firepick-delta/fpd-electronics/PCB Checklist.odt

Schematics/Electronic Selection:

- All Unused Inputs Terminated
- Race Conditions Checked
- Darlington Outputs (1.2V Low) Drive Logic Inputs
- Mating Connectors Are on Different Assemblies
- All Externally-Connected I/O Lines Filtered for RFI, Protected Against Static Discharge
- A Bypass Capacitor is Connected to Each IC
- Ratings Are All Verified
  - Voltage (Capacitors)
    - Tantalum/Electrolytic Derated if Necessary
    - Capacitors Have More than 20% Overhead
  - Power (Resistors)
    - Derated For Elevated Temperatures
  - Current
- Each IC Has a Predictable or Controlled Power-Up State
- Information on Each Sheet
  - Engineer
  - Checked By
  - Page Number
  - Schematic Number
  - Project
  - Employer
- Filters For Every Transistor Gate/Base. Even in Processors
- Are There Filters on Analog/Digital Converter Pins
- Pull-Ups, Pull-Downs on ALL Relevant Pins (Diodes, Driving Processor Inputs, Transistor Gates, etc.)
- Impedance on Every Pin Feeding Directly into a Processor From Off-Board (A Transistor, Any Object to Keep Noise From Frying an IC)
- Too Much Capacitance on Any PWR Rail?
- All Op-Amps Must Be Negative Feedback, All Comparators Positive-Feedback (Make Allowances for Exceptions)
- Op-Amp/Comparator Polarity Verification
- Capacitors or Zeners Directly on Output of Op-Amps Should Have Impedance Separating
- Are Unused Op-Amps or Comparators Tied Down Properly?
- All Octocouplers and Caps Have Parallel Diodes, For Noise Immunity
- All User-Accessible Power Rails Are Short Circuit-Protected
- Dot Each Junction
  - No Surplus Dots Where Connections Should Not Be
- Bus Common Signals
- Inputs on the Left, Outputs on the Right
- Minimum Character Numbers in All Values
- Consistent Character Size
- Printed at Readable Scale
- Reference Designators & Values Assigned to Each Componen
- PCB Parts List Information For Each Component, if Required
- Polarized Components Checked on Schematic
- Electrolyitic and Tantalum Capacitors Checked for No Reverse Voltage
- Power and GND Pins Listed for Each Component (Especially w/ Hidden PWR Pins)
- Check for Hidden PWR/GND Connections
- GND Connections Made First and Broken Last for Hot Pluggability
- Pull-Ups for All Open Collector Outputs
- Sufficient Power Rails For Analog Circuits
- “Crossover Distortion” Prevented
- Amplifiers Checked for Stability
- Oscillators Checked for Reliable Startup
- Noise Radiation Minimized
- Check Input Voltage Applied w/ Power Off
- Reset Circuit Design Reliable, Both Glitch-Free and Consistent
- Separate Analog Signals From Noisy or Digital Signals
- Check IC Datasheets for Undesired Behavior Conditions
- Determine Effects of Losing Each GND from a Connector
- Check Max. PWR Dissipation/Operating Temperatures
- Check Voltage Transients and High Voltages on FET Gates
- Check Failure Modes & Effects of Failed Semiconductors
- Estimate Worst-Case Power Supply Current
- Check Pin Numbers on ALL Parts
- ROHS Compliance Review
- Part Obsolence/End-of-Life Review
- All No-Connect Pins Labeled N/C
- Text Does Not Overlap Anything on Schematics
- Card Edge Connectors Identify Mating Part
- Off-Board Connectors Identify All Signals, Even if Not Used
- Unpopulated Parts Annotated and Enclosed by Dashed-Line Box on Schematics
- Wires Are Connected in Verified Pins
- Clock Lines w/ Series Termination and Parallel Termination Component Locations Present Even if Not Populated. 0-Ohm Resistors for Series, Unpopulated Parts for Parallel Termination
- Diagnostic Resources by Design, Even if Unpopulated by Default
- Pin Names And Attributes on Symbols w/ Multifunction Pins Match Actual Design Usage
- Connect DIP Switches and Other Grouped I/O to Ports in a Logical Way
- Verify Proper Referenced Designations
- Avoid Direct Connections of Mode Pins or No-Connects To GND or VCC to Maximize Rework Options
- Get Applications Engineers From Manufacturer to Review Schematics Involving Their Parts, if Possible
- All PWR Nets Labeled Consistently
- Create Table of Contents, Block Diagram
- Show Active-Low Pin Symbols

Layout Checklist;

- Placement:
  - Component Orientation Consistent
  - Clearance for Extraction Tools
  - Polarized Components Arranged Correctly
  - Thru-Hole Components on a 50 mil Grid (Suggested)
  - Verify All Connector Orientations
  - Minimum Component Body Spacing (Keepouts)
    - At least 15 mils between parts (Check PCBFab)
  - Bypass Caps Located Close to IC Pins
  - All Series Terminators (RS-485, etc) Located Near Source
  - I/O Drivers Located Near Where Their Signals Leave the Board
  - Include Testpoints:
    - GND Turrets
    - PWR Rail Testpoints
    - All Important Signals
    - LABEL ALL
  - EMI and RFI Filtering as Close as Possible to Exit/Entry Points in Shielded Areas
  - Layout Such That Any Rework Doesn't Require Removal of Additional Components
  - Potentiometers/Variable Components Should Increase Controlled Quantity Clockwise
  - Mounting Holes
    - Electrically Isolated or Not?
    - Proper Clearance for Hardware
  - Check Pad Shapes/Sizes
  - Check Hole Shapes/Sizes
  - Tooling Holes for Automated Assembly (Suggested)
  - Sufficient Clearance for Socketed ICs, Switches
- Routing:
  - Digital and Analog Signal Commons Joined at One Point
  - Check for Traces Running under Noisy or Sensitive Components
  - No Vias Under Poorly-Insulated Parts (Metal-Film Resistors, etc.)
  - Check for Traces Susceptible to Solder Bridging
  - Check for Dead-End Traces (Verify if Intentional)
  - Ensure Schematic Software Did Not Separate Vcc/Vdd, Vss/GND, other necessary PWR nets
  - Provide Multiple Vias for High-Current and/or Low-Impedance Traces
  - Component and Trace Keepout Areas Enforced
  - GND Planes Wherever Necessary and Possible
- Dimensions:
  - Hole Diameters on DWG Are Finished Sizes, After Plating
  - Finished Hole Diameters are Larger than Lead (>=10 mils)
  - Silkscreen Legend Text Weight (>=10 mils)
  - Pads Larger Than Finished Holes (>=15 mils)
  - Board Edge Keepout
    - Components: (>=0.2”)
    - Test Pads/Points: (>=0.2”)
    - Traces: (>=20 mils)
  - Thru-Hole Tolerance:
    - Drill Tolerance Noted
    - Soldermask Tolerance Noted
    - Route Tolerance Noted
    - Clearance Tolerance Noted
    - Silkscreen Tolerance Noted
  - Trace Width:
    - Sufficient For High Current
    - Sufficient For High Voltage
- Silkscreen:
  - No Silkscreen Over Vias (Unless Soldermasked)
  - All Legend Text Reads in One or Two Directions
  - Company Logo on Legend/In Foil
  - Copyright Notice on PCB
  - Date Code on PCB
  - PCB Part Number on PCB
  - PCB Revision Number on PCB
  - Assembly Revision Blank on Silkscreen
  - All Text Visible and Readable When PCB is Populated
  - All ICs have Pin One Clearly Marked, Visible w/ Chip Installed
  - High Pin-Count ICs and Connectors Have Corner Pins Numbered
  - Silkscreen Tick Marks for Every 5th or 10th Pin on High Pin-Count ICs and Connector

Miscellaneous:

  - CAD Design Rules Checklist Must Be Turned On
  - High Frequency Circuitry Precautions Observed
  - Extra Connectors and IC Pins Accessible on Prototype Boards, for Rework
  - Check Hole Diameters for Non-Standard Components (Rectangular Pins, Spring Pins, etc)
  - Soldermask Does or Doesn't Cover Vias
  - No Acute Inside Angles in Traces or Copper Pour
  - Soldermask Swell Checked
  - Manual Netlist Check
    - Check For 1-Pin Connections
  - Drill Origin Is a Tooling Hole
  - PCB Thickness, Cu Weight Noted
  - Thermal Reliefs For Internal Power Layers
  - Pastemask Openings are Properly Sized
  - Blind and Buried Vias Allowed on Multilayer PCB (Check PCBFab)
  - PCB Layout Panlized Correctly
  - High-Frequency Crystal Cases are Flush to PCB and GNDed

PCB Assembly Guidelines:

- Miscellaneous Parts on Bill of Materials and Assembly Notes for Same: Hardware, Heatsinks, Heatsink Compounds, IC Sockets, Consumables (Epoxy, Threadloc, Heatshrink, etc.)
- Assembly Notes For All Special Operations
- Conformal Coating
- Explicit Static Handling Precautions Required For Assembly and Test

Maintainability:

- Easy Disassembly and Reassembly
- Fuses Accessible and Labeled
- Self-Test Mode
- Spare Parts Available
- Status LEDs on PCB
- Event Logging of Exceptional Conditions
- Vibration Tolerance of Entire Assembly and Individual Modules
- Surge Current Magnitude Through Semiconductors Within Rating
- Thermal Cycling Excursions Internal to Components and Assemblies Within Acceptable Limits
- Capacitors Mounted Below or Away From Heat-Dissipating Devices Such as Transformers
- Resistance and Tolerance of Entire Product to Static Discharge Via Any Path

Electrical Safety:

- Fuse and Circuit Breaker Size and Characteristics
- Fuse Sizes Marked Near Fuse Holder
- Room to Remove Fuse Without Damaging Other Components
- Spare Fuse Storage
- Shock Hazards
- Radiated Energy Warnings and Shields
- Applicable Standards Checked
- Protection Against Liquids and Foreign Objects

Wired Assemblies:

- Wire Gauge Compatibility Check
- Cable Ties Shown Where Necessary
- Length & Color of Each Wire Indicated
- Notes of Application of Wire Terminations

Testability:

- Testpoints on PCBs For Critical Circuits, Hard to Reach Nets
- Testpads for In-Circuit or Bed-of-Nails Functional Testing
- Testpads on a Regular Grid (0.100” / 2.54mm spaced)
- Consistent Sizing:
  - Min. = (0.025” /0.635mm) ,Typ. = (0.035”/0.89mm – 0.045”/1.14mm)
  - Top Pads: Min. = (0.035”/0.89mm)
- Ensure none of the nearby components are not so tall that they interfere with probe access
- Test Procedure Written For Each Test Phase
- Special Test Arrangements and Connectors For Testing

Bill of Materials/Parts Lists:

- Each Component Has Quantity, Reference Designator, and Description
- List Qualified Part Numbers for Specialized Devices
- Suggestions for Alternate Mfrs/Part No.s Listed
- Price, Availability, and Lead Time Checked For Each Part

Mechanical Drawings:

- Standard Title Block and Border
- No Dimensions on the Material
- Every Feature Must Have X and Y Dimension (including radius, diameter, etc.)
- Every Hole Must Be Checked For Alignment w/ Mating Holes in Other Parts
- Check All Hole Diameters
- Tolerance for Sheet Metal Feature Position
- Tolerance for Sheet Metal Holes
- Material Specified
- Finish Specified
- Units Specified
- Debur/Brush Specified
- Special Operation Notes Included
- File Names, Pg. No. On Each Sheet
- CAD Layers Shown
- All Hardware Specified and Listed
- Screw Lengths Checked; Extra Thread Required
- Hole Diameters Checked for Screws & Threads
- Tapped Hole Thread Details

Software:

- Each Version Archived (Version Control)
- Loops Checked for Terminating Conditions
- Communications Timeouts Checked
- All Branches Tested
- Revision History Noted For All Changes
- CPU Utilization Measured
- Interrupt Response Time Measured
- Interrupt Execution Time Measured
- Naming Conventions Consistent and Relevant to Humans
- Adherence to Coding Style Standards
- Power-Up, Power-Down Considerations
- Unused Vectors Trapped to Restart or Damage Control Routine
- Unused ROM Space Loaded w/ Trap or Restart Instructions
- Warm and Cold Reset Differences
- Non-Volatile Memory Corruption Possibilities Checked During Power-Up, Power-Down, and Gone-Wild Conditions
- Design Notes Within or Separated from Code
- Check FIFO and Buffer Overruns
- Check Critical Timer Driver Code
- Check For Odd Address Usage on 16/32-Bit Micros, Especially an Odd Stack Pointer
- Use a LINT Utility on C Programs to Find Subtle Problems
- Program's Data Structures Contain Version Numbers

Documentation:

- End-User Instructions: Unpacking, Use, Warranty, Service, Troubleshooting Guidelines
- Service Manual: Troubleshooting Procedures, Parts Lists, Contact Info.
- Design Notes: ECNs, Reasons for Changes
- Any Information That May Be Lost if Designers Depart the Organization
