firepick-delta/fpd-electronics/EAGLE/EBR01 - TMC2130 breakout board/EBR01 Schematic.png

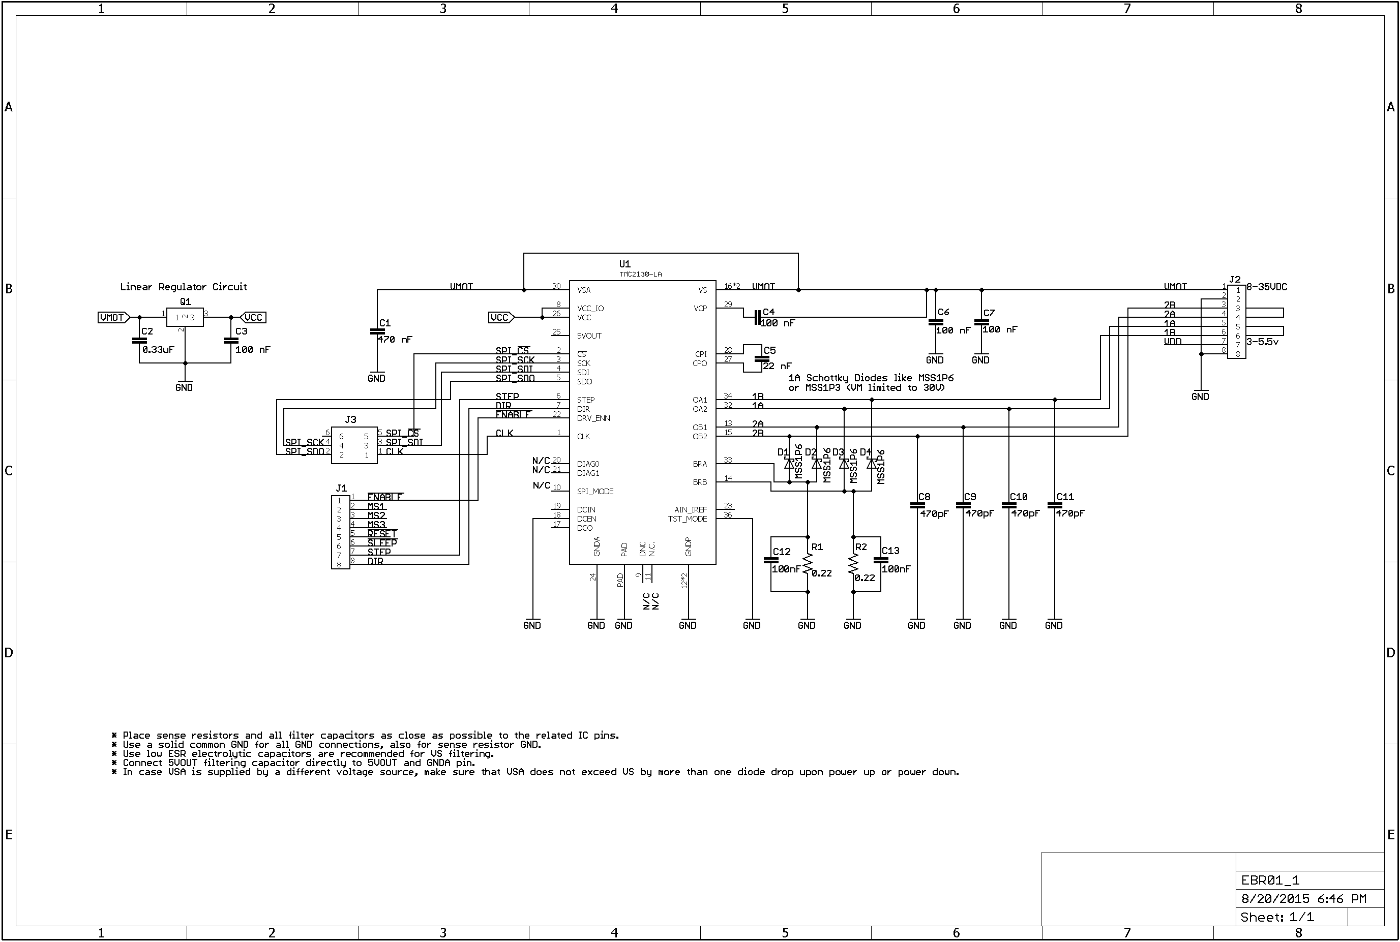
EAGLE/EBR01 - TMC2130 breakout board/EBR01 Schematic.png
