firepick-delta/fpd-electronics/EAGLE/EMC03 - Motion Control/Voltage.PNG

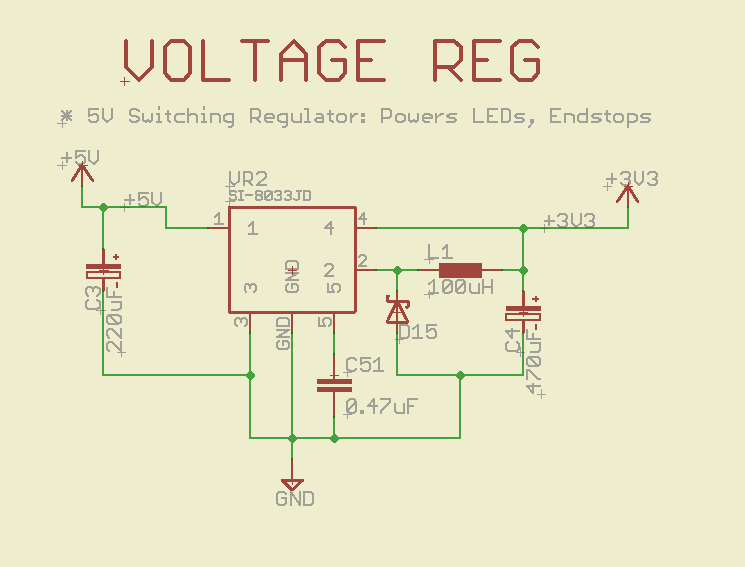
EAGLE/EMC03 - Motion Control/Voltage.PNG
