firepick-delta/fpd-electronics/EAGLE/Inventory(Electronics).xls

 |  |  | FT(CBL) | FPD QTY: | 2
Part Number | Description | STOCK: | QTY: 1 | REQUIRED: | To Order: | Vend Link: | Datasheet: | Alternates: | Notes:
ATMEGA328-AU | MCU: 32KB, 8-Bit, 32-TQFP; | 10 | 3 | 6 | 0 | Taobao (http://world.taobao.com/search/search.htm?_ksTS=1444721931015_21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) | Atmel (http://www.atmel.com/images/Atmel-8271-8-bit-AVR-Microcontroller-ATmega48A-48PA-88A-88PA-168A-168PA-328-328P_datasheet_Complete.pdf)
MSS1P6 | Diode: Schottky, 60V, 1A, MicroSMP | 76 | 12 | 24 | 0 | Taobao (http://world.taobao.com/search/search.htm?_ksTS=1444722941332_22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) | Vishay (http://www.vishay.com/docs/89018/mss1p6.pdf) |  |  | KEY:
B340A-13-F | Diode: Schottky, 40V, 3A, SMA | 0 | 2 | 4 | 4 | Taobao (http://world.taobao.com/search/search.htm?_ksTS=1444808002750_36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) | Diodes, Inc. (http://www.diodes.com/_files/datasheets/ds30891.pdf) |  |  |  | : None Req'd
1N4148WS-7-F | Diode: General Purpose, 75V, 150mA, 1.2Vr | 0 | 5 | 10 | 10 | Taobao (http://world.taobao.com/search/search.htm?_ksTS=1445316552240_21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) | Vishay (http://www.vishay.com/docs/85886/1n4148wsfl-g.pdf) |  |  |  | : <5 Req'd
KA78L05AMTF | V Reg: LDO, 5V, 0.1A, SOT89-3 | 14 | 0 | 0 | 0 | Taobao (http://world.taobao.com/search/search.htm?_ksTS=1444725181346_313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) | Fairchild (https://www.fairchildsemi.com/datasheets/KA/KA78L05A.pdf) |  |  |  | : >5 Req'd
LMS8117AMP-3.3/NOPB | V Reg: LDO, 3.3V, 1A, | 0 | 2 | 4 | 4 | Taobao (http://world.taobao.com/search/search.htm?_ksTS=1444804422496_36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) | TI (http://www.ti.com/lit/ds/symlink/lms8117a.pdf) |  |  |  | : Rev1 Changes
TC1015-3.3VCT713 | V Reg: LDO, 3.3V, 0.1A | 0 | 3 | 6 | 6 | Taobao (http://world.taobao.com/search/search.htm?_ksTS=1444804833839_36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) | Microchip (http://ww1.microchip.com/downloads/en/DeviceDoc/21335e.pdf) |  |  |  | : Rev2 Changes
DRV8825 | Motor Driver: 1/32 Step, 2.5A, 8.2-45V | 5 | 2 | 4 | 0 | Taobao (http://world.taobao.com/search/search.htm?_ksTS=1444725982952_313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) | TI (http://www.ti.com/lit/ds/symlink/drv8825.pdf)
TMC2130-LA-T | Motor Driver: 1/256 Step, 1.4A, 5.5-46V, SPI | 4 | 3 | 6 | 2 | Digi-Key (http://www.digikey.com/product-detail/en/TMC2130-LA-T/1460-1130-1-ND/5155767) | Trinamic (http://www.trinamic.com/_articles/products/integrated-circuits/tmc2130/_datasheet/TMC2130_datasheet.pdf)
1655 | Neopixel: WS2812B, w/DVR, 4SMD | 45 | 8 | 16 | 0 | Taobao (http://world.taobao.com/search/search.htm?_ksTS=1444726663615_36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) | Worldsemi (http://www.adafruit.com/datasheets/WS2812B.pdf)
SN74LVC1T45DBVR | Translator: Voltage, Bi-Directional, 5.5V Max | 30 | 0 | 0 | 0 | Taobao (http://world.taobao.com/search/search.htm?_ksTS=1444727749069_299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) | TI (http://www.mouser.com/ds/2/405/sn74lvc1t45-556134.pdf) |  | WRONG PKG
SN74LVC1T45GW,125 | Translator: Voltage, Bi-Dir., 1.2-5.5V, SOT363 | 0 | 20 | 40 | 40 | Taobao (http://world.tmall.com/item/522088454138.htm?spm=a312a.7700714.0.0.HKdb8H) | NXP (http://www.nxp.com/documents/data_sheet/74LVC_LVCH1T45.pdf)
MAX31855KASA+ | Converter: Thermocouple-Digital SPI, 8-SOIC | 0 | 1 | 2 | 2 | Taobao (http://world.taobao.com/search/search.htm?_ksTS=1444808310013_299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) | Maxim (http://datasheets.maximintegrated.com/en/ds/MAX31855.pdf)
LAN9514-JZX | IC: USB 2.0 + ETH Controller, 64-QFN | 3 | 1 | 2 | 0 | Taobao (http://world.taobao.com/search/search.htm?_ksTS=1444728585839_36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) | Microchip (http://ww1.microchip.com/downloads/en/DeviceDoc/9514.pdf)
SN74LVC1G32DBVR | Logic: OR Gate, 1-Ch., SOT23-5 | 0 | 5 | 10 | 10 | Taobao (http://world.taobao.com/search/search.htm?_ksTS=1444803375616_36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) | TI (http://www.mouser.com/ds/2/405/sn74lvc1g32-487523.pdf)
SN74LVC1G02DBVR | Logic: NOR Gate, 1-Ch, SOT23-5 | 0 | 1 | 2 | 2 | Taobao (http://world.taobao.com/search/search.htm?_ksTS=1444803477852_50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) | TI (http://www.mouser.com/ds/2/405/sn74lvc1g02-555712.pdf)
LPC1768FBD100 | MCU: 512KB, I2C, SPI, UART, USB, 100-LQFP | 0 | 1 | 2 | 2 | Taobao (http://world.taobao.com/search/search.htm?_ksTS=1444803936472_299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) | NXP (http://media.digikey.com/pdf/Data%20Sheets/NXP%20PDFs/Cortex-M3,%20LPC1700%20Series%20Leaflet.pdf)
SP3485EN-L/TR | Transceiver: RS-485, 8-SOIC | 0 | 5 | 10 | 10 | Taobao (http://world.taobao.com/search/search.htm?_ksTS=1444804158934_299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) | Exar (http://www.exar.com/common/content/document.ashx?id=639)
93LC66A-I/SN | EEPROM: 4KB, 2MHz, 8-SOIC | 0 | 1 | 2 | 2 | Taobao (http://world.taobao.com/search/search.htm?_ksTS=1444805278899_50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) | Microchip (http://ww1.microchip.com/downloads/en/DeviceDoc/21795E.pdf)
FT231XS-R | IC: USB Serial, UART, 20-SSOP | 0 | 1 | 2 | 2 | Taobao (http://world.taobao.com/search/search.htm?_ksTS=1444805461204_50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) | FTDI (http://www.ftdichip.com/Support/Documents/DataSheets/ICs/DS_FT231X.pdf)
MIC2026-1YM | IC: PWR Distribution Switch, 2-Ch, 8-SOIC | 0 | 2 | 4 | 4 | Taobao (http://world.taobao.com/search/search.htm?_ksTS=1444805622374_50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) | Micrel (http://www.micrel.com/_PDF/mic2026.pdf)
MCP4725A0T-E/CH | IC: DAC, 12-Bit, I2C | 0 | 2 | 4 | 4 | Taobao (http://world.taobao.com/search/search.htm?_ksTS=1444806080399_50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) | Microchip (http://ww1.microchip.com/downloads/en/DeviceDoc/22039d.pdf)
AP3032KTR-G1 | LED Driver: Regulator/Dimmer, 1MHz, SOT23-6 | 0 | 2 | 4 | 4 | Taobao (http://world.taobao.com/search/search.htm?_ksTS=1444806189110_36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) | Diodes, Inc. (http://www.diodes.com/_files/datasheets/AP3032.pdf)
NTR4003NT3G | MOSFET: N-Ch, 30V, 500mA, SOT23-3 | 0 | 6 | 12 | 12 | Taobao (http://world.taobao.com/search/search.htm?_ksTS=1444806380033_50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) | ON Semi (http://www.onsemi.com/pub_link/Collateral/NTR4003N-D.PDF)
BSS138-7-F | MOSFET: N-Ch, 50V, 220mA, SOT23-3 | 0 | 1 | 2 | 2 | Taobao (http://world.taobao.com/search/search.htm?_ksTS=1444806741942_36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) | Diodes, Inc. (http://www.diodes.com/_files/datasheets/ds30144.pdf) |  | SAME AS NTR4?
ZXMN10A07FTA | MOSFET: N-Ch, 100V, 700mA, SOT23-3 | 0 | 1 | 2 | 2 | Taobao (http://world.taobao.com/search/search.htm?_ksTS=1445244763364_36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) | Diodes, Inc. (http://www.diodes.com/_files/datasheets/ZXMN10A07F.pdf)
MPXV5100DP | Sensor: Pressure, 14.5PSI(Typ.), 5V, 8-SMD | 0 | 1 | 2 | 2 | Taobao (http://world.taobao.com/search/search.htm?_ksTS=1444807021641_36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) | Freescale (http://www.freescale.com/files/sensors/doc/data_sheet/MPX5100.pdf)
TCST1030 | Sensor: Optical, 3.1MM(slot), Thru, Trans. | 0 | 1 | 2 | 2 | Taobao (http://world.taobao.com/search/search.htm?_ksTS=1444807247184_50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) | Vishay (http://www.vishay.com/docs/83763/tcst1030.pdf)
147873-2 | Switch: Push-Button, Mom., NO, 0.05A, SPST | 0 | 3 | 6 | 6 | Taobao (http://world.taobao.com/search/search.htm?_ksTS=1444805046637_36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) | TE (http://www.mouser.com/ds/2/418/NG_CD_147873_K3-656557.pdf) |  | AKA: TYCO
SML-D12M8WT86 | LED: YW/GN, Diffused, 2.2V, 20mA, 0603 | 0 | 12 | 24 | 24 | Taobao (http://world.taobao.com/search/search.htm?_ksTS=1444807523386_50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) | Rohm Semi (http://rohmfs.rohm.com/en/products/databook/datasheet/opto/led/chip_mono/sml-d1.pdf)
SML-D12U8WT86 | LED: RD, Diffused, 2.2V, 20mA, 0603 | 0 | 9 | 18 | 18 | Taobao (http://world.taobao.com/search/search.htm?_ksTS=1444807804141_50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) | Rohm Semi (http://rohmfs.rohm.com/en/products/databook/datasheet/opto/led/chip_mono/sml-d1.pdf) |  | QTY CHANGED (+3)
QBLP650-IW | LED: WHT, Clear, 3.3V, 20mA, 1206 | 0 | 32 | 64 | 64 | Taobao (http://world.taobao.com/search/search.htm?_ksTS=1444992737849_321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) | QTB (http://www.qt-brightek.com/datasheet/QBLP650_series.pdf)
HCM4912000000ABJT | Crystal: Oscillator, 12MHz, 18pF, HC-49/US | 0 | 1 | 2 | 2 | Taobao (http://world.taobao.com/search/search.htm?_ksTS=1444808547826_36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) | Citizen FD (http://cfm.citizen.co.jp/english/product/pdf/HCM49.pdf)
HCM4925000000ABJT | Crystal: Oscillator, 25MHz, 18pF, HC-49/US | 0 | 1 | 2 | 2 | Taobao (http://world.taobao.com/search/search.htm?_ksTS=1444809148388_36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) | Citizen FD (http://cfm.citizen.co.jp/english/product/pdf/HCM49.pdf)
HCM4916000000ABJT | Crystal: Oscillator, 16MHz, 18pF, HC-49/US | 0 | 3 | 6 | 6 | Taobao (http://world.taobao.com/search/search.htm?_ksTS=1444809458358_36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) | Citizen FD (http://cfm.citizen.co.jp/english/product/pdf/HCM49.pdf)
BLM18AG121SN1D | Ferrite Bead: Filter, 120 Ohm, 0603 | 0 | 4 | 8 | 8 | Taobao (http://world.taobao.com/search/search.htm?_ksTS=1444809572957_50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) | MuRata (http://search.murata.co.jp/Ceramy/image/img/PDF/ENG/L0110S0100BLM18A.pdf)
BRL1608T6R8M | Inductor: 6.8uH, 20%, 0603 | 0 | 2 | 4 | 4 | Taobao (http://world.taobao.com/search/search.htm?_ksTS=1444809879149_36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) | Taiyo Yuden (http://www.mouser.com/ds/2/396/wound07_e-587790.pdf)
CL10B104KO8NNNC | Capacitor: 0.1uF, 16V, X5R, 10%, 0603 | 171 | 60 | 120 | 0 | Taobao (http://world.taobao.com/search/search.htm?_ksTS=1444729067138_50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) | Samsung (http://www.samsungsem.com/kr/support/product-search/mlcc/__icsFiles/afieldfile/2015/06/15/CL10B104KO8NNNC.pdf)
GMK107BJ104KAHT | Capacitor: 0.1uF, 35V, X5R, 10%, 0603 | 201 | 0 | 0 | 0 | Taobao (http://world.taobao.com/search/search.htm?_ksTS=1444729268721_50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) | Taiyo Yuden (http://www.mouser.com/ds/2/396/mlcc11_hq_e-541564.pdf)
C1608X7R1H334K080AC | Capacitor: 0.33uF, 50V, X7R, 10%, 0603 | 193 | 0 | 0 | 0 | Taobao (http://world.taobao.com/search/search.htm?_ksTS=1444729747617_50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) | TDK (http://product.tdk.com/en/catalog/datasheets/mlcc_commercial_general_en.pdf)
GRM188R72A471KA01D | Capacitor: 470pF, 100V, X7R, 10%, 0603 | 387 | 13 | 26 | 0 | Taobao (http://world.taobao.com/search/search.htm?_ksTS=1444731019028_36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) | MuRata (http://www.murata.com/~/media/webrenewal/support/library/catalog/products/capacitor/mlcc/c02e.ashx)
GRM188R72A223KAC4D | Capacitor: 0.022uF, 100V, X7R, 10%, 0603 | 106 | 3 | 6 | 0 | Taobao (http://world.taobao.com/search/search.htm?_ksTS=1444731141971_313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) | MuRata (http://www.murata.com/~/media/webrenewal/support/library/catalog/products/capacitor/mlcc/c02e.ashx)
UMK107B7104KA-T | Capacitor: 0.1uF, 50V, X7R, 10%, 0603 | 105 | 20 | 40 | 0 | Taobao (http://world.taobao.com/search/search.htm?_ksTS=1444731866025_313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) | Taiyo Yuden (http://www.mouser.com/ds/2/396/mlcc_all_e-541559.pdf)
UMK107B7474KA-TR | Capacitor: 0.47uF, 50V, X7R, 10%, 0603 | 97 | 3 | 6 | 0 | Taobao (http://world.taobao.com/search/search.htm?_ksTS=1444732671429_313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) | Taiyo Yuden (http://www.mouser.com/ds/2/396/mlcc_all_e-541559.pdf)
GRM188C81E475KE11D | Capacitor: 4.7uF, 25V, 10%, X6S, 0603 | 0 | 8 | 16 | 16 | Taobao (http://world.taobao.com/search/search.htm?_ksTS=1444823017997_36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) | MuRata (http://www.murata.com/~/media/webrenewal/support/library/catalog/products/capacitor/mlcc/c02e.ashx)
GRM188R71H103KA01D | Capacitor: 10nF, 50V, 10%, X7R, 0603 | 0 | 8 | 16 | 16 | Taobao (http://world.taobao.com/search/search.htm?_ksTS=1444823277219_36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) | MuRata (http://www.murata.com/~/media/webrenewal/support/library/catalog/products/capacitor/mlcc/c02e.ashx) | [HAX] | VOLTAGE UNKNOWN
GRM1885C1H120FA01J | Capacitor: 12pF, 50V, 1%, C0G | 0 | 8 | 16 | 16 | Taobao (http://world.taobao.com/search/search.htm?_ksTS=1444825517597_36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) | MuRata (http://www.murata.com/~/media/webrenewal/support/library/catalog/products/capacitor/mlcc/c02e.ashx) | [HAX] | VOLTAGE UNKNOWN
UMK107AB7105KA-T | Capacitor: 1uF, 50V, 10%, 0603 | 0 | 10 | 20 | 20 | Taobao (http://world.taobao.com/search/search.htm?_ksTS=1444824414545_36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) | Taiyo Yuden (http://www.mouser.com/ds/2/396/mlcc11_hq_e-541564.pdf)
GCM1885C1H180JA16D | Capacitor: 18pF, 50V, 5%, C0G, 0603 | 0 | 4 | 8 | 8 | Taobao (http://world.taobao.com/search/search.htm?_ksTS=1444824552591_50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) | MuRata (http://www.murata.com/~/media/webrenewal/support/library/catalog/products/capacitor/mlcc/c03e.ashx)
C0603C330K5GACTU | Capacitor: 33pF, 50V, C0G, 10%, 0603 | 0 | 2 | 4 | 4 | Taobao (http://world.taobao.com/search/search.htm?_ksTS=1444824683265_299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) | Kemet (http://www.kemet.com/Lists/ProductCatalog/Attachments/46/KEM_C1003_C0G_SMD.pdf) | [HAX] | VOLTAGE UNKNOWN
GRM188R61C106MA73D | Capacitor: 10uF, 16V, 20%, 0603 | 0 | 2 | 4 | 4 | Taobao (http://world.taobao.com/search/search.htm?_ksTS=1444825608952_313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) | MuRata (http://www.murata.com/~/media/webrenewal/support/library/catalog/products/capacitor/mlcc/c02e.ashx)
EMVH350ADA100MF60G | Capacitor: Al-Elec., 10uF, 35V, 20%, 6.3mm | 0 | 6 | 12 | 12 | Taobao (http://world.taobao.com/search/search.htm?_ksTS=1444823806389_36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) | Chemi-Con (http://www.chemi-con.com/upload/files/9/3/45226975052d6c71e04ba0.pdf)
EEE-FTH101XAP | Capacitor: Al-Elec., 100uF, 50V, 20%, 6.3mm | 0 | 0 | 0 | 0 | Taobao (http://world.taobao.com/search/search.htm?_ksTS=1444823909666_36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) | Chemi-Con (http://industrial.panasonic.com/lecs/www-data/pdf/ABA0000/ABA0000CE135.pdf)
EMVA500ADA101MHA0G | Capacitor: Al-Elec., 100uF, 50V, 20%, 8mm | 0 | 6 | 12 | 12 | Taobao (http://world.taobao.com/search/search.htm?_ksTS=1444825777513_313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) | Chemi-Con (http://www.mouser.com/ds/2/420/-552881.pdf)
TC33X-2-103E | Potentiometer: Trim, 10kOhm, 0.1W, 25%, SMT | 0 | 0 | 0 | 0 | Taobao (http://world.taobao.com/search/search.htm?_ksTS=1444810521186_36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) | Bourns (http://www.bourns.com/docs/Product-Datasheets/TC33.pdf)
#UNKNOWN! | Resistor: 220 Ohm, C-Sense, 0.5W, 1%, 1206 | 94 | 0 | 0 | 0 |  |  |  | P/N Unknown
RCWE1206R220FKEA | Resistor: 0.22 Ohm, C-Sense, 0.5W, 1%, 1206 | 0 | 10 | 20 | 20 | Taobao (http://world.taobao.com/search/search.htm?_ksTS=1444733297687_36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) | Vishay (http://www.vishay.com/docs/20019/rcwe.pdf)
RC0603FR-071KL | Resistor: 1 kOhm, 0.1W, 1%, 0603 | 0 | 18 | 36 | 36 | Taobao (http://world.taobao.com/search/search.htm?_ksTS=1444812698798_21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) | Yageo (http://www.yageo.com/NewPortal/yageodocoutput?fileName=/pdf/R-Chip/PYu-RC_Group_51_RoHS_L_3.pdf) | [HAX] | QTY CHANGED (+3)
RC0603FR-071ML | Resistor: 1 Mohm, 0.1W, 5%, 0603 | 0 | 5 | 10 | 10 | Taobao (http://world.taobao.com/search/search.htm?_ksTS=1444812775976_299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) | Yageo (http://www.yageo.com/NewPortal/yageodocoutput?fileName=/pdf/R-Chip/PYu-RC_Group_51_RoHS_L_3.pdf) | [HAX]
RC0603FR-072R2L | Resistor: 2.2 Ohm, 0.1W, 1%, 0603 | 0 | 3 | 6 | 6 | Taobao (http://world.taobao.com/search/search.htm?_ksTS=1444813257640_50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) | Yageo (http://www.yageo.com/NewPortal/yageodocoutput?fileName=/pdf/R-Chip/PYu-RC_Group_51_RoHS_L_3.pdf) | [HAX]
RC0603FR-0710KL | Resistor: 10 kOhm, 0.1W, 1%, 0603 | 0 | 14 | 28 | 28 | Taobao (http://world.taobao.com/search/search.htm?_ksTS=1444813360151_50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) | Yageo (http://www.yageo.com/NewPortal/yageodocoutput?fileName=/pdf/R-Chip/PYu-RC_Group_51_RoHS_L_3.pdf) | [HAX]
RC0603FR-0720KL | Resistor: 20 kOhm, 0.1W, 1%, 0603 | 0 | 3 | 6 | 6 | Taobao (http://world.taobao.com/search/search.htm?_ksTS=1444813511692_36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) | Yageo (http://www.yageo.com/NewPortal/yageodocoutput?fileName=/pdf/R-Chip/PYu-RC_Group_51_RoHS_L_3.pdf) | [HAX]
RC0603FR-07120RL | Resistor: 120 Ohm, 0.1W, 1%, 0603 | 0 | 6 | 12 | 12 | Taobao (http://world.taobao.com/search/search.htm?_ksTS=1444813924928_50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) | Yageo (http://www.yageo.com/NewPortal/yageodocoutput?fileName=/pdf/R-Chip/PYu-RC_Group_51_RoHS_L_3.pdf) | [HAX]
RC0603FR-07470RL | Resistor: 470 Ohm, 0.1W, 1%, 0603 | 0 | 5 | 10 | 10 | Taobao (http://world.taobao.com/search/search.htm?_ksTS=1444814486277_321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) | Yageo (http://www.yageo.com/NewPortal/yageodocoutput?fileName=/pdf/R-Chip/PYu-RC_Group_51_RoHS_L_3.pdf) | [HAX]
RL0603JR-070R1L | Resistor: 0.1 Ohm, 0.1W, 5%, 0603 (C-Sense) | 0 | 2 | 4 | 4 | Taobao (http://world.taobao.com/search/search.htm?_ksTS=1444814445744_36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) | Yageo (http://www.yageo.com/NewPortal/yageodocoutput?fileName=/pdf/R-Chip/PYu-RC_Group_51_RoHS_L_3.pdf)
RC0603FR-074K7L | Resistor: 4.7 kOhm, 0.1W 1%, 0603 | 0 | 1 | 2 | 2 | Taobao (http://world.taobao.com/search/search.htm?_ksTS=1444814632794_50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) | Yageo (http://www.yageo.com/NewPortal/yageodocoutput?fileName=/pdf/R-Chip/PYu-RC_Group_51_RoHS_L_3.pdf) | [HAX]
RC0603FR-0712K4L | Resistor: 12.4 kOhm, 0.1W, 1%, 0603 | 0 | 1 | 2 | 2 | Taobao (http://world.taobao.com/search/search.htm?_ksTS=1444814711558_313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) | Yageo (http://www.yageo.com/NewPortal/yageodocoutput?fileName=/pdf/R-Chip/PYu-RC_Group_51_RoHS_L_3.pdf)
RC0603FR-0712KL | Resistor: 12 kOhm, 0.1W, 1%, 0603 | 0 | 1 | 2 | 2 | Taobao (http://world.taobao.com/search/search.htm?_ksTS=1444814849008_313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) | Yageo (http://www.yageo.com/NewPortal/yageodocoutput?fileName=/pdf/R-Chip/PYu-RC_Group_51_RoHS_L_3.pdf)
RC0603FR-0749R9L | Resistor: 49.9 Ohm, 0.1W, 1%, 0603 | 0 | 4 | 8 | 8 | Taobao (http://world.taobao.com/search/search.htm?_ksTS=1444814924355_321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) | Yageo (http://www.yageo.com/NewPortal/yageodocoutput?fileName=/pdf/R-Chip/PYu-RC_Group_51_RoHS_L_3.pdf)
RC0603FR-07270RL | Resistor: 270 Ohm, 0.1W, 1%, 0603 | 0 | 2 | 4 | 4 | Taobao (http://world.taobao.com/search/search.htm?_ksTS=1444815310081_36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) | Yageo (http://www.yageo.com/NewPortal/yageodocoutput?fileName=/pdf/R-Chip/PYu-RC_Group_51_RoHS_L_3.pdf) | [HAX]
RC0603FR-07330RL | Resistor: 330 Ohm, 0.1W, 1%, 0603 | 0 | 3 | 6 | 6 | Taobao (http://world.taobao.com/search/search.htm?_ksTS=1444815363469_36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) | Yageo (http://www.yageo.com/NewPortal/yageodocoutput?fileName=/pdf/R-Chip/PYu-RC_Group_51_RoHS_L_3.pdf) | [HAX]
RC0603FR-07511RL | Resistor: 511 Ohm, 0.1W, 1%, 0603 | 0 | 4 | 8 | 8 | Taobao (http://world.taobao.com/search/search.htm?_ksTS=1444815382695_313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) | Yageo (http://www.yageo.com/NewPortal/yageodocoutput?fileName=/pdf/R-Chip/PYu-RC_Group_51_RoHS_L_3.pdf) | [HAX] | HAX HAS 510R
RC0603FR-07825RL | Resistor: 825 Ohm, 0.1W, 1%, 0603 | 0 | 1 | 2 | 2 | Taobao (http://world.taobao.com/search/search.htm?_ksTS=1444815400326_313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) | Yageo (http://www.yageo.com/NewPortal/yageodocoutput?fileName=/pdf/R-Chip/PYu-RC_Group_51_RoHS_L_3.pdf) |  | HAX HAS 820R
RC0603FJR-070RL | Resistor: 0.0 Ohm, 0.1W, 1%, 0603 | 0 | 15 | 30 | 30 | Taobao (http://world.taobao.com/search/search.htm?_ksTS=1444815445262_313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) | Yageo (http://www.yageo.com/NewPortal/yageodocoutput?fileName=/pdf/R-Chip/PYu-RC_Group_51_RoHS_L_3.pdf)
RC0603FR-074K99L | Resistor: 4.99 kOhm, 0.1W, 1%, 0603 | 0 | 3 | 6 | 6 | Taobao (http://world.taobao.com/search/search.htm?_ksTS=1444815445262_313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) | Yageo (http://www.yageo.com/NewPortal/yageodocoutput?fileName=/pdf/R-Chip/PYu-RC_Group_51_RoHS_L_3.pdf) | [HAX]
RC0603FR-0710RL | Resistor: 10 Ohm, 0.1W, 1%, 0603 | 0 | 2 | 4 | 4 | Taobao (http://world.taobao.com/search/search.htm?_ksTS=1444822242201_36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) | Yageo (http://www.yageo.com/NewPortal/yageodocoutput?fileName=/pdf/R-Chip/PYu-RC_Group_51_RoHS_L_3.pdf) | [HAX]
RC0603FR-0722KL | Resistor: 22 kOhm, 0.1W, 1%, 0603 | 0 | 2 | 4 | 4 | Taobao (http://world.taobao.com/search/search.htm?_ksTS=1444822483742_36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) | Yageo (http://www.yageo.com/NewPortal/yageodocoutput?fileName=/pdf/R-Chip/PYu-RC_Group_51_RoHS_L_3.pdf) | [HAX]
RC0603FR-0790K9L | Resistor: 90.9 kOhm, 0.1W, 1%, 0603 | 0 | 2 | 4 | 4 | Taobao (http://world.taobao.com/search/search.htm?_ksTS=1444822633378_36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) | Yageo (http://www.yageo.com/NewPortal/yageodocoutput?fileName=/pdf/R-Chip/PYu-RC_Group_51_RoHS_L_3.pdf) | [HAX]
S2B-PH-SM4-TB(LF)(SN) | Connector: 2.0mm, SMT, R/A, 2-POS(M) | 20 | 1 | 2 | 0 | Taobao (http://world.taobao.com/search/search.htm?_ksTS=1444789164960_36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) | JST (http://www.jst-mfg.com/product/pdf/eng/ePH.pdf)
S3B-PH-SM4-TB(LF)(SN) | Connector: 2.0mm, SMT, R/A, 3-POS(M) | 20 | 1 | 2 | 0 | Taobao (http://world.taobao.com/search/search.htm?_ksTS=1444789278264_36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) | JST (http://www.jst-mfg.com/product/pdf/eng/ePH.pdf)
S4B-PH-SM4-TB(LF)(SN) | Connector: 2.0mm, SMT, R/A, 4-POS(M) | 20 | 6 | 12 | 0 | Taobao (http://world.taobao.com/search/search.htm?_ksTS=1444789323532_313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) | JST (http://www.jst-mfg.com/product/pdf/eng/ePH.pdf)
S5B-PH-SM4-TB(LF)(SN) | Connector: 2.0mm, SMT, R/A, 5-POS(M) | 20 | 3 | 6 | 0 | Taobao (http://world.taobao.com/search/search.htm?_ksTS=1444789426692_36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) | JST (http://www.jst-mfg.com/product/pdf/eng/ePH.pdf)
S6B-PH-SM4-TB(LF)(SN) | Connector: 2.0mm, SMT, R/A, 6-POS(M) | 20 | 5 | 10 | 0 | Taobao (http://world.taobao.com/search/search.htm?_ksTS=1444789481172_50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) | JST (http://www.jst-mfg.com/product/pdf/eng/ePH.pdf)
S8B-PH-SM4-TB(LF)(SN) | Connector: 2.0mm, SMT, R/A, 8-POS(M) | 20 | 2 | 4 | 0 | Taobao (http://world.taobao.com/search/search.htm?_ksTS=1444789547599_313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) | JST (http://www.jst-mfg.com/product/pdf/eng/ePH.pdf)
PHR-2 | Connector: 2.0mm, 2-POS(F), NO CONTACT | 52 | 2 | 4 | 0 | Taobao (http://world.taobao.com/search/search.htm?_ksTS=1444789932036_313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) | JST (http://www.jst-mfg.com/product/pdf/eng/ePH.pdf)
PHR-3 | Connector: 2.0mm, 3-POS(F), NO CONTACT | 52 | 3 | 6 | 0 | Taobao (http://world.taobao.com/search/search.htm?_ksTS=1444790323818_36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) | JST (http://www.jst-mfg.com/product/pdf/eng/ePH.pdf)
PHR-4 | Connector: 2.0mm, 4-POS(F), NO CONTACT | 52 | 9 | 18 | 0 | Taobao (http://world.taobao.com/search/search.htm?_ksTS=1444790441501_36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) | JST (http://www.jst-mfg.com/product/pdf/eng/ePH.pdf)
PHR-5 | Connector: 2.0mm, 5-POS(F), NO CONTACT | 52 | 4 | 8 | 0 | Taobao (http://world.taobao.com/search/search.htm?_ksTS=1444790573708_36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) | JST (http://www.jst-mfg.com/product/pdf/eng/ePH.pdf)
PHR-6 | Connector: 2.0mm, 6-POS(F), NO CONTACT | 52 | 3 | 6 | 0 | Taobao (http://world.taobao.com/search/search.htm?_ksTS=1444790623418_36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) | JST (http://www.jst-mfg.com/product/pdf/eng/ePH.pdf)
PHR-7 | Connector: 2.0mm, 7-POS(F), NO CONTACT | 0 | 2 | 4 | 4 | Taobao (http://world.taobao.com/search/search.htm?_ksTS=1444965055945_21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) | JST (http://www.jst-mfg.com/product/pdf/eng/ePH.pdf)
PHR-8 | Connector: 2.0mm, 8-POS(F), NO CONTACT | 52 | 6 | 12 | 0 | Taobao (http://world.taobao.com/search/search.htm?_ksTS=1444790663269_313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) | JST (http://www.jst-mfg.com/product/pdf/eng/ePH.pdf)
SPH-002T-P0.5L | Contacts: Crimp, 24-28AWG, SKT, SN | 0 | 156 | 312 | 312 | Taobao (http://world.taobao.com/search/search.htm?_ksTS=1445231840965_307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) | JST (http://www.jst-mfg.com/product/pdf/eng/ePH.pdf)
DF40C(2.0)-70DS-0.4V(51) | Connector: 0.4mm, 70-POS(M), 2.0mm Length | 4 | 0 | 0 | 0 | Taobao (http://world.taobao.com/search/search.htm?_ksTS=1444792183801_50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) | Hirose (http://www.hirose.co.jp/cataloge_hp/ed_DF40_20140305.pdf)
DF40HC(3.0)-70DS-0.4V(51) | Connector: 0.4mm, 70-POS(M), 3.0mm Length | 5 | 1 | 2 | 0 | Taobao (http://world.taobao.com/search/search.htm?_ksTS=1444792215053_299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) | Hirose (http://www.hirose.co.jp/cataloge_hp/ed_DF40_20140305.pdf)
B2B-PH-SM4-TB(LF)(SN) | Connector: 2.0mm, SMT, VRT, 2-POS(M) | 0 | 1 | 2 | 2 | Taobao (http://world.taobao.com/search/search.htm?_ksTS=1444793080125_36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) | JST (http://www.jst-mfg.com/product/pdf/eng/ePH.pdf)
B4B-PH-SM4-TB(LF)(SN) | Connector: 2.0mm, SMT, VRT, 4-POS(M) | 0 | 1 | 2 | 2 | Taobao (http://world.taobao.com/search/search.htm?_ksTS=1444793125069_36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) | JST (http://www.jst-mfg.com/product/pdf/eng/ePH.pdf)
B5B-PH-SM4-TB(LF)(SN) | Connector: 2.0mm, SMT, VRT, 5-POS(M) | 0 | 2 | 4 | 4 | Taobao (http://world.taobao.com/search/search.htm?_ksTS=1444793199454_307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) | JST (http://www.jst-mfg.com/product/pdf/eng/ePH.pdf)
B6B-PH-SM4-TB(LF)(SN) | Connector: 2.0mm, SMT, VRT, 6-POS(M) | 0 | 1 | 2 | 2 | Taobao (http://world.taobao.com/search/search.htm?_ksTS=1444793228659_299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) | JST (http://www.jst-mfg.com/product/pdf/eng/ePH.pdf)
B7B-PH-SM4-TB(LF)(SN) | Connector: 2.0mm, SMT, VRT, 7-POS(M) | 0 | 2 | 4 | 4 | Taobao (http://world.taobao.com/search/search.htm?_ksTS=1444965159695_21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) | JST (http://www.jst-mfg.com/product/pdf/eng/ePH.pdf)
B8B-PH-SM4-TB(LF)(SN) | Connector: 2.0mm, SMT, VRT, 8-POS(M) | 0 | 4 | 8 | 8 | Taobao (http://world.taobao.com/search/search.htm?_ksTS=1444793328227_50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) | JST (http://www.jst-mfg.com/product/pdf/eng/ePH.pdf)
B4B-PH-K-S(LF)(SN) | Connector: 2.0mm, THRU, VRT, 4-POS(M) | 0 | 1 | 2 | 2 | Taobao (http://world.taobao.com/search/search.htm?_ksTS=1444907036091_21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) | JST (http://www.jst-mfg.com/product/pdf/eng/ePH.pdf)
FTSH-105-01-L-DV | Connector: 0.5IN, SMT, VRT, 10-POS(M) | 0 | 1 | 2 | 2 | Taobao (http://world.taobao.com/search/search.htm?_ksTS=1444796791942_36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) | Samtec (http://suddendocs.samtec.com/catalog_english/ftsh_smt.pdf) |  | UNSHROUDED
67996-206HLF | Connector: 0.1IN, THRU, VRT, 2X3-POS(M) | 0 | 4 | 8 | 8 | Taobao (http://world.taobao.com/search/search.htm?_ksTS=1444797080790_36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) | FCI (http://portal.fciconnect.com/Comergent//fci/drawing/67996.pdf)
TSW-117-07-T-D | Connector: 0.1IN, THRU, VRT, 34-POS(M) | 0 | 1 | 2 | 2 | Taobao (http://world.taobao.com/search/search.htm?_ksTS=1444800352121_36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) | Samtec (http://suddendocs.samtec.com/catalog_english/tsw_th.pdf) |  | REPLACE
68000-102HLF | Connector: 0.1IN, THRU, VRT, 2-POS(M) | 0 | 1 | 2 | 2 | Taobao (http://world.taobao.com/search/search.htm?_ksTS=1444802645756_313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) | FCI (http://portal.fciconnect.com/Comergent//fci/drawing/68000.pdf)
65039-035LF | Connector: 0.1IN, CBL, 2-POS(F) | 0 | 1 | 2 | 2 | Taobao | FCI
48051-000LF | Contacts: Crimp, 22-26AWG, SKT, SN | 0 | 4 | 8 | 8 | Taobao | FCI |  | REPLACE W GOLD?
HR911105A | Connector: ETH, MagJack, RJ-45, LED+SHLD | 0 | 1 | 2 | 2 | Taobao (http://world.taobao.com/search/search.htm?_ksTS=1444801730605_50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) | HanRun (http://www.kosmodrom.com.ua/pdf/HR911105A.pdf) | MJF13T3L-KF06B3YG | HARD TO FIND
1734085-1 | Connector: USB-A 2.0, Thru-Hole, VRT | 0 | 1 | 2 | 2 | Taobao (http://world.taobao.com/search/search.htm?_ksTS=1444802189367_50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) | TE Connect (http://www.mouser.com/ds/2/418/NG_CD_1734085_D2-658364.pdf) |  | AKA: TYCO
1734517-1 | Connector: USB-B, 2.0, SMT, VRT | 0 | 1 | 2 | 2 | Taobao (http://world.taobao.com/search/search.htm?_ksTS=1444802366959_36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) | TE Connect (http://www.mouser.com/ds/2/418/NG_CD_1734517_B-658680.pdf)
22232031 | Connector: 0.1IN, THRU, VRT, 3-POS(M), KEY | 0 | 3 | 6 | 6 | Taobao (http://world.taobao.com/search/search.htm?_ksTS=1444802524275_50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) | Molex (http://www.molex.com/pdm_docs/sd/022232031_sd.pdf)
OSTTH030160 | T-Block: 5.0mm, THRU, R/A, 14-22AWG, 3-POS | 0 | 2 | 4 | 4 | Taobao (http://world.taobao.com/search/search.htm?_ksTS=1444802814346_50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) | On Shore (http://world.taobao.com/search/search.htm?_ksTS=1444802814346_50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)
OSTTH020160 | T-Block: 5.0mm, THRU, R/A, 14-22AWG, 2-POS | 0 | 1 | 2 | 2 | Taobao (http://world.taobao.com/search/search.htm?_ksTS=1444802977439_50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) | On Shore (http://www.on-shore.com/sites/default/files/manuals/ostthxx0160.pdf)
EDSTL130/02 | Header: T-Block, 5MM, 2-Pos | 0 | 1 | 2 | 2 | Taobao (http://world.taobao.com/search/search.htm?_ksTS=1445339961741_21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) | On Shore (http://www.on-shore.com/sites/default/files/manuals/edstl130.pdf) |  | Rev1 Also
EDSTL130/03 | Header: T-Block, 5MM, 2-Pos | 0 | 2 | 4 | 4 | ` | On Shore (http://www.on-shore.com/sites/default/files/manuals/edstl130.pdf) |  | Rev1 Also
ANY | Cable: CAT6, Shielded, Stranded, BLK | 0 | 10 | 20 | 20 | Taobao (http://world.taobao.com/search/search.htm?_ksTS=1445232661845_36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) | ANY |  | VERIFY STRANDED
ANY | Cable: 24AWG, BLK | 0 | 10 | 20 | 20 | Taobao (http://world.taobao.com/search/search.htm?_ksTS=1445232771653_307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) | ANY | [HAX]
ANY | Cable: 8-Conductor, 24AWG, BLK | 0 | 10 | 20 | 20 | Taobao (http://world.taobao.com/search/search.htm?_ksTS=1445232853020_36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) | ANY |  | SEARCH: 8 CONDUCTOR CABLE, BLACK, 24AWG
ANY | Cable: USB, BLK | 0 | 5 | 10 | 10 | Taobao (http://world.taobao.com/search/search.htm?_ksTS=1445233200442_50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) | ANY |  | SEARCH: USB EXTENSION CABLE
CB-PWM-YS | Cable: Y-Splitter, PWM, Fan 3-Pin | 0 | 3 | 6 | 6 | Taobao |  |  | CAN SOLDER, WITH CORRECT CONNECTORS (KK, 3-PIN, MOLEX)
