firepick-delta/fpd-electronics/EAGLE/Cable Assembly BOM.xls

Part No. | Description: | Qty: | Notes:
W101-W102, W121 | Cable Assy.: Modular Tool (w/ USB), 22-24AWG, F-F, 36IN | 3
CAT6 | Cable: Multi-Conductor, 8-Cond (4-pair), CAT6, Shielded, Stranded | AR
PHR-8 | Connector: 2.0mm, CBL, VRT, Female, 8-POS | 2
SPH-002T-P0.5L | Contacts: Sockets, 28-24, SN | 16
W103 | Cable Assy.: Modular Tool, 22-24AWG, F-F, 36IN | 1
CAT6 | Cable: Multi-Conductor, 8-Cond (4-pair), CAT6, Shielded, Stranded | AR
PHR-6 | Connector: 2.0mm, CBL, VRT, Female, 6-POS | 2
SPH-002T-P0.5L | Contacts: Sockets, 28-24, SN | 12
W104-W108 | Cable Assy.: Stepper Motors, 26AWG, F (1-Sided), 12IN | 5
17HM5417 | Stepper Motor: Bare Leads, 26AWG | 1
PHR-4 | Connector: 2.0mm, CBL, VRT, Female, 4-POS | 1
SPH-002T-P0.5L | Contacts: Sockets, 28-24, SN | 4
W109-W111 | Cable Assy.: Cooling Fan Y-Cables, 26AWG M-F(2), 12IN | 3
CB-PWM-YS | Cable Assy.: PWM Cable (Y-Split), M-F(2), 12” | 1 | CUT AR?
W112-W113 | Cable Assy.: USB Cameras, 26AWG, F-F 12IN | 2
ANY | Cable: USB, Cut to Length | AR
PHR-4 | Connector: 2.0mm, CBL, VRT, Female, 4-POS | 2
SPH-002T-P0.5L | Contacts: Sockets, 28-24, SN | 8
W114 | Cable Assy.: Ringlight(Downward), 24AWG, F (1-Sided), 12IN | 1
ANY | Cable: 24/26AWG Wire | AR | SHIELD?
PHR-2 | Connector: 2.0mm, CBL, VRT, Female, 2-POS | 1
SPH-002T-P0.5L | Contacts: Sockets, 28-24, SN | 2
W115 | Cable Assy.: Ringlight(Up-Looking), 24AWG, F-F, 12IN | 1
ANY | Cable: 24/26AWG Wire | AR
PHR-2 | Connector: 2.0mm, CBL, VRT, Female, 5-POS | 2
SPH-002T-P0.5L | Contacts: Sockets, 28-24, SN | 10
W116 | Cable Assy.: Solenoid PCB Interconnect, 24AWG, F-F, 12IN | 1
ANY | Cable: (7- or 8-conductor), 24AWG , BLK | AR | Search Term: “8-Wire/8-conductor cable”
PHR-7 | Connector: 2.0mm, CBL, VRT, Female, 7-POS | 2
SPH-002T-P0.5L | Contacts: Sockets, 28-24, SN | 14
W117 | Cable Assy.: Air Pump, 24AWG, F (1-Sided) | 1 | AWG?
ANY | Cable: 24AWG Wire | AR
PHR-2 | Connector: 2.0mm, CBL, VRT, Female, 2-POS | 1
SPH-002T-P0.5L | Contacts: Sockets, 28-24, SN | 2
W118 | Cable Assy.: Solid-State Relay, 24AWG, F (1-Sided) | 1
ANY | Cable: 24AWG Wire | AR
65039-035LF | Connector: 0.1IN, CBL, 2-POS(F) | 1
48051-000LF | Contacts: Crimp, Sockets, 22-26AWG, SN | 2
W119 | Cable Assy.: Power Button, 26AWG, F (1-Sided) | 1
ANY | Cable: 24/26AWG Wire | AR | SHIELD?
PHR-4 | Connector: 2.0mm, CBL, VRT, Female, 4-POS | 1
SPH-002T-P0.5L | Contacts: Sockets, 28-24, SN | 4
W120 | Cable Assy.: Emergency Stop, 26AWG, F (1-Sided) | 1
ANY | Cable: 24/26AWG Wire | AR
PHR-2 | Connector: 2.0mm, CBL, VRT, Female, 2-POS | 1
SPH-002T-P0.5L | Contacts: Sockets, 28-24, SN | 2
OPTIONAL CABLE ASSEMBLIES
W121-W123 | Cable Assy.: Optical Endstop, 26AWG, F-F | 3
ANY | Cable: 24/26AWG Wire | AR
65039-034LF | Connector: 0.1IN, CBL, 3-POS(F) | 1
48051-000LF | Contacts: Crimp, Sockets, 22-26AWG, SN | 3
PHR-3 | Connector: 2.0mm, CBL, VRT, Female, 3-POS | 1
SPH-002T-P0.5L | Contacts: Sockets, 20-26AWG, AU | 3
W124-W126 | Cable Assy.: Rotary Encoders, 24AWG, F (1-Sided) | 3
ANY | Rotary Encoder (Absolute), Bare Leads | 1
ANY | Cable: 24/26AWG Wire | AR
PHR-5 | Connector: 2.0mm, CBL, VRT, Female, 5-POS | 1
SPH-002T-P0.5L | Contacts: Sockets, 20-26AWG, AU | 5
