firepick-delta/fpd-electronics/EAGLE/EFD01 - Crsl. Feeder/EFD01 - C. Feeder_BOM.xls

Mfg Part Num | Description | QTY: | REFDES | Price(USD): | Mfg Name | Distr.: | Vendor Part Num | Notes:
EFD01 | Carousel Feeder Control PCB | 1 | EFD01 | - | Tin Whiskers Technology | - | - | -
- | PCB, Bare, FR-4, 0.062”, 4-Layer | 1 | - | - | HQPCB | ANY | - | -
GRM188R71H103KA01D | Capacitor: 10nF, 50V, 10%, X7R | 1 | C1 | $0.10 | Murata | ANY | 490-1512-1-ND
EMVA500ADA101MHA0G | Capacitor: Al-Elec., 100uF, 50V, 6.3mm SMT | 1 | C9 | $0.92 | United Chemi-Con | ANY | 565-2133-1-ND
UMK107B7104KA-T | Capacitor: 0.1uF, 50V, 10%, X7R | 6 | C2, C6, C10, C11, C12, C13 | $0.24 | Taiyo Yuden | ANY | 587-1243-1-ND
UMK107AB7105KA-T | Capacitor, 1uF, 50V, 10% | 3 | C3, C7, C8 | $0.46 | Taiyo Yuden | ANY | 587-3247-1-ND
GRM1885C1H120FA01J | Capacitor: 12pF, 50V, 1%, C0G | 2 | C4, C5 | $0.16 | Murata | ANY | 490-10705-1-ND
S6B-PH-SM4-TB(LF)(SN) | Connector: 2.0mm (JST), SMT, R/A, 6-POS(M) | 2 | J1, J4 | $0.85 | JST | ANY | 455-1753-1-ND
67996-206HLF | Connector: Header, 0.1ﾔ, 6-Pin, Male, Thru-Hole | 1 | J2 | $0.40 | FCI | ANY | 609-3210-ND
S4B-PH-SM4-TB(LF)(SN) | Connector: 2.0mm (JST), SMT, R/A, 4-POS(M) | 1 | J3 | $0.75 | JST | ANY | 455-1751-1-ND
SML-D12M8WT86 | LED: YW/GN, Diffused, 2.2V, 20mA | 1 | LED1 | $0.34 | Rohm | ANY | 511-1578-1-ND
SML-D12U8WT86 | LED: RD, Diffused, 2.2V, 20mA | 3 | LED2-LED4 | $0.34 | Rohm | ANY | 511-1580-1-ND
BSS138-7-F | MOSFET: N-Ch, 50V, 220mA, SOT-23 | 1 | Q1 | $0.23 | Fairchild Semiconductor | ANY | BSS138CT-ND
HCM4916000000ABJT | Crystal Oscillator: 16MHz, 18pF, SMD | 1 | Q2 | $0.63 | Citizen FM | ANY | 300-6134-1-ND
TC33X-2-103E | Potentiometer: Trim, 10 kOhm, 0.1W, 25% | 1 | R1 | $7.27 | Bourns Inc. | ANY | TC33X-103EDKR-ND
RC0603FR-07120RL | Resistor: 120 Ohm, 0.1W, 1% | 2 | R2, R10 | $0.10 | Yageo | ANY | 311-120HRCT-ND
RC0603FR-071KL | Resistor: 1 kOhm, 0.1W, 1% | 6 | R3, R4, R11, R13, R14, R15 | $0.10 | Yageo | ANY | 311-1.00KHRCT-ND
RL1206FR-7W0R22L | Resistor: 0.22 Ohm, 0.5W, 1% | 2 | R5, R6 | $0.66 | Yageo | ANY | 311-.22LYCT-ND
RC0603FR-0722KL | Resistor: 22 kOhm, 0.1W, 5% | 1 | R7 | $0.10 | Yageo | ANY | 311-22.0KHRCT-ND | REPLACE, NTR4003??
RC0603FR-071ML | Resistor: 1 Mohm, 0.1W, 5% | 1 | R8 | $0.10 | Yageo | ANY | 311-1.00MHRCT-ND
RC0603FR-0710KL | Resistor: 10 kOhm, 0.1W, 1% | 2 | R9, R12 | $0.10 | Yageo | ANY | 311-10.0KHRCT-ND
SP3485 | Transceiver: RS-485 Chip | 1 | U1 | $2.52 | EXAR | ANY | 1016-1817-1-ND
TCST1030 | Optical Sensor: 3.1mm Slot, Thru-Hole, Trans | 1 | U2 | $1.17 | Vishay | ANY | TCST1030-ND
ATMEGA328-AUR | Microprocessor: AVR, 20MHz, 8-Bit Core | 1 | U3 | $3.38 | Atmel | ANY | ATMEGA328-AURCT-ND
DRV8825PWPR | Motor Driver: Bipolar, Stp/Dir, 1/32, 2.5A | 1 | U4 | $6.05 | Texas Instruments | ANY | 296-29503-1-ND
SN74LVC1G32DBVR | Logic Gate: OR, 1-CH, SOT23-5 | 1 | U5 | $0.39 | Texas Instruments | ANY | 296-9847-1-ND
TC1015-3.3VCT713 | Voltage Reg(LDO): Vi=6V, Vo=3.3V, Io=0.1A | 1 | VR1 | $0.43 | Microchip Tech. | ANY | TC1015-3.3VCT713CT-ND
 |  |  | TOTAL: | $29.76
