firepick-delta/fpd-electronics/EAGLE/EMC03 - Motion Control/EMC03-BOM.xls

Part No. | Description | Qty-1 | Part References | Mfg Name | Distr. | Price(USD): | Status: | Notes:
EMC03 | Motion Controller PCB | - | EMC03 | Tin Whiskers Technology | N/A | - | - | -
- | Bare PCB, FR-4, 0.062”, 4-Layer | 1 |  | HQPCB | N/A
GRM1885C1H120FA01J | Capacitor: 12pF, 50V, 1%, C0G | 2 | C1, C75 | Murata | ANY | $0.16
GRM188C81E475KE11D | Capacitor: 4.7 uF, 25V, 10%, X6S | 6 | C11, C12, C13, C14, C18, C19 | Murata | ANY | $0.42
UMK107B7104KA-T | Capacitor: 0.1uF, 50V, 10%, X7R | 15 | C15, C39, C62, C47, C48, C57, C58, C70, C71, C17, C41, C42, C52, C64, C65 | Taiyo Yuden | ANY | $0.15 |  | Check Voltage Ratings
UMK107B7474KA-TR | Capacitor, 470nF, 50V, 10%, X7R | 3 | C16, C40, C63 | Taiyo Yuden | ANY | $0.24
GMK107BJ104KAHT | Capacitor: 0.1uF, 35V, 10%, X5R | 6 | C2, C5, C7, C9, C28, C29 | Taiyo Yuden | ANY | $0.23 |  | Change on SCH
EEE-FTH101XAP | Capacitor: 100 uF, Al-Elec., 20%, 50V, SMT | 3 | C20, C21, C22 | Panasonic | ANY | $0.94
EMVH350ADA100MF60G | Capacitor, AL-Electrolytic, 10uF, 35V, 20% | 2 | C3, C4 | United Chemi-Con | ANY | $0.56
GRM188R72A471KA01D | Capacitor: 470pF, 100V, 10%, X7R | 12 | C43, C44, C45, C46, C53, C54, C55, C56, C66, C67, C68, C69 | Murata | ANY | $0.59
GRM188R71H223KA01D | Capacitor: 22nF, 50V, 10% | 3 | C49, C59, C72 | United Chemi-Con | ANY | $0.10
GRM188R71H103KA01D | Capacitor: 10nF, 50V, 10%, X7R | 4 | C6, C8, C10, C27 | Murata | ANY | $0.10
MSS1P6 | Diode: Rectifier, 1A, 60V | 12 | D3, D4, D5, D6, D7, D8, D9, D10, D11, D12, D13, D14 | Vishay | ANY | $0.30
BLM18AG121SN1D | Ferrite Bead, Filter | 1 | FB2 | Murata | ANY | $0.10
67996-206HLF | Connector: Header, 0.1”, 6-Pin, Male, Thru-Hole | 1 | J1 | FCI | ANY | $0.40
S4B-PH-SM4-TB(LF)(SN) | Connector: 2.0mm (JST), SMT, R/A, 4-POS(M) | 3 | J10, J11, J12 | JST | ANY | $0.75
S5B-PH-SM4-TB(LF)(SN) | Connector: 2.0mm (JST), SMT, R/A, 5-POS(M) | 3 | J13, J14, J15 | JST | ANY | $0.79
S8B-PH-SM4-TB(LF)(SN) | Connector: 2.0mm (JST), SMT, R/A, 8-POS(M) | 1 | J17 | JST | ANY | $0.93
S6B-PH-SM4-TB(LF)(SN) | Connector: 2.0mm (JST), SMT, R/A, 6-POS(M) | 1 | J19 | JST | ANY | $0.85
FTSH-105-01-L-DV | Connector: Header, 0.05ﾔ, 10-Pin, Male, SMT | 1 | J2 | Samtec | ANY | $3.42
S3B-PH-SM4-TB(LF)(SN) | Connector: 2.0mm (JST), SMT, R/A, 3-POS(M) | 3 | J5, J6, J7 | JST | ANY | $0.65
SML-D12M8WT86 | LED: YW/GN, Diffused, 2.2V, 20mA | 4 | LED1, LED2, LED3, LED4 | Rohm | ANY | $0.34
SML-D12U8WT86 | LED: RD, Diffused, 2.2v 20mA | 1 | LED5 | Rohm | ANY | $0.54
HCM4912000000ABJT | Crystal Oscillator: 12MHz, 18pF, 30PPM | 1 | Q1 | Citizen FM | ANY | $0.63
RL1206FR-7W0R22L | Resistor: 0.22 Ohm, 0.5W, 1% | 6 | R1, R2, R44, R45, R46, R47 | Yageo | ANY | $0.66
RC0603FR-072R2L | Resistor: 2.2 Ohm, 0.1W, 1% | 3 | R10, R11, R12 | Yageo | ANY | $0.10
RC0603FR-0720KL | Resistor: 20 kOhm, 0.1W, 5% | 3 | R19, R20, R21 | Yageo | ANY | $0.10
RC0603FR-0710KL | Resistor: 10 kOhm, 0.1W, 1% | 6 | R24, R25, R26, R4, R5, R18 | Yageo | ANY | $0.10
RC0603FR-071ML | Resistor: 1 Mohm, 0.1W, 5% | 1 | R3 | Yageo | ANY | $0.10
RC0603FR-071KL | Resistor: 1 kOhm, 0.1W, 1% | 2 | R38, R39 | Yageo | ANY | $0.10
RC0603FR-07120RL | Resistor: 120 Ohm, 0.1W, 1%, 0603 | 1 | R40 | Yageo | ANY | $0.10
RC0603FR-07470RL | Resistor: 470 Ohm, 0.1W, 1% | 5 | R6, R7, R8, R9, R41 | Yageo | ANY | $0.10
147873-2 | Switch: Push-button, Mom. NO | 3 | S1, S2, S3 | TE Connectivity | ANY | $0.41
OSTTH030160 | TERM BLOCK PLUG 3POS 90DEG 5MM | 1 | TB1 | On Shore Technology Inc | ANY | $0.79
EDSTL130/03 | Header: T-Block, 5MM, 3-Pos | 1 | TB1 | On Shore Technology Inc | ANY | $1.09
LPC1768 | Microprocessor: ARM Cortex-M3 | 1 | U1 | NXP | ANY | $10.71
SP3485 | Transceiver: RS-485 Chip | 1 | U2 | EXAR | ANY | $2.52
SN74LVC1G32DBVR | Logic Gate: OR, 1-CH, SOT23-5 | 1 | U3 | Texas Instruments | ANY | $0.39
TMC2130-LA | Stepper Driver (Trinamic TMC2130-LA) | 3 | U6, U7, U8 | Trinamic | ANY | $8.98
LMS8117AMP-3.3/NOPB | Voltage Reg(LDO): Vi=15V, Vo=3.3V, I=1A | 1 | VR1 | Texas Instruments | ANY | $1.14
 |  |  |  |  | TOTAL: | $81.27
