firepick-delta/fpd-electronics/EAGLE/ELED03 - EE2.0 LED board/ELED03_BOM.xls

Mfg Part Num | Description | QTY: | REFDES | Price(USD): | Mfg Name | Distr.: | Vendor Part Num | Notes:
ELED03 | LED ring light PCB | 1 | ELED03 | - | Tin Whiskers Technology | - | - | -
- | PCB, Bare, FR-4, 0.062”, 2-Layer | 1 | - | - | HQPCB | ANY | - | -
 | LED: White, high-brightness, 1206 or 1210 | 16 | LED1-LED16
 | LED: WS2812B, RGB, 5050 | 8 | LED17-LED24
 | Capacitor: 0603 0.1 uF | 8 | C3-C9
 | Connector: JST 5-pin | 1 | J7
 |  |  | TOTAL:
