firepick-delta/fpd-electronics/EAGLE/ELED04 - ULC ring light LED board/ELED04_BOM.xls

Mfg Part Num | Description | QTY: | REFDES | Price(USD): | Mfg Name | Distr.: | Vendor Part Num | Notes:
ELED04 | LED ring light PCB | 1 | ELED04 | - | Tin Whiskers Technology | - | - | -
- | PCB, Bare, FR-4, 0.062”, 2-Layer | 1 | - | - | HQPCB | ANY | - | -
 | LED: White, high-brightness, 1206 or 1210 | 16 | LED1-LED16
 |  |  | TOTAL:
