firepick-delta/fpd-electronics/EAGLE/EMC03 - Motion Control/EMC03-BOM_1.xls

Part No. | Description | Ref Designator: | Qty: | Mfr. | Distr. | Price(USD): | Status: | Notes:
EMC03 | Electronic Motion Control PCB, Rev. 3 | EMC03 | 1 | TWT | - | - |  | -
CL10B104KO8NNNC | Capacitor: 0.1uF, 16V, 10%, X5R, 0603 | C5, C7, C9, C13-C14, C18-C25, C28-C29, C33-C35, C60, C74, C77, C79-C82, C84-C85 | 27 | Taiyo Yuden | ANY | $0.23 | DELIVERED | GMK107BJ104KAHT
CL10B104KC8NNNC | Capacitor: 0.1uF, 100V, 10%, X7R, 0603 | C2, C4, C15, C17, C39, C41-C42, C47-C48, C52, C57-C58, C62, C64-C65, C70-C71 | 17 | Taiyo Yuden | ANY | $0.24 | DELIVERED | UMK107B7104KA-T
EMVA500ADA101MHA0G | Capacitor, Al-Electrolytic, 100uF, 50V, 20%, 8mm | C3 | 1 | United Chemi-Con | ANY | $0.92
GRM188R71H103KA01D | Capacitor: 10nF, 50V, 10%, X7R, 0603 | C6, C8, C10, C27 | 4 | Murata | ANY | $0.10
GRM1885C1H120FA01J | Capacitor: 12pF, 50V, 1%, C0G, 0603 | C1, C75 | 2 | Murata | ANY | $0.16
GCM1885C1H180JA16D | Capacitor: 18pF, 50V, 5%, C0G, 0603 | C26, C30-32 | 4 | Murata | ANY | $0.10
UMK107AB7105KA-T | Capacitor, 1uF, 50V, 10%, 0603 | C73 | 1 | Taiyo Yuden | ANY | $0.46
GRM188R72A223KAC4D | Capacitor: 22nF, 63V, 10%, 0603 | C49, C59, C72 | 3 | United Chemi-Con | ANY | $0.15 | DELIVERED | GRM188R71H223KA01D
C0603C330K5GACTU | Capacitor: 33pF, 50V, 10%, C0G, 0603 | C11-C12 | 2 | Kemet | ANY | $0.24
EMVY500ADA221MJA0G | Capacitor: Al-Electrolytic, 220uF, 50V, 20% | C36-C37 | 2 | Taiyo Yuden | ANY | $1.09
UMK107B7474KA-TR | Capacitor, 470nF, 50V, 10%, X7R, 0603 | C16, C40, C63 | 3 | Taiyo Yuden | ANY | $0.24 | DELIVERED
GRM188R72A471KA01D | Capacitor: 470pF, 100V, 10%, X7R, 0603 | C43-C46, C53-C56, C66-C69 | 12 | Murata | ANY | $0.14 | DELIVERED
EMVA250ADA471MJA0G | Capacitor: Al-Electrolytic, 470uF, 25V, 20% | C38, C50 | 2 | United Chemi-Con | ANY | $1.08
GRM188C81E475KE11D | Capacitor: 4.7uF, 25V, 10%, X6S, 0603 | C61, C83 | 2 | Murata | ANY | $0.42
LMK107B7474KA-T | Capacitor: 0.47uF, 10V, 10%, X7R, 0603 | C51, C76 | 2 | Taiyo Yuden | ANY | $0.10
1N4148W-7-F | Diode: Rectifier, 150mA, 75V, SOD-123 | D1 | 1 | Diodes, Inc. | ANY | $0.17
SJPB-H6 | Diode: Rectifier (Schottky), 2A, 60V, 2-SMD | D2, D15 | 2 | Sanken | ANY | $0.64
MSS1P6 | Diode: Rectifier, 1A, 60V, MicroSMP | D3-D14 | 12 | Vishay | ANY | $0.47 | DELIVERED
BLM18AG121SN1D | Ferrite Bead, Filter, 0603 | FB1-FB4 | 4 | Murata | ANY | $0.11
S4B-PH-SM4-TB(LF)(SN) | Connector: 2mm, 4-Pin, Male, SMT(R/A) | J10-J12 | 3 | JST | ANY | $0.93 |  | Motors
S3B-PH-SM4-TB(LF)(SN) | Connector: 2mm, 3-Pin, Male, SMT(R/A) | J5-J7 | 3 | JST | ANY | $0.65 |  | Endstops
67996-206HLF | Connector: Header, 0.1”, 6-Pin, Male, Thru-Hole | J1 | 1 | FCI | ANY | $0.40 |  | Reset
68000-102HLF | Connector: Header, 0.1”, 2-Pin, Male, Thru-Hole | J9, J21 | 2 | FCI | ANY | $0.56 |  | E-Stop, PWRBTN
68000-104HLF | Connector: Header, 0.1”, 4-Pin, Male, Thru-Hole | J3, J22 | 2 | FCI | ANY | $0.31 |  | USB-A, Serial Console
S8B-PH-SM4-TB(LF)(SN) | Connector: 2mm, 8-pin, Male, SMT(R/A) | J16-J17 | 2 | JST | ANY | $0.93 |  | U-L Cam, EE2.0
S5B-PH-SM4-TB(LF)(SN) | Connector: 2mm, 5-pin, Male, SMT(R/A) | J13-J15 | 3 | JST | ANY | $0.79 |  | Optical Encoders
S6B-PH-SM4-TB(LF)(SN) | Connector: 2mm, 6-pin, Male, SMT(R/A) | J18-J19 | 2 | JST | ANY | $0.85 |  | Modular Tools
DF40HC(3.0)-70DS-0.4V(51) | Connector: 0.4mm, 70-pin, Male, SMT | J20 | 1 | Hirose | ANY | -
694106106102 | Connector: Power (Barrel), 24VDC, 5A, R/A, Switch(NC) | J8 | 1 | Wurth Electronics | ANY | $2.12 |  | PWR in
47334-0001 | Connector: Memory, MicroSD, | J4 | 1 | Molex | ANY | $3.47 |  | MicroSD
FTSH-105-01-L-DV | Connector: Header, 0.05”, 10-Pin, Male, SMT | J2 | 1 | Samtec | ANY | $3.42 |  | SWD
DR125-101-R | Inductor: SMD, 100uH, 1.78A; | L1-L2 | 2 | Eaton | ANY | $1.91
SML-D12M8WT86 | LED: YW/GN, Diffused, 2.2V, 20mA, 0603 | LED1-LED4, LED-8-LED14 | 11 | Rohm | ANY | $0.34
SML-D12U8WT86 | LED: RD, Diffused, 2.2v 20mA, 0603 | LED5-LED7 | 3 | Rohm | ANY | $0.54
HCM4912000000ABJT | Crystal Oscillator: 12MHz, 18pF, 30PPM | Q1 | 1 | Citizen FM | ANY | $0.63
HCM4925000000MABJ | Crystal Oscillator: 25MHz, 18pF, 30PPM | Q2 | 1 | Citizen FM | ANY | $0.64
RC0603JR-070RL | Resistor: 0 Ohm, 0.1W, 1% 0603, DNP | R16 | 1 | Yageo | ANY | $0.11 |  | DNP
RLR0603FR-070R1L | Resistor: 0.1 Ohm, 0.1W, 1%, 0603 | R15 | 1 | Yageo | ANY | $0.10
RCWE1206R220FKEA | Resistor: 0.22 Ohm, 0.5W, 1%, 1206 | R1-R2, R44-R47 | 6 | Vishay | ANY | $0.66 | DELIVERED | RL1206FR-7W0R22L
RC0603FR-071K2L | Resistor: 1.2 kOhm, 0.1W, 1%, 0603 | R42 | 1 | Yageo | ANY | $0.11
RC0603FR-07100KL | Resistor: 100 kOhm, 0.1W, 1%, 0603 | R27 | 1 | Yageo | ANY | $0.11
RC0603FR-07120RL | Resistor: 120 Ohm, 0.1W , 1%, 0603 | R40, R51 | 2 | Yageo | ANY | $0.11
RC0603FR-0710KL | Resistor: 10kOhm, 0.1W, 1%, 0603 | R4-R5, R14, R18, R24-R26, R28, R36, R43, R48 | 11 | Yageo | ANY | $0.11
RC0603FR-071KL | Resistor: 1 kOhm, 0.1W, 1%, 0603 | R38-R39, R49-R50 | 4 | Yageo | ANY | $0.11
RC0603FR-071ML | Resistor: 1MOhm, 0.1W, 5%, 0603 | R3, R11 | 2 | Yageo | ANY | $0.11
RC0603FR-0710K5L | Resistor: 10.5 kOhm, 0.1W, 1%, 0603 | R17, R23 | 2 | Yageo | ANY | $0.11
RC0603FR-0712KL | Resistor: 12 kOhm, 0.1W, 1%, 0603 | R35 | 1 | Yageo | ANY | $0.11
RC0603FR-0712K4L | Resistor: 12.4 kOhm, 0.1W, 1%, 0603 | R13 | 1 | Yageo | ANY | $0.11
RC0603FR-0722KL | Resistor: 20 kOhm, 0.1W, 5%, 0603 | R19-R21 | 3 | Yageo | ANY | $0.11
RC0603FR-07270RL | Resistor: 270 Ohm, 0.1W, 1%, 0603 | R53-R54 | 2 | Yageo | ANY | $0.11
RC0603FR-07330RL | Resistor: 330Ohm, 0.1W, 5%, 0603 | R10, R33-R34 | 3 | Yageo | ANY | $0.11
RC0603FR-074K7L | Resistor: 4.7 kOhm, 0.1W, 5%, 0603 | R29 | 1 | Yageo | ANY | $0.11
RC0603FR-07470RL | Resistor: 470 Ohm, 0.1W, 1%; | R6-R9, R41 | 5 | Yageo | ANY | $0.11
RC0603FR-0749R9L | Resistor: 49.9 Ohms, 0.1W, 1%; | R22, R30-R32 | 4 | Yageo | ANY | $0.11
RC0603FR-07511RL | Resistor: 511 Ohm, 0.1W, 1%, 0603 | R37, R52, R55-R56 | 4 | Yageo | ANY | $0.11
RC0603FR-07825RL | Resistor: 825 Ohm, 0.1W, 1%, 0603 | R12 | 1 | Yageo | ANY | $0.11
HR911105A | Connector: Ethernet, MagJack, RJ-45, Status LEDs+Shield; | RJ1 | 1 | HanRun | ANY | $1.23
CHS-01TA | SMD Dip Switch 1 pol. | S1 | 1 | Copal Electronics | ANY | $0.98
147873-2 | Switch: Push-button, Mom. NO, 0603 | S2-S3 | 2 | Alcoswitch | ANY | $0.25
LPC1768 | Microprocessor: ARM Cortex-M3 | U1 | 1 | NXP | ANY | $11.25
SP3485 | Transceiver: RS-485 Chip; | U2, U9 | 2 | EXAR | ANY | $2.24
93LC66A | EEPROM, 4 kBit, 2MHz, SOIC-8 | U3 | 1 | Microchip Tech. | ANY | $0.31
LAN9514-JZX | USB + Ethernet Controller | U4 | 1 | Microchip Tech. | ANY | $6.65
CAHCT1G126QDCKRG4 | Buffer/Line Driver: 74AHCT-Series, 3-5.5V, SC70 | U5 | 1 | Texas Instruments | ANY | $0.57
TMC2130-LA | Stepper Driver (Trinamic TMC2130-LA) | U6-U8 | 3 | Trinamic | ANY | $8.98 | DELIVERED
FT232RL | USB Controller (UART) | U10 | 1 | FTDI | ANY | $4.50
74LVC1T45 | Logic Shifter: Bidirectional, SOT-363 | U11-U15, U17 | 6 | NXP | ANY | $0.15
TXC0206-29 | Logic Shifter: Secure Digital, Bidirectional | U16 | 1 | Texas Instruments | ANY | $1.78
MIC2026-1YM | Power Dist. Switch: | U18-U19 | 2 | Micrel | ANY | $1.37
SI-8050JD | Voltage Regulator: 5V, 1.5A, Switching; | VR1 | 1 | Sanken | ANY | $2.78
SI-8033JD | Voltage Regulator: 3.3V, 1.5A, Switching; | VR2 | 1 | Sanken | ANY
