firepick-delta/fpd-electronics/EAGLE/EBR01 - TMC2130 breakout board/EBR01 PCB Bill of Materials.xls

Part Number: | Description: | Qty: | Ref. Designator: | Mfr: | Cost (USD) | Dist: | Status: | Datasheet: | Notes:
EBR01 | Motor Driver Breakout Assy. | 1 |  | ANY |  | N/A |  | EBR01.sch
- | FR-4, 4-layer, 0.062" Thickness | 1 | A1 | ANY |  | N/A
MSS1P6 | Schottky Diode, Rectifier, 1A, 60V | 4 | D1-D4 | Vishay | $0.124 | Taobao | ORDERED | http://www.vishay.com/docs/89018/mss1p6.pdf | Notes:
68000-208HLF | Connector, Header, 8P, Male, 0.1" | 2 | J1, J2 | FCI Connect | $0.675 | Taobao |  | http://portal.fciconnect.com/Comergent//fci/drawing/68000.pdf | Slim footprint
67996-206HLF | Connector, Header, 2x3P, Male, 0.1" | 1 | J3 | FCI Connect | $0.662 | Taobao |  | http://portal.fciconnect.com/Comergent//fci/drawing/67996.pdf | Slim footprint
CRCW06032R20FKEAHP | Resistor, 2.2Ω, 0.25W, 1%, 0603 | 1 | R1 |  |  |  |  |  | Eliminated by U2
RCWE1206R220FKEA | Resistor, 0.22Ω, 0.5W, 1%, 1206 | 2 | R1, R2 | Vishay | $0.170 | Taobao | ORDERED | http://www.farnell.com/datasheets/622222.pdf | Notes:
UMK107B7474KA | Capacitor, 470 nF, 50V, 10% 0603 | 1 | C1 | Taiyo Yuden | $0.040 | HQEW/Taobao | ORDERED | http://www.mouser.com/ds/2/396/mlcc_all_e-541559.pdf | Notes:
C1608X7R1H334K080AC | Capacitor, 0.33 μF, 50V, 10%, 0603 | 1 | C2 | TDK | $0.170 | HQEW/Taobao | ORDERED | http://product.tdk.com/en/catalog/datasheets/mlcc_commercial_general_en.pdf | Would like to replace mfr.
CL10B104KO8NNNC | Capacitor, 100 nF, 16V, 10%, 0603 | 3 | C3, C12, C13 | Samsung | $0.170 | HQEW/Taobao | ORDERED | http://www.samsungsem.com/global/support/library/product-catalog/__icsFiles/afieldfile/2014/11/13/MLCC.pdf | 50V Version in HAX Lab for Prototype
CL10B104KC8NNNC | Capacitor, 100nF, 100V, 10%, 0603 | 3 | C4, C6, C7 | Samsung | $0.090 | HQEW/Taobao | ORDERED | http://www.samsungsem.com/global/support/library/product-catalog/__icsFiles/afieldfile/2014/11/13/MLCC.pdf | Notes:
GRM188R72A223KAC4D | Capacitor, 22 nF, 63V, 10%, 0603 | 1 | C5 | Murata | $0.040 | HQEW/Taobao | ORDERED | http://www.mouser.com/ds/2/281/c02e-2905.pdf | Notes:
GRM188R72A471KA01D | Capacitor, 470 pF, 100V, 10%, 0603 | 4 | C8-C11 | Murata | $0.190 | HQEW/Taobao | ORDERED | http://www.mouser.com/ds/2/281/c02e-2905.pdf | Notes:
TMC2130-LA | Motor Driver, 2-phase, 4.75-46VDC | 1 | U1 | Trinamic | $8.98 | Digikey | ORDERED | http://www.trinamic.com/products/integrated-circuits/stepper-power-driver/tmc2130 | QFN-32 Package
KA78L05AMTF | Voltage Regulator, Linear, 5V, 0.1A | 1 | U2 | Fairchild Semi | $0.315 | Newark (E14) | ORDERED | http://www.farnell.com/datasheets/1729160.pdf | SOT-89 Package
 |  |  |  | Total: | $13.93
