firepick-delta/fpd-electronics/EAGLE/BOM Generation/SampleProject/MicroRC/BOM/MicroRC-ImportPartNumbers.xls

Sheet: Sheet1
PART-ID | VALUE | VID | VENDOR PART# | MFG PART#
R4 | 0R | DK | RHM0.0ACT-ND | MCR10EZHJ000
R21 | 100 | DK | P100ZCT-ND | ERA-6YEB101V
R12 | 390 | DK | P390ZCT-ND | ERA-6YEB391V
R3, R20 | 1.00k | DK | P1.00KCCT-ND | ERJ-6ENF1001V
R13 | 1.24k | DK | P1.24KCCT-ND | ERJ-6ENF1241V
R1 | 2.21k | DK | P2.21KCCT-ND | ERJ-6ENF2211V
R5, R7, R10, R15, R18, R26, R27, R28, R25 | 4.75k | DK | P4.75KCCT-ND | ERJ-6ENF4751V
R23 | 5.11k | DK | P5.11KCCT-ND | ERJ-6ENF5111V
R6, R16, R17, R24, R29, R33, R34 | 10.0k | DK | P10.0KCCT-ND | ERJ-6ENF1002V
R9, R11, R30, R31, R32 | 100k | DK | P100KCCT-ND | ERJ-6ENF1003V
R8 | 221k | DK | P221KCCT-ND | ERJ-6ENF2213V
R2, R14 | 1.20M | DK | P1.20MCCT-ND | ERJ-6ENF1204V
R19, R22 | 10M | DK | 311-10.0MCRCT-ND | RC0805FR-0710ML
R36, R37 | 20K LIN | DK | P3T9203-ND | EVU-E2JFK4B24
R35, R38 | 50K LIN | DK | P3T9503-ND | EVU-E2JFK4B54
C4, C5, C15, C21 | 0.1uF | DK | PCC1840CT-ND | ECJ-2YB1H104K
C2 | 0.1uF | DK | PCF1126CT-ND | ECP-U1C104MA5
C1, C14 | 0.15uF | DK | PCF1127CT-ND | ECP-U1C154MA5
C27 | 0.001uF | DK | PCC102BNCT-ND | ECJ-2VB1H102K
C3 | 0.0033uF | DK | PCF1334CT-ND | ECH-U1H332JX5
C8, C13, C18 | 47pF | DK | PCC470CGCT-ND | ECJ-2VC1H470J
C24 | (DNP)
C6, C7, C9, C10, C11, C12, C20, C22, C23, C26 | 10uF/25 | DK | PCE3795CT-ND | EEE-FK1E100R
C16, C17, C19, C25 | 220uF/25 | DK | PCE3800CT-ND | EEE-FK1E221P
L1, L2 | BLM21BD121SN1D | DK | 490-1044-1-ND | BLM21BD121SN1D
L3 | CM1812R600R-10 | DK | 240-2454-1-ND | CM1812R600R-10
U1, U2, U3 | TL082CDR | DK | 296-1284-1-ND | TL082CDR
Q1 | MMBF4416LT1G | DK | MMBF4416LT1GOSCT-ND | MMBF4416LT1G
Q2 | MMBT3906LT1 | DK | MMBT3906LT1INCT-ND | MMBT3906LT1
Q4 | MMBTA05LT1G | DK | MMBTA05LT1GOSCT-ND | MMBTA05LT1G
Q3, Q5 | NDS7002A | DK | NDS7002ACT-ND | NDS7002A
B2 | DF005S | DK | DF005SDI-ND | DF005S
D1 | BLUE | DK | 350-1562-ND | 521-9918F
D2,D3 | LTST-C170CKT | DK | 160-1176-1-ND | LTST-C170CKT
D4,D5 | MBR0520-TP | DK | MBR0520TPMSCT-ND | MBR0520-TP
D6 | BZT52C16-7-F | DK | BZT52C16-FDICT-ND | BZT52C16-7-F
D7 | 1N4148W-7-F | DK | 1N4148W-FDICT-ND | 1N4148W-7-F
T1 (XICON) | 42TL013-RC | ME | 42TL013-RC | 42TL013-RC
T1 (TRIAD) | SP-66 | DK | 237-1151-ND | SP-66
J3, J4 | NMJ6HCD2 | ME | 550-22302 | NMJ6HCD2
J7 (Header) | 640454-2 | DK | A19423-ND | 640454-2
J7 (Housing) | 3-643813-2 | DK | A31107-ND | 3-643813-2
S1 | SDA04H0SK | DK | CKN1328-ND | SDA04H0SK
KNOB | P670S-09-D6S | ME | 550-P82-90F | P670S-09-D6S
POWER ADAPTER | WDU18-200 | ME | 553-WDU18-200 | WDU18-200
POWER JACK | 722A | DK | SC1049-ND | 722A
MISC | 1590BB | AE | 806-1532 | 1590BB
MISC | ENCLOSURE
MISC | ENCLOSURE
 | VID
 | DK
 | ME
 | AE
 | CE

Sheet: Sheet2
Part Name | Part Number
C5 | ECJ-2VB1H103K
C41 | ECJ-2VB1H682K
C40, C62 | ECJ-2VB1H102K
C2, C8, C9, C10, C19, C20, C30, C31, C43, C57, C63, C69, C71, C72, C73, C75, C76, C77 | ECJ-2VB1C473K
C35, C38 | ECJ-2VB1C473K
C60 | ECJ-2VB1H472K
C11, C12, C13 | ECJ-2FF1E474Z
C1, C22, C39, C44, C45, C47,C50, C52, C58, C59, C61, C64 | ECJ-2FB1E225K
C65, C66 | ECJ-2FB1E225K
C6, C7 | ECJ-2VC1H220J
C53, C54 | ECJ-2VC1H330J
C4, C51 | ECJ-2FB0J106M
C29, C46, C49 | ECJ-2VC1H101J
C36, C37 | ECJ-2VC1H471J
C48 | ECJ-2VC1H561J
C32, C33, C34, C42 | ECJ-2VB2A152K
C23, C24, C25 | ECJ-3VB1H104K
C80 | 12065C103KAT2A
C55, C78 | T491A104K035AT
C67 | T491A105K016AT
C56 | T491A225K010AT
C3, C21, C79 | T491B106M016AT
C68, C70, C74 | T491B226M016AT
C28 | EEE-1CA101P
C26, C27 | EEE-1EA471P
R80, R81 | RC0805JR-070RL
R1, R3, R4, R12 | ERJ-6ENF47R5V
R8, R9, R15, R17, R19, R30, R33 | ERJ-6ENF4751V
R36 | ERJ-6ENF5621V
R38 | ERJ-6ENF8251V
R5, R10, R11, R14, R18, R25, R28, R39, R40, R43, R50, R54, R56, R57, R58, R65, R67, R69, R70, R79 | ERJ-6ENF1002V
R42 | ERJ-6ENF1132V
R23, R31, R44, R48, R51, R59, R64, R72, R76 | ERJ-6ENF2212V
R53, R60 | ERJ-6ENF3322V
R21 | ERJ-6ENF6192V
R24 | ERJ-6ENF9092V
R47 | ERJ-6ENF9312V
R13, R20, R34, R37, R41, R45, R49, R61, R68, R73, R74, R77, R78 | ERJ-6ENF1003V
R35 | ERJ-6ENF1503V
R32 | ERJ-6ENF3013V
R29 | ERJ-6ENF3323V
R16, R46, R55, R62 | ERJ-6ENF1004V
R7 | ERJ-14NF4640U
R6 | ERJ-12SF48R7U
R22 | NCP21WF104J03RA
RN1 | 744C083103JPTR
R26, R27, R63, R71, R75 | EVM-EGGA00B14
R52 | EVM-EGGA00B25
R2, R66 | EVM-L4GA00B14
Q1, Q5 | MMBTA05LT1G
Q2 | ZXMN6A07ZTA
Q3, Q4 | IRF614SPBF
U11 | L7805ACD2T
U1 | DS1307Z+
U9 | ISD4002-240SY
U4 | L78L33ACUTR
U6 | MT8870DS
U5 | LM324D
U3 | MAX3243ECPWR
U7 | MAX323CSA+
U2 | ATMEGA1281-16AU
U8 | MX828DW
U10 | TLC084CD
U12 | AD1584BRTZ-REEL7
D5, D6, D9 | RS1GB-13-F
D1 | BAV16W-7-F
D7, D10 | BZT52C5V6-7-F
D11 | 5350T5
L1 | CM1812R600R-10
L2 | PM1210-R10J
L3 | PM2001-200
L4 | PM3308-100M
Y1 | ECS-160-18-9X
Y2 | ECS-35-18-10X
Y3 | ECS-40.3-20-5PX-TR
Y4 | ECS-.327-12.5-13X
DS1 | DMC-20261NY-LY-CCE-CMN
B1 | BR1225A/HB
PF1 | MF-SM030-2
S2 | 2M1-SP1-T2-B4-M6RE
X1 | EDSTLZ951/2
X2 | 182-009-113R531
X3 | 70553-0007
X4 | 640454-2
