firepick-delta/fpd-electronics/EAGLE/ECAM01 - Camera Board/ECAM01_1_P2.dxf

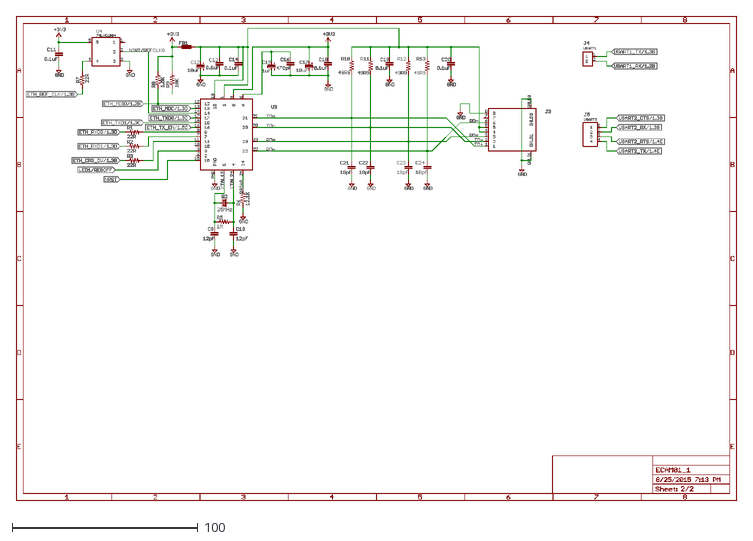
[picture p3: CAD file, 2015-08-26]
EAGLE/ECAM01 - Camera Board/ECAM01_1_P2.dxf
387.7 x 260.7
