firepick-delta/fpd-electronics/EAGLE/ECAM02 - EE2.0/ECAM02-EE2.0.dxf

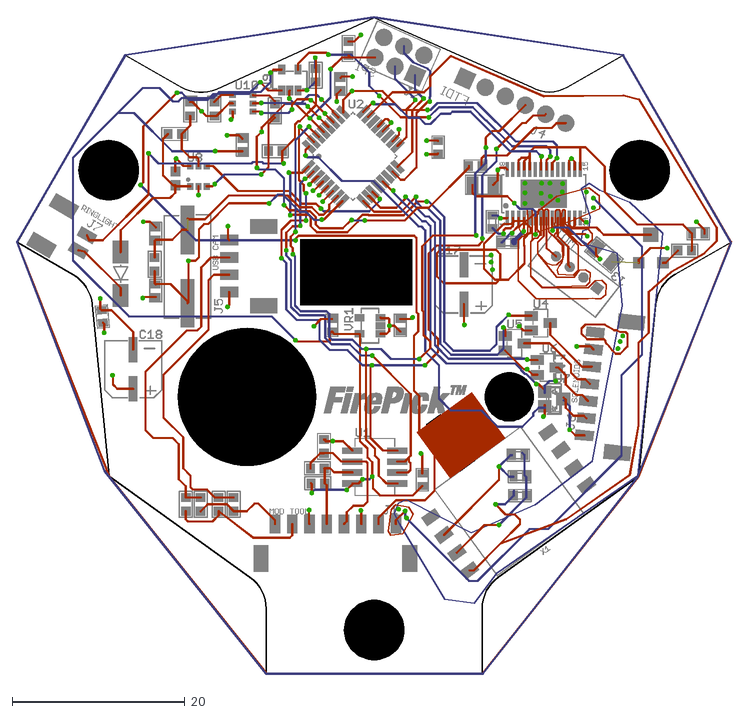
[picture p4: CAD file, 2015-10-11]
EAGLE/ECAM02 - EE2.0/ECAM02-EE2.0.dxf
82.9 x 76.2
