firepick-delta/fpd-electronics/EAGLE/EFD01 - Crsl. Feeder/EFD01 - C. Feeder.dxf

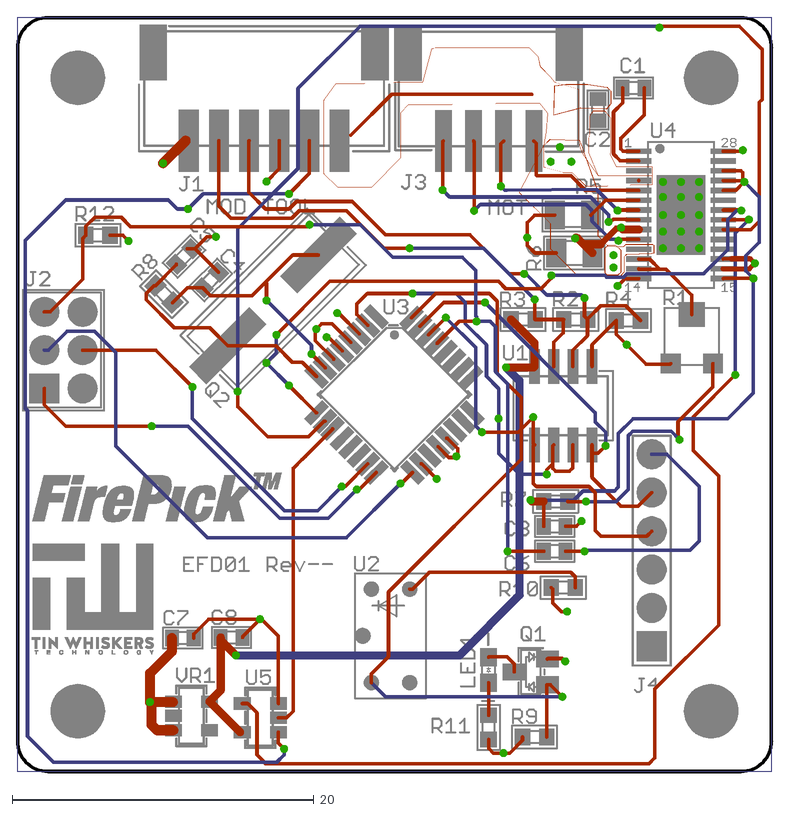
[picture p5: CAD file, 2015-10-19]
EAGLE/EFD01 - Crsl. Feeder/EFD01 - C. Feeder.dxf
50.2 x 50.2
