firepick-delta/fpd-electronics/EAGLE/ESOL01 - Solenoid + Pump/ESOL01 - Sol + Pump.dxf

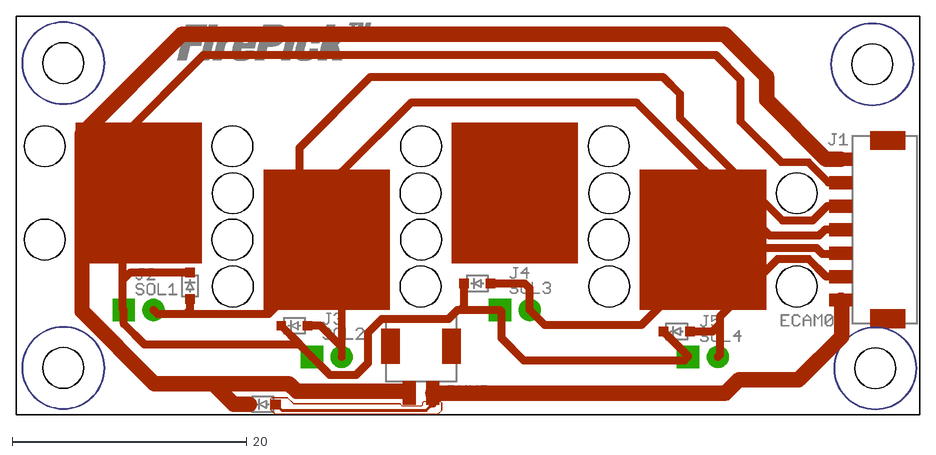
[picture p6: CAD file, 2015-10-22]
EAGLE/ESOL01 - Solenoid + Pump/ESOL01 - Sol + Pump.dxf
77.0 x 34.0
