firepick-delta/fpd-electronics/EAGLE/EBR01 - TMC2130 breakout board/EBR01_schematic.pdf

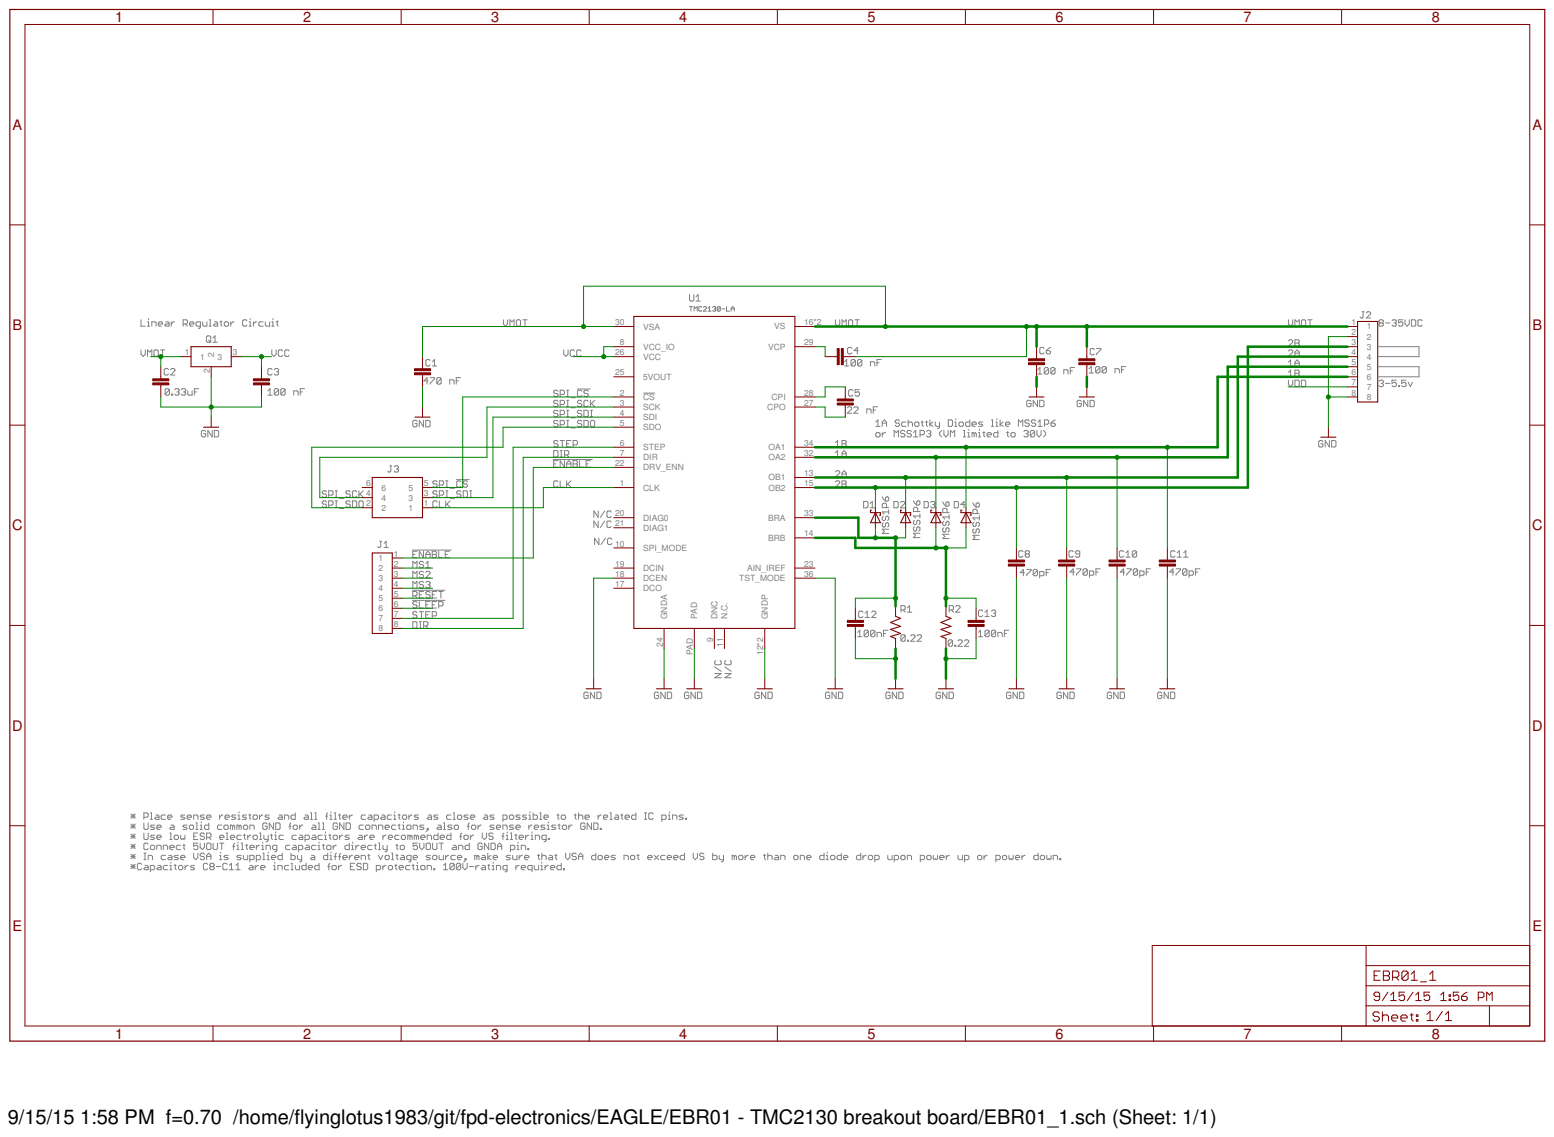
[picture p7: page 1]

7 8

9/15/15 1:58 PM f=0.70 /home/flyinglotus1983/git/fpd-electronics/EAGLE/EBR01 - TMC2130 breakout board/EBR01_1.sch (Sheet: 1/1)
