firepick-delta/fpd-electronics/EAGLE/EBR01 - TMC2130 breakout board/EBR01_bottom.pdf

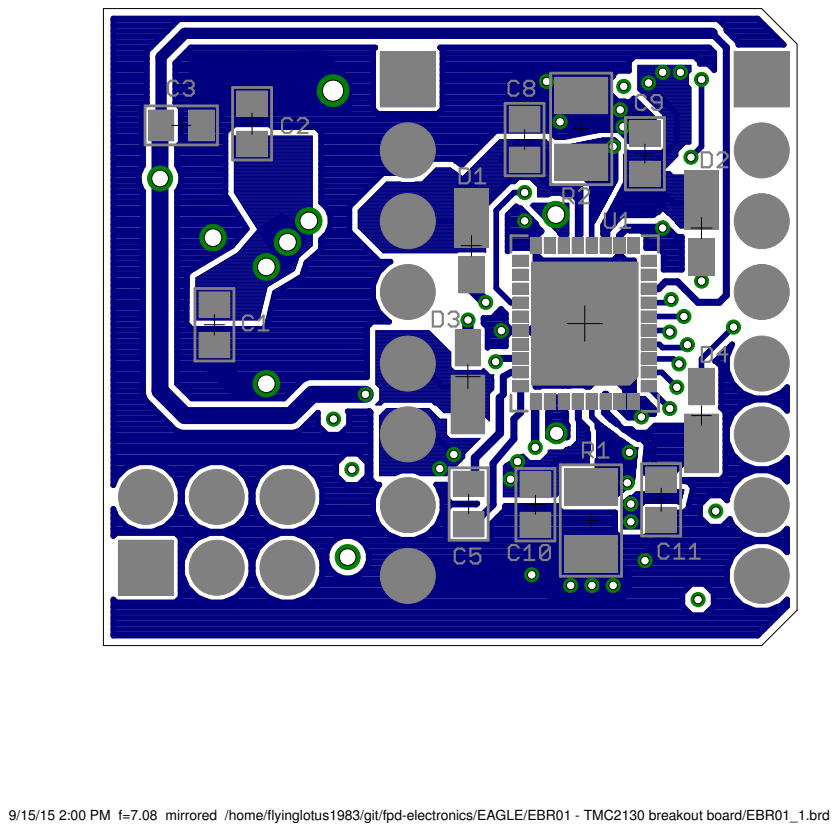
[picture p8: page 1]

9/15/15 2:00 PM f=7.08 mirrored /home/flyinglotus1983/git/fpd-electronics/EAGLE/EBR01 - TMC2130 breakout board/EBR01_1.brd
