firepick-delta/fpd-electronics/EAGLE/EBR01 - TMC2130 breakout board/EBR01_top.pdf

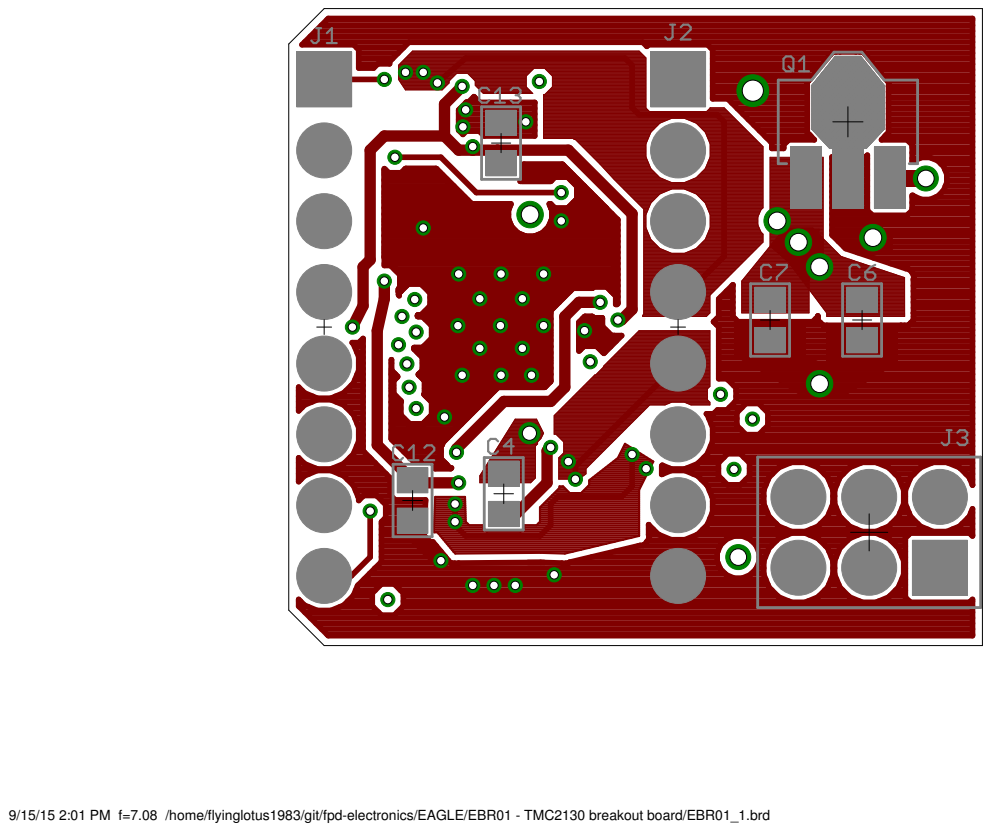
[picture p9: page 1]

9/15/15 2:01 PM f=7.08 /home/flyinglotus1983/git/fpd-electronics/EAGLE/EBR01 - TMC2130 breakout board/EBR01_1.brd
