firepick-delta/fpd-electronics/EAGLE/EBR01 - TMC2130 breakout board/EBR01_bot.pdf

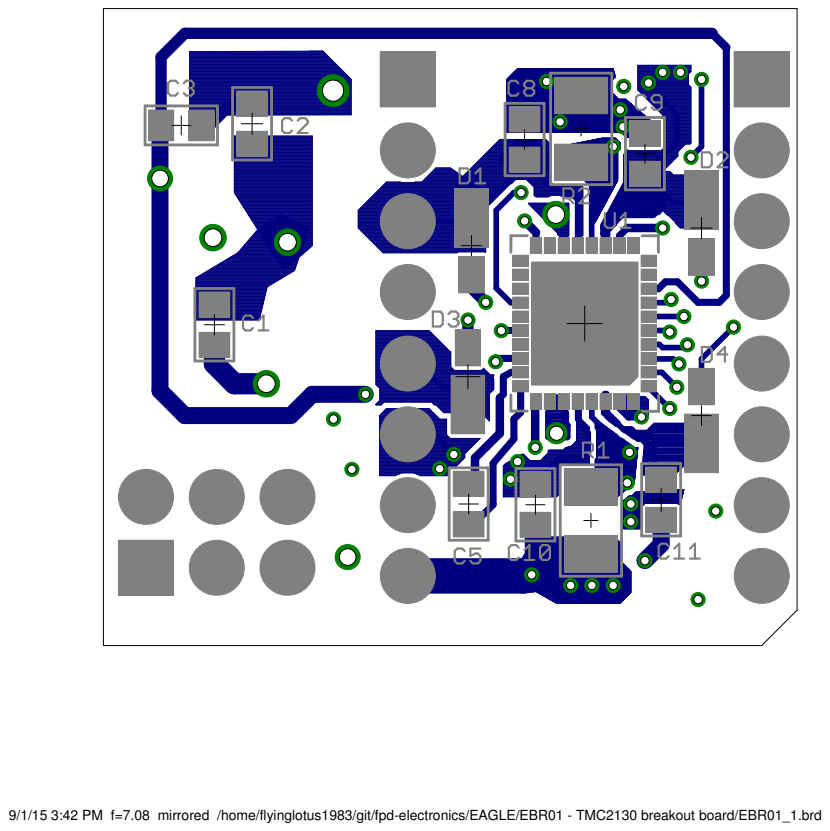
[picture p10: page 1]

9/1/15 3:42 PM f=7.08 mirrored /home/flyinglotus1983/git/fpd-electronics/EAGLE/EBR01 - TMC2130 breakout board/EBR01_1.brd
