firepick-delta/fpd-electronics/EAGLE/ETEST01 - 200mm x 200mm 0805s/ETEST01.pdf

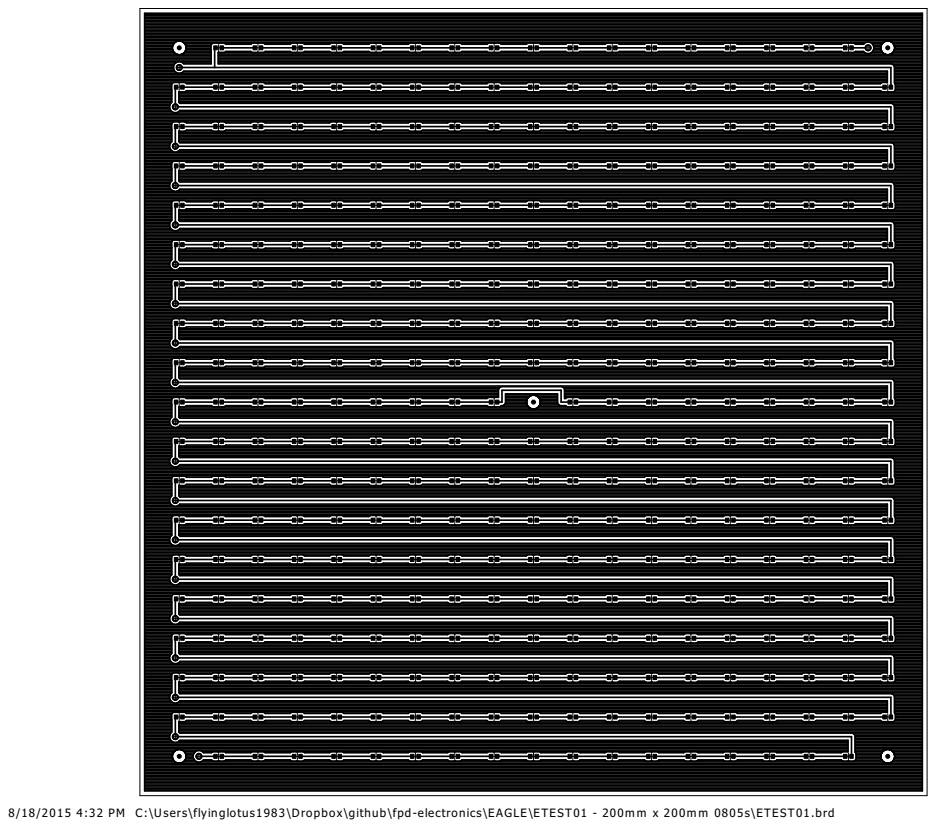
[picture p11: page 1]

8/18/2015 4:32 PM C:\Users\flyinglotus1983\Dropbox\github\fpd-electronics\EAGLE\ETEST01 - 200mm x 200mm 0805s\ETEST01.brd
