firepick-delta/fpd-electronics/EAGLE/ETEST01 - 200mm x 200mm 0805s/ETEST01-bot-copper.pdf

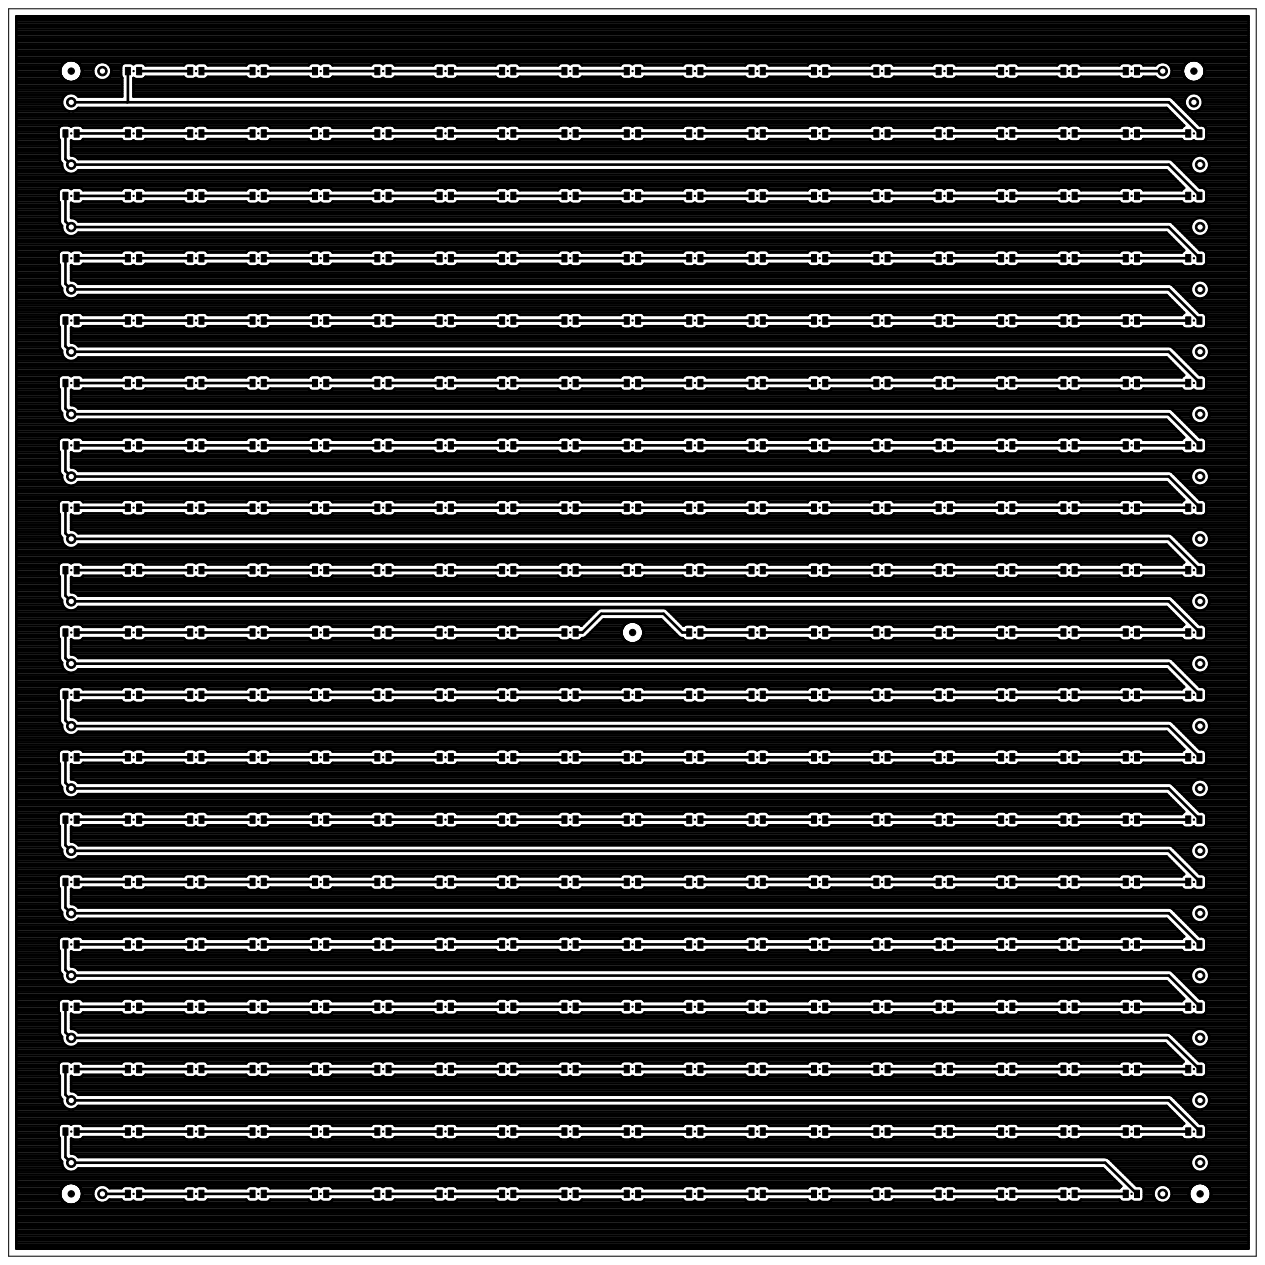
[picture p12: page 1]
