firepick-delta/fpd-electronics/EAGLE/ETEST01 - 200mm x 200mm 0805s/ETEST01-bot-silk.pdf

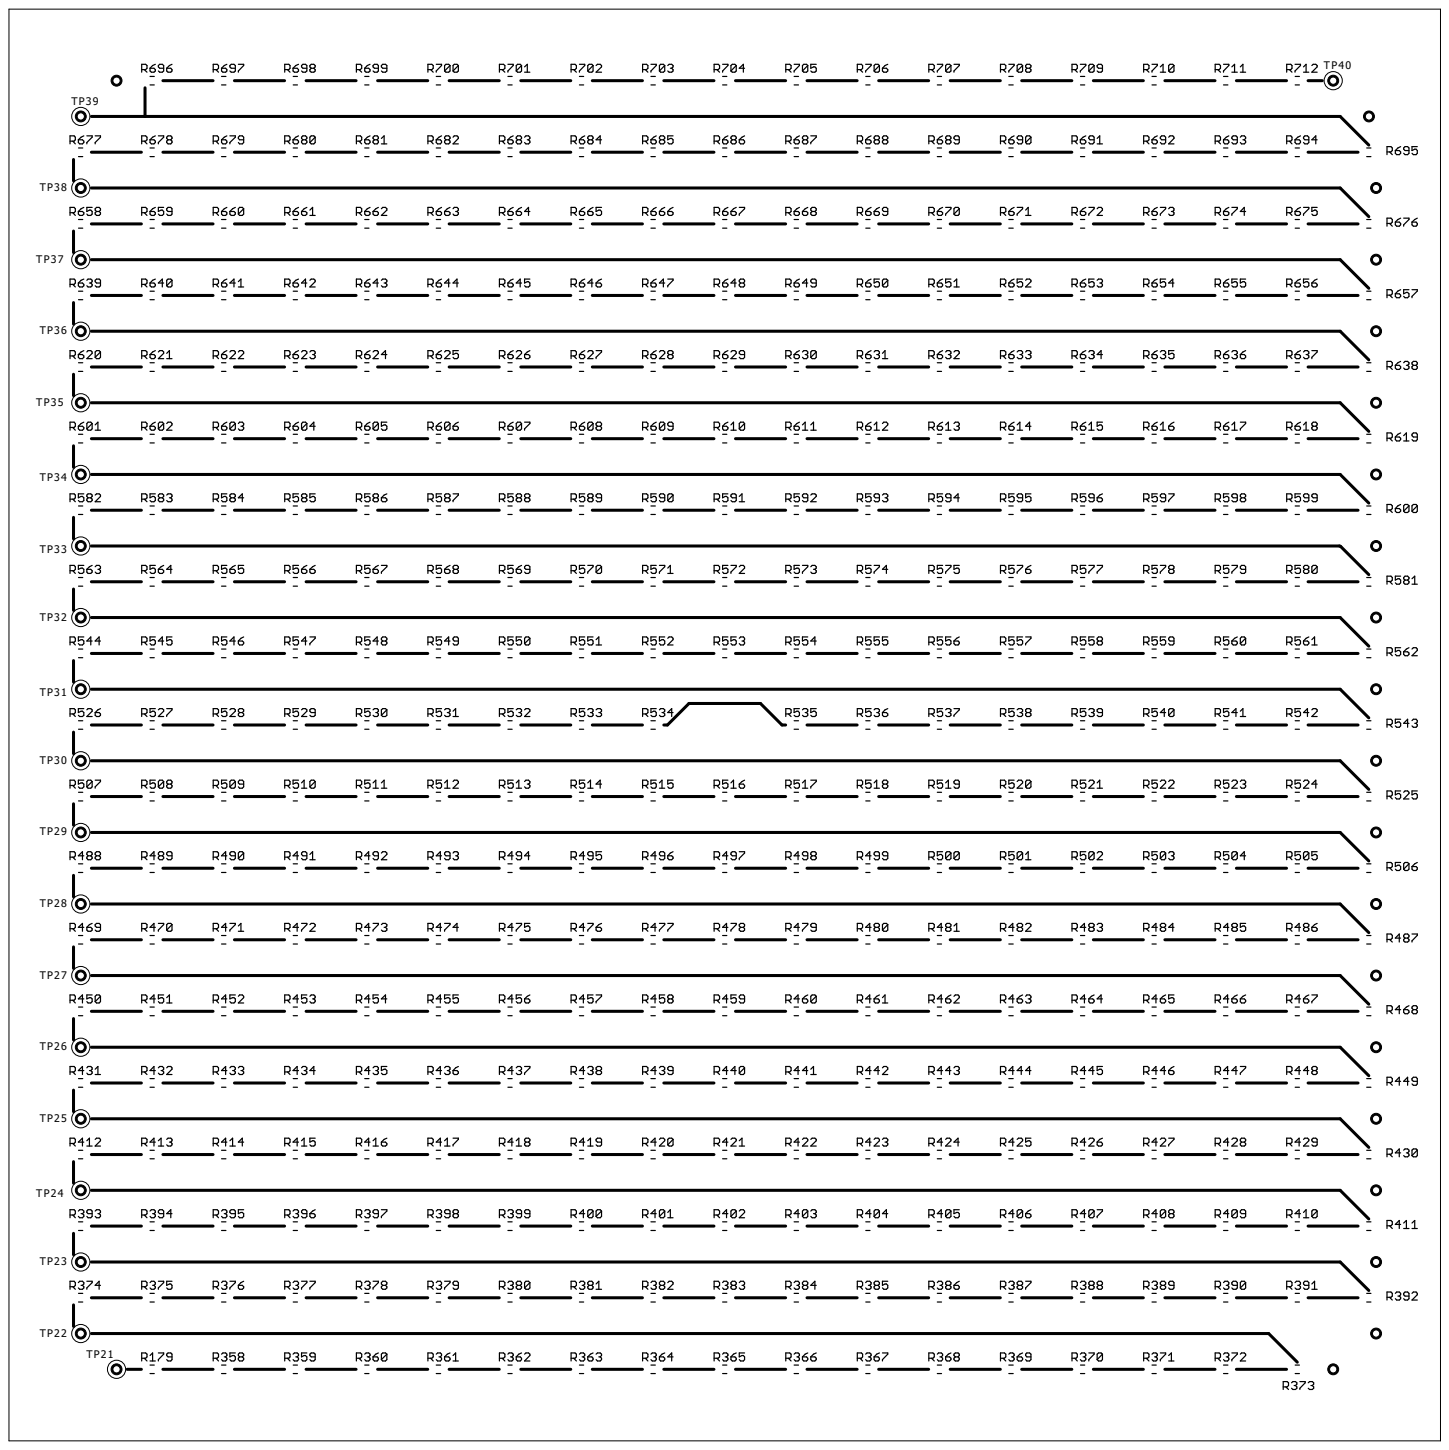
[picture p13: page 1]
