firepick-delta/fpd-electronics/EAGLE/ETEST01 - 200mm x 200mm 0805s/ETEST01-top-copper.pdf

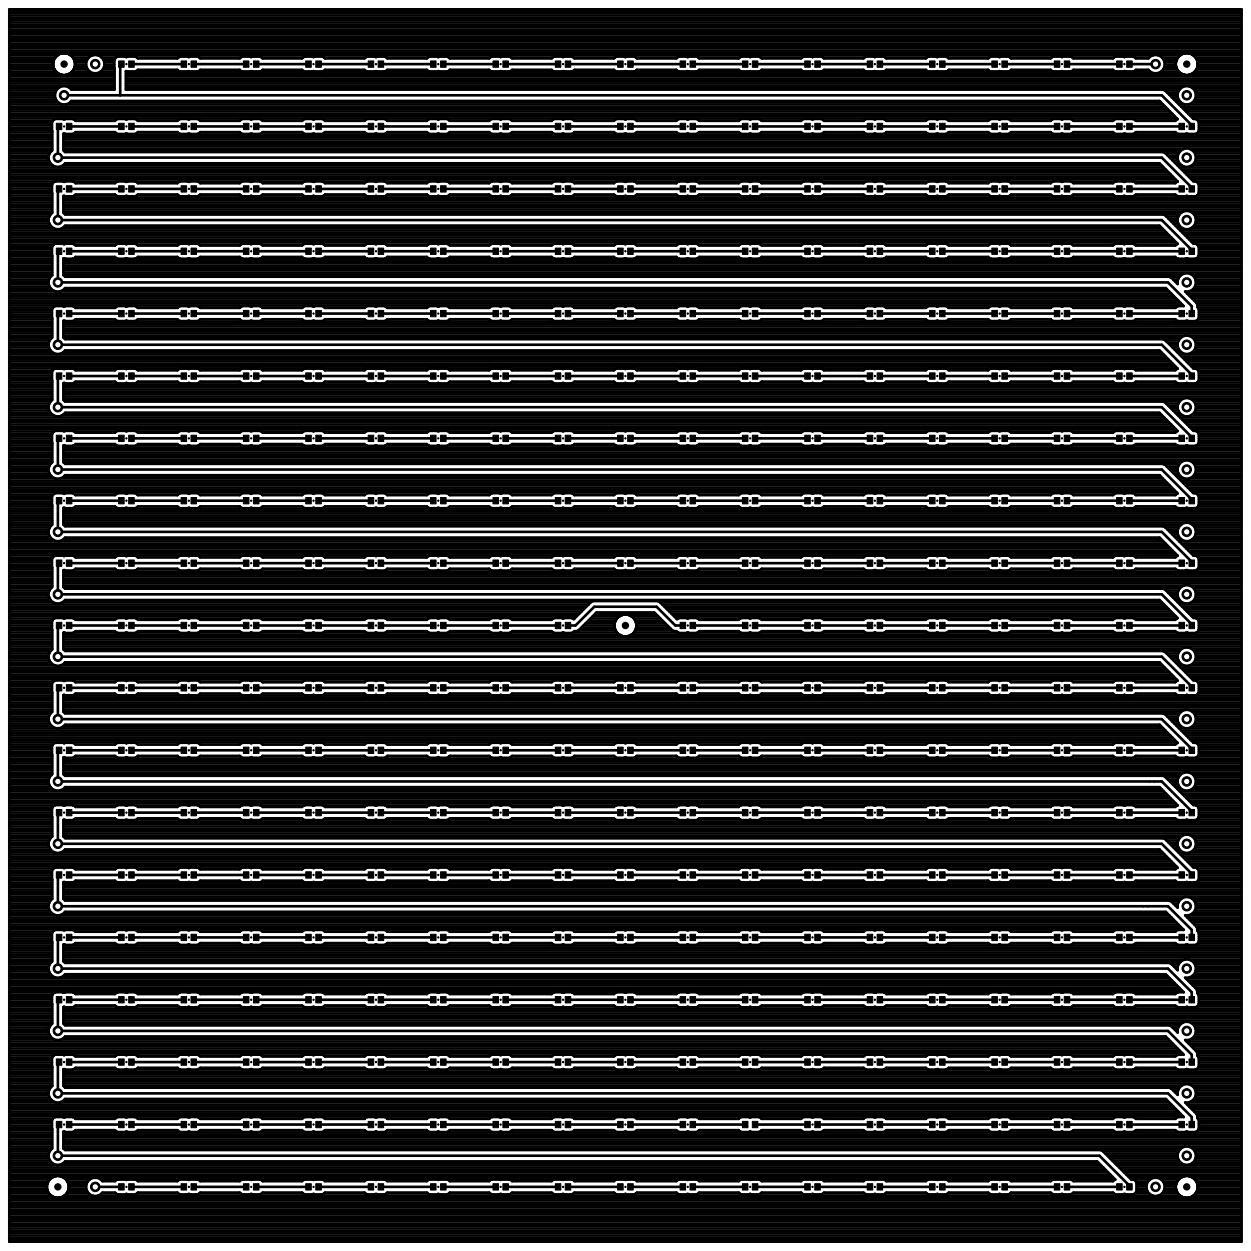
[picture p14: page 1]
