firepick-delta/fpd-electronics/EAGLE/ETEST01 - 200mm x 200mm 0805s/ETEST01-top-silk.pdf

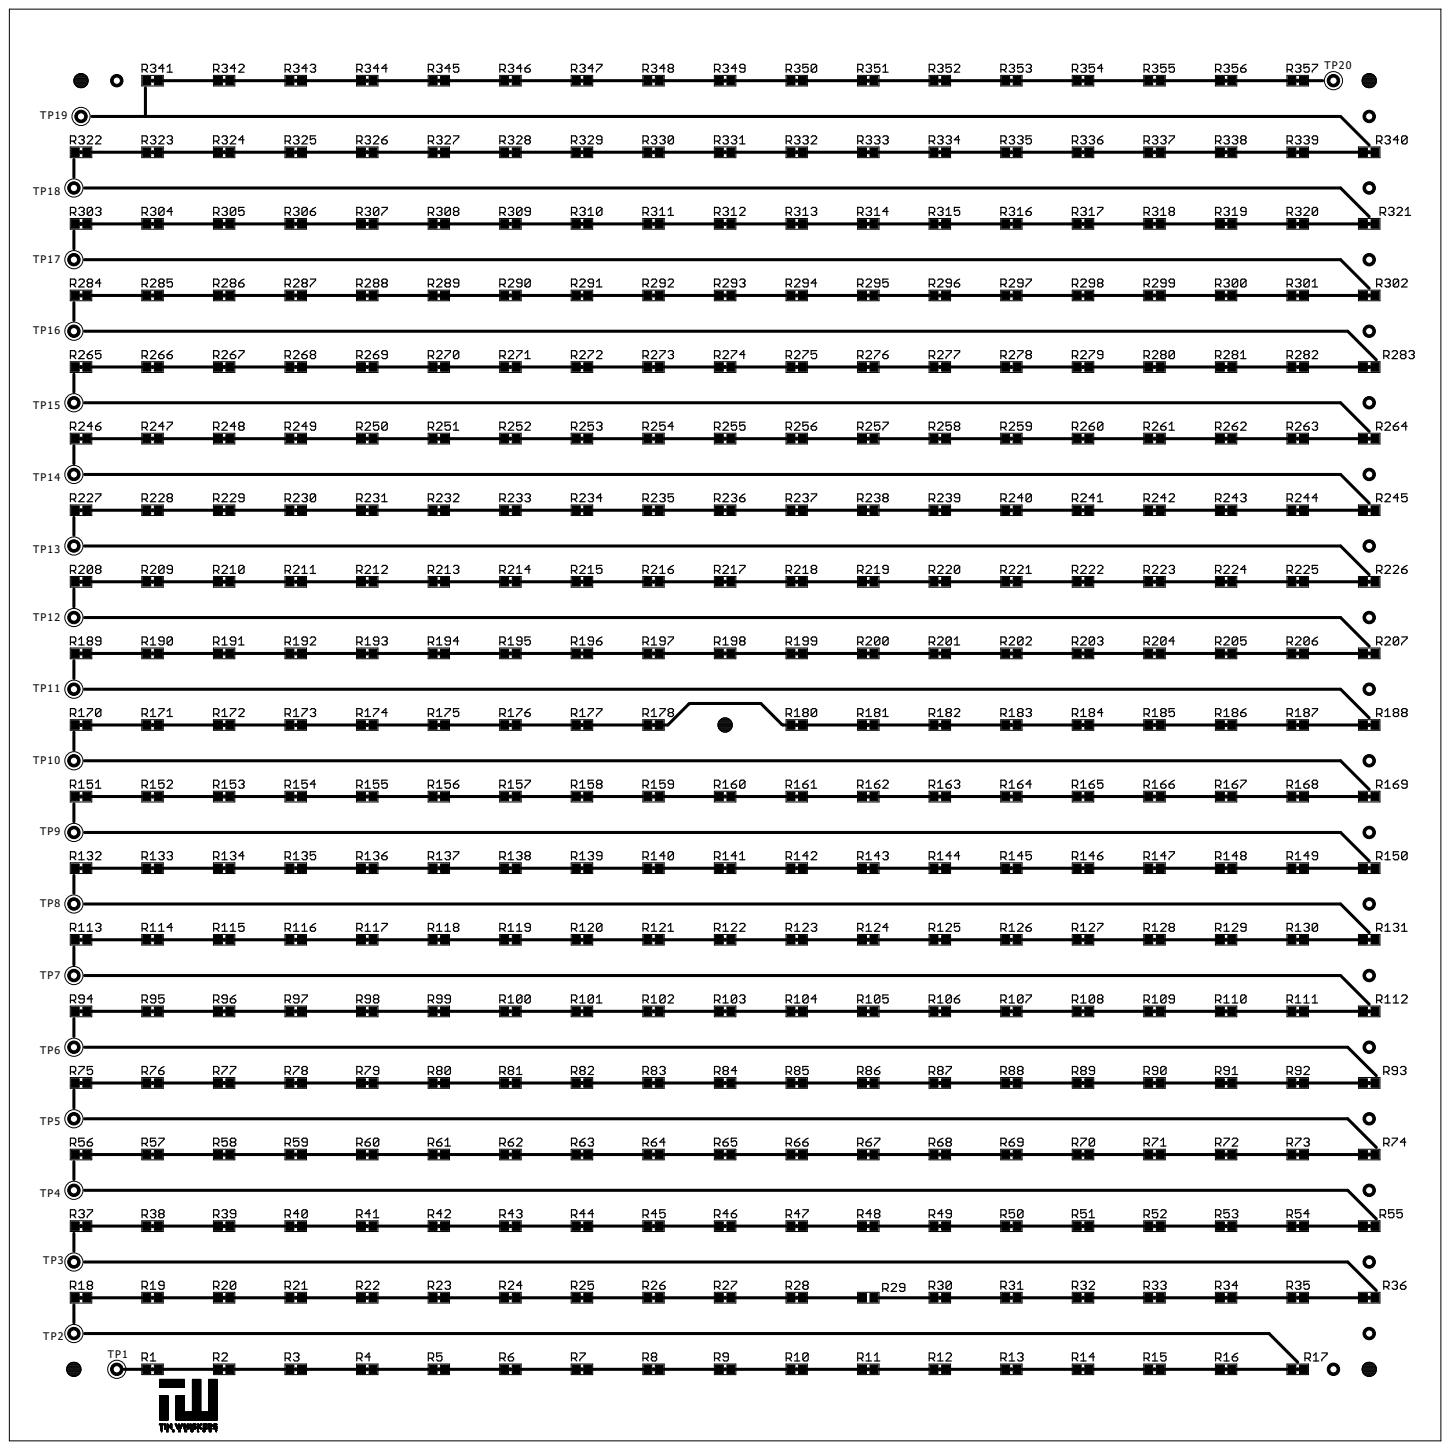
[picture p15: page 1]
