firepick-delta/fpd-electronics/EAGLE/ECAM02 - EE2.0/ECAM02-EE2.0.brd

## EAGLE design EAGLE/ECAM02 - EE2.0/ECAM02-EE2.0.brd (2015-10-23)

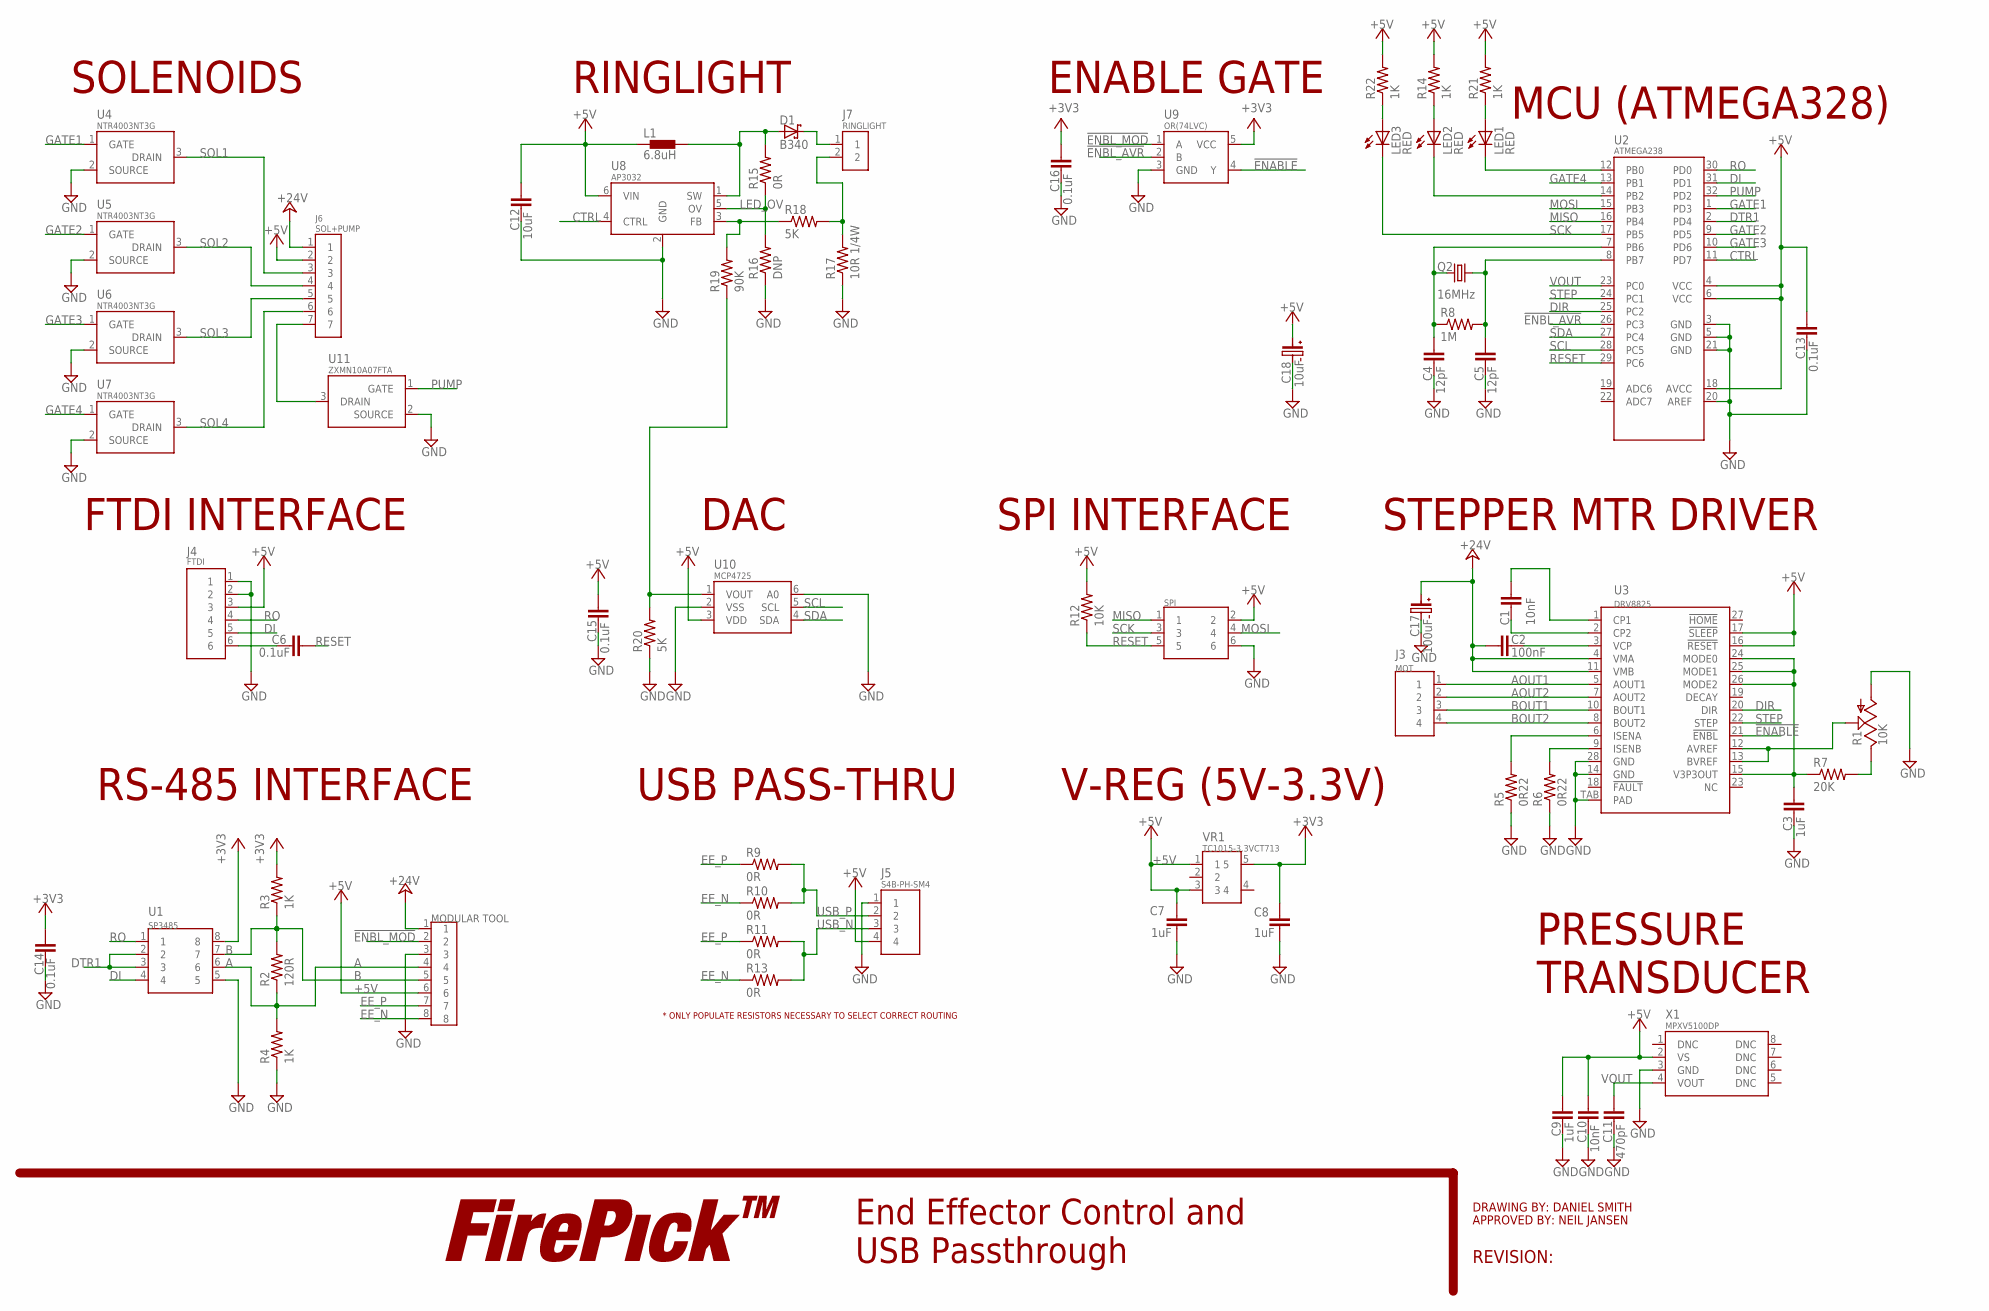
[picture p17: schematic ECAM02-EE2.0.sch]

Parts:
C1, C10: 10nF; C0603; PARTNO GRM188R71H103KA01D
C2: 100nF; C0603; PARTNO UMK107B7104KA-T
C3, C7, C8, C9: 1uF; C0603; PARTNO UMK107AB7105KA-T
C4, C5: 12pF; C0603; PARTNO GRM1885C1H120FA01J
C6: 0.1uF; C0603; PARTNO UMK107B7104KA-T
C11: 470pF; C0603; PARTNO GRM188R72A471KA01D
C12: 10uF; C0603; PARTNO GRM188R61C106MA73D
C13, C14, C15, C16: 0.1uF; C0603; PARTNO GMK107BJ104KAHT
C17: 100uF; C-SMD-6.3MM; PARTNO EMVA500ADA101MHA0G
C18: 10uF; C-SMD-6.3MM; PARTNO EMVH350ADA100MF60G
D1: B340; DIO-SMA; PARTNO B340A-13-F
J1: MODULAR TOOL; CON-JST-PH-2.0MM-8P-SMT-VRT; PARTNO B8B-PH-SM4-TB(LF)(SN)
J2: SPI; CON-HDR-2X3P; PARTNO 67996-206HLF
J3: MOT; CON-JST-PH-2.0MM-4P-THRU-VRT; PARTNO B4B-PH-K-S(LF)(SN)
J4: FTDI; CON-HDR-6POS-MALE; PARTNO S6B-PH-SM4-TB(LF)(SN)
J5: S4B-PH-SM4; CON-JST-PH-2.0MM-4P-SMT-VRT; PARTNO S4B-PH-SM4-TB(LF)(SN)
J6: SOL+PUMP; CON-JST-PH-2.0MM-7P-SMT-VRT; PARTNO B7B-PH-SM4-TB(LF)(SN)
J7: RINGLIGHT; CON-JST-PH-2.0MM-2P-SMT-VRT; PARTNO B2B-PH-SM4-TB(LF)(SN)
L1: 6.8uH; 0603; PARTNO BRL1608T6R8M
LED1, LED2, LED3: RED; LED0603
LOGO2: LOGO-FIREPICKLARGE; LOGO-FIREPICK
Q2: 16MHz; HC-49/U-S; PARTNO HCM4916000000ABJT
R1: 10K; TC33X-2; PARTNO TC33X-2-103E
R2: 120R; R0603; PARTNO RC0603FR-07120RL
R3, R4: 1K; R0603; PARTNO RC0603FR-071KL
R5, R6: 0R22; R1206; PARTNO RL1206FR-7W0R22L
R7: 20K; R0603; PARTNO RC0603FR-0722KL
R8: 1M; R0603; PARTNO RC0603FR-071ML
R9, R10, R11, R13, R15: 0R; R0603; PARTNO RC0603JR-070RL
R12: 10K; R0603; PARTNO RC0603FR-0710KL
R14, R21, R22: 1K; R0603
R16: DNP; R0603; PARTNO RC0603JR-070RL
R17: 10R 1/4W; R1206; PARTNO RC1206FR-0710RL
R18, R20: 5K; R0603; PARTNO PNM0603E5001BST5
R19: 90K; R0603; PARTNO RC0603FR-0790K9L
U1: SP3485; SOICN-8; PARTNO SP3485
U2: ATMEGA238; 32-TQF(ATMEGA); PARTNO ATMEGA328-AUR
U3: DRV8825; 28-HSSOP; PARTNO DRV8825PWPR
U4, U5, U6, U7: NTR4003NT3G; SOT-23-3; PARTNO NTR4003NT3G
U8: AP3032; SOT-23-6; PARTNO AP3032KTR-G1
U9: OR(74LVC); SOT-23-5; PARTNO SN74LVC1G32DBVR
U10: MCP4725; SOT-23-6; PARTNO MCP4725A0T-E/CH
U11: ZXMN10A07FTA; SOT-23-3; PARTNO ZXMN10A07FTA
VR1: TC1015-3.3VCT713; SOT-23-5; PARTNO TC1015-3.3VCT713
X1: MPXV5100DP; 8-SMD; PARTNO MPXV5100DP

Connections:
!ENABLE: U3.21 (!ENBL), U9.4 (Y)
!ENBL_AVR: U2.26 (PC3), U9.2 (B)
!ENBL_MOD: J1.2, U9.1 (A)
+3V3: C8.2, C14.2, C16.2, R3.2, U1.8, U9.5 (VCC), VR1.5
+5V: C7.2, C9.2, C10.2, C12.2, C13.2, C15.2, C18.POS, J1.6, J2.2, J4.3, J5.4, J6.2, L1.1, R12.2, R14.2, R21.2, R22.2, U2.4 (VCC), U2.6 (VCC), U2.18 (AVCC), U3.16 (!RESET), U3.17 (!SLEEP), U8.6 (VIN), U10.3 (VDD), VR1.1, VR1.3, X1.2 (VS)
+24V: C2.1, C17.POS, J1.1, J6.1, U3.4 (VMA), U3.11 (VMB)
A: J1.4, R2.1, R4.2, U1.6
AOUT1: J3.1, U3.5 (AOUT1)
AOUT2: J3.2, U3.7 (AOUT2)
B: J1.5, R2.2, R3.1, U1.7
BOUT1: J3.3, U3.10 (BOUT1)
BOUT2: J3.4, U3.8 (BOUT2)
CTRL: U2.11 (PD7), U8.4 (CTRL)
DI: J4.5, U1.4, U2.31 (PD1)
DIR: U2.25 (PC2), U3.20 (DIR)
DTR1: U1.2, U1.3, U2.2 (PD4)
EE_N: J1.8, R10.1, R13.1
EE_P: J1.7, R9.1, R11.1
GATE1: U2.1 (PD3), U4.1 (GATE)
GATE2: U2.9 (PD5), U5.1 (GATE)
GATE3: U2.10 (PD6), U6.1 (GATE)
GATE4: U2.13 (PB1), U7.1 (GATE)
GND: C3.1, C4.1, C5.1, C7.1, C8.1, C9.1, C10.1, C11.1, C12.1, C13.1, C14.1, C15.1, C16.1, C17.NEG, C18.NEG, J1.3, J2.6, J4.1, J4.2, J5.1, R1.1 (A), R4.1, R5.1, R6.1, R16.1, R17.1, R20.1, U1.5, U2.3 (GND), U2.5 (GND), U2.20 (AREF), U2.21 (GND), U3.14 (GND), U3.28 (GND), U3.TAB (PAD), U4.2 (SOURCE), U5.2 (SOURCE), U6.2 (SOURCE), U7.2 (SOURCE), U8.2 (GND), U9.3 (GND), U10.2 (VSS), U10.6 (A0), U11.2 (SOURCE), X1.3 (GND)
LED_ANODE: D1.NEG (C), J7.1
LED_CATHODE: J7.2, R17.2, R18.2
LED_FB: R18.1, R19.2, U8.3 (FB)
LED_OV: R15.1, R16.2, U8.5 (OV)
LED_SW: D1.POS (A), L1.2, R15.2, U8.1 (SW)
MISO: J2.1, U2.16 (PB4)
MOSI: J2.4, U2.15 (PB3)
unnamed: LED1.A, R21.1
unnamed: LED2.A, R14.1
unnamed: LED1.C, U2.12 (PB0)
unnamed: LED2.C, U2.14 (PB2)
unnamed: C1.2, U3.1 (CP1)
unnamed: C1.1, U3.2 (CP2)
unnamed: C2.2, U3.3 (VCP)
unnamed: R5.2, U3.6 (ISENA)
unnamed: R6.2, U3.9 (ISENB)
unnamed: R19.1, R20.2, U10.1 (VOUT)
unnamed: LED3.A, R22.1
unnamed: J6.7, U11.3 (DRAIN)
unnamed: C3.2, R7.1, U3.15 (V3P3OUT), U3.24 (MODE0), U3.25 (MODE1), U3.26 (MODE2)
unnamed: R1.3 (E), R7.2
unnamed: R1.2 (S), U3.12 (AVREF), U3.13 (BVREF)
unnamed: C6.1, J4.6
PUMP: U2.32 (PD2), U11.1 (GATE)
RESET: C6.2, J2.5, R12.1, U2.29 (PC6)
RO: J4.4, U1.1, U2.30 (PD0)
SCK: J2.3, LED3.C, U2.17 (PB5)
SCL: U2.28 (PC5), U10.5 (SCL)
SDA: U2.27 (PC4), U10.4 (SDA)
SOL1: J6.3, U4.3 (DRAIN)
SOL2: J6.4, U5.3 (DRAIN)
SOL3: J6.5, U6.3 (DRAIN)
SOL4: J6.6, U7.3 (DRAIN)
STEP: U2.24 (PC1), U3.22 (STEP)
USB_N: J5.3, R11.2, R13.2
USB_P: J5.2, R9.2, R10.2
VOUT: C11.2, U2.23 (PC0), X1.4 (VOUT)
XTAL1: C4.2, Q2.1, R8.1, U2.7 (PB6)
XTAL2: C5.2, Q2.2, R8.2, U2.8 (PB7)

Notes on the sheet:
End Effector Control and USB Passthrough
DRAWING BY: DANIEL SMITH
APPROVED BY: NEIL JANSEN
REVISION:
RS-485 INTERFACE
MCU (ATMEGA328)
V-REG (5V-3.3V)
FTDI INTERFACE
STEPPER MTR DRIVER
USB PASS-THRU
* ONLY POPULATE RESISTORS NECESSARY TO SELECT CORRECT ROUTING
PRESSURE TRANSDUCER
SOLENOIDS
RINGLIGHT
ENABLE GATE
DAC
SPI INTERFACE
SPI

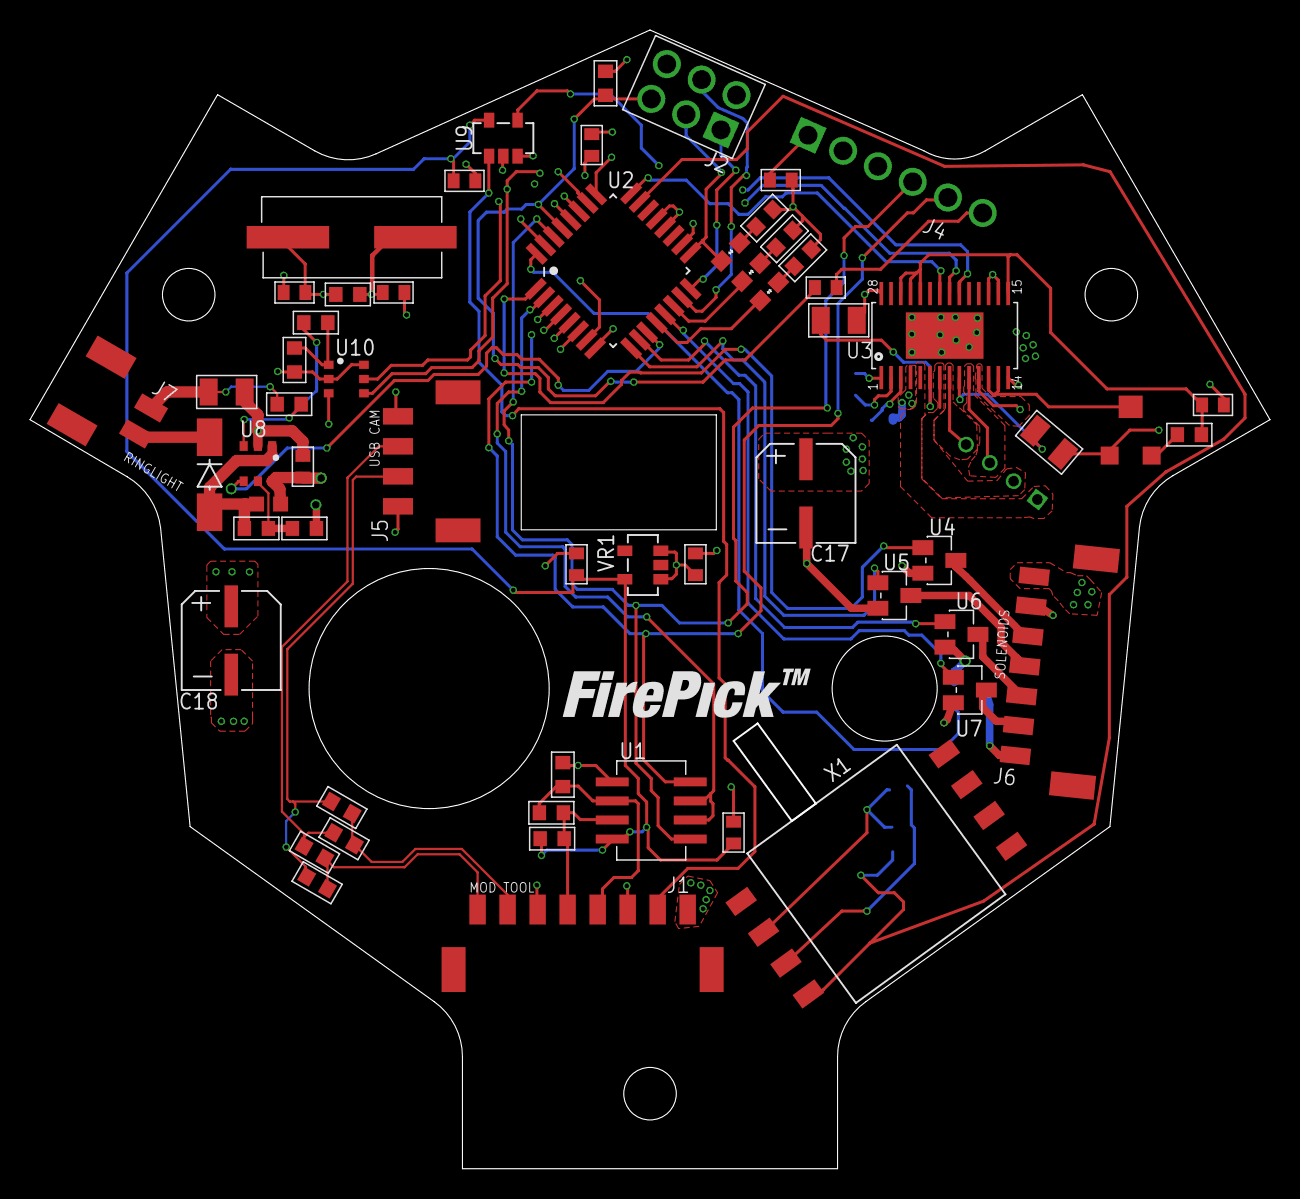
[picture p18: board ECAM02-EE2.0.brd from above]

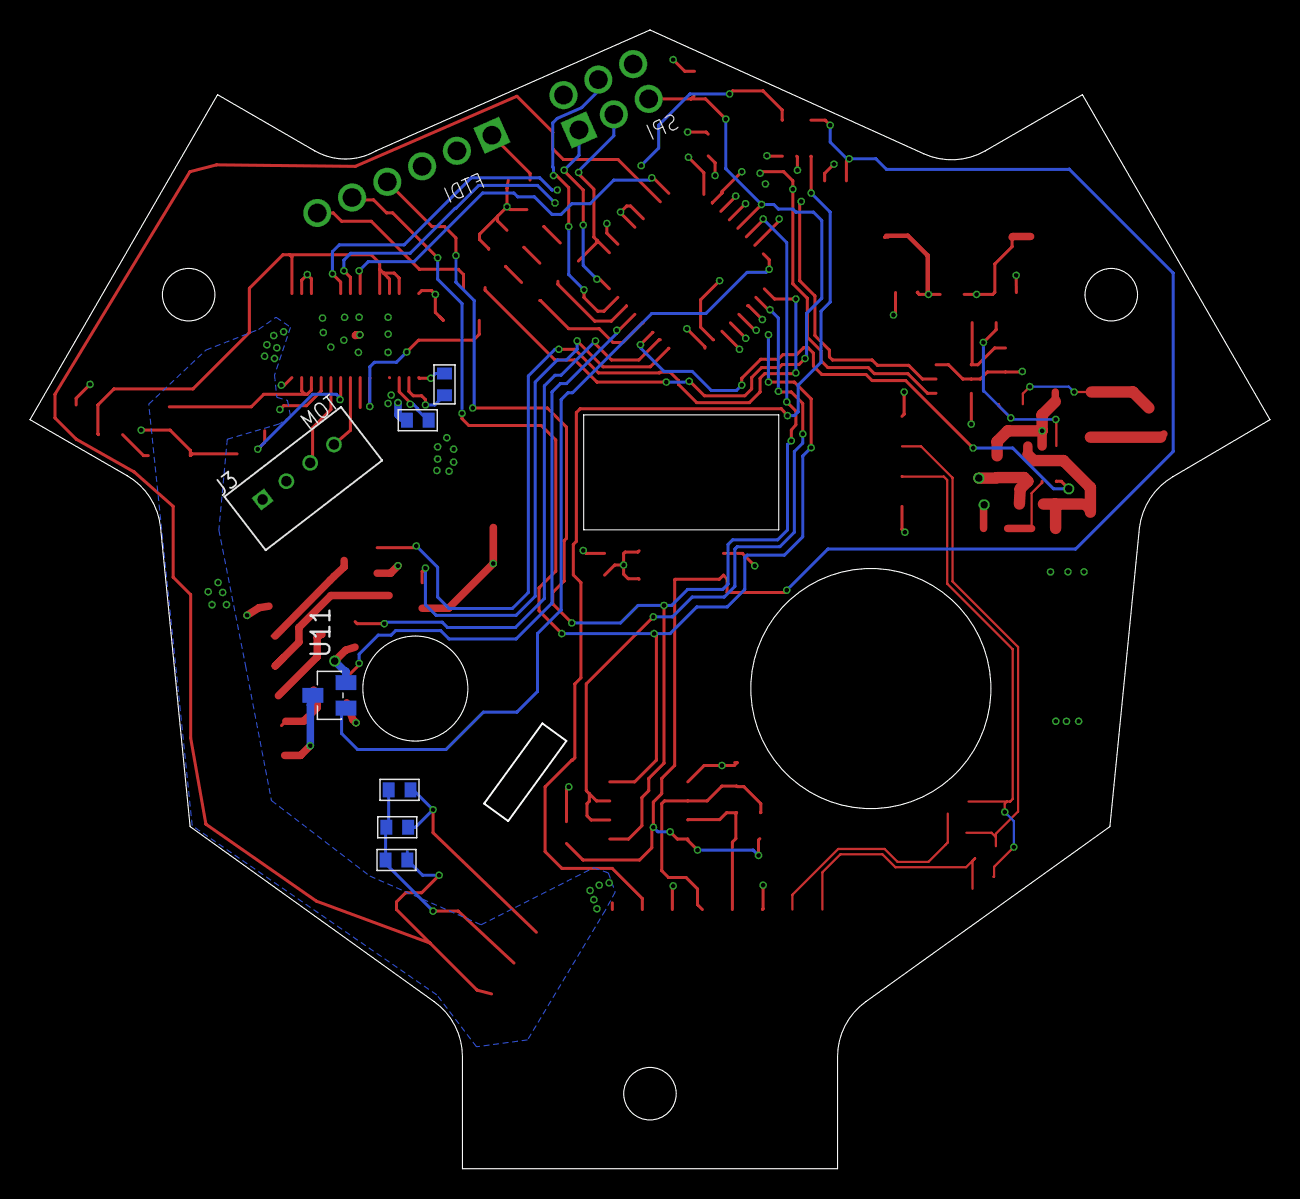
[picture p19: board ECAM02-EE2.0.brd from below]

Board: 4 copper layers, 82.6 x 75.9 mm, 67 parts (7 on the bottom side), 62 nets.
