firepick-delta/fpd-electronics/EAGLE/EFP01 - Front Panel Board/EFP01 - Front Panel Board.brd

## EAGLE design EAGLE/EFP01 - Front Panel Board/EFP01 - Front Panel Board.brd (2015-10-21)

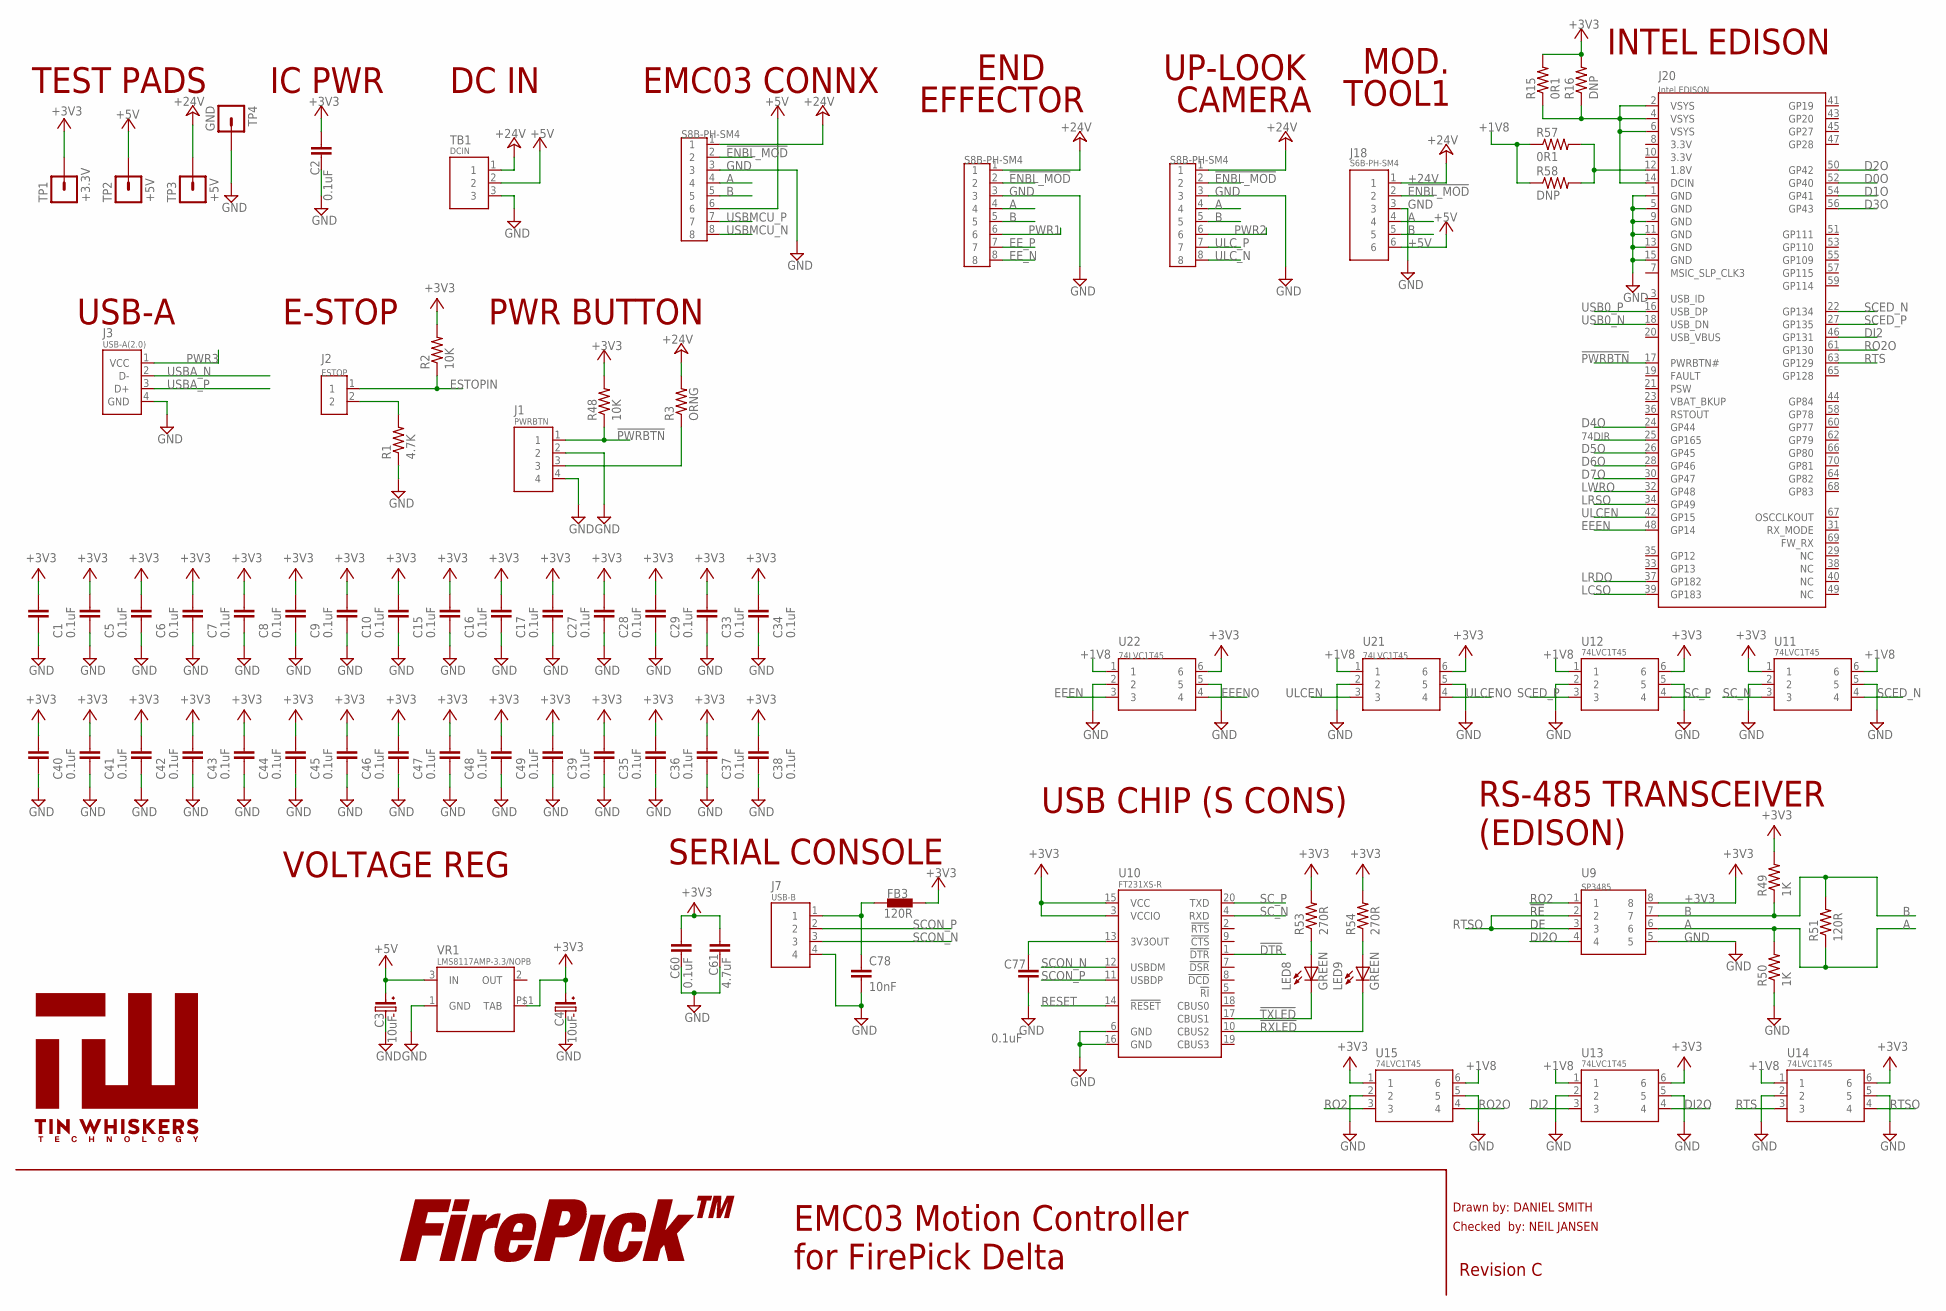
[picture p20: schematic EFP01 - Front Panel Board.sch, sheet 1, MCU]

Parts:
C1, C2, C5, C6, C7, C8, C9, C10, C15, C16, C17, C27, C28, C29, C33, C34, C35, C36, C37, C38, C39, C40, C41, C42, C43, C44, C45, C46, C47, C48, C49, C60, C77: 0.1uF; C0603; PARTNO GMK107BJ104KAHT
C3, C4: 10uF; C-SMD-6.3MM; PARTNO EMVH350ADA100MF60G
C61: 4.7uF; C0603; PARTNO GRM188C81E475KE11D
C78: 10nF; C0603; PARTNO GRM188R71H103KA01D
FB3: 120R; F0603; PARTNO BLM18AG121SN1D
J1: PWRBTN; CON-JST-PH-2.0MM-4P-SMT-VRT; PARTNO S4B-PH-SM4-TB(LF)(SN)
J2: ESTOP; CON-JST-PH-2.0MM-2P-SMT-VRT; PARTNO S2B-PH-SM4-TB(LF)(SN)
J3: USB-A(2.0); USB-A-THRU-VERT-2.0; PARTNO 1734085-1
J6, J16, J17: S8B-PH-SM4; CON-JST-PH-2.0MM-8P-SMT-VRT; PARTNO B8B-PH-SM4-TB(LF)(SN)
J7: USB-B; USB-B(SMT)-VERT-1734517; PARTNO 1734517-1
J18: S6B-PH-SM4; CON-JST-PH-2.00MM-6P-SMT-VRT; PARTNO B6B-PH-SM4-TB(LF)(SN)
J20: Intel EDISON; DF40HC(3.0)-70DS-0.4V(51); PARTNO DF40HC(3.0)-70DS-0.4V(51)
LED8, LED9: GREEN; LED0603; PARTNO SML-D12M8WT86
LOGO1: LOGO-FIREPICKLARGE; LOGO-FIREPICK
R1: 4.7K; R0603; PARTNO RC0603FR-074K7L
R2, R48: 10K; R0603; PARTNO RC0603FR-0710KL
R3: ORNG; R0603; PARTNO RC0603JR-070RL
R15, R57: 0R1; R0603; PARTNO RL0603FR-070R1L
R16, R58: DNP; R0603; PARTNO RC0603JR-070RL
R49, R50: 1K; R0603; PARTNO RC0603FR-071KL
R51: 120R; R0603; PARTNO RC0603FR-07120RL
R53, R54: 270R; R0603; PARTNO RC0603FR-07270RL
TB1: DCIN; TBLOCK-3-5MM-OSTTH030160; PARTNO OSTTH030160
TP1: +3.3V; TESTPAD; PARTNO N/A
TP2, TP3: +5V; TESTPAD; PARTNO N/A
TP4: GND; TESTPAD; PARTNO N/A
U9: SP3485; SOICN-8; PARTNO SP3485
U10: FT231XS-R; 20-SSOP; PARTNO FT231XS-R
U11, U12, U13, U14, U15, U21, U22: 74LVC1T45; SOT-363; PARTNO 74LVC1T45GW,125
U$1: TIN-WHISKERSTSTOP; TIN-WHISKERS-TSTOP; PARTNO *
VR1: LMS8117AMP-3.3/NOPB; SOT-223; PARTNO LMS8117AMP-3.3/NOPB

Connections:
74DIR: J20.25 (GP165); also elsewhere on the board
!DTR: U10.1 (!DTR)
!ENBL_MOD: J6.2, J16.2, J17.2, J18.2
!PWRBTN: J1.1, J20.17 (PWRBTN#), R48.1
!RXLED: LED9.C, U10.10 (CBUS2)
!TXLED: LED8.C, U10.17 (CBUS1)
+1V8: R57.1, R58.1, U11.6, U12.1, U13.1, U14.1, U15.6, U21.1, U22.1; also elsewhere on the board
+3V3: C1.2, C2.2, C4.POS, C5.2, C6.2, C7.2, C8.2, C9.2, C10.2, C15.2, C16.2, C17.2, C27.2, C28.2, C29.2, C33.2, C34.2, C35.2, C36.2, C37.2, C38.2, C39.2, C40.2, C41.2, C42.2, C43.2, C44.2, C45.2, C46.2, C47.2, C48.2, C49.2, C60.2, C61.2, FB3.2, R2.2, R15.2, R16.2, R48.2, R49.2, R53.2, R54.2, TP1.PAD, U9.8, U10.3 (VCCIO), U10.15 (VCC), U11.1, U12.6, U13.6, U14.6, U15.1, U21.6, U22.6, VR1.P$1 (TAB); also elsewhere on the board
+5V: C3.POS, J6.6, J18.6, TB1.2, TP2.PAD, VR1.3 (IN); also elsewhere on the board
+24V: J6.1, J16.1, J17.1, J18.1, R3.2, TB1.1, TP3.PAD
A: J6.4, J16.4, J17.4, J18.4, R50.2, R51.1, U9.6
B: J6.5, J16.5, J17.5, J18.5, R49.1, R51.2, U9.7
D0O: J20.52 (GP40); also elsewhere on the board
D1O: J20.54 (GP41); also elsewhere on the board
D2O: J20.50 (GP42); also elsewhere on the board
D3O: J20.56 (GP43); also elsewhere on the board
D4O: J20.24 (GP44); also elsewhere on the board
D5O: J20.26 (GP45); also elsewhere on the board
D6O: J20.28 (GP46); also elsewhere on the board
D7O: J20.30 (GP47); also elsewhere on the board
DI2: J20.46 (GP131), U13.3
DI2O: U9.4, U13.4
EEEN: J20.48 (GP14), U22.3
EEENO: U22.4; also elsewhere on the board
EE_N: J16.8; also elsewhere on the board
EE_P: J16.7; also elsewhere on the board
ESTOPIN: J2.1, R2.1
GND: C1.1, C2.1, C3.NEG, C4.NEG, C5.1, C6.1, C7.1, C8.1, C9.1, C10.1, C15.1, C16.1, C17.1, C27.1, C28.1, C29.1, C33.1, C34.1, C35.1, C36.1, C37.1, C38.1, C39.1, C40.1, C41.1, C42.1, C43.1, C44.1, C45.1, C46.1, C47.1, C48.1, C49.1, C60.1, C61.1, C77.1, C78.1, J1.2, J1.4, J3.4 (GND), J6.3, J7.4, J16.3, J17.3, J18.3, J20.1 (GND), J20.5 (GND), J20.9 (GND), J20.11 (GND), J20.13 (GND), J20.15 (GND), R1.1, R50.1, TB1.3, TP4.PAD, U9.5, U10.6 (GND), U10.16 (GND), U11.2, U11.5, U12.2, U12.5, U13.2, U13.5, U14.2, U14.5, U15.2, U15.5, U21.2, U21.5, U22.2, U22.5, VR1.1 (GND); also elsewhere on the board
LCSO: J20.39 (GP183); also elsewhere on the board
LRDO: J20.37 (GP182); also elsewhere on the board
LRSO: J20.34 (GP49); also elsewhere on the board
LWRO: J20.32 (GP48); also elsewhere on the board
unnamed: C77.2, U10.13 (3V3OUT)
unnamed: C78.2, FB3.1, J7.1
unnamed: J1.3, R3.1
unnamed: J2.2, R1.2
unnamed: LED9.A, R54.1
unnamed: LED8.A, R53.1
unnamed: J20.12 (1.8V), R57.2, R58.2
unnamed: J20.2 (VSYS), J20.4 (VSYS), J20.6 (VSYS), J20.14 (DCIN), R15.1, R16.1
PWR1: J16.6; also elsewhere on the board
PWR2: J17.6; also elsewhere on the board
PWR3: J3.1 (VCC); also elsewhere on the board
RESET: U10.14 (!RESET)
RO2: U9.1, U15.3
RO2O: J20.61 (GP130), U15.4
RTS: J20.63 (GP129), U14.3
RTSO: U9.2, U9.3, U14.4
SCED_N: J20.22 (GP134), U11.4
SCED_P: J20.27 (GP135), U12.3
SCON_N: J7.3, U10.12 (USBDM)
SCON_P: J7.2, U10.11 (USBDP)
SC_N: U10.4 (RXD), U11.3
SC_P: U10.20 (TXD), U12.4
ULCEN: J20.42 (GP15), U21.3
ULCENO: U21.4; also elsewhere on the board
ULC_N: J17.8; also elsewhere on the board
ULC_P: J17.7; also elsewhere on the board
USB0_N: J20.18 (USB_DN); also elsewhere on the board
USB0_P: J20.16 (USB_DP); also elsewhere on the board
USBA_N: J3.2 (D-); also elsewhere on the board
USBA_P: J3.3 (D+); also elsewhere on the board
USBMCU_N: J6.8; also elsewhere on the board
USBMCU_P: J6.7; also elsewhere on the board

Notes on the sheet:
Drawn by: DANIEL SMITH
Checked by: NEIL JANSEN
Revision C
EMC03 Motion Controller for FirePick Delta
!RE
RS-485 TRANSCEIVER
(EDISON)
PWR BUTTON
SERIAL CONSOLE
INTEL EDISON
USB CHIP (S CONS)
E-STOP
TEST PADS
IC PWR
END
EFFECTOR
MOD.
TOOL1
UP-LOOK
CAMERA
DC IN
USB-A
EMC03 CONNX
VOLTAGE REG

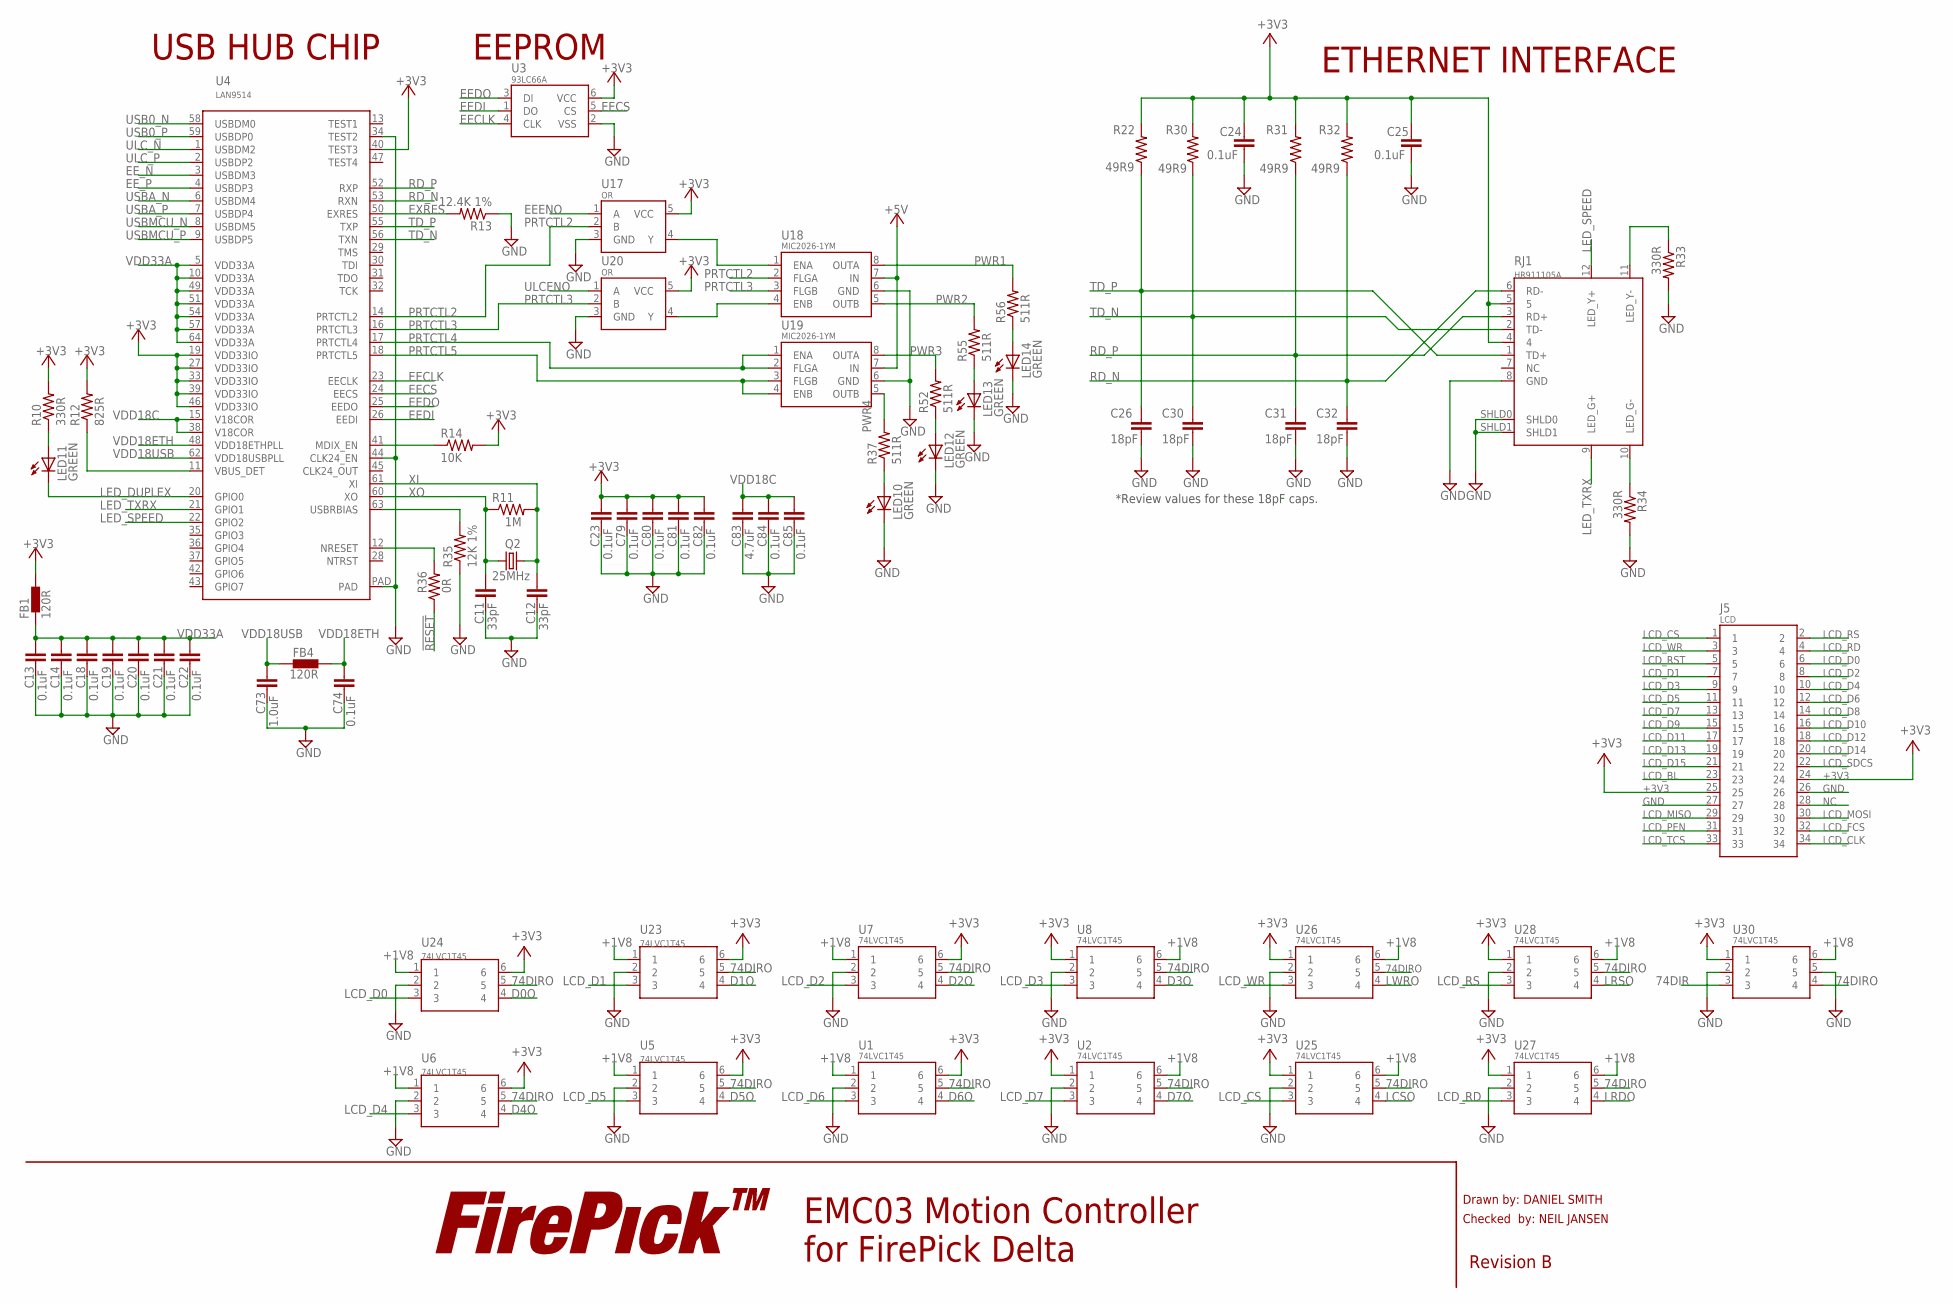
[picture p21: schematic EFP01 - Front Panel Board.sch, sheet 2, Peripherals]

Parts:
C11, C12: 33pF; C0603; PARTNO C0603C330K5GACTU
C13, C14, C18, C19, C20, C21, C22, C23, C24, C25, C74, C79, C80, C81, C82, C84, C85: 0.1uF; C0603; PARTNO GMK107BJ104KAHT
C26, C30, C31, C32: 18pF; C0603; PARTNO GCM1885C1H180JA16D
C73: 1.0uF; C0603; PARTNO UMK107AB7105KA-T
C83: 4.7uF; C0603; PARTNO GRM188C81E475KE11D
FB1, FB4: 120R; F0603; PARTNO BLM18AG121SN1D
J5: LCD; LCD-34P-3.2IN; PARTNO TSW-117-07-T-D
LED10, LED11, LED12, LED13, LED14: GREEN; LED0603; PARTNO SML-D12M8WT86
LOGO2: LOGO-FIREPICKLARGE; LOGO-FIREPICK
Q2: 25MHz; HC-49/U-S; PARTNO HCM4925000000MABJ
R10, R33, R34: 330R; R0603; PARTNO RC0603FR-07330RL
R11: 1M; R0603; PARTNO RC0603FR-071ML
R12: 825R; R0603; PARTNO RC0603FR-07825RL
R13: 12.4K 1%; R0603; PARTNO RC0603FR-0712K4L
R14: 10K; R0603; PARTNO RC0603FR-0710KL
R22, R30, R31, R32: 49R9; R0603; PARTNO RC0603FR-0749R9L
R35: 12K 1%; R0603; PARTNO RC0603FR-0712KL
R36: 0R; R0603; PARTNO RC0603JR-070RL
R37, R52, R55, R56: 511R; R0603; PARTNO RC0603FR-07511RL
RJ1: HR911105A; MAGJACK(HR911105A); PARTNO HR911105A
U1, U2, U5, U6, U7, U8, U23, U24, U25, U26, U27, U28, U30: 74LVC1T45; SOT-363; PARTNO 74LVC1T45GW,125
U3: 93LC66A; SOT-23-6; PARTNO 93LC66A-I/SN
U4: LAN9514; 64-QFN; PARTNO LAN9514-JZX
U17, U20: OR; SOT-23-5; PARTNO SN74LVC1G32DBVR
U18, U19: MIC2026-1YM; SOIC-8; PARTNO MIC2026-1YM

Connections:
74DIR: U30.3; also elsewhere on the board
74DIRO: U1.5, U2.5, U5.5, U6.5, U7.5, U8.5, U23.5, U24.5, U25.5, U26.5, U27.5, U28.5, U30.4
!RESET: R36.1
+1V8: U1.1, U2.6, U5.1, U6.1, U7.1, U8.6, U23.1, U24.1, U25.6, U26.6, U27.6, U28.6, U30.6; also elsewhere on the board
+3V3: C23.2, C24.2, C25.2, C79.2, C80.2, C81.2, C82.2, FB1.2, J5.24, J5.25, R10.2, R12.2, R14.2, R22.2, R30.2, R31.2, R32.2, RJ1.4, RJ1.5, U1.6, U2.1, U3.6 (VCC), U4.19 (VDD33IO), U4.27 (VDD33IO), U4.33 (VDD33IO), U4.39 (VDD33IO), U4.40 (TEST3), U4.46 (VDD33IO), U5.6, U6.6, U7.6, U8.1, U17.5 (VCC), U20.5 (VCC), U23.6, U24.6, U25.1, U26.1, U27.1, U28.1, U30.1; also elsewhere on the board
+5V: U18.7 (IN), U19.7 (IN); also elsewhere on the board
D0O: U24.4; also elsewhere on the board
D1O: U23.4; also elsewhere on the board
D2O: U7.4; also elsewhere on the board
D3O: U8.4; also elsewhere on the board
D4O: U6.4; also elsewhere on the board
D5O: U5.4; also elsewhere on the board
D6O: U1.4; also elsewhere on the board
D7O: U2.4; also elsewhere on the board
EECLK: U3.4 (CLK), U4.23 (EECLK)
EECS: U3.5 (CS), U4.24 (EECS)
EEDI: U3.1 (DO), U4.26 (EEDI)
EEDO: U3.3 (DI), U4.25 (EEDO)
EEENO: U17.1 (A); also elsewhere on the board
EE_N: U4.3 (USBDM3); also elsewhere on the board
EE_P: U4.4 (USBDP3); also elsewhere on the board
EXRES: R13.2, U4.50 (EXRES)
GND: C11.1, C12.1, C13.1, C14.1, C18.1, C19.1, C20.1, C21.1, C22.1, C23.1, C24.1, C25.1, C26.1, C30.1, C31.1, C32.1, C73.1, C74.1, C79.1, C80.1, C81.1, C82.1, C83.1, C84.1, C85.1, J5.26, J5.27, LED10.C, LED12.C, LED13.C, LED14.C, R13.1, R33.2, R34.2, R35.1, RJ1.8 (GND), RJ1.SHLD0, RJ1.SHLD1, U1.2, U2.2, U3.2 (VSS), U4.34 (TEST2), U4.44 (CLK24_EN), U4.PAD, U5.2, U6.2, U7.2, U8.2, U17.3 (GND), U18.6 (GND), U19.6 (GND), U20.3 (GND), U23.2, U24.2, U25.2, U26.2, U27.2, U28.2, U30.2, U30.5; also elsewhere on the board
LCD_BL: J5.23
LCD_CLK: J5.34
LCD_CS: J5.1, U25.3
LCD_D0: J5.6, U24.3
LCD_D1: J5.7, U23.3
LCD_D2: J5.8, U7.3
LCD_D3: J5.9, U8.3
LCD_D4: J5.10, U6.3
LCD_D5: J5.11, U5.3
LCD_D6: J5.12, U1.3
LCD_D7: J5.13, U2.3
LCD_D8: J5.14
LCD_D9: J5.15
LCD_D10: J5.16
LCD_D11: J5.17
LCD_D12: J5.18
LCD_D13: J5.19
LCD_D14: J5.20
LCD_D15: J5.21
LCD_FCS: J5.32
LCD_MISO: J5.29
LCD_MOSI: J5.30
LCD_PEN: J5.31
LCD_RD: J5.4, U27.3
LCD_RS: J5.2, U28.3
LCD_RST: J5.5
LCD_SDCS: J5.22
LCD_TCS: J5.33
LCD_WR: J5.3, U26.3
LCSO: U25.4; also elsewhere on the board
LED_DUPLEX: LED11.C, U4.20 (GPIO0)
LED_SPEED: RJ1.12 (LED_Y+), U4.22 (GPIO2)
LED_TXRX: RJ1.9 (LED_G+), U4.21 (GPIO1)
LRDO: U27.4; also elsewhere on the board
LRSO: U28.4; also elsewhere on the board
LWRO: U26.4; also elsewhere on the board
unnamed: LED11.A, R10.1
unnamed: R12.1, U4.11 (VBUS_DET)
unnamed: R33.1, RJ1.11 (LED_Y-)
unnamed: R34.1, RJ1.10 (LED_G-)
unnamed: R36.2, U4.12 (NRESET)
unnamed: R14.1, U4.41 (MDIX_EN)
unnamed: U17.4 (Y), U18.1 (ENA)
unnamed: R35.2, U4.63 (USBRBIAS)
unnamed: LED10.A, R37.1
unnamed: LED12.A, R52.1
unnamed: LED13.A, R55.1
unnamed: LED14.A, R56.1
unnamed: U18.4 (ENB), U20.4 (Y)
NC: J5.28
PRTCTL2: U4.14 (PRTCTL2), U17.2 (B), U18.2 (FLGA)
PRTCTL3: U4.16 (PRTCTL3), U18.3 (FLGB), U20.2 (B)
PRTCTL4: U4.17 (PRTCTL4), U19.1 (ENA), U19.2 (FLGA)
PRTCTL5: U4.18 (PRTCTL5), U19.3 (FLGB), U19.4 (ENB)
PWR1: R56.2, U18.8 (OUTA); also elsewhere on the board
PWR2: R55.2, U18.5 (OUTB); also elsewhere on the board
PWR3: R52.2, U19.8 (OUTA); also elsewhere on the board
PWR4: R37.2, U19.5 (OUTB)
RD_N: C32.2, R32.1, RJ1.6 (RD-), U4.53 (RXN)
RD_P: C31.2, R31.1, RJ1.3 (RD+), U4.52 (RXP)
TD_N: C30.2, R30.1, RJ1.2 (TD-), U4.56 (TXN)
TD_P: C26.2, R22.1, RJ1.1 (TD+), U4.55 (TXP)
ULCENO: U20.1 (A); also elsewhere on the board
ULC_N: U4.1 (USBDM2); also elsewhere on the board
ULC_P: U4.2 (USBDP2); also elsewhere on the board
USB0_N: U4.58 (USBDM0); also elsewhere on the board
USB0_P: U4.59 (USBDP0); also elsewhere on the board
USBA_N: U4.6 (USBDM4); also elsewhere on the board
USBA_P: U4.7 (USBDP4); also elsewhere on the board
USBMCU_N: U4.8 (USBDM5); also elsewhere on the board
USBMCU_P: U4.9 (USBDP5); also elsewhere on the board
VDD18C: C83.2, C84.2, C85.2, U4.15 (V18COR), U4.38 (V18COR)
VDD18ETH: C74.2, FB4.2, U4.48 (VDD18ETHPLL)
VDD18USB: C73.2, FB4.1, U4.62 (VDD18USBPLL)
VDD33A: C13.2, C14.2, C18.2, C19.2, C20.2, C21.2, C22.2, FB1.1, U4.5 (VDD33A), U4.10 (VDD33A), U4.49 (VDD33A), U4.51 (VDD33A), U4.54 (VDD33A), U4.57 (VDD33A), U4.64 (VDD33A)
XI: C12.2, Q2.2, R11.2, U4.61 (XI)
XO: C11.2, Q2.1, R11.1, U4.60 (XO)

Notes on the sheet:
Drawn by: DANIEL SMITH
Checked by: NEIL JANSEN
Revision B
EMC03 Motion Controller for FirePick Delta
*Review values for these 18pF caps.
ETHERNET INTERFACE
EEPROM
USB HUB CHIP

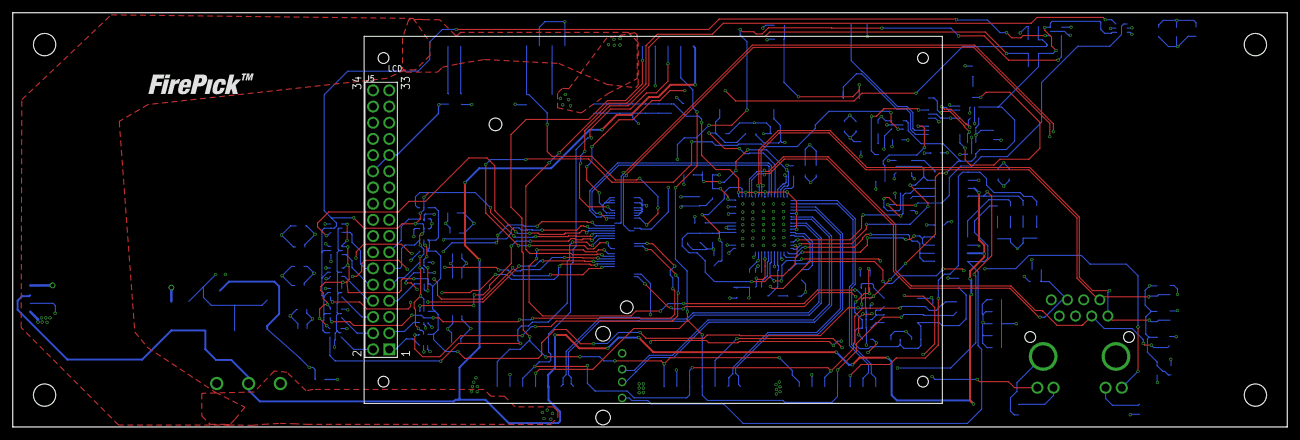
[picture p22: board EFP01 - Front Panel Board.brd from above]

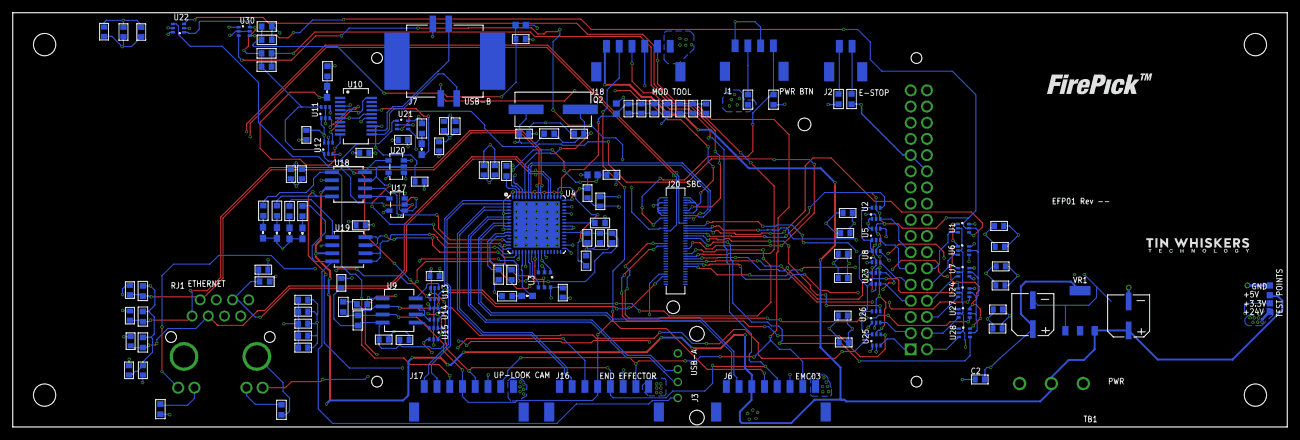
[picture p23: board EFP01 - Front Panel Board.brd from below]

Board: 4 copper layers, 200.0 x 65.0 mm, 151 parts (149 on the bottom side), 111 nets.
