firepick-delta/fpd-electronics/EAGLE/ECAM03 - ULC + H.Bed/ECAM03.brd

## EAGLE design EAGLE/ECAM03 - ULC + H.Bed/ECAM03.brd (2015-10-21)

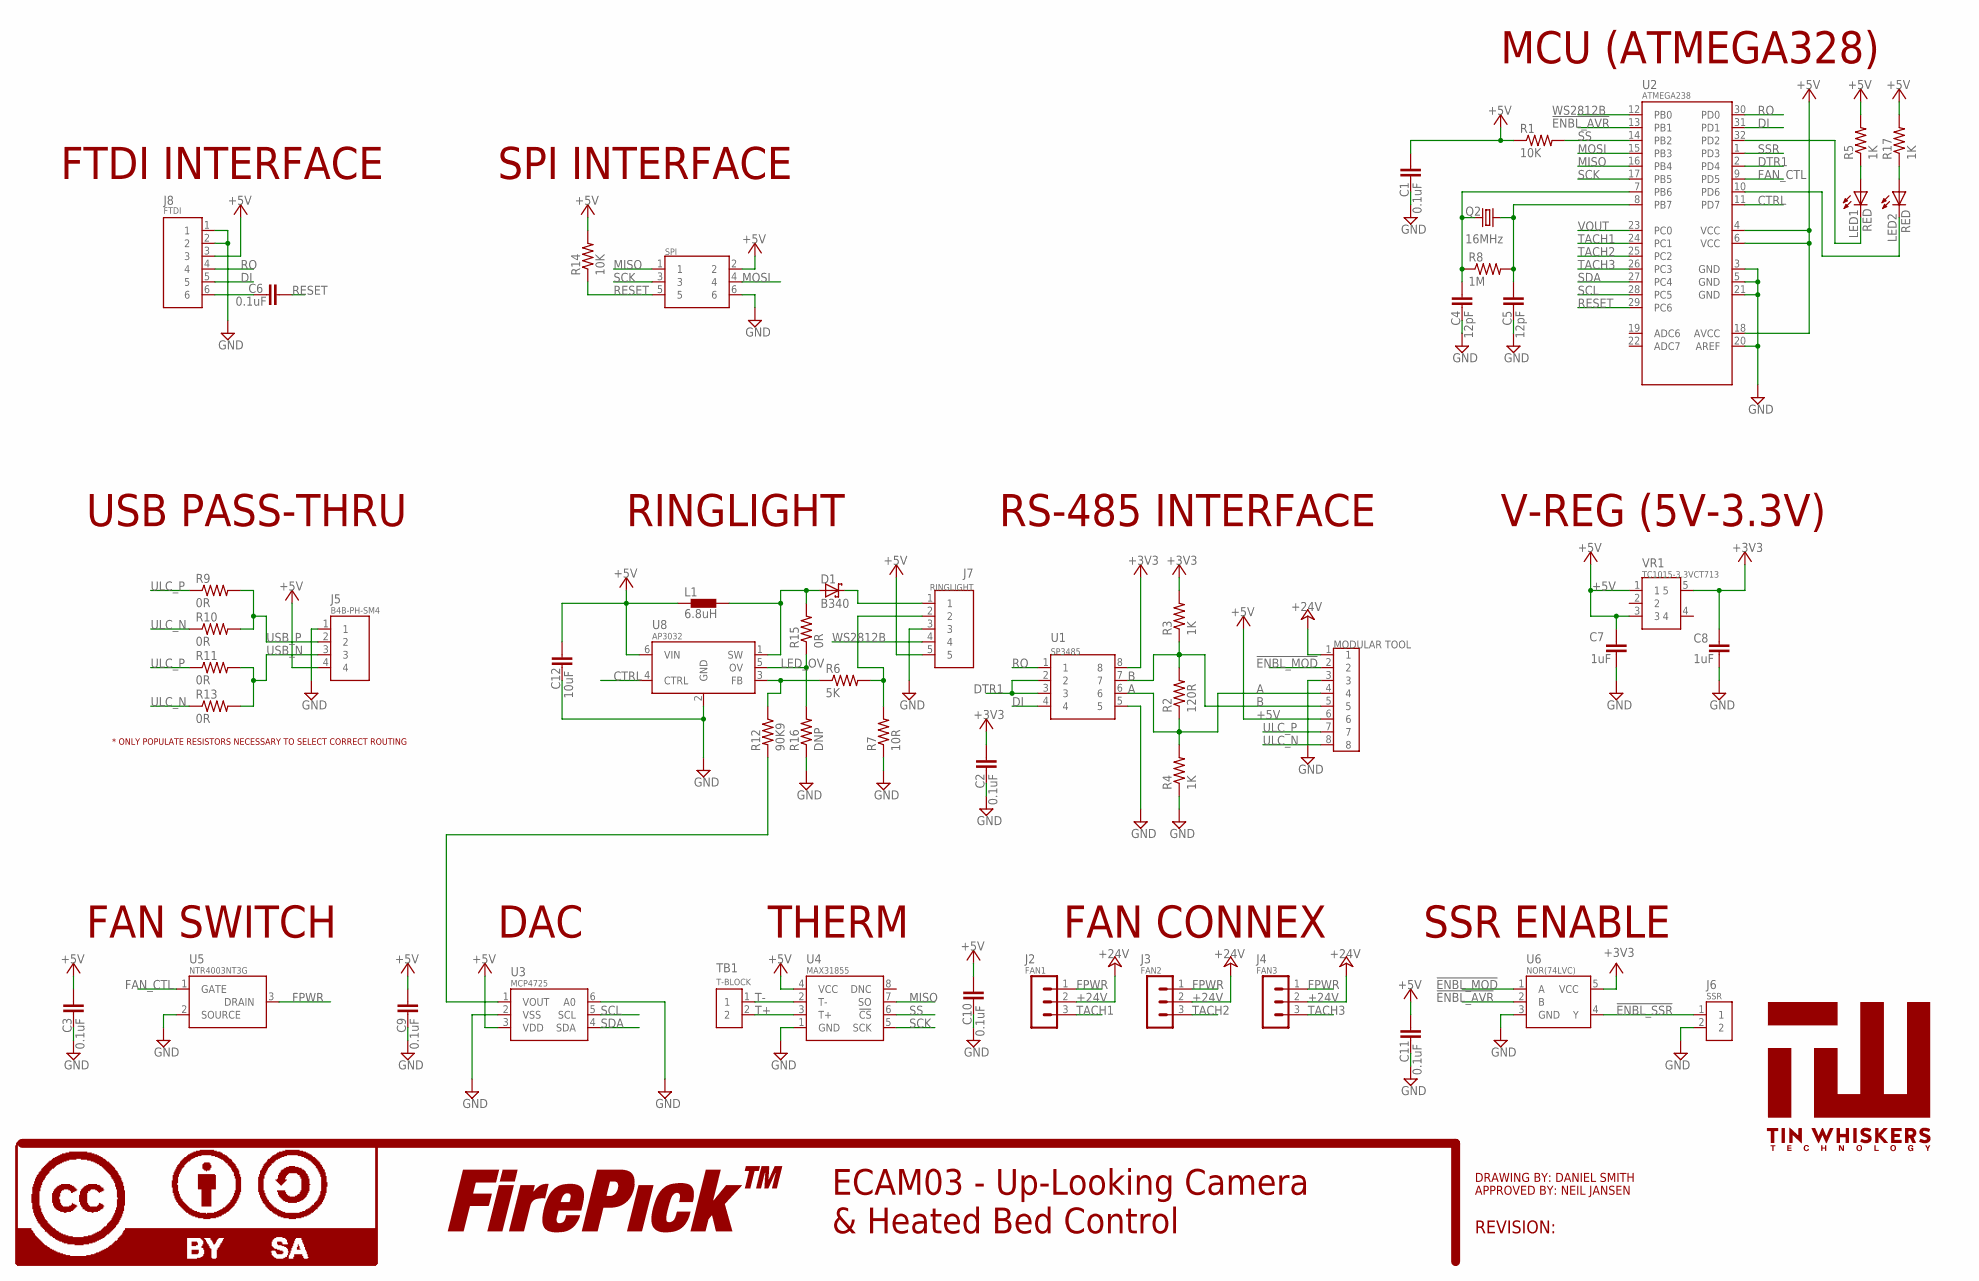
[picture p24: schematic ECAM03.sch]

Parts:
C1, C2, C3, C9, C10, C11: 0.1uF; C0603
C4, C5: 12pF; C0603; PARTNO GRM1885C1H120FA01J
C6: 0.1uF; C0603; PARTNO UMK107B7104KA-T
C7, C8: 1uF; C0603; PARTNO UMK107AB7105KA-T
C12: 10uF; C0603; PARTNO GRM188R61C106MA73D
D1: B340; DIO-SMA; PARTNO B340A-13-F
J1: MODULAR TOOL; CONN-JST-PH-2.0MM-8P-SMT-RA; PARTNO S8B-PH-SM4-TB(LF)(SN)
J2: FAN1; CONN-MOLEX-KK-3PIN; PARTNO 22232031
J3: FAN2; CONN-MOLEX-KK-3PIN; PARTNO 22232031
J4: FAN3; CONN-MOLEX-KK-3PIN; PARTNO 22232031
J5: B4B-PH-SM4; CON-JST-PH-2.0MM-4P-SMT-VRT; PARTNO B4B-PH-SM4-TB(LF)(SN)
J6: SSR; CON-HDR-2POS-MALE; PARTNO 68000-102HLF
J7: RINGLIGHT; CON-JST-PH-2.0MM-5P-SMT-VRT; PARTNO B5B-PH-SM4-TB(LF)(SN)
J8: FTDI; CON-HDR-6POS-MALE; PARTNO S6B-PH-SM4-TB(LF)(SN)
J9: SPI; CON-HDR-2X3P; PARTNO 67996-206HLF
L1: 6.8uH; 0603; PARTNO BRL1608T6R8M
LED1, LED2: RED; LED0603
LOGO1: LOGO-CC-BY-SALARGE; LOGO-CC-BY-SA
LOGO2: LOGO-FIREPICKLARGE; LOGO-FIREPICK
Q2: 16MHz; HC-49/U-S; PARTNO HCM4916000000ABJT
R1, R14: 10K; R0603; PARTNO RC0603FR-0710KL
R2: 120R; R0603; PARTNO RC0603FR-07120RL
R3, R4: 1K; R0603; PARTNO RC0603FR-071KL
R5, R17: 1K; R0603
R6: 5K; R0603; PARTNO RC0603FR-074K99L
R7: 10R; R1206; PARTNO RC1206FR-0710RL
R8: 1M; R0603; PARTNO RC0603FR-071ML
R9, R10, R11, R13, R15: 0R; R0603; PARTNO RC0603JR-070RL
R12: 90K9; R0603; PARTNO RC0603FR-0790K9L
R16: DNP; R0603; PARTNO RC0603JR-070RL
TB1: T-BLOCK; TBLOCK-2-5MM-OSTTH020160; PARTNO OSTTH020160
U1: SP3485; SOICN-8; PARTNO SP3485
U2: ATMEGA238; 32-TQF(ATMEGA); PARTNO ATMEGA328-AUR
U3: MCP4725; SOT-23-6; PARTNO MCP4725A0T-E/CH
U4: MAX31855; SOICN-8; PARTNO MAX31855KASA+
U5: NTR4003NT3G; SOT-23-3; PARTNO NTR4003NT3G
U6: NOR(74LVC); SOT-23-5; PARTNO SN74LVC1G02DBVR
U8: AP3032; SOT-23-6; PARTNO AP3032KTR-G1
U$1: TIN-WHISKERSTSTOP; TIN-WHISKERS-TSTOP; PARTNO *
VR1: TC1015-3.3VCT713; SOT-23-5; PARTNO TC1015-3.3VCT713

Connections:
!ENBL_AVR: U2.13 (PB1), U6.2 (B)
!ENBL_MOD: J1.2, U6.1 (A)
!ENBL_SSR: J6.1, U6.4 (Y)
+3V3: C2.2, C8.2, R3.2, U1.8, U6.5 (VCC), VR1.5
+5V: C1.2, C3.2, C7.2, C9.2, C10.2, C11.2, C12.2, J1.6, J5.4, J7.5, J8.3, J9.2, L1.1, R1.1, R5.2, R14.2, R17.2, U2.4 (VCC), U2.6 (VCC), U2.18 (AVCC), U3.3 (VDD), U4.4 (VCC), U8.6 (VIN), VR1.1, VR1.3
+24V: J1.1, J2.2, J3.2, J4.2
A: J1.4, R2.1, R4.2, U1.6
B: J1.5, R2.2, R3.1, U1.7
CTRL: U2.11 (PD7), U8.4 (CTRL)
DI: J8.5, U1.4, U2.31 (PD1)
DTR1: U1.2, U1.3, U2.2 (PD4)
FAN_CTL: U2.9 (PD5), U5.1 (GATE)
FPWR: J2.1, J3.1, J4.1, U5.3 (DRAIN)
GND: C1.1, C2.1, C3.1, C4.1, C5.1, C7.1, C8.1, C9.1, C10.1, C11.1, C12.1, J1.3, J5.1, J6.2, J7.3, J8.1, J8.2, J9.6, R4.1, R7.1, R16.1, U1.5, U2.3 (GND), U2.5 (GND), U2.20 (AREF), U2.21 (GND), U3.2 (VSS), U3.6 (A0), U4.1 (GND), U5.2 (SOURCE), U6.3 (GND), U8.2 (GND)
LED_+: D1.NEG (C), J7.1
LED_-: J7.2, R6.2, R7.2
LED_FB: R6.1, R12.1, U8.3 (FB)
LED_OV: R15.1, R16.2, U8.5 (OV)
LED_SW: D1.POS (A), L1.2, R15.2, U8.1 (SW)
MISO: J9.1, U2.16 (PB4), U4.7 (SO)
MOSI: J9.4, U2.15 (PB3)
unnamed: LED2.A, R17.1
unnamed: LED1.A, R5.1
unnamed: LED1.C, U2.32 (PD2)
unnamed: LED2.C, U2.10 (PD6)
unnamed: R12.2, U3.1 (VOUT)
unnamed: C6.1, J8.6
RESET: C6.2, J9.5, R14.1, U2.29 (PC6)
RO: J8.4, U1.1, U2.30 (PD0)
SCK: J9.3, U2.17 (PB5), U4.5 (SCK)
SCL: U2.28 (PC5), U3.5 (SCL)
SDA: U2.27 (PC4), U3.4 (SDA)
SS: R1.2, U2.14 (PB2), U4.6 (!CS)
SSR: U2.1 (PD3)
T+: TB1.2, U4.3 (T+)
T-: TB1.1, U4.2 (T-)
TACH1: J2.3, U2.24 (PC1)
TACH2: J3.3, U2.25 (PC2)
TACH3: J4.3, U2.26 (PC3)
ULC_N: J1.8, R10.1, R13.1
ULC_P: J1.7, R9.1, R11.1
USB_N: J5.3, R11.2, R13.2
USB_P: J5.2, R9.2, R10.2
VOUT: U2.23 (PC0)
WS2812B: J7.4, U2.12 (PB0)
XTAL1: C4.2, Q2.1, R8.1, U2.7 (PB6)
XTAL2: C5.2, Q2.2, R8.2, U2.8 (PB7)

Notes on the sheet:
ECAM03 - Up-Looking Camera & Heated Bed Control
DRAWING BY: DANIEL SMITH
APPROVED BY: NEIL JANSEN
REVISION:
MCU (ATMEGA328)
RS-485 INTERFACE
RINGLIGHT
USB PASS-THRU
* ONLY POPULATE RESISTORS NECESSARY TO SELECT CORRECT ROUTING
DAC
THERM
FAN CONNEX
FAN SWITCH
SSR ENABLE
V-REG (5V-3.3V)
FTDI INTERFACE
SPI INTERFACE
SPI

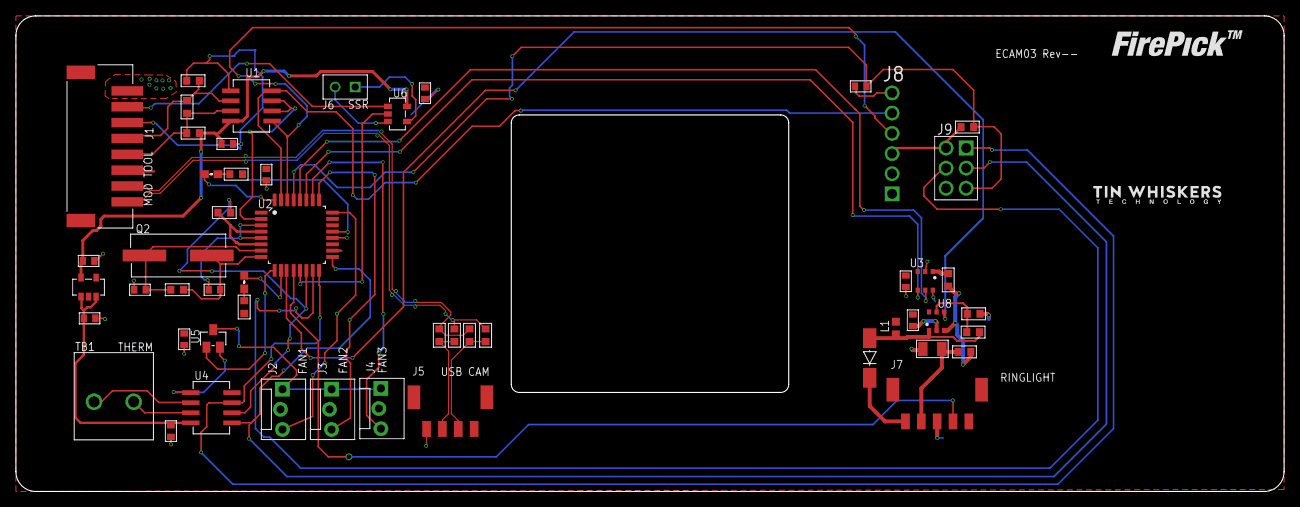
[picture p25: board ECAM03.brd from above]

Board: 4 copper layers, 160.0 x 60.0 mm, 55 parts (1 on the bottom side), 45 nets.
