firepick-delta/fpd-electronics/EAGLE/ESOL01 - Solenoid + Pump/ESOL01 - Sol + Pump.brd

## EAGLE design EAGLE/ESOL01 - Solenoid + Pump/ESOL01 - Sol + Pump.brd (2015-10-20)

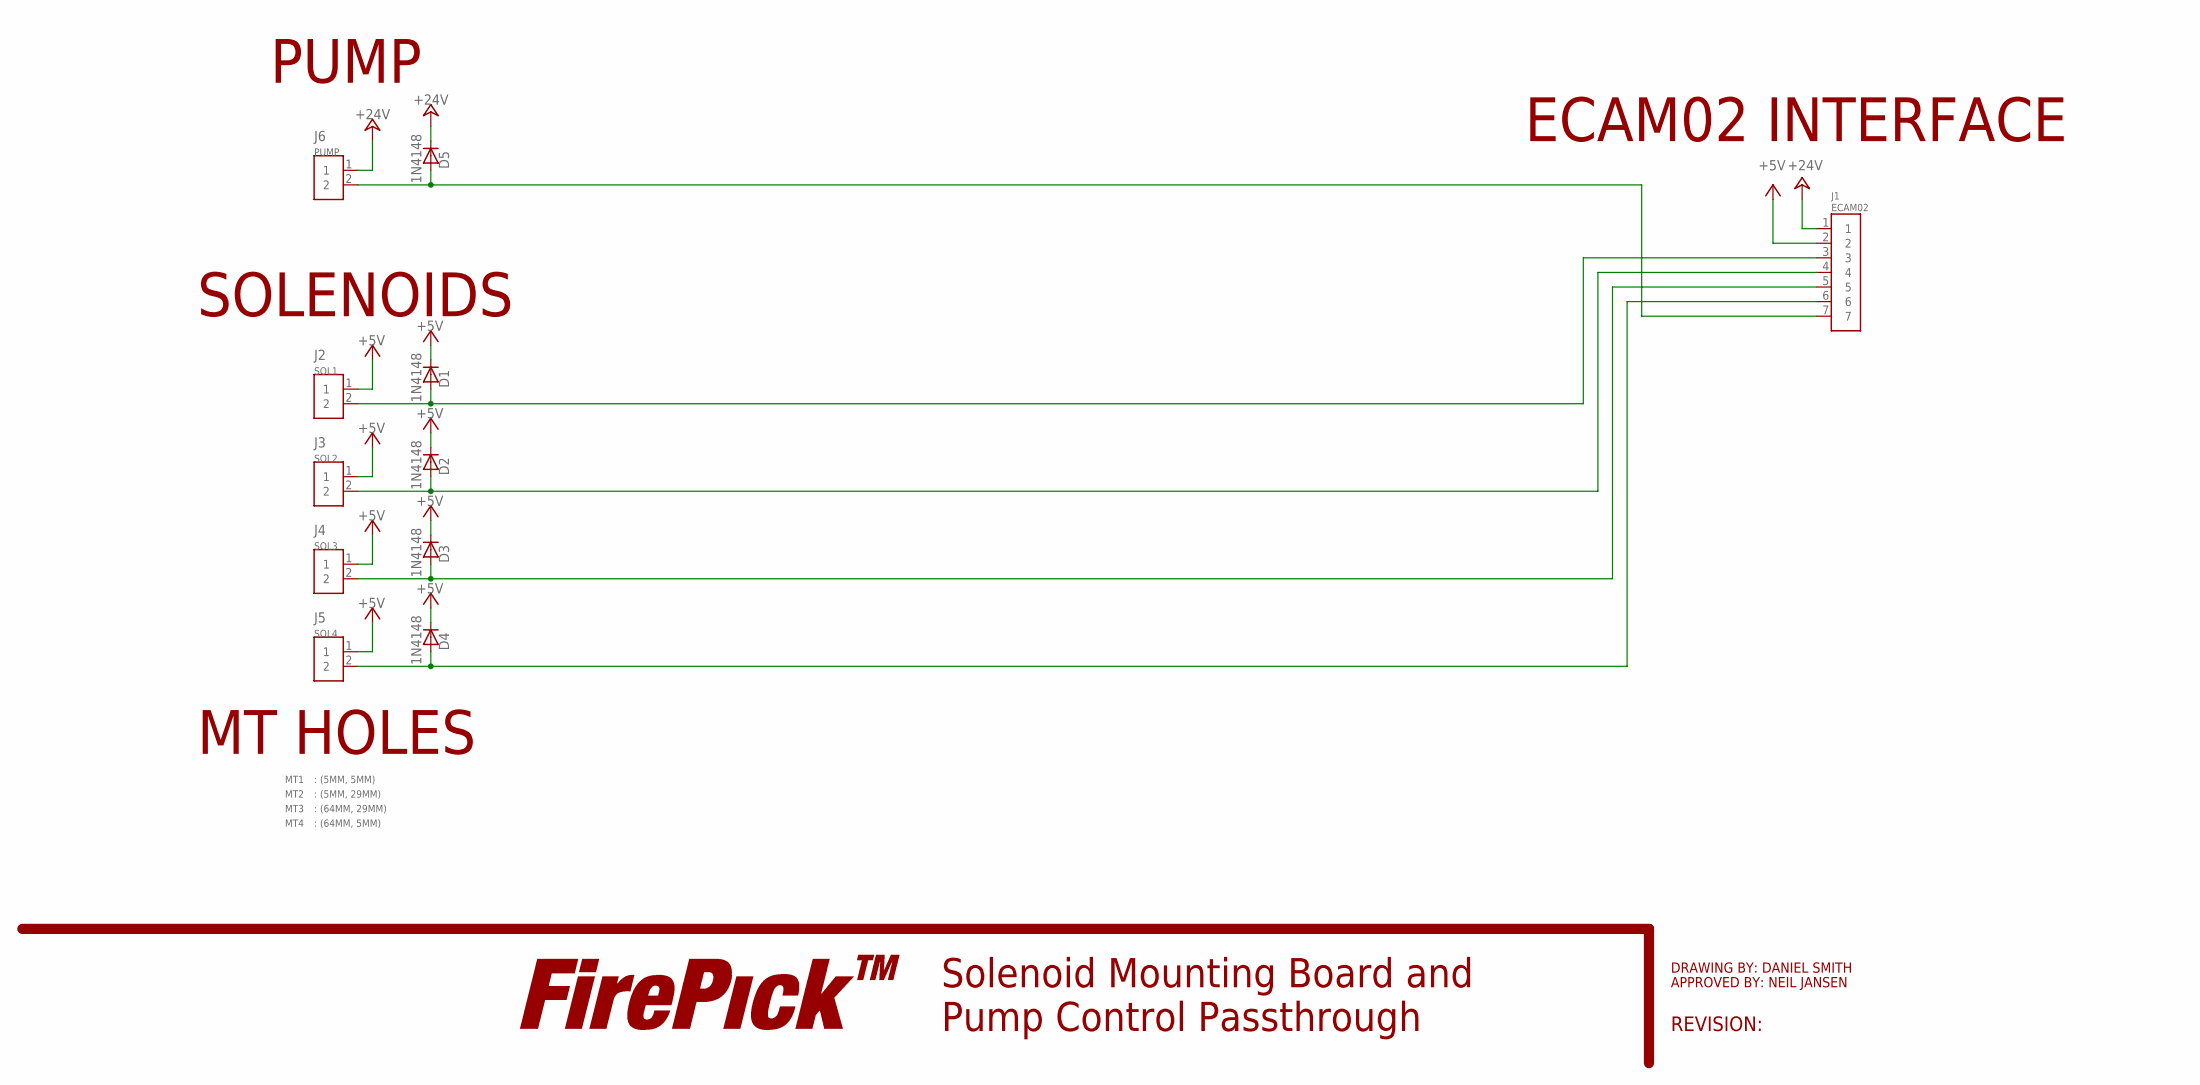
[picture p26: schematic ESOL01 - Sol + Pump.sch]

Parts:
D1, D2, D3, D4, D5: 1N4148; SOD-323
J1: ECAM02; CON-JST-PH-2.0MM-7P-SMT-VRT
J2: SOL1; HOLEX2
J3: SOL2; HOLEX2
J4: SOL3; HOLEX2
J5: SOL4; HOLEX2
J6: PUMP; CON-JST-PH-2.0MM-2P-SMT-VRT
LOGO2: LOGO-FIREPICKLARGE; LOGO-FIREPICK
MT1: : (5MM, 5MM); MTHOLE(M3)
MT2: : (5MM, 29MM); MTHOLE(M3)
MT3: : (64MM, 29MM); MTHOLE(M3)
MT4: : (64MM, 5MM); MTHOLE(M3)

Connections:
+5V: D1.NEG (C), D2.NEG (C), D3.NEG (C), D4.NEG (C), J1.2, J2.1, J3.1, J4.1, J5.1
+24V: D5.NEG (C), J1.1, J6.1
unnamed: D1.POS (A), J1.3, J2.2
unnamed: D2.POS (A), J1.4, J3.2
unnamed: D3.POS (A), J1.5, J4.2
unnamed: D4.POS (A), J1.6, J5.2
unnamed: D5.POS (A), J1.7, J6.2

Notes on the sheet:
PUMP
SOLENOIDS
ECAM02 INTERFACE
Solenoid Mounting Board and Pump Control Passthrough
DRAWING BY: DANIEL SMITH
APPROVED BY: NEIL JANSEN
REVISION:
MT HOLES

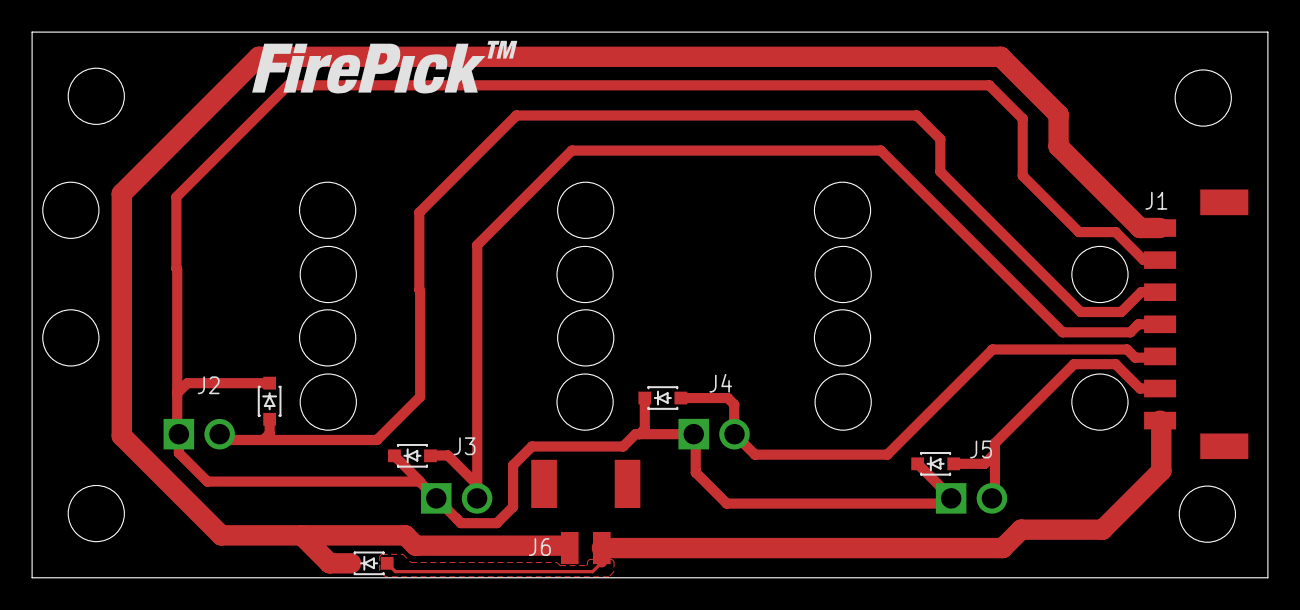
[picture p27: board ESOL01 - Sol + Pump.brd from above]

Board: 4 copper layers, 77.0 x 34.0 mm, 16 parts (0 on the bottom side), 7 nets.
