firepick-delta/fpd-electronics/EAGLE/EFD01 - Crsl. Feeder/EFD01 - C. Feeder.brd

## EAGLE design EAGLE/EFD01 - Crsl. Feeder/EFD01 - C. Feeder.brd (2015-10-20)

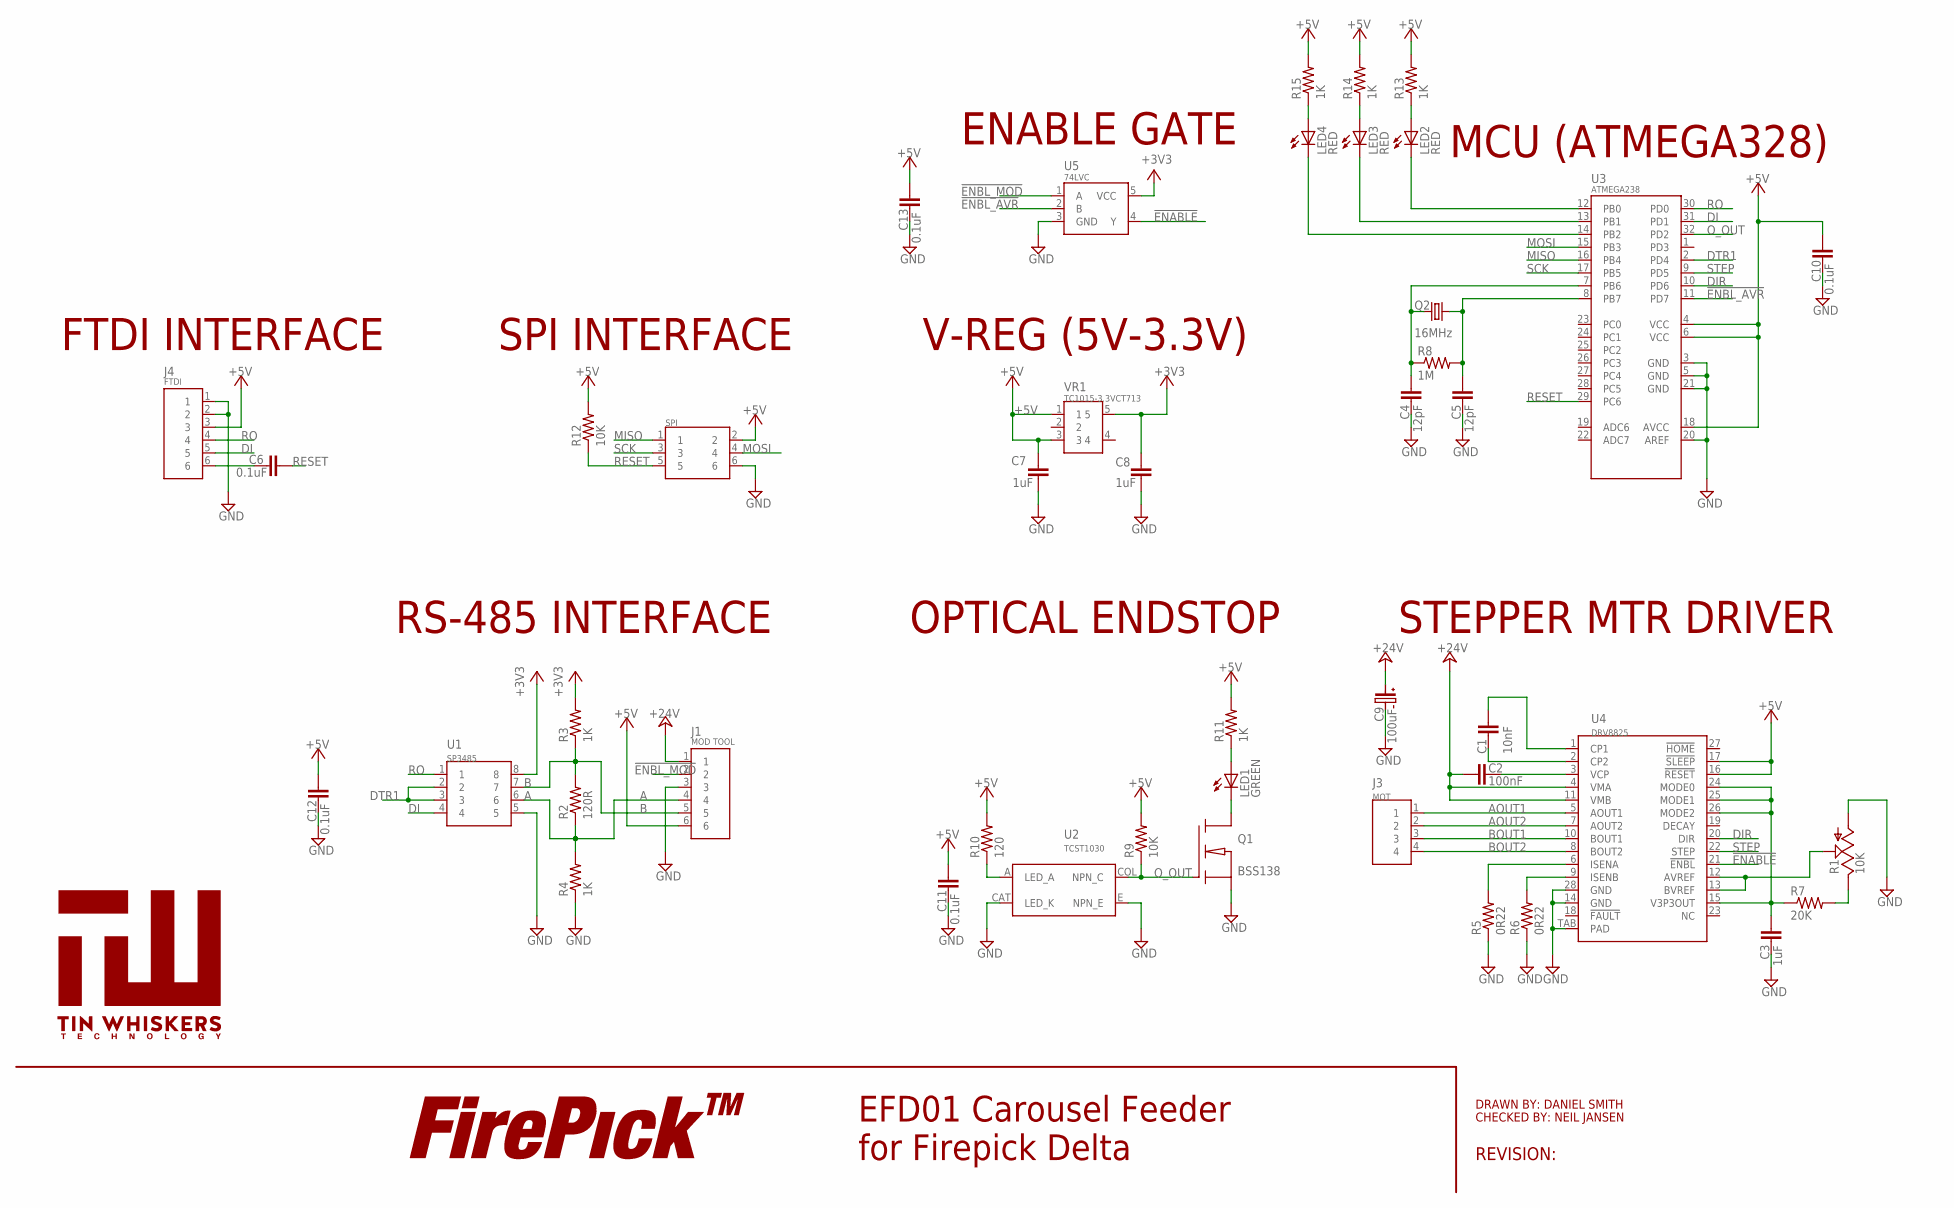
[picture p28: schematic EFD01 - C. Feeder.sch]

Parts:
C1: 10nF; C0603; PARTNO GRM188R71H103KA01D
C2: 100nF; C0603; PARTNO UMK107B7104KA-T
C3, C7, C8: 1uF; C0603; PARTNO UMK107AB7105KA-T
C4, C5: 12pF; C0603; PARTNO GRM1885C1H120FA01J
C6, C10, C11, C12, C13: 0.1uF; C0603; PARTNO UMK107B7104KA-T
C9: 100uF; C-SMD-6.3MM; PARTNO EMVA500ADA101MHA0G
J1: MOD TOOL; CONN-JST-PH-2.0MM-6P-SMT-RA; PARTNO S6B-PH-SM4-TB(LF)(SN)
J2: SPI; CON-HDR-2X3P; PARTNO 67996-206HLF
J3: MOT; CONN-JST-PH-2.0MM-4P-SMT-RA; PARTNO S4B-PH-SM4-TB(LF)(SN)
J4: FTDI; CON-HDR-6POS-MALE; PARTNO S6B-PH-SM4-TB(LF)(SN)
LED1: GREEN; LED0603; PARTNO SML-D12M8WT86
LED2, LED3, LED4: RED; LED0603; PARTNO SML-D12M8WT86
LOGO2: LOGO-FIREPICKLARGE; LOGO-FIREPICK
Q1: BSS138; SOT-23-3; PARTNO BSS138
Q2: 16MHz; HC-49/U-S; PARTNO HCM4916000000ABJT
R1: 10K; TC33X-2; PARTNO TC33X-2-103E
R2: 120R; R0603; PARTNO RC0603FR-07120RL
R3, R4, R11, R13, R14, R15: 1K; R0603; PARTNO RC0603FR-071KL
R5, R6: 0R22; R1206; PARTNO RL1206FR-7W0R22L
R7: 20K; R0603; PARTNO RC0603FR-0722KL
R8: 1M; R0603; PARTNO RC0603FR-071ML
R9, R12: 10K; R0603; PARTNO RC0603FR-0710KL
R10: 120; R0603; PARTNO RC0603FR-07120RL
U1: SP3485; SOICN-8; PARTNO SP3485
U2: TCST1030; PARTNO TCST1030
U3: ATMEGA238; 32-TQF(ATMEGA); PARTNO ATMEGA328-AUR
U4: DRV8825; 28-HSSOP; PARTNO DRV8825PWPR
U5: 74LVC; SOT-23-5; PARTNO SN74LVC1G32DBVR
U$1: TIN-WHISKERSSMALL; TIN-WHISKERS-SMALL; PARTNO *
VR1: TC1015-3.3VCT713; SOT-23-5; PARTNO TC1015-3.3VCT713

Connections:
!ENABLE: U4.21 (!ENBL), U5.4 (Y)
!ENBL_AVR: U3.11 (PD7), U5.2 (B)
!ENBL_MOD: J1.2, U5.1 (A)
+3V3: C8.2, R3.2, U1.8, U5.5 (VCC), VR1.5
+5V: C7.2, C10.2, C11.2, C12.2, C13.2, J1.6, J2.2, J4.3, R9.2, R10.2, R11.2, R12.2, R13.2, R14.2, R15.2, U3.4 (VCC), U3.6 (VCC), U3.18 (AVCC), U4.16 (!RESET), U4.17 (!SLEEP), VR1.1, VR1.3
+24V: C2.1, C9.POS, J1.1, U4.4 (VMA), U4.11 (VMB)
A: J1.4, R2.1, R4.2, U1.6
AOUT1: J3.1, U4.5 (AOUT1)
AOUT2: J3.2, U4.7 (AOUT2)
B: J1.5, R2.2, R3.1, U1.7
BOUT1: J3.3, U4.10 (BOUT1)
BOUT2: J3.4, U4.8 (BOUT2)
DI: J4.5, U1.4, U3.31 (PD1)
DIR: U3.10 (PD6), U4.20 (DIR)
DTR1: U1.2, U1.3, U3.2 (PD4)
GND: C3.1, C4.1, C5.1, C7.1, C8.1, C9.NEG, C10.1, C11.1, C12.1, C13.1, J1.3, J2.6, J4.1, J4.2, Q1.2 (S), R1.1 (A), R4.1, R5.1, R6.1, U1.5, U2.CAT (LED_K), U2.E (NPN_E), U3.3 (GND), U3.5 (GND), U3.20 (AREF), U3.21 (GND), U4.14 (GND), U4.28 (GND), U4.TAB (PAD), U5.3 (GND)
MISO: J2.1, U3.16 (PB4)
MOSI: J2.4, U3.15 (PB3)
unnamed: LED1.C, Q1.3 (D)
unnamed: R10.1, U2.A (LED_A)
unnamed: LED1.A, R11.1
unnamed: C1.2, U4.1 (CP1)
unnamed: C1.1, U4.2 (CP2)
unnamed: LED2.C, U3.12 (PB0)
unnamed: R5.2, U4.6 (ISENA)
unnamed: R6.2, U4.9 (ISENB)
unnamed: LED2.A, R13.1
unnamed: LED3.C, U3.13 (PB1)
unnamed: LED3.A, R14.1
unnamed: C3.2, R7.1, U4.15 (V3P3OUT), U4.24 (MODE0), U4.25 (MODE1), U4.26 (MODE2)
unnamed: R1.3 (E), R7.2
unnamed: R1.2 (S), U4.12 (AVREF), U4.13 (BVREF)
unnamed: C6.1, J4.6
unnamed: LED4.C, U3.14 (PB2)
unnamed: LED4.A, R15.1
O_OUT: Q1.1 (G), R9.1, U2.COL (NPN_C), U3.32 (PD2)
RESET: C6.2, J2.5, R12.1, U3.29 (PC6)
RO: J4.4, U1.1, U3.30 (PD0)
SCK: J2.3, U3.17 (PB5)
STEP: U3.9 (PD5), U4.22 (STEP)
VCP: C2.2, U4.3 (VCP)
XTAL1: C4.2, Q2.1, R8.1, U3.7 (PB6)
XTAL2: C5.2, Q2.2, R8.2, U3.8 (PB7)

Notes on the sheet:
STEPPER MTR DRIVER
MCU (ATMEGA328)
OPTICAL ENDSTOP
V-REG (5V-3.3V)
RS-485 INTERFACE
SPI INTERFACE
FTDI INTERFACE
EFD01 Carousel Feeder for Firepick Delta
DRAWN BY: DANIEL SMITH
CHECKED BY: NEIL JANSEN
REVISION:
ENABLE GATE
SPI

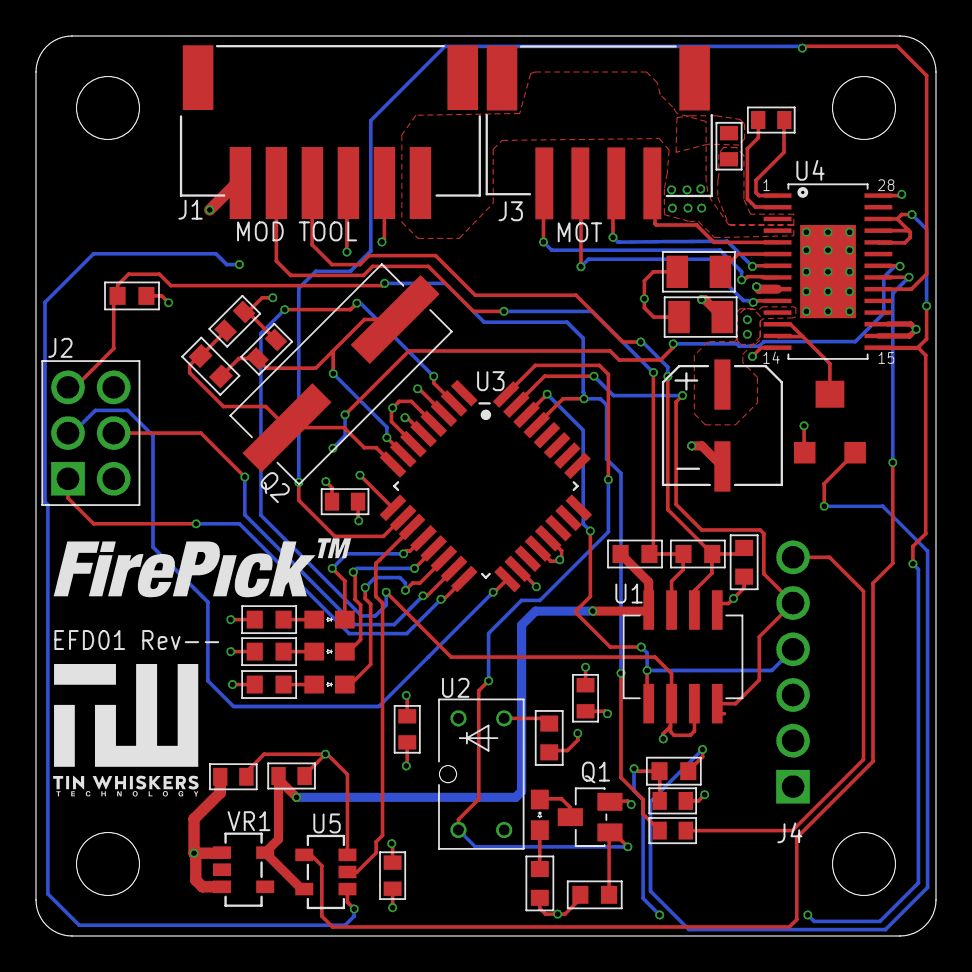
[picture p29: board EFD01 - C. Feeder.brd from above]

Board: 4 copper layers, 50.0 x 50.0 mm, 46 parts (0 on the bottom side), 43 nets.
