firepick-delta/fpd-electronics/EAGLE/EMC03 - Motion Control/EMC03-Motion Control.brd

## EAGLE design EAGLE/EMC03 - Motion Control/EMC03-Motion Control.brd (2015-10-20)

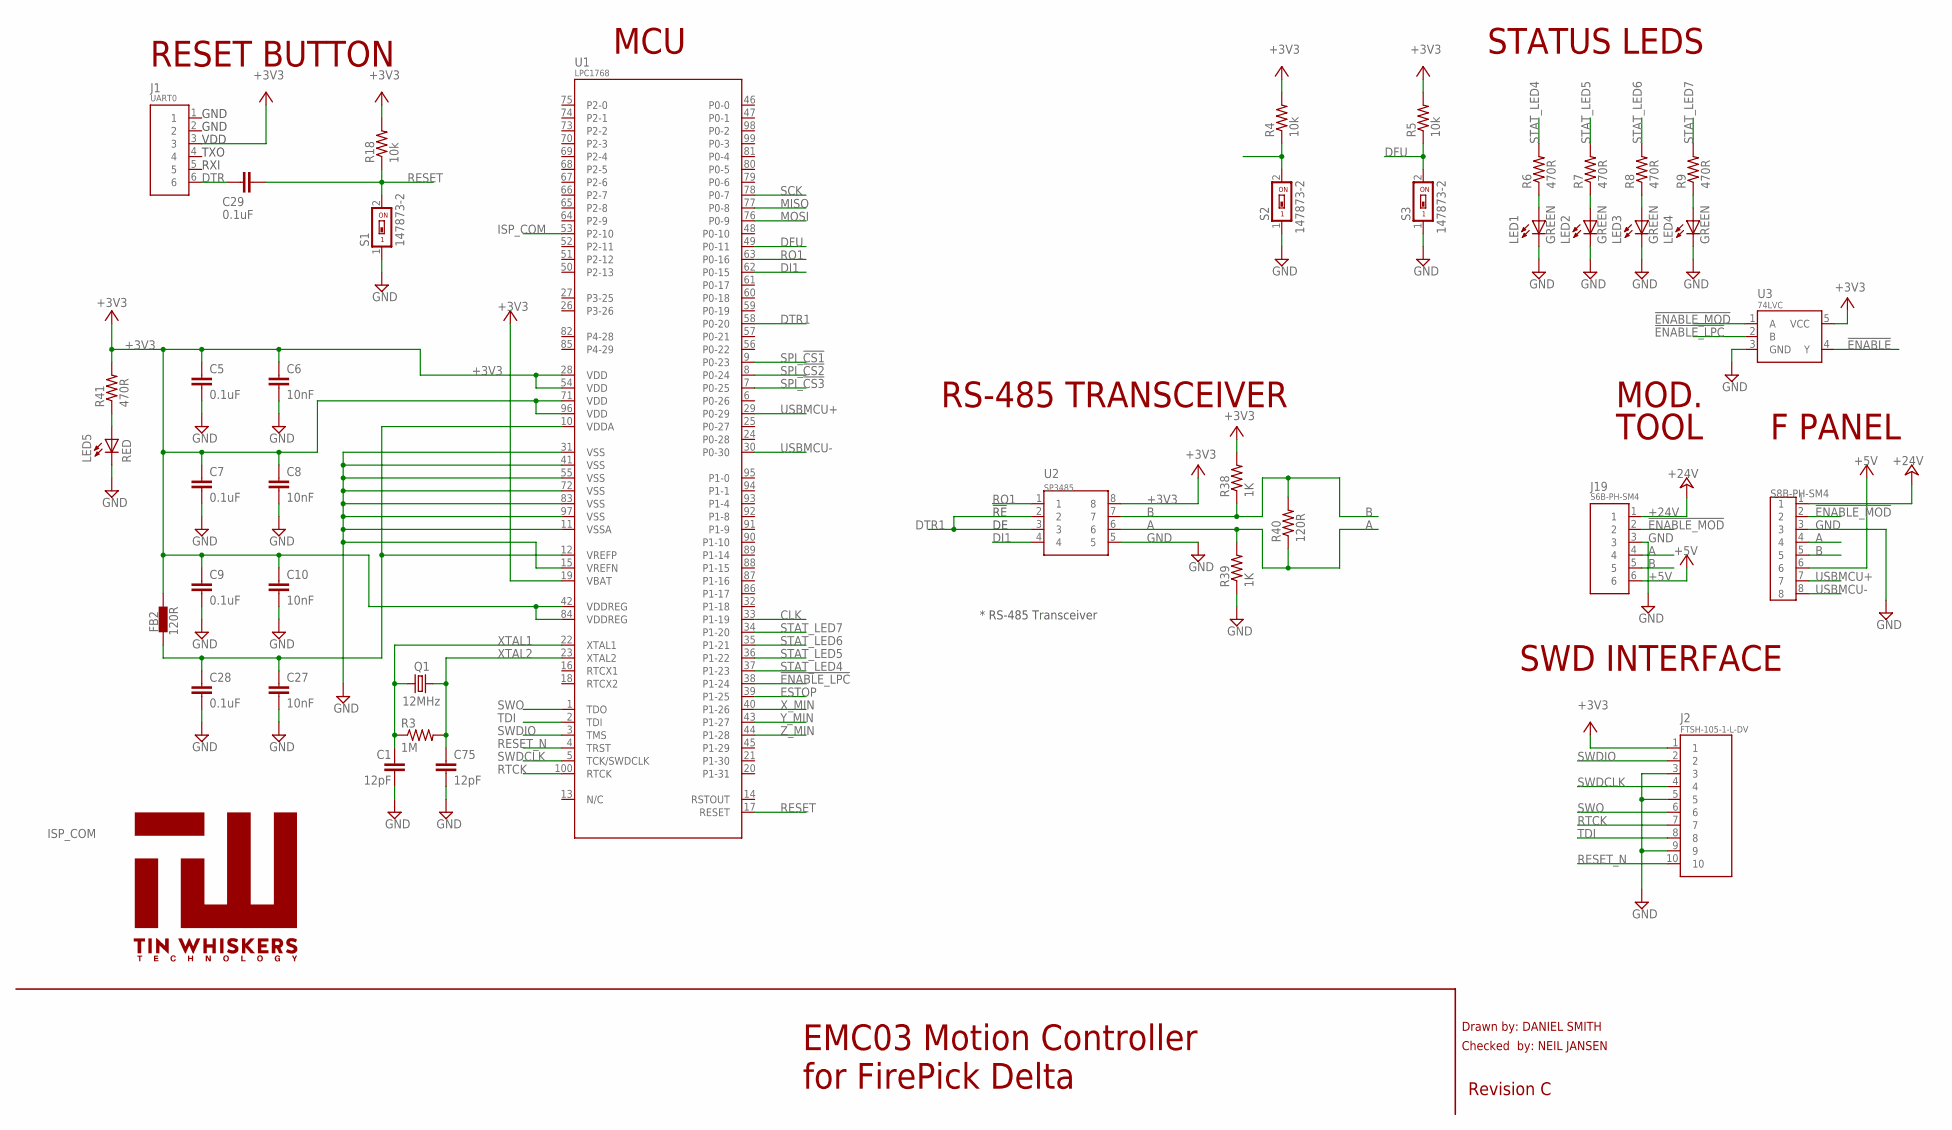
[picture p30: schematic EMC03-Motion Control.sch, sheet 1, MCU]

Parts:
C1, C75: 12pF; C0603; PARTNO GRM1885C1H120FA01J
C5, C7, C9, C28, C29: 0.1uF; C0603; PARTNO GMK107BJ104KAHT
C6, C8, C10, C27: 10nF; C0603; PARTNO GRM188R71H103KA01D
FB2: 120R; F0603; PARTNO BLM18AG121SN1D
J1: UART0; CON-HDR-6POS-MALE; PARTNO 67996-206HLF
J2: FTSH-105-1-L-DV; FTSH-105-01-XXX-DV-K; PARTNO FTSH-105-01-L-DV
J17: S8B-PH-SM4; CONN-JST-PH-2.0MM-8P-SMT-RA; PARTNO S8B-PH-SM4-TB(LF)(SN)
J19: S6B-PH-SM4; CONN-JST-PH-2.0MM-6P-SMT-RA; PARTNO S6B-PH-SM4-TB(LF)(SN)
LED1, LED2, LED3, LED4: GREEN; LED0603; PARTNO SML-D12M8WT86
LED5: RED; LED0603; PARTNO SML-D12U8WT86
Q1: 12MHz; HC-49/U-S; PARTNO HCM4912000000ABJT
R3: 1M; R0603; PARTNO RC0603FR-071ML
R4, R5, R18: 10k; R0603; PARTNO RC0603FR-0710KL
R6, R7, R8, R9, R41: 470R; R0603; PARTNO RC0603FR-07470RL
R38, R39: 1K; R0603; PARTNO RC0603FR-071KL
R40: 120R; R0603; PARTNO RC0805FR-07120RL
S1, S2, S3: 147873-2; PARTNO 147873-2
U1: LPC1768; 100-LQFP; PARTNO LPC1768
U2: SP3485; SOICN-8; PARTNO SP3485
U3: 74LVC; SOT-23-5; PARTNO SN74LVC1G32DBVR
U$1: TIN-WHISKERSSMALL; TIN-WHISKERS-SMALL; PARTNO *

Connections:
!ENABLE: U3.4 (Y); also elsewhere on the board
!ENABLE_LPC: U1.38 (P1-24), U3.2 (B)
!ENABLE_MOD: J17.2, J19.2, U3.1 (A)
+3V3: C5.2, C6.2, C7.2, C8.2, C9.2, C10.2, FB2.2, J1.3, J2.1, R4.2, R5.2, R18.2, R38.2, R41.2, U1.19 (VBAT), U1.28 (VDD), U1.42 (VDDREG), U1.54 (VDD), U1.71 (VDD), U1.84 (VDDREG), U1.96 (VDD), U2.8, U3.5 (VCC); also elsewhere on the board
+5V: J17.6, J19.6; also elsewhere on the board
+24V: J17.1, J19.1; also elsewhere on the board
A: J17.4, J19.4, R39.2, R40.1, U2.6
B: J17.5, J19.5, R38.1, R40.2, U2.7
CLK: U1.33 (P1-19); also elsewhere on the board
DFU: R5.1, S3.2, U1.49 (P0-11)
DI1: U1.62 (P0-15), U2.4
DPWR: C27.2, C28.2, FB2.1, U1.10 (VDDA), U1.12 (VREFP)
DTR: C29.1, J1.6
DTR1: U1.58 (P0-20), U2.2, U2.3
ESTOP: U1.39 (P1-25)
GND: C1.1, C5.1, C6.1, C7.1, C8.1, C9.1, C10.1, C27.1, C28.1, C75.1, J2.3, J2.5, J2.9, J17.3, J19.3, LED1.C, LED2.C, LED3.C, LED4.C, LED5.C, R39.1, S1.1, S2.1, S3.1, U1.11 (VSSA), U1.15 (VREFN), U1.31 (VSS), U1.41 (VSS), U1.55 (VSS), U1.72 (VSS), U1.83 (VSS), U1.97 (VSS), U2.5, U3.3 (GND); also elsewhere on the board
ISP_COM: R4.1, S2.2, U1.53 (P2-10)
MISO: U1.77 (P0-8); also elsewhere on the board
MOSI: U1.76 (P0-9); also elsewhere on the board
unnamed: LED5.A, R41.1
unnamed: LED1.A, R6.1
unnamed: LED2.A, R7.1
unnamed: LED4.A, R9.1
unnamed: LED3.A, R8.1
RESET: C29.2, R18.1, S1.2, U1.17 (RESET)
RESET_N: J2.10, U1.4 (TRST)
RO1: U1.63 (P0-16), U2.1
RTCK: J2.7, U1.100 (RTCK)
SCK: U1.78 (P0-7); also elsewhere on the board
SPI_!CS1: U1.9 (P0-23); also elsewhere on the board
SPI_!CS2: U1.8 (P0-24); also elsewhere on the board
SPI_!CS3: U1.7 (P0-25); also elsewhere on the board
STAT_LED4: R6.2, U1.37 (P1-23)
STAT_LED5: R7.2, U1.36 (P1-22)
STAT_LED6: R8.2, U1.35 (P1-21)
STAT_LED7: R9.2, U1.34 (P1-20)
SWDCLK: J2.4, U1.5 (TCK/SWDCLK)
SWDIO: J2.2, U1.3 (TMS)
SWO: J2.6, U1.1 (TDO)
TDI: J2.8, U1.2 (TDI)
USBMCU+: J17.7, U1.29 (P0-29)
USBMCU-: J17.8, U1.30 (P0-30)
XTAL1: C1.2, Q1.1, R3.1, U1.22 (XTAL1)
XTAL2: C75.2, Q1.2, R3.2, U1.23 (XTAL2)
X_MIN: U1.40 (P1-26); also elsewhere on the board
Y_MIN: U1.43 (P1-27); also elsewhere on the board
Z_MIN: U1.44 (P1-28); also elsewhere on the board

Notes on the sheet:
VDD
Drawn by: DANIEL SMITH
Checked by: NEIL JANSEN
Revision C
EMC03 Motion Controller for FirePick Delta
GND
TXO
RXI
STATUS LEDS
RESET BUTTON
MCU
MOD.
TOOL
!RE
* RS-485 Transceiver
RS-485 TRANSCEIVER
SWD INTERFACE
F PANEL
