firepick-delta/fpd-electronics/EAGLE/EMC03 - Motion Control/EMC03-Motion Control.brd

## EAGLE design EAGLE/EMC03 - Motion Control/EMC03-Motion Control.brd (continued)

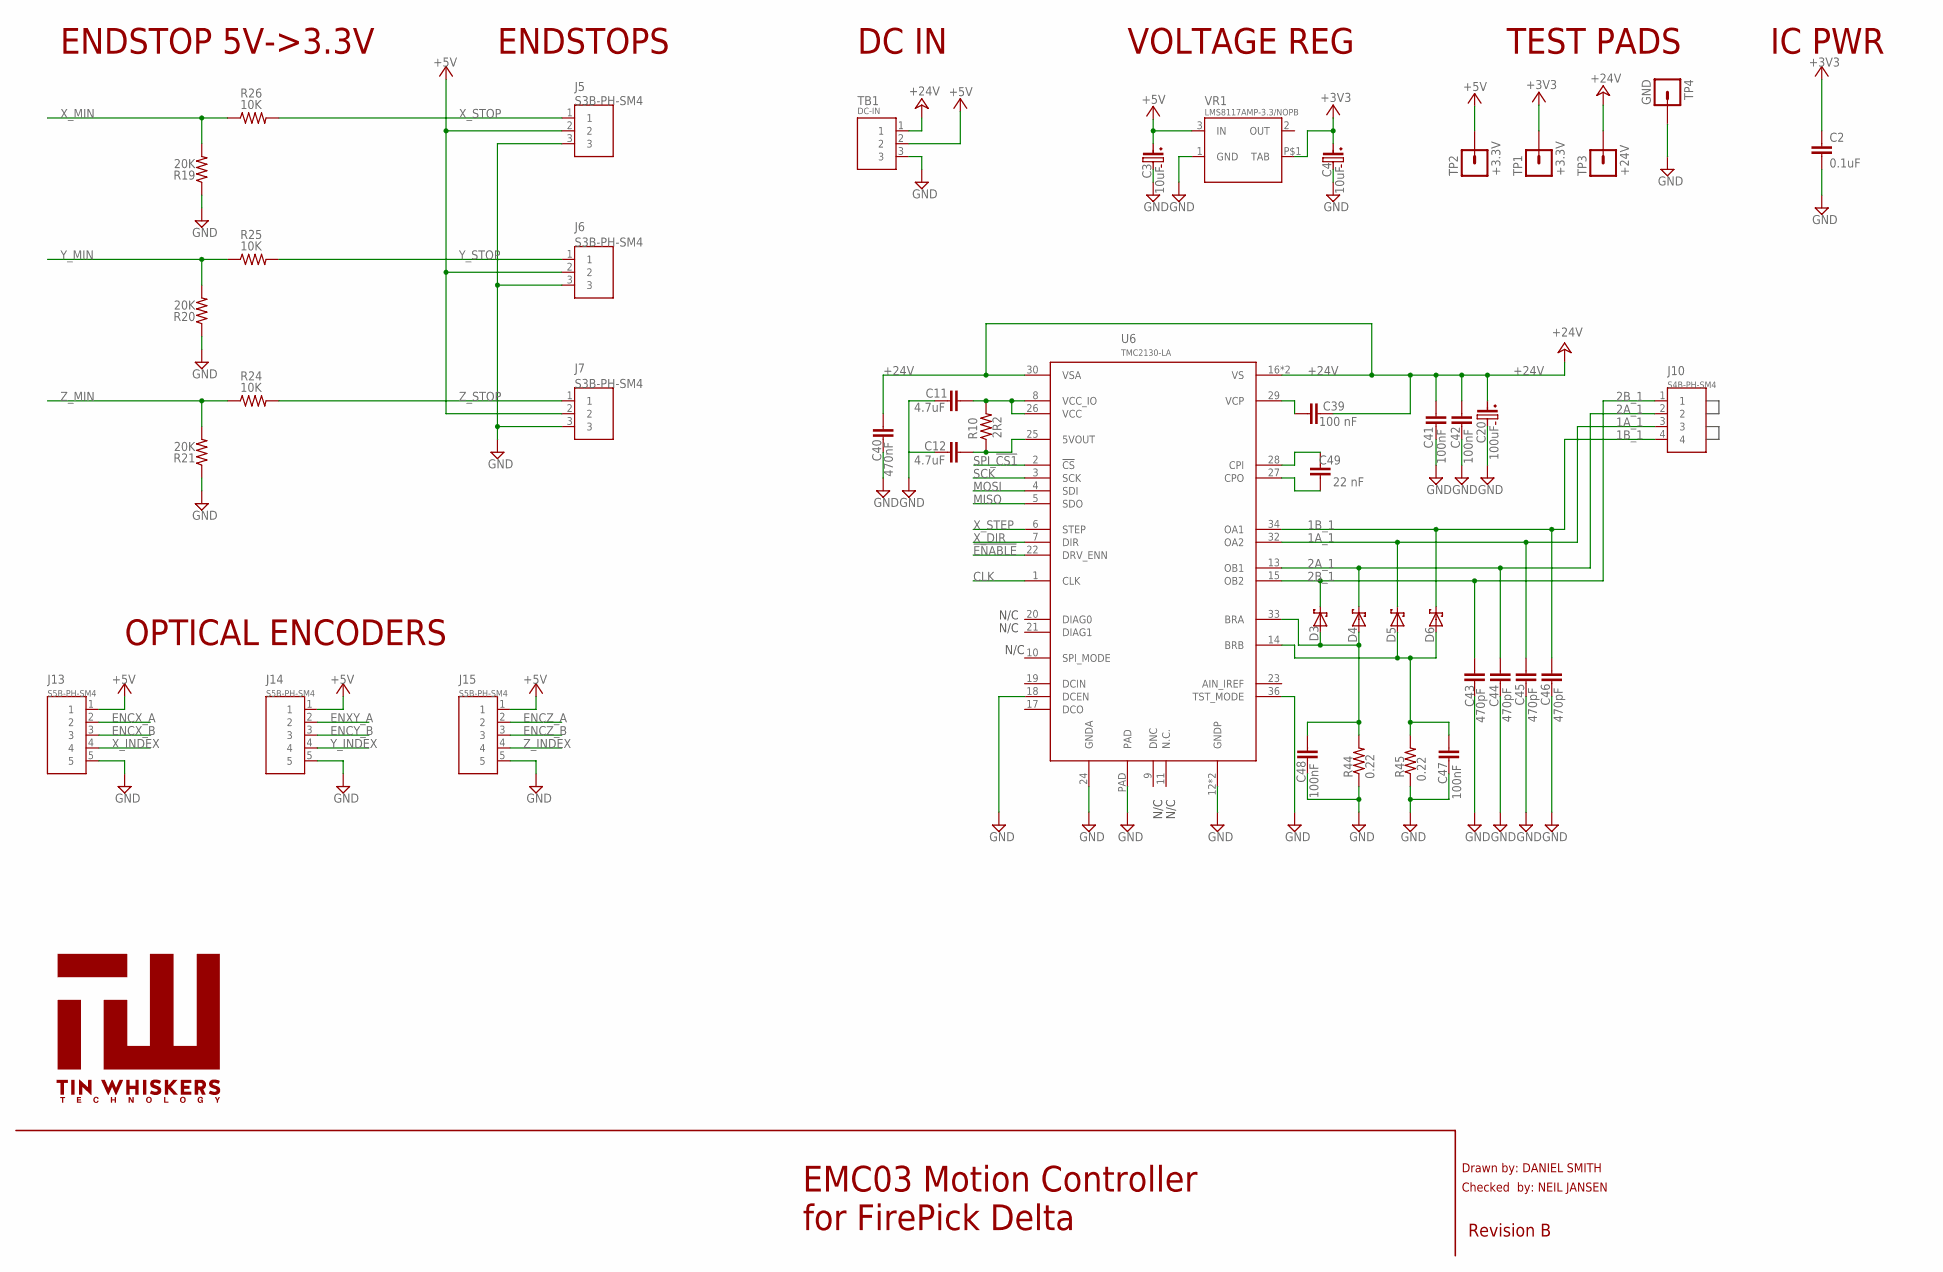
[picture p31: schematic EMC03-Motion Control.sch, sheet 2, Pwr/Endstop]

Parts:
C2: 0.1uF; C0603; PARTNO UMK107B7104KA-T
C3, C4: 10uF; C-SMD-6.3MM; PARTNO EMVH350ADA100MF60G
C11, C12: 4.7uF; C0603; PARTNO GRM188C81E475KE11D
C20: 100uF; C-SMD-6.3MM; PARTNO EEE-FTH101XAP
C39: 100 nF; C0603; PARTNO UMK107B7104KA-T
C40: 470nF; C0603; PARTNO UMK107B7474KA-TR
C41, C42, C47, C48: 100nF; C0603; PARTNO UMK107B7104KA-T
C43, C44, C45, C46: 470pF; C0603; PARTNO GRM188R72A471KA01D
C49: 22 nF; C0603; PARTNO GRM188R71H223KA01D
D3, D4, D5, D6: MSS1P6; MICRO-SMP; PARTNO MSS1P6
J5, J6, J7: S3B-PH-SM4; CONN-JST-PH-2.0MM-3P-SMT-RA; PARTNO S3B-PH-SM4-TB(LF)(SN)
J10: S4B-PH-SM4; CONN-JST-PH-2.0MM-4P-SMT-RA; PARTNO S4B-PH-SM4-TB(LF)(SN)
J13, J14, J15: S5B-PH-SM4; CONN-JST-PH-2.0MM-5P-SMT-RA; PARTNO S5B-PH-SM4-TB(LF)(SN)
R10: 2R2; R0603; PARTNO RC0603FR-072R2L
R19, R20, R21: 20K; R0603; PARTNO RC0603FR-0720KL
R24, R25, R26: 10K; R0603; PARTNO RC0603FR-0710KL
R44, R45: 0.22; R1206; PARTNO RL1206FR-7W0R22L
TB1: DC-IN; TBLOCK-3-5MM-OSTTH030160; PARTNO OSTTH030160
TP1, TP2: +3.3V; TESTPAD; PARTNO N/A
TP3: +24V; TESTPAD; PARTNO N/A
TP4: GND; TESTPAD; PARTNO N/A
U6: TMC2130-LA; 36-QFN(5X6); PARTNO TMC2130-LA
U$2: TIN-WHISKERSSMALL; TIN-WHISKERS-SMALL; PARTNO *
VR1: LMS8117AMP-3.3/NOPB; SOT-223; PARTNO LMS8117AMP-3.3/NOPB

Connections:
1A_1: C45.1, D5.NEG (C), J10.3, U6.32 (OA2)
1B_1: C46.1, D6.NEG (C), J10.4, U6.34 (OA1)
2A_1: C44.1, D4.NEG (C), J10.2, U6.13 (OB1)
2B_1: C43.1, D3.NEG (C), J10.1, U6.15 (OB2)
!ENABLE: U6.22 (DRV_ENN); also elsewhere on the board
+3V3: C2.1, C4.POS, TP1.PAD, VR1.P$1 (TAB); also elsewhere on the board
+5V: C3.POS, J5.2, J6.2, J7.2, J13.1, J14.1, J15.1, TB1.2, TP2.PAD, VR1.3 (IN); also elsewhere on the board
+24V: C20.POS, C39.2, C40.2, C41.1, C42.1, TB1.1, TP3.PAD, U6.16 (VS), U6.30 (VSA), U6.31 (VS); also elsewhere on the board
BRA: C48.1, D3.POS (A), D4.POS (A), R44.2, U6.33 (BRA)
BRB: C47.1, D5.POS (A), D6.POS (A), R45.2, U6.14 (BRB)
CLK: U6.1 (CLK); also elsewhere on the board
CPI: C49.2, U6.28 (CPI)
CPO: C49.1, U6.27 (CPO)
ENCX_A: J13.2
ENCX_B: J13.3
ENCY_B: J14.3
ENCZ_A: J15.2
ENCZ_B: J15.3
ENXY_A: J14.2
GND: C2.2, C3.NEG, C4.NEG, C11.1, C12.1, C20.NEG, C40.1, C41.2, C42.2, C43.2, C44.2, C45.2, C46.2, C47.2, C48.2, J5.3, J6.3, J7.3, J13.5, J14.5, J15.5, R19.1, R20.1, R21.1, R44.1, R45.1, TB1.3, TP4.PAD, U6.12 (GNDP), U6.18 (DCEN), U6.24 (GNDA), U6.35 (GNDP), U6.36 (TST_MODE), U6.PAD, VR1.1 (GND); also elsewhere on the board
MISO: U6.5 (SDO); also elsewhere on the board
MOSI: U6.4 (SDI); also elsewhere on the board
unnamed: C11.2, R10.2, U6.8 (VCC_IO), U6.26 (VCC)
unnamed: C12.2, R10.1, U6.25 (5VOUT)
SCK: U6.3 (SCK); also elsewhere on the board
SPI_!CS1: U6.2 (!CS); also elsewhere on the board
VCP: C39.1, U6.29 (VCP)
X_DIR: U6.7 (DIR)
X_INDEX: J13.4
X_MIN: R19.2, R26.1; also elsewhere on the board
X_STEP: U6.6 (STEP)
X_STOP: J5.1, R26.2
Y_INDEX: J14.4
Y_MIN: R20.2, R25.1; also elsewhere on the board
Y_STOP: J6.1, R25.2
Z_INDEX: J15.4
Z_MIN: R21.2, R24.1; also elsewhere on the board
Z_STOP: J7.1, R24.2

Notes on the sheet:
Drawn by: DANIEL SMITH
Checked by: NEIL JANSEN
Revision B
EMC03 Motion Controller for FirePick Delta
TEST PADS
ENDSTOP 5V->3.3V
ENDSTOPS
IC PWR
OPTICAL ENCODERS
VOLTAGE REG
DC IN
N/C

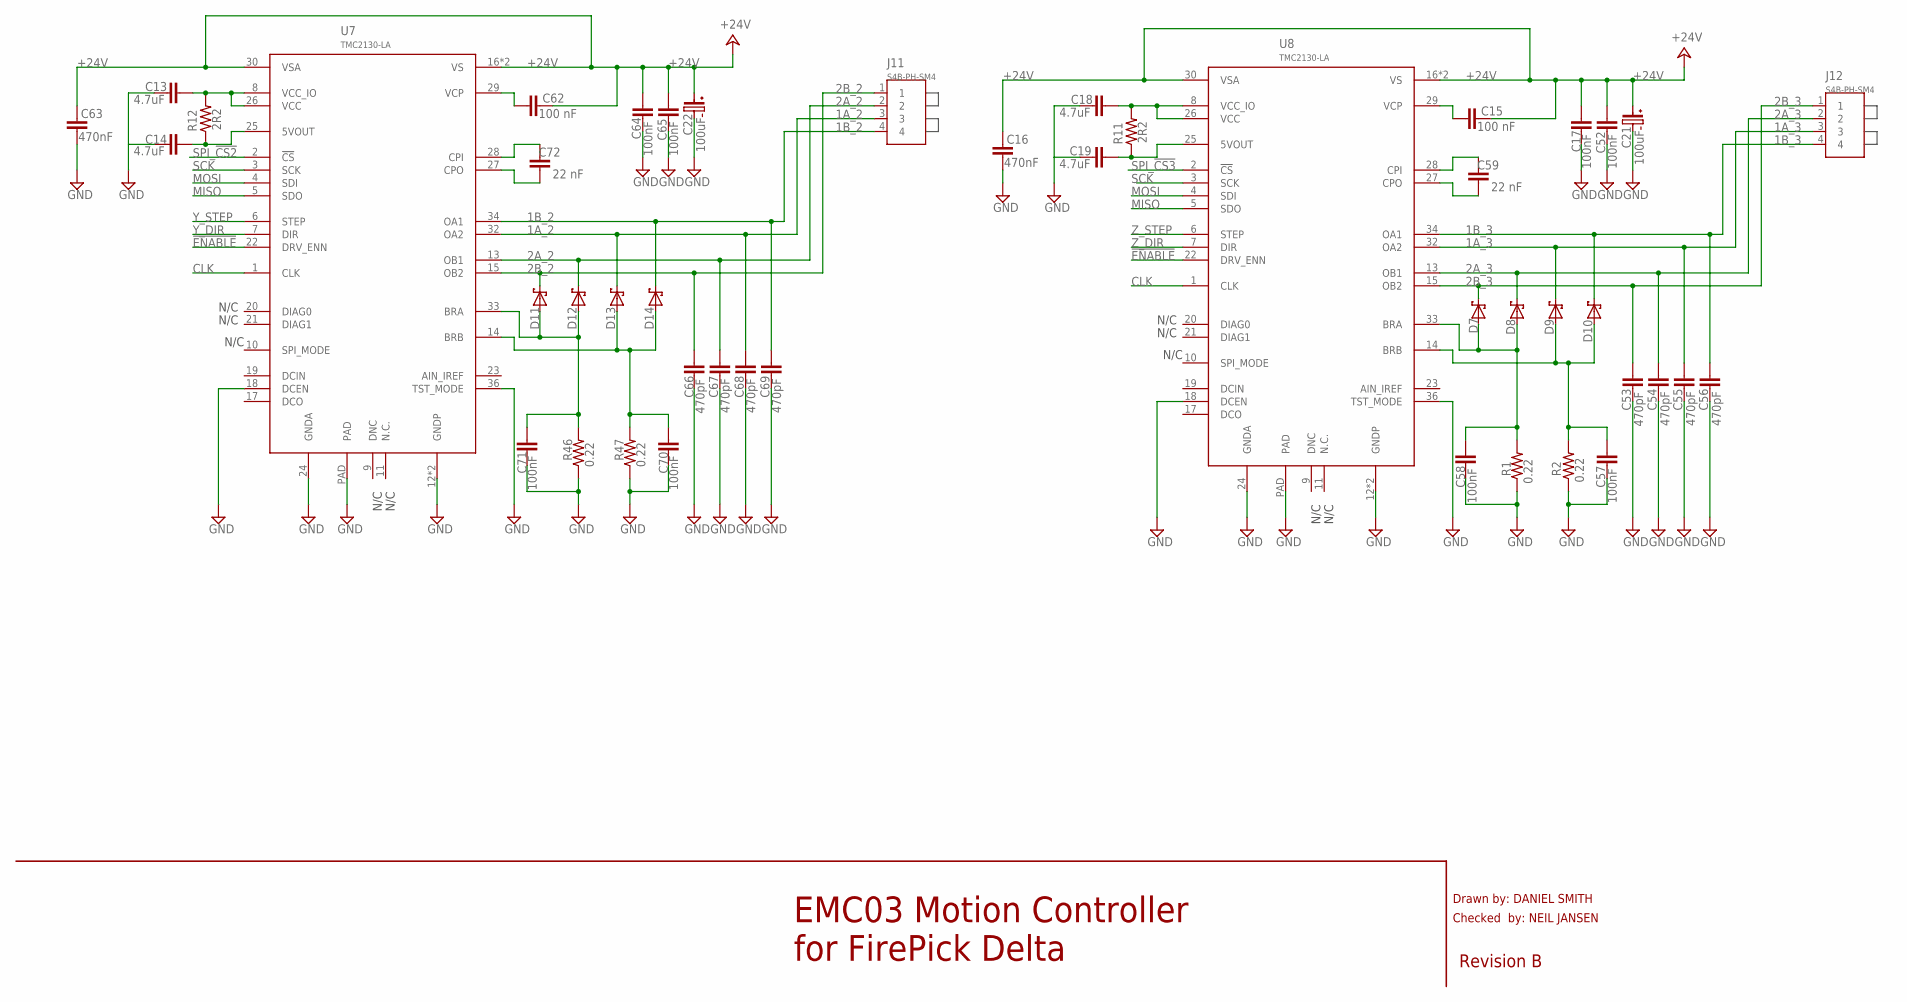
[picture p32: schematic EMC03-Motion Control.sch, sheet 3, Mot/E-Stop]

Parts:
C13, C14, C18, C19: 4.7uF; C0603; PARTNO GRM188C81E475KE11D
C15, C62: 100 nF; C0603; PARTNO UMK107B7104KA-T
C16, C63: 470nF; C0603; PARTNO UMK107B7474KA-TR
C17, C52, C57, C58, C64, C65, C70, C71: 100nF; C0603; PARTNO UMK107B7104KA-T
C21, C22: 100uF; C-SMD-6.3MM; PARTNO EEE-FTH101XAP
C53, C54, C55, C56, C66, C67, C68, C69: 470pF; C0603; PARTNO GRM188R72A471KA01D
C59, C72: 22 nF; C0603; PARTNO GRM188R71H223KA01D
D7, D8, D9, D10, D11, D12, D13, D14: MSS1P6; MICRO-SMP; PARTNO MSS1P6
J11, J12: S4B-PH-SM4; CONN-JST-PH-2.0MM-4P-SMT-RA; PARTNO S4B-PH-SM4-TB(LF)(SN)
R1, R2, R46, R47: 0.22; R1206; PARTNO RL1206FR-7W0R22L
R11, R12: 2R2; R0603; PARTNO RC0603FR-072R2L
U7, U8: TMC2130-LA; 36-QFN(5X6); PARTNO TMC2130-LA

Connections:
1A_2: C68.1, D13.NEG (C), J11.3, U7.32 (OA2)
1A_3: C55.1, D9.NEG (C), J12.3, U8.32 (OA2)
1B_2: C69.1, D14.NEG (C), J11.4, U7.34 (OA1)
1B_3: C56.1, D10.NEG (C), J12.4, U8.34 (OA1)
2A_2: C67.1, D12.NEG (C), J11.2, U7.13 (OB1)
2A_3: C54.1, D8.NEG (C), J12.2, U8.13 (OB1)
2B_2: C66.1, D11.NEG (C), J11.1, U7.15 (OB2)
2B_3: C53.1, D7.NEG (C), J12.1, U8.15 (OB2)
!ENABLE: U7.22 (DRV_ENN), U8.22 (DRV_ENN); also elsewhere on the board
+24V: C15.2, C16.2, C17.1, C21.POS, C22.POS, C52.1, C62.2, C63.2, C64.1, C65.1, U7.16 (VS), U7.30 (VSA), U7.31 (VS), U8.16 (VS), U8.30 (VSA), U8.31 (VS); also elsewhere on the board
BRA2: C71.1, D11.POS (A), D12.POS (A), R46.2, U7.33 (BRA)
BRA3: C58.1, D7.POS (A), D8.POS (A), R1.2, U8.33 (BRA)
BRB2: C70.1, D13.POS (A), D14.POS (A), R47.2, U7.14 (BRB)
BRB3: C57.1, D9.POS (A), D10.POS (A), R2.2, U8.14 (BRB)
CLK: U7.1 (CLK), U8.1 (CLK); also elsewhere on the board
CPI1: C59.2, U8.28 (CPI)
CPI2: C72.2, U7.28 (CPI)
CPO1: C59.1, U8.27 (CPO)
CPO2: C72.1, U7.27 (CPO)
GND: C13.1, C14.1, C16.1, C17.2, C18.1, C19.1, C21.NEG, C22.NEG, C52.2, C53.2, C54.2, C55.2, C56.2, C57.2, C58.2, C63.1, C64.2, C65.2, C66.2, C67.2, C68.2, C69.2, C70.2, C71.2, R1.1, R2.1, R46.1, R47.1, U7.12 (GNDP), U7.18 (DCEN), U7.24 (GNDA), U7.35 (GNDP), U7.36 (TST_MODE), U7.PAD, U8.12 (GNDP), U8.18 (DCEN), U8.24 (GNDA), U8.35 (GNDP), U8.36 (TST_MODE), U8.PAD; also elsewhere on the board
MISO: U7.5 (SDO), U8.5 (SDO); also elsewhere on the board
MOSI: U7.4 (SDI), U8.4 (SDI); also elsewhere on the board
unnamed: C19.2, R11.1, U8.25 (5VOUT)
unnamed: C18.2, R11.2, U8.8 (VCC_IO), U8.26 (VCC)
unnamed: C14.2, R12.1, U7.25 (5VOUT)
unnamed: C13.2, R12.2, U7.8 (VCC_IO), U7.26 (VCC)
SCK: U7.3 (SCK), U8.3 (SCK); also elsewhere on the board
SPI_!CS2: U7.2 (!CS); also elsewhere on the board
SPI_!CS3: U8.2 (!CS); also elsewhere on the board
VCP1: C15.1, U8.29 (VCP)
VCP2: C62.1, U7.29 (VCP)
Y_DIR: U7.7 (DIR)
Y_STEP: U7.6 (STEP)
Z_DIR: U8.7 (DIR)
Z_STEP: U8.6 (STEP)

Notes on the sheet:
Drawn by: DANIEL SMITH
Checked by: NEIL JANSEN
Revision B
EMC03 Motion Controller for FirePick Delta
N/C

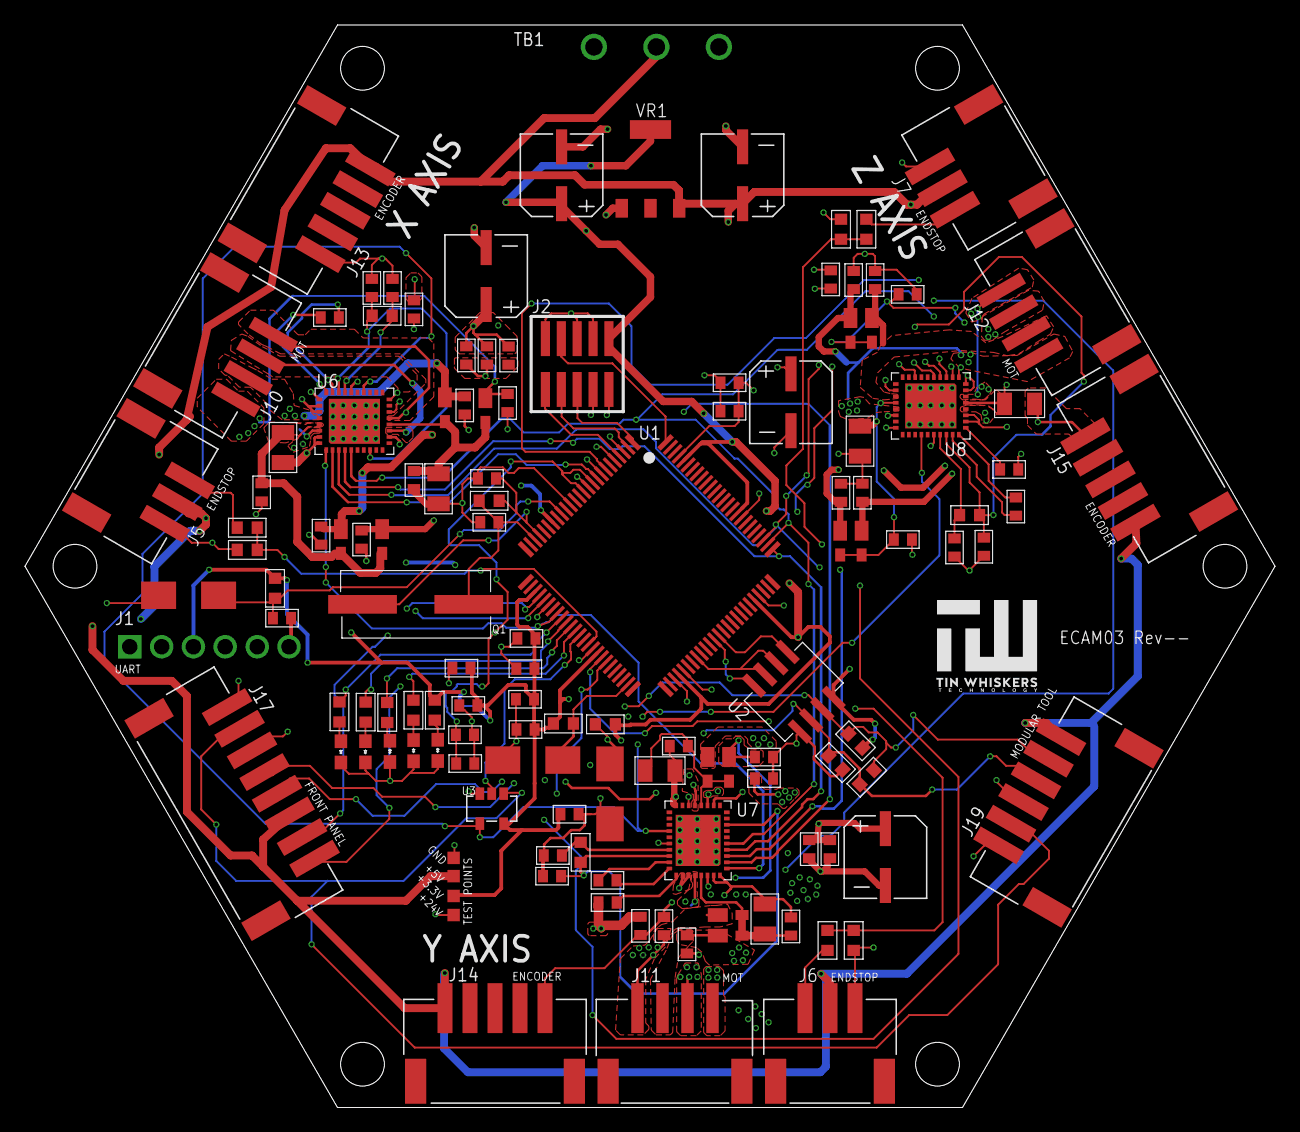
[picture p33: board EMC03-Motion Control.brd from above]

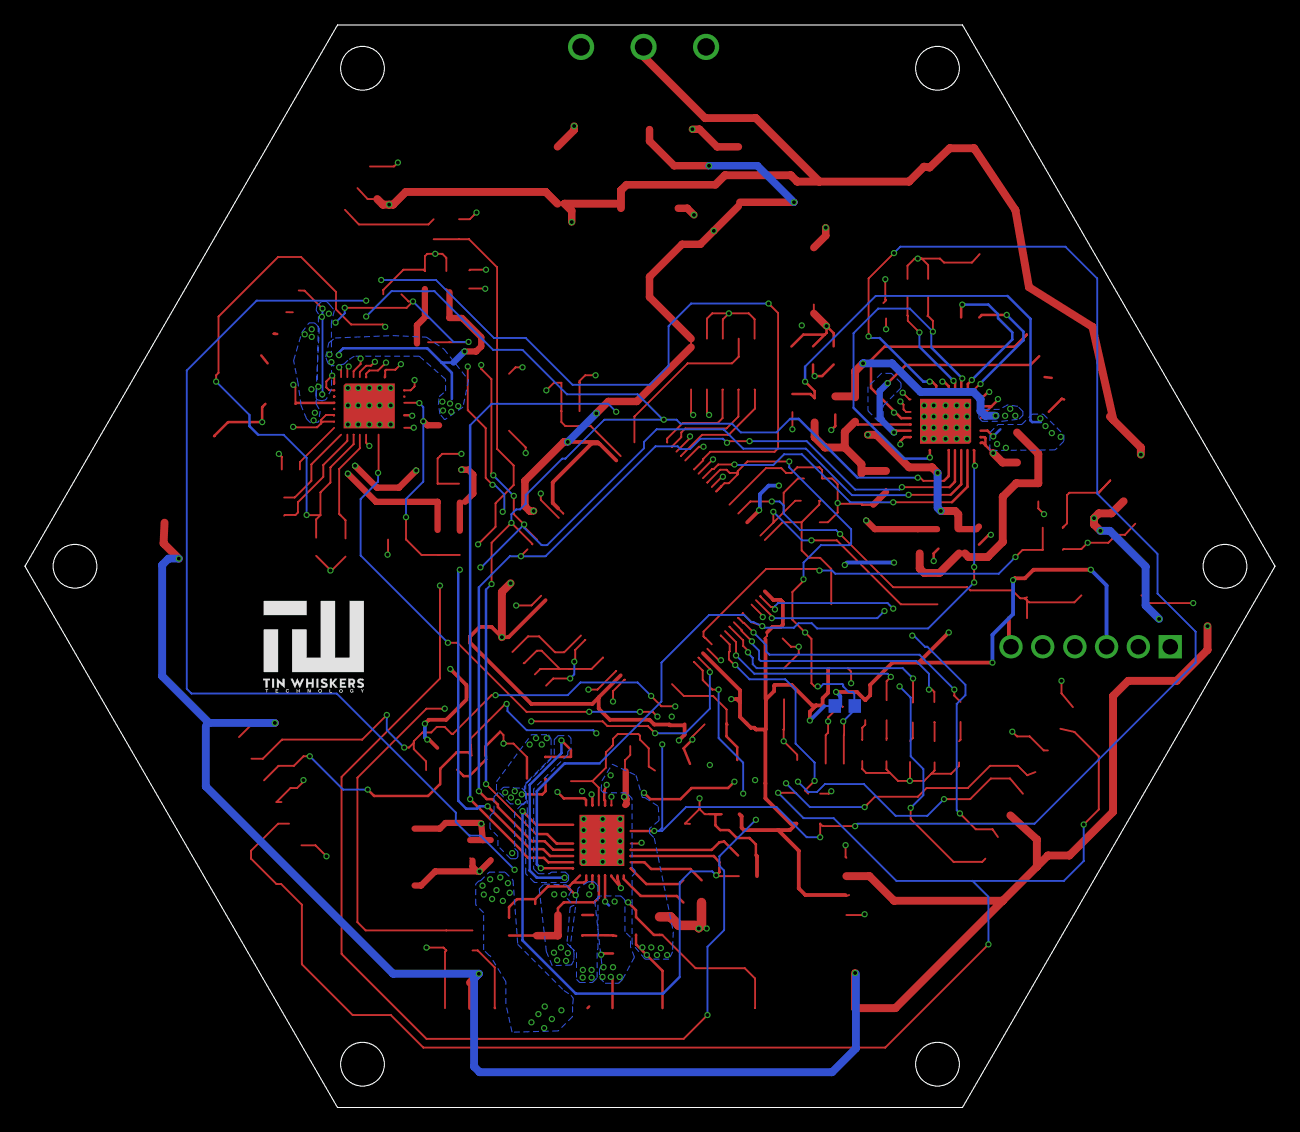
[picture p34: board EMC03-Motion Control.brd from below]

Board: 4 copper layers, 100.0 x 86.6 mm, 132 parts (2 on the bottom side), 82 nets.
