firepick-delta/fpd-electronics/EAGLE/ELED04 - ULC ring light LED board/ELED04.brd

## EAGLE design EAGLE/ELED04 - ULC ring light LED board/ELED04.brd (2015-10-16)

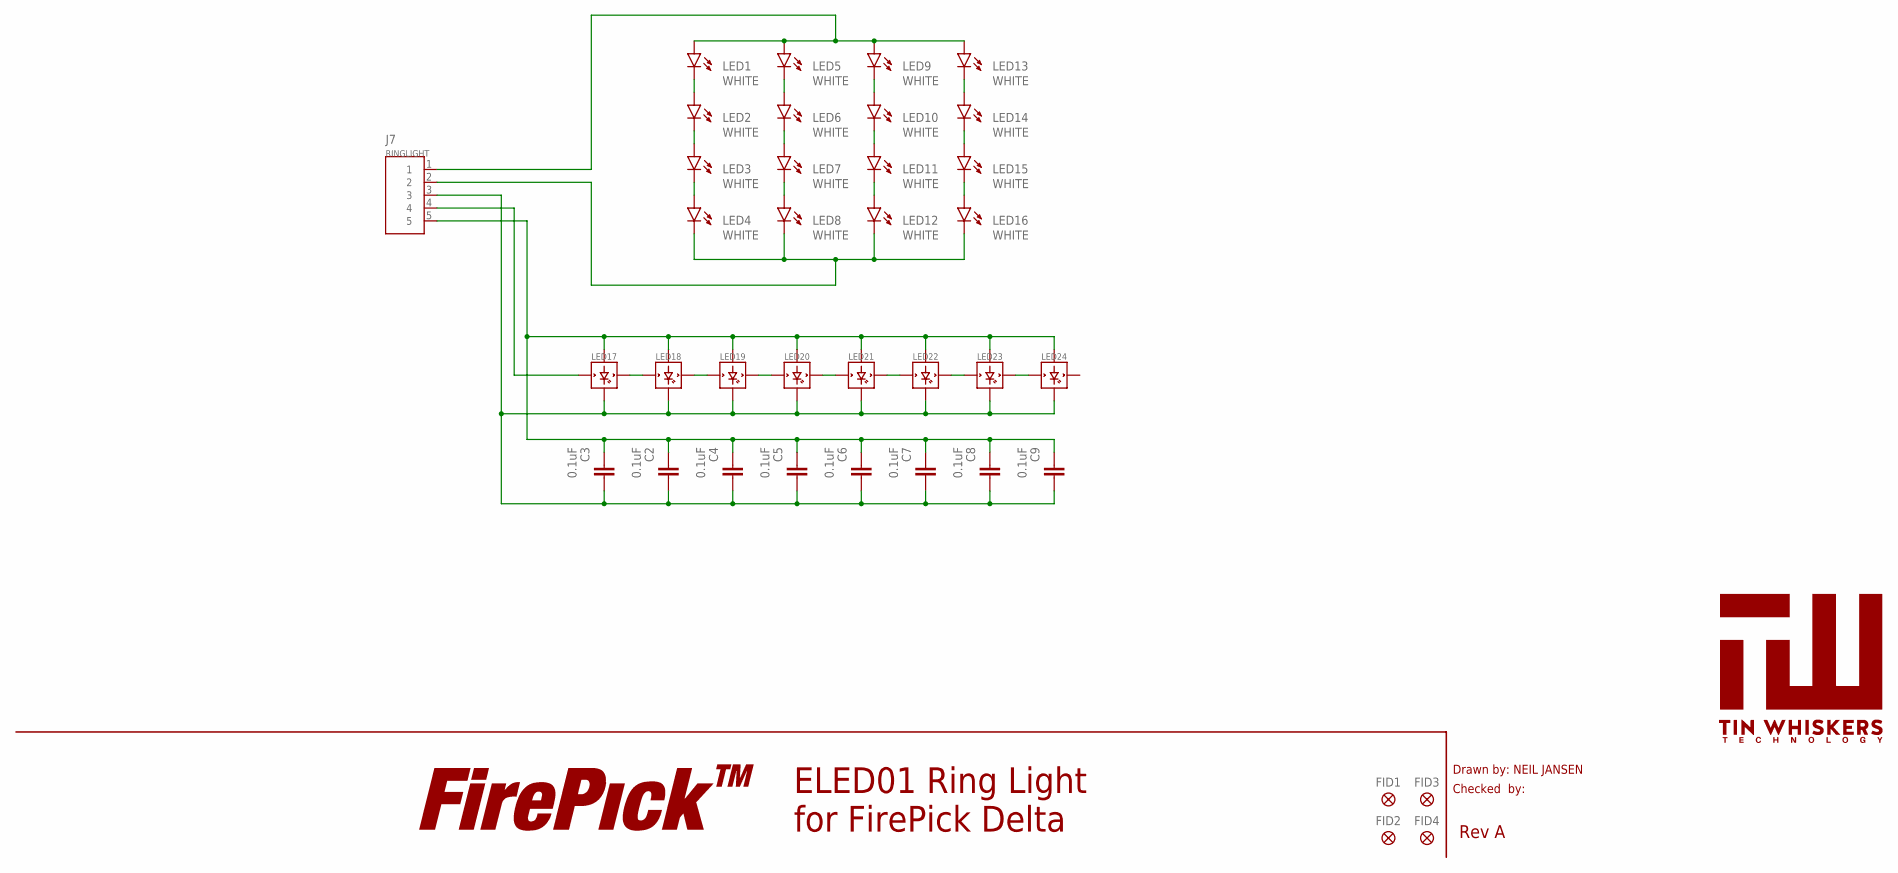
[picture p35: schematic ELED04.sch]

Parts:
C2, C3, C4, C5, C6, C7, C8, C9: 0.1uF; C0603; PARTNO GMK107BJ104KAHT
FID1, FID2, FID3, FID4: FIDUCIAL; PARTNO *
J7: RINGLIGHT; CON-JST-PH-2.0MM-5P-SMT-VRT; PARTNO B5B-PH-SM4-TB(LF)(SN)
LED1, LED2, LED3, LED4, LED5, LED6, LED7, LED8, LED9, LED10, LED11, LED12, LED13, LED14, LED15, LED16: WHITE; DIODE-1210; PARTNO QBLP650-IW
LED17, LED18, LED19, LED20, LED21, LED22, LED23, LED24: WS2812B; PARTNO 1655
LOGO4: LOGO-FIREPICKMEDIUM; LOGO-FIREPICK-MEDIUM
U$3: TIN-WHISKERSSMALL; TIN-WHISKERS-SMALL; PARTNO *

Connections:
+5V: C2.1, C3.1, C4.1, C5.1, C6.1, C7.1, C8.1, C9.1, J7.5, LED17.1-VDD (VDD), LED18.1-VDD (VDD), LED19.1-VDD (VDD), LED20.1-VDD (VDD), LED21.1-VDD (VDD), LED22.1-VDD (VDD), LED23.1-VDD (VDD), LED24.1-VDD (VDD)
GND: C2.2, C3.2, C4.2, C5.2, C6.2, C7.2, C8.2, C9.2, J7.3, LED17.3-GND (GND), LED18.3-GND (GND), LED19.3-GND (GND), LED20.3-GND (GND), LED21.3-GND (GND), LED22.3-GND (GND), LED23.3-GND (GND), LED24.3-GND (GND)
LED+: J7.1, LED1.A, LED5.A, LED9.A, LED13.A
LED-: J7.2, LED4.K (C), LED8.K (C), LED12.K (C), LED16.K (C)
unnamed: LED1.K (C), LED2.A
unnamed: LED17.2-DOUT (DOUT), LED18.4-DIN (DIN)
unnamed: LED3.K (C), LED4.A
unnamed: LED7.K (C), LED8.A
unnamed: LED18.2-DOUT (DOUT), LED19.4-DIN (DIN)
unnamed: LED2.K (C), LED3.A
unnamed: LED6.K (C), LED7.A
unnamed: LED10.K (C), LED11.A
unnamed: LED14.K (C), LED15.A
unnamed: LED19.2-DOUT (DOUT), LED20.4-DIN (DIN)
unnamed: LED20.2-DOUT (DOUT), LED21.4-DIN (DIN)
unnamed: LED9.K (C), LED10.A
unnamed: LED5.K (C), LED6.A
unnamed: LED11.K (C), LED12.A
unnamed: LED21.2-DOUT (DOUT), LED22.4-DIN (DIN)
unnamed: LED22.2-DOUT (DOUT), LED23.4-DIN (DIN)
unnamed: LED13.K (C), LED14.A
unnamed: LED23.2-DOUT (DOUT), LED24.4-DIN (DIN)
unnamed: LED15.K (C), LED16.A
unnamed: J7.4, LED17.4-DIN (DIN)

Notes on the sheet:
Drawn by: NEIL JANSEN
Checked by:
Rev A
ELED01 Ring Light for FirePick Delta

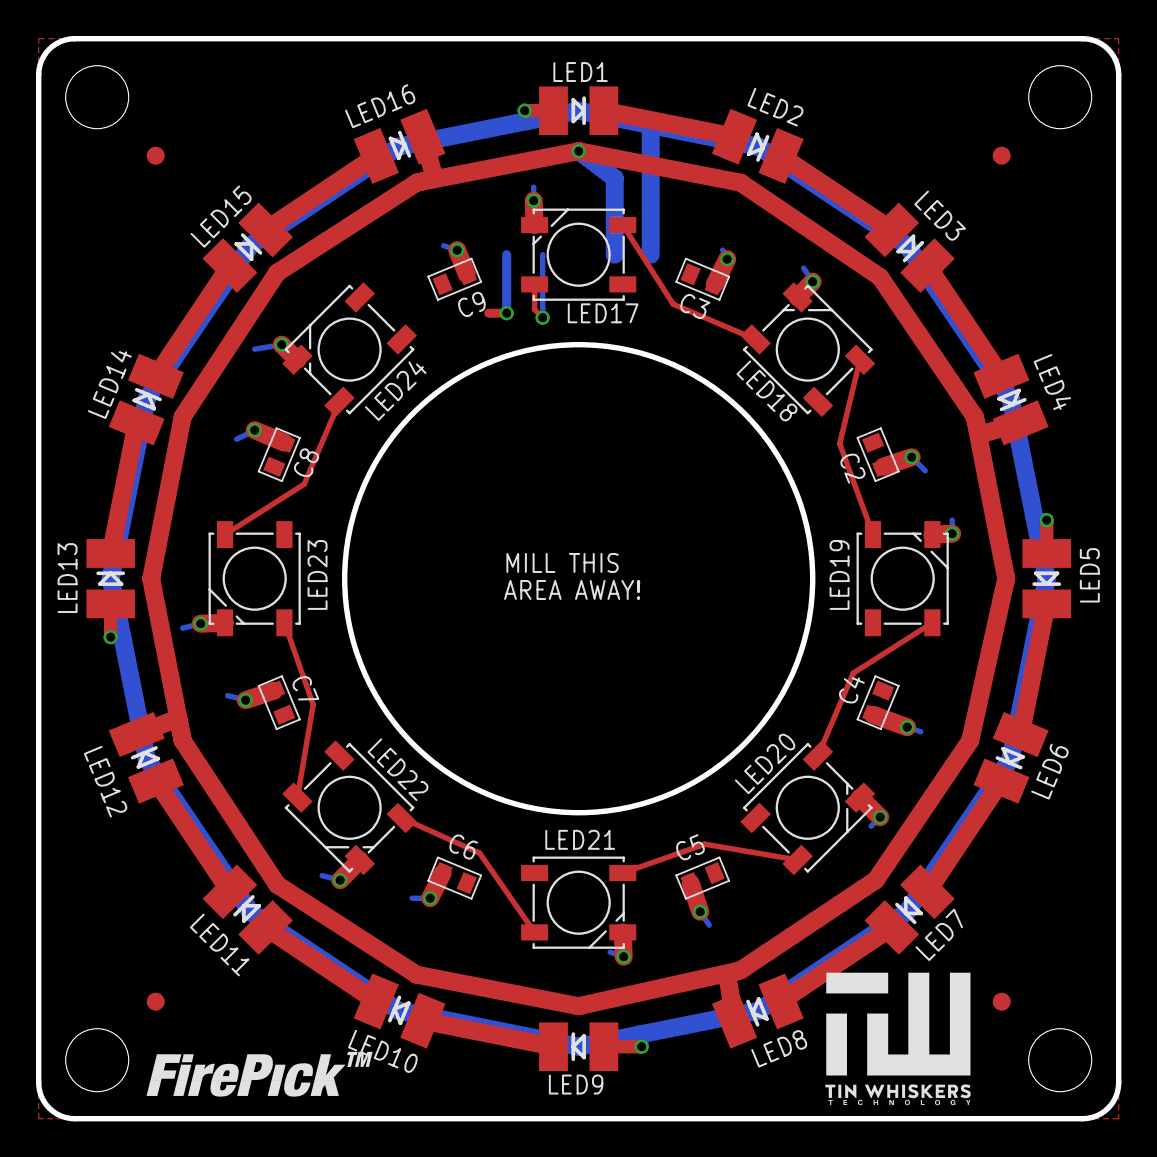
[picture p36: board ELED04.brd from above]

Board: 2 copper layers, 60.0 x 60.0 mm, 39 parts (1 on the bottom side), 24 nets.
