firepick-delta/fpd-electronics/EAGLE/EBR01 - TMC2130 breakout board/EBR01_1.brd

## EAGLE design EAGLE/EBR01 - TMC2130 breakout board/EBR01_1.brd (2015-10-06)

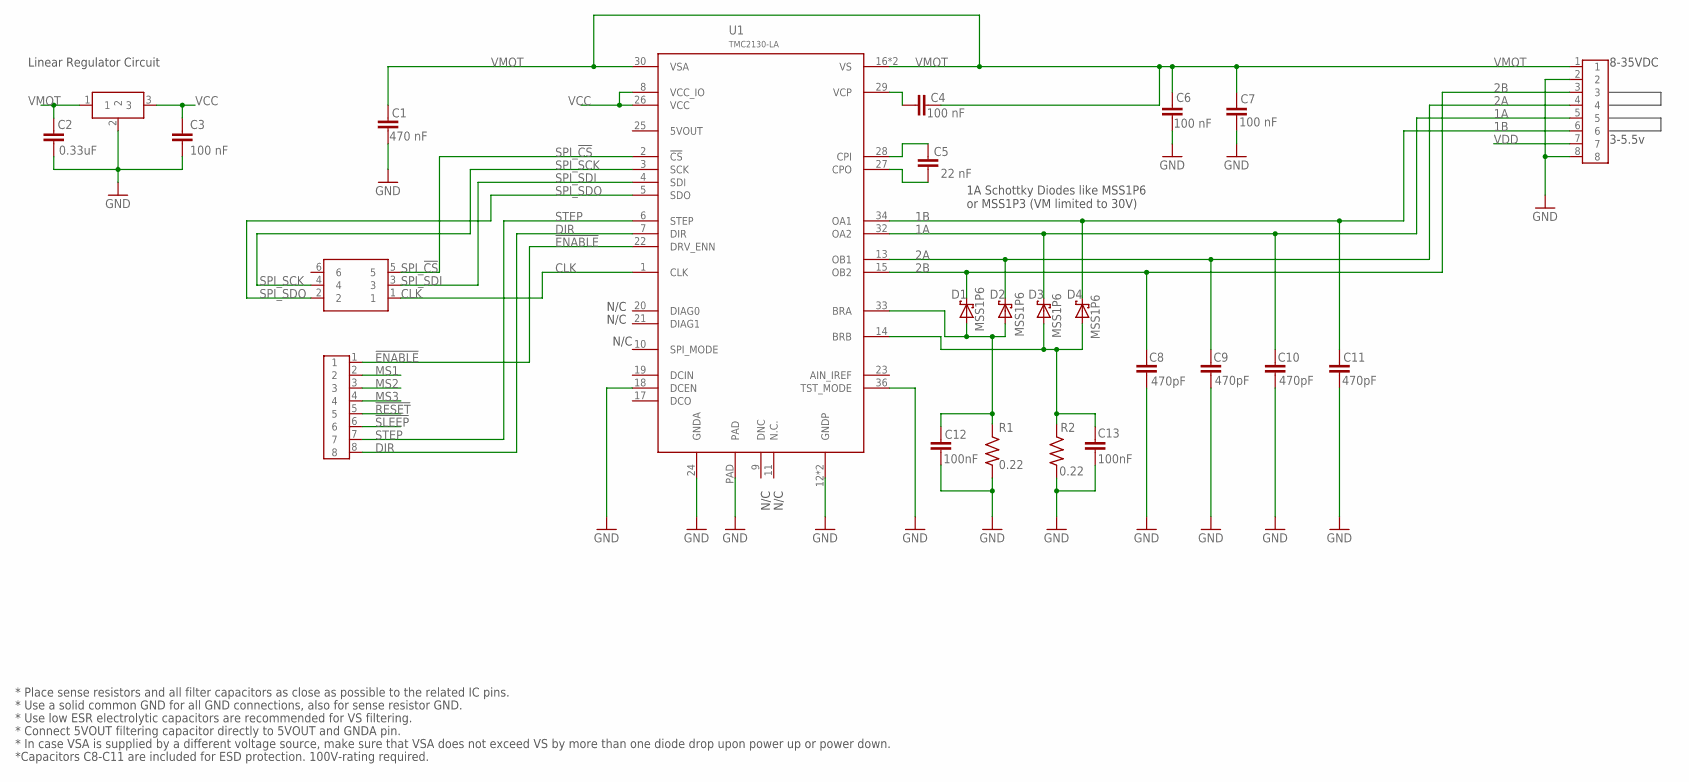
[picture p37: schematic EBR01_1.sch]

Parts:
C1: 470 nF; C0603
C2: 0.33uF; C0603
C3, C4, C6, C7: 100 nF; C0603
C5: 22 nF; C0603
C8, C9, C10, C11: 470pF; C0603
C12, C13: 100nF; C0603
D1, D2, D3, D4: MSS1P6; MICRO-SMP
J1, J2: CPL-CON-HEADER-0.1IN-8P-M; CON-HDR-8POS-MALE
J3: CPL-CON-HEADER-0.1IN-2X3P-M; CON-HDR-2X3P
Q1: CPL-REG-LIN-5V-0.1A; SOT-89
R1, R2: 0.22; R1206
U1: TMC2130-LA; QFN36-(5X6)

Connections:
1A: C10.1, D3.NEG (C), J2.5, U1.32 (OA2)
1B: C11.1, D4.NEG (C), J2.6, U1.34 (OA1)
2A: C9.1, D2.NEG (C), J2.4, U1.13 (OB1)
2B: C8.1, D1.NEG (C), J2.3, U1.15 (OB2)
!ENABLE!: J1.1, U1.22 (DRV_ENN)
!RESET!: J1.5
!SLEEP!: J1.6
BRA: C12.1, D1.POS (A), D2.POS (A), R1.2, U1.33 (BRA)
BRB: C13.1, D3.POS (A), D4.POS (A), R2.2, U1.14 (BRB)
CLK: J3.1, U1.1 (CLK)
CPI: C5.2, U1.28 (CPI)
CPO: C5.1, U1.27 (CPO)
DIR: J1.8, U1.7 (DIR)
GND: C1.1, C2.1, C3.1, C6.2, C7.2, C8.2, C9.2, C10.2, C11.2, C12.2, C13.2, J2.2, J2.8, Q1.2, R1.1, R2.1, U1.12 (GNDP), U1.18 (DCEN), U1.24 (GNDA), U1.35 (GNDP), U1.36 (TST_MODE), U1.PAD
MS1: J1.2
MS2: J1.3
MS3: J1.4
SPI_!CS!: J3.5, U1.2 (!CS)
SPI_SCK: J3.4, U1.3 (SCK)
SPI_SDI: J3.3, U1.4 (SDI)
SPI_SDO: J3.2, U1.5 (SDO)
STEP: J1.7, U1.6 (STEP)
VCC: C3.2, Q1.3, U1.8 (VCC_IO), U1.26 (VCC)
VCP: C4.1, U1.29 (VCP)
VDD: J2.7
VMOT: C1.2, C2.2, C4.2, C6.1, C7.1, J2.1, Q1.1, U1.16 (VS), U1.30 (VSA), U1.31 (VS)

Notes on the sheet:
3-5.5v
8-35VDC
N/C
* Place sense resistors and all filter capacitors as close as possible to the related IC pins.
* Use a solid common GND for all GND connections, also for sense resistor GND.
* Use low ESR electrolytic capacitors are recommended for VS filtering.
* Connect 5VOUT filtering capacitor directly to 5VOUT and GNDA pin.
* In case VSA is supplied by a different voltage source, make sure that VSA does not exceed VS by more than one diode drop upon power up or power down.
1A Schottky Diodes like MSS1P6 or MSS1P3 (VM limited to 30V)
Linear Regulator Circuit
*Capacitors C8-C11 are included for ESD protection. 100V-rating required.

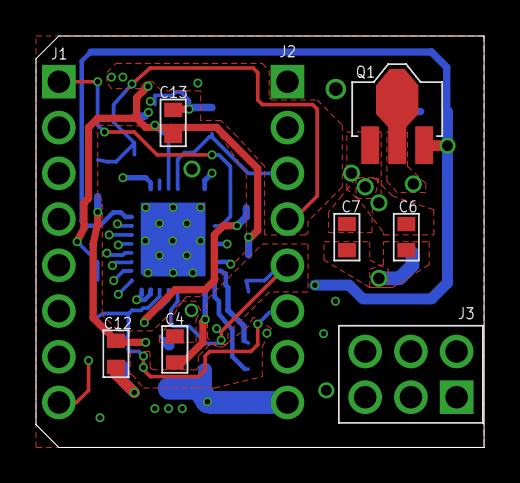
[picture p38: board EBR01_1.brd from above]

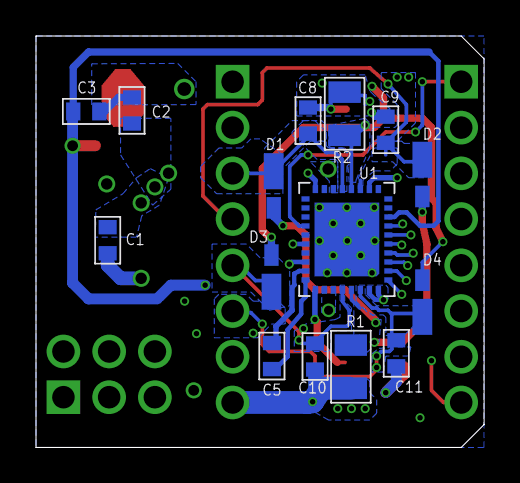
[picture p39: board EBR01_1.brd from below]

Board: 4 copper layers, 24.9 x 22.9 mm, 24 parts (15 on the bottom side), 20 nets.
