firepick-delta/fpd-electronics/EAGLE/BOM Generation/SampleProject/MicroRC/MicroRC-C.brd

## EAGLE design EAGLE/BOM Generation/SampleProject/MicroRC/MicroRC-C.brd (2015-09-14)

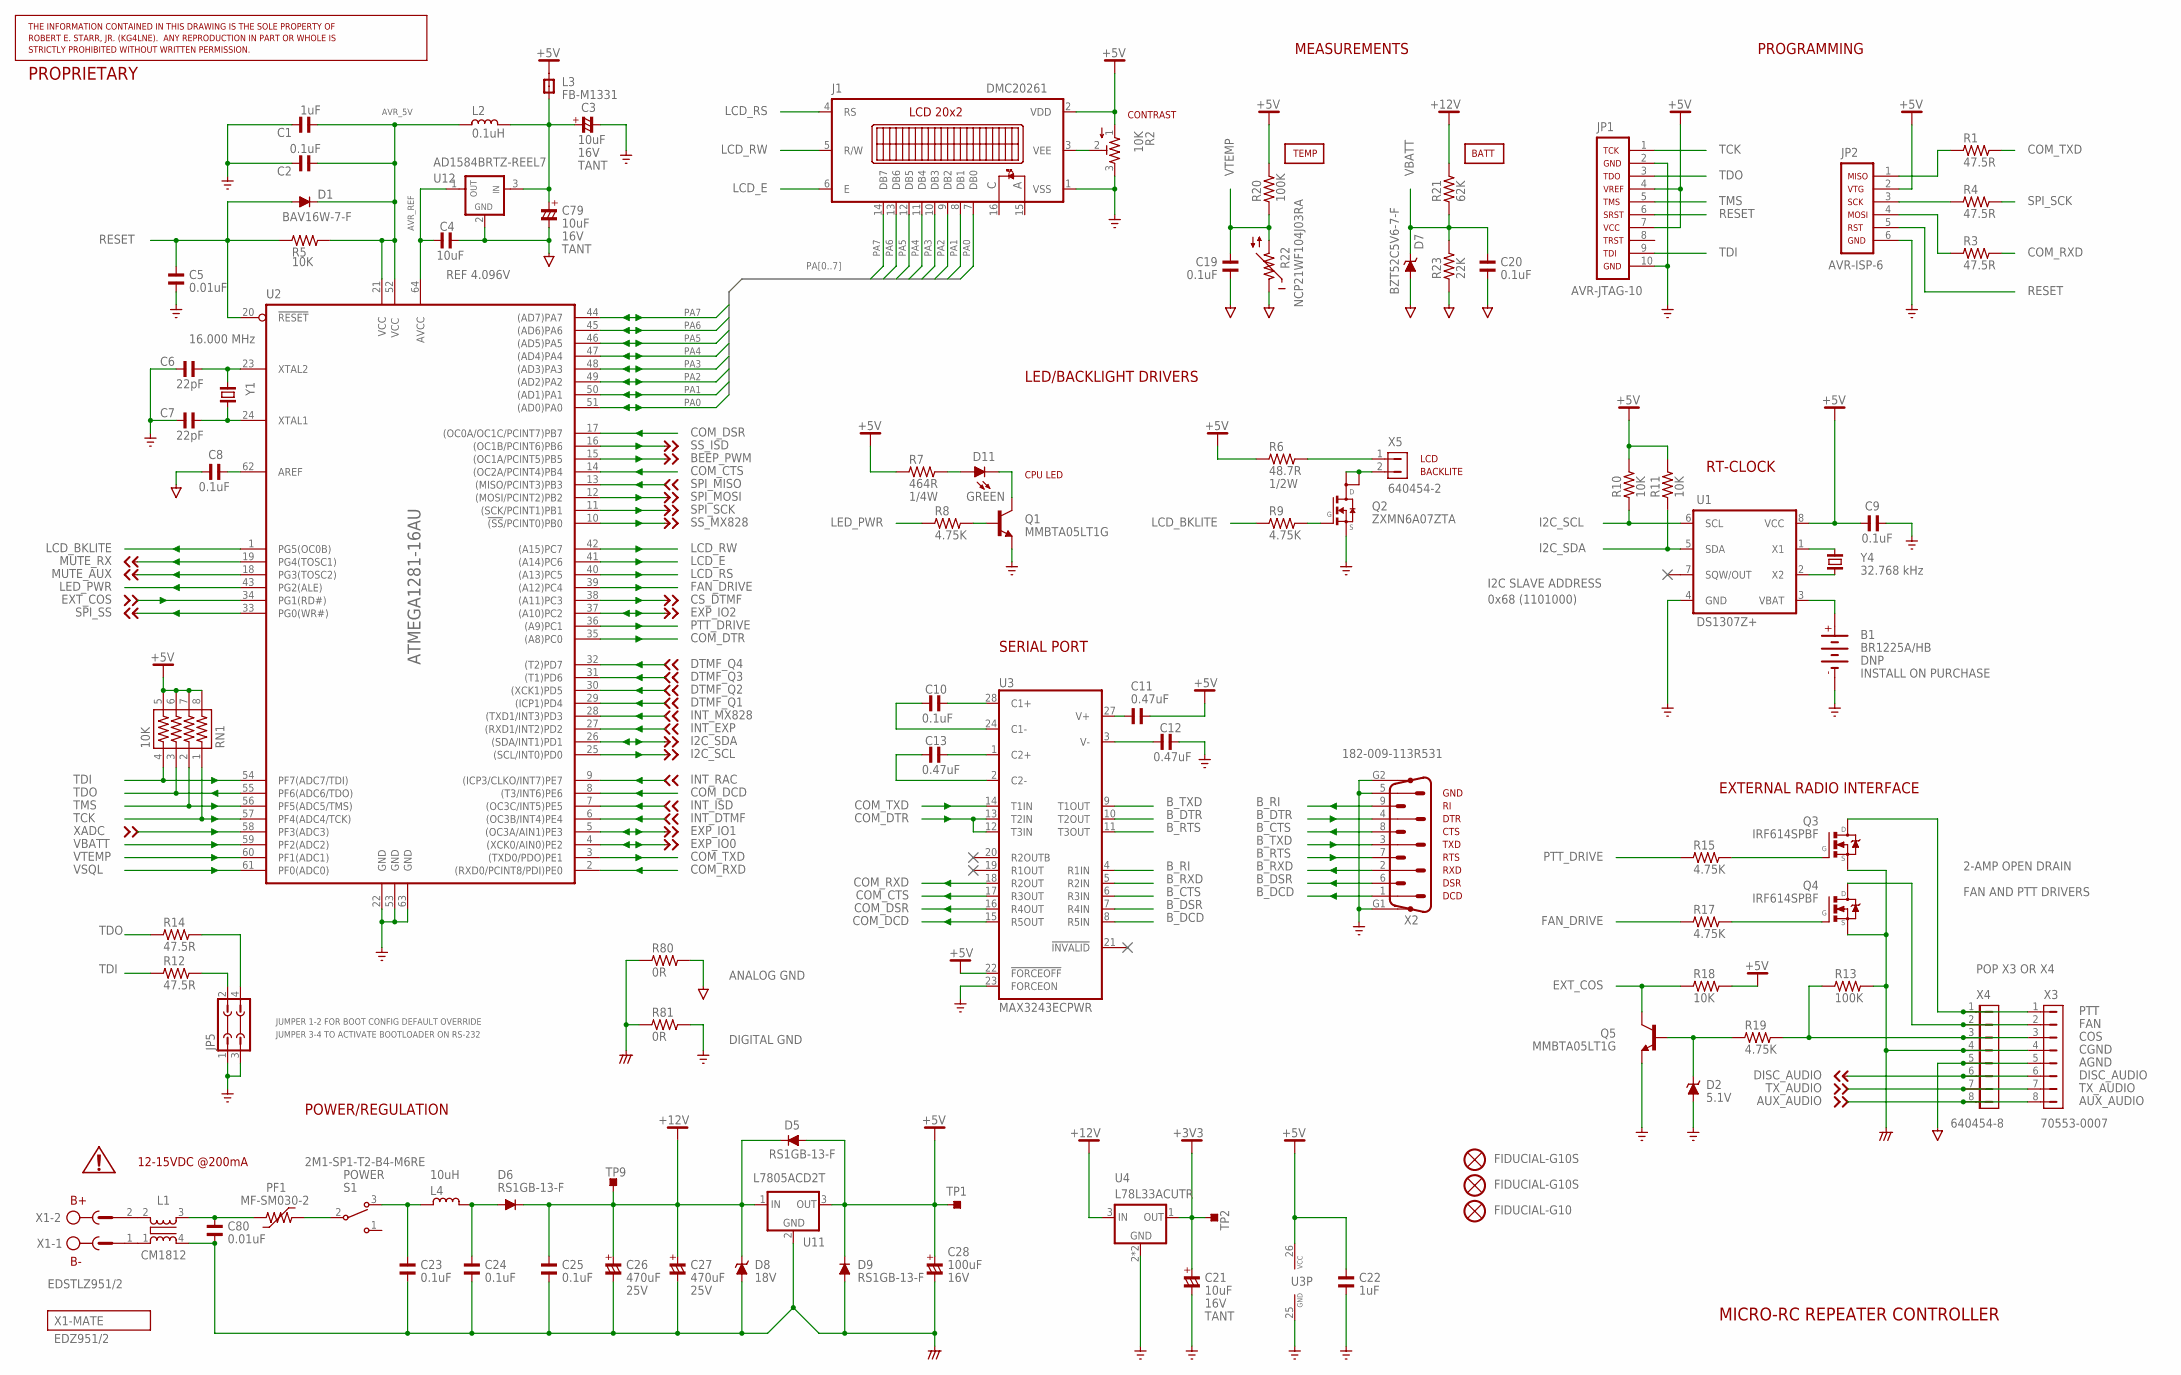
[picture p40: schematic MicroRC-C.sch, sheet 1]

Parts:
B1: BR1225A/HB; BR1225; PARTNO BR1225A/HB
C1, C22: 1uF; C0805; PARTNO C0805C105Z3VACTU
C2, C8, C9, C10, C19, C20: 0.1uF; C0805; PARTNO C0805F104K5RACTU
C3, C21, C79: 10uF; C3528/T; PARTNO T491B106M016AT
C4: 10uF; C0805; PARTNO C0805C106K9PACTU
C5: 0.01uF; C0805; PARTNO C0805C103K5RACTU
C6, C7: 22pF; C0805; PARTNO C0805C220J5GACTU
C11, C12, C13: 0.47uF; C0805; PARTNO C0805F474K3RACTU
C23, C24, C25: 0.1uF; C1206; PARTNO C1206C104K5RACTU
C26, C27: 470uF; CSV-G; PARTNO EEE-1EA471P
C28: 100uF; CSV-E/F; PARTNO EEE-1CA101P
C80: 0.01uF; C1206; PARTNO 12065C103KAT2A
D1: BAV16W-7-F; SOD123; PARTNO BAV16W-7-F
D2: 5.1V; SOD123; PARTNO BZT52C5V1-7-F
D5, D6, D9: RS1GB-13-F; SMB; PARTNO RS1GB-13-F
D7: BZT52C5V6-7-F; SOD123; PARTNO BZT52C5V6-7-F
D8: 18V; SMB; PARTNO 1SMB5931BT3G
D11: GREEN; LED535; PARTNO 5350T5
FIDUCIAL1, FIDUCIAL2: FIDUCIAL-G10S; G10S
FIDUCIAL3: FIDUCIAL-G10; G10
J1: DMC20261; PARTNO *
JP1: AVR-JTAG-10; PARTNO *
JP2: AVR-ISP-6
JP5: JP2Q; PARTNO *
L1: CM1812; PARTNO CM1812R600R-10
L2: 0.1uH; L1206; PARTNO PM1210-R10J
L3: FB-M1331; L1206; PARTNO PM2001-200
L4: 10uH; PM-13; PARTNO PM3308-100M
PF1: MF-SM030-2; SMD-7555; PARTNO MF-SM030-2
Q1, Q5: MMBTA05LT1G; SOT23; PARTNO MMBTA05LT1G
Q2: ZXMN6A07ZTA; SOT89; PARTNO ZXMN6A07ZTA
Q3, Q4: IRF614SPBF; D2PAK; PARTNO IRF614SPBF
R1, R3, R4, R12, R14: 47.5R; R0805; PARTNO ERJ-6ENF47R5V
R2: 10K; EVM-L4G; PARTNO EVM-L4GA00B14
R5, R10, R11, R18: 10K; R0805; PARTNO ERJ-6ENF1002V
R6: 48.7R; R2010; PARTNO ERJ-12SF48R7U
R7: 464R; R1210; PARTNO ERJ-14NF4640U
R8, R9, R15, R17, R19: 4.75K; R0805; PARTNO ERJ-6ENF4751V
R13, R20: 100K; R0805; PARTNO ERJ-6ENF1003V
R21: 62K; R0805; PARTNO ERJ-6ENF6192V
R22: NCP21WF104J03RA; R0805; PARTNO NCP21WF104J03RA
R23: 22K; R0805; PARTNO ERJ-6ENF2212V
R80, R81: 0R; R0805; PARTNO RC0805JR-070RL
RN1: 10K; 744-8; PARTNO 744C083103JPTR
S1: 2M1-SP1-T2-B4-M6RE; CK-A; PARTNO 2M1-SP1-T2-B4-M6RE
TP1, TP2, TP9: TPTP10SQ; TP10SQ
U1: DS1307Z+; SO08; PARTNO DS1307Z+
U2: ATMEGA1281-16AU; TQFP64-AEB; PARTNO ATMEGA1281-16AU
U3: MAX3243ECPWR; TSSOP28; PARTNO MAX3243ECPWR
U4: L78L33ACUTR; SOT89-4; PARTNO L78L33ACUTR
U11: L7805ACD2T; D2PAK; PARTNO L7805ACD2T
U12: AD1584BRTZ-REEL7; SOT23; PARTNO AD1584BRTZ-REEL7
X1: EDSTLZ951/2; 951-2; PARTNO EDSTLZ951/2
X2: 182-009-113R531; NC182M9; PARTNO 182-009-113R531
X3: 70553-0007; 70553-08; PARTNO 70553-0007
X4: 640454-8; MTA08-100; PARTNO 640454-8
X5: 640454-2; MTA-100-2V; PARTNO 640454-2
Y1: 16.000 MHz; TC38H; PARTNO ECS-160-18-9X
Y4: 32.768 kHz; TC26H; PARTNO ECS-.327-12.5-13X

Connections:
+3V3: C21.+, TP2.TP, U4.1 (OUT); also elsewhere on the board
+5V: C9.1, C11.1, C22.1, C28.+, D5.A, D9.C, J1.2 (VDD), JP1.4, JP1.7, JP2.2, L3.2, R2.1, R6.1, R7.1, R10.2, R11.2, R18.2, R20.2, RN1.5, RN1.6, RN1.7, RN1.8, TP1.TP, U1.8 (VCC), U3.22 (!FORCEOFF!), U3.26 (VCC), U11.3 (OUT); also elsewhere on the board
+12V: C25.1, C26.+, C27.+, D5.C, D6.C, D8.C, R21.2, TP9.TP, U4.3 (IN), U11.1 (IN); also elsewhere on the board
AGND: C4.1, C8.2, C19.2, C20.2, C79.-, D7.A, R22.1, R23.1, R80.2, U12.2 (GND), X3.5, X4.5; also elsewhere on the board
AUX_AUDIO: X3.8, X4.8; also elsewhere on the board
AVR_5V: C1.1, C2.1, D1.C, L2.2, R5.2, U2.21 (VCC), U2.52 (VCC1)
AVR_REF: C4.2, U2.64 (AVCC), U12.1 (OUT)
BEEP_PWM: U2.15 ((OC1A/PCINT5)PB5); also elsewhere on the board
B_CTS: U3.6 (R3IN), X2.8
B_DCD: U3.8 (R5IN), X2.1
B_DSR: U3.7 (R4IN), X2.6
B_DTR: U3.10 (T2OUT), X2.4
B_RI: U3.4 (R1IN), X2.9
B_RTS: U3.11 (T3OUT), X2.7
B_RXD: U3.5 (R2IN), X2.2
B_TXD: U3.9 (T1OUT), X2.3
CGND: C23.2, C24.2, C25.2, C26.-, C27.-, C28.-, C80.2, D8.A, D9.A, L1.4, Q3.3 (S), Q4.3 (S), R13.2, R80.1, R81.1, U11.2 (GND), X3.4, X4.4
COM_CTS: U2.14 ((OC2A/PCINT4)PB4), U3.17 (R3OUT)
COM_DCD: U2.8 ((T3/INT6)PE6), U3.15 (R5OUT)
COM_DSR: U2.17 ((OC0A/OC1C/PCINT7)PB7), U3.16 (R4OUT)
COM_DTR: U2.35 ((A8)PC0), U3.12 (T3IN), U3.13 (T2IN)
COM_RXD: R3.2, U2.2 ((RXD0/PCINT8/PDI)PE0), U3.18 (R2OUT)
COM_TXD: R1.2, U2.3 ((TXD0/PDO)PE1), U3.14 (T1IN)
COS: R13.1, R19.2, X3.3, X4.3
CS_DTMF: U2.38 ((A11)PC3); also elsewhere on the board
DISC_AUDIO: X3.6, X4.6; also elsewhere on the board
DTMF_Q1: U2.29 ((ICP1)PD4); also elsewhere on the board
DTMF_Q2: U2.30 ((XCK1)PD5); also elsewhere on the board
DTMF_Q3: U2.31 ((T1)PD6); also elsewhere on the board
DTMF_Q4: U2.32 ((T2)PD7); also elsewhere on the board
EXP_IO0: U2.4 ((XCK0/AIN0)PE2); also elsewhere on the board
EXP_IO1: U2.5 ((OC3A/AIN1)PE3); also elsewhere on the board
EXP_IO2: U2.37 ((A10)PC2); also elsewhere on the board
EXT_COS: Q5.3 (C), R18.1, U2.34 (PG1(RD#))
FAN: Q4.2 (D), X3.2, X4.2
FAN_DRIVE: R17.1, U2.39 ((A12)PC4)
GND: B1.-, C1.2, C2.2, C3.-, C5.2, C6.2, C7.2, C9.2, C12.1, C21.-, C22.2, D2.A, J1.1 (VSS), JP1.2, JP1.10, JP2.6, JP5.1, JP5.3, Q1.2 (E), Q2.3 (S), Q5.2 (E), R2.3, R81.2, U1.4 (GND), U2.22 (GND), U2.53 (GND1), U2.63 (GND2), U3.23 (FORCEON), U3.25 (GND), U4.2 (GND), U4.4 (GND), X2.5, X2.G1, X2.G2; also elsewhere on the board
I2C_SCL: R10.1, U1.6 (SCL), U2.25 ((SCL/INT0)PD0); also elsewhere on the board
I2C_SDA: R11.1, U1.5 (SDA), U2.26 ((SDA/INT1)PD1); also elsewhere on the board
INT_DTMF: U2.6 ((OC3B/INT4)PE4); also elsewhere on the board
INT_EXP: U2.27 ((RXD1/INT2)PD2); also elsewhere on the board
INT_ISD: U2.7 ((OC3C/INT5)PE5); also elsewhere on the board
INT_MX828: U2.28 ((TXD1/INT3)PD3); also elsewhere on the board
INT_RAC: U2.9 ((ICP3/CLKO/INT7)PE7); also elsewhere on the board
LCD_BKLITE: R9.1, U2.1 (PG5(OC0B))
LCD_E: J1.6 (E), U2.41 ((A14)PC6)
LCD_RS: J1.4 (RS), U2.40 ((A13)PC5)
LCD_RW: J1.5 (R/W), U2.42 ((A15)PC7)
LED_PWR: R8.1, U2.43 (PG2(ALE))
MUTE_AUX: U2.18 (PG3(TOSC2)); also elsewhere on the board
MUTE_RX: U2.19 (PG4(TOSC1)); also elsewhere on the board
unnamed: L1.1, X1.1
unnamed: C8.1, U2.62 (AREF)
unnamed: JP5.2, R12.2
unnamed: C23.1, L4.1, S1.3 (O)
unnamed: L1.2, X1.2
unnamed: C24.1, D6.A, L4.2
unnamed: U1.1 (X1), Y4.2
unnamed: U1.2 (X2), Y4.1
unnamed: C7.1, U2.24 (XTAL1), Y1.1
unnamed: JP5.4, R14.2
unnamed: C12.2, U3.3 (V-)
unnamed: C11.2, U3.27 (V+)
unnamed: C6.1, U2.23 (XTAL2), Y1.2
unnamed: C13.1, U3.1 (C2+)
unnamed: C10.1, U3.28 (C1+)
unnamed: C13.2, U3.2 (C2-)
unnamed: C10.2, U3.24 (C1-)
unnamed: B1.+, U1.3 (VBAT)
unnamed: Q3.1 (G), R15.2
unnamed: Q2.1 (G), R9.2
unnamed: Q2.2 (D), Q2.4 (D2), X5.2
unnamed: R6.2, X5.1
unnamed: D2.C, Q5.1 (B), R19.1
unnamed: PF1.2, S1.2
unnamed: Q4.1 (G), R17.2
unnamed: C80.1, L1.3, PF1.1
unnamed: C3.+, C79.+, L2.1, L3.1, U12.3 (IN)
unnamed: D11.K (C), Q1.3 (C)
unnamed: D11.A, R7.2
unnamed: Q1.1 (B), R8.2
unnamed: JP2.1, R1.1
unnamed: JP2.3, R4.1
unnamed: JP2.4, R3.1
PA0: J1.7 (DB0), U2.51 ((AD0)PA0)
PA1: J1.8 (DB1), U2.50 ((AD1)PA1)
PA2: J1.9 (DB2), U2.49 ((AD2)PA2)
PA3: J1.10 (DB3), U2.48 ((AD3)PA3)
PA4: J1.11 (DB4), U2.47 ((AD4)PA4)
PA5: J1.12 (DB5), U2.46 ((AD5)PA5)
PA6: J1.13 (DB6), U2.45 ((AD6)PA6)
PA7: J1.14 (DB7), U2.44 ((AD7)PA7)
PTT: Q3.2 (D), X3.1, X4.1
PTT_DRIVE: R15.1, U2.36 ((A9)PC1)
RESET: C5.1, D1.A, JP1.6, JP2.5, R5.1, U2.20 (!RESET!)
SPI_MISO: U2.13 ((MISO/PCINT3)PB3); also elsewhere on the board
SPI_MOSI: U2.12 ((MOSI/PCINT2)PB2); also elsewhere on the board
SPI_SCK: R4.2, U2.11 ((SCK/PCINT1)PB1); also elsewhere on the board
SPI_SS: U2.33 (PG0(WR#)); also elsewhere on the board
SS_ISD: U2.16 ((OC1B/PCINT6)PB6); also elsewhere on the board
SS_MX828: U2.10 (!(SS!/PCINT0)PB0); also elsewhere on the board
TCK: JP1.1, RN1.1, U2.57 (PF4(ADC4/TCK))
TDI: JP1.9, R12.1, RN1.4, U2.54 (PF7(ADC7/TDI))
TDO: JP1.3, R14.1, RN1.3, U2.55 (PF6(ADC6/TDO))
TMS: JP1.5, RN1.2, U2.56 (PF5(ADC5/TMS))
TX_AUDIO: X3.7, X4.7; also elsewhere on the board
VBATT: C20.1, D7.C, R21.1, R23.2, U2.59 (PF2(ADC2))
VEE_LCD: J1.3 (VEE), R2.2
VSQL: U2.61 (PF0(ADC0)); also elsewhere on the board
VTEMP: C19.1, R20.1, R22.2, U2.60 (PF1(ADC1))
XADC: U2.58 (PF3(ADC3)); also elsewhere on the board

Notes on the sheet:
MICRO-RC REPEATER CONTROLLER
BATT
TEMP
CONTRAST
BACKLITE
LCD
RT-CLOCK
SERIAL PORT
DCD
CPU LED
DSR
RXD
RTS
TXD
CTS
DTR
GND
MEASUREMENTS
POWER/REGULATION
EXTERNAL RADIO INTERFACE
LED/BACKLIGHT DRIVERS
PROGRAMMING
12-15VDC @200mA
POWER
ANALOG GND
DIGITAL GND
2-AMP OPEN DRAIN
FAN AND PTT DRIVERS
REF 4.096V
JUMPER 1-2 FOR BOOT CONFIG DEFAULT OVERRIDE
JUMPER 3-4 TO ACTIVATE BOOTLOADER ON RS-232
I2C SLAVE ADDRESS
0x68 (1101000)

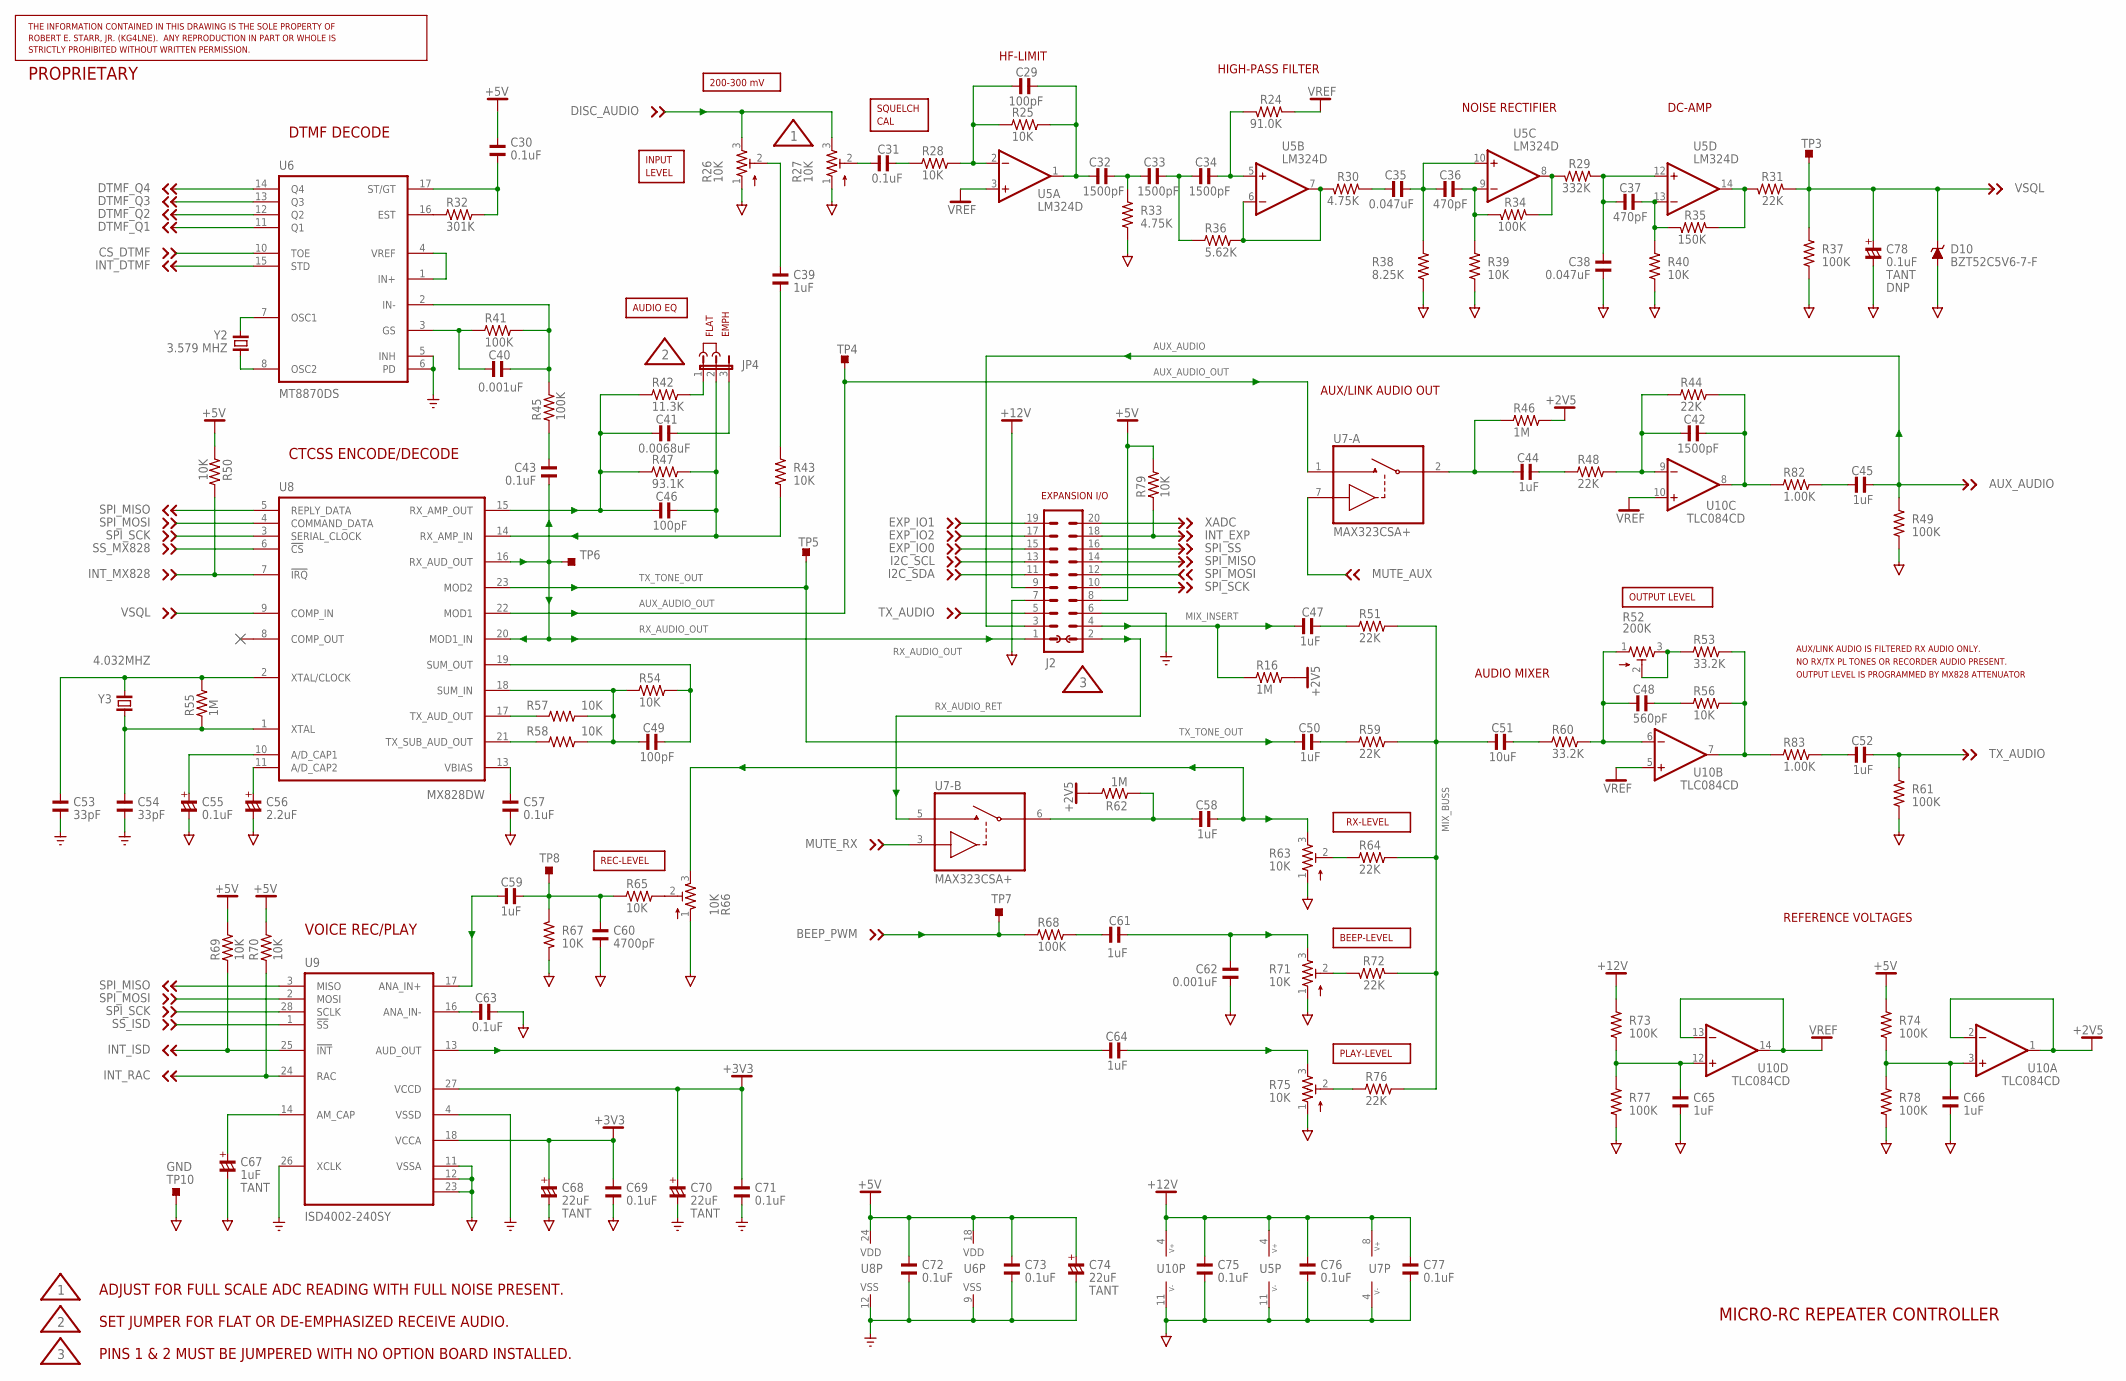
[picture p41: schematic MicroRC-C.sch, sheet 2]

Parts:
C29, C46, C49: 100pF; C0805; PARTNO C0805C101J5GACTU
C30, C31, C43, C57, C63, C69, C71, C72, C73, C75, C76, C77: 0.1uF; C0805; PARTNO C0805F104K5RACTU
C32, C33, C34, C42: 1500pF; C0805; PARTNO C0805C152K5RACTU
C35, C38: 0.047uF; C0805; PARTNO C0805C473K5RACTU
C36, C37: 470pF; C0805; PARTNO C0805C471J5GACTU
C39, C44, C45, C47, C50, C52, C58, C59, C61, C64, C65, C66: 1uF; C0805; PARTNO C0805C105Z3VACTU
C40, C62: 0.001uF; C0805; PARTNO C0805C102K5RACTU
C41: 0.0068uF; C0805; PARTNO C0805C682K5RACTU
C48: 560pF; C0805; PARTNO C0805C561J5GACTU
C51: 10uF; C0805; PARTNO C0805C106K9PACTU
C53, C54: 33pF; C0805; PARTNO C0805C330J5GACTU
C55: 0.1uF; C3216/T; PARTNO T491A104K035AT
C56: 2.2uF; C3216/T; PARTNO T491A225K010AT
C60: 4700pF; C0805; PARTNO C0805C472K5RACTU
C67: 1uF; C3216/T; PARTNO T491A105K016AT
C68, C70, C74: 22uF; C3528/T; PARTNO T491B226M016AT
C78: 0.1uF; C3216/T; PARTNO DNP
D10: BZT52C5V6-7-F; SOD123; PARTNO BZT52C5V6-7-F
J2: MA10-2; PARTNO *
JP4: JP2E; JP2; PARTNO *
R16, R46, R55, R62: 1M; R0805; PARTNO ERJ-6ENF1004V
R24: 91.0K; R0805; PARTNO ERJ-6ENF9092V
R25, R28, R39, R40, R43, R50, R54, R56, R57, R58, R65, R67, R69, R70, R79: 10K; R0805; PARTNO ERJ-6ENF1002V
R26, R27, R63, R71, R75: 10K; EVME-SIDE; PARTNO EVM-EGGA00B14
R29: 332K; R0805; PARTNO ERJ-6ENF3323V
R30, R33: 4.75K; R0805; PARTNO ERJ-6ENF4751V
R31, R44, R48, R51, R59, R64, R72, R76: 22K; R0805; PARTNO ERJ-6ENF2212V
R32: 301K; R0805; PARTNO ERJ-6ENF3013V
R34, R37, R41, R45, R49, R61, R68, R73, R74, R77, R78: 100K; R0805; PARTNO ERJ-6ENF1003V
R35: 150K; R0805; PARTNO ERJ-6ENF1503V
R36: 5.62K; R0805; PARTNO ERJ-6ENF5621V
R38: 8.25K; R0805; PARTNO ERJ-6ENF8251V
R42: 11.3K; R0805; PARTNO ERJ-6ENF1132V
R47: 93.1K; R0805; PARTNO ERJ-6ENF9312V
R52: 200K; EVME-SIDE; PARTNO EVM-EGGA00B25
R53, R60: 33.2K; R0805; PARTNO ERJ-6ENF3322V
R66: 10K; EVM-L4G; PARTNO EVM-L4GA00B14
R82, R83: 1.00K; R0805; PARTNO ERJ-6ENF1001V
TP3, TP4, TP5, TP6, TP7: TPTP10SQ; TP10SQ
TP8, TP10: TPS-SMD-10SN; SMD-10SN
U5: LM324D; SO14; PARTNO LM324D
U6: MT8870DS; SO18W; PARTNO MT8870DS
U7: MAX323CSA+; SO08; PARTNO MAX323CSA+
U8: MX828DW; SSOP24; PARTNO MX828DW
U9: ISD4002-240SY; SO28W; PARTNO ISD4002-240SY
U10: TLC084CD; SO14; PARTNO TLC084CD
Y2: 3.579 MHZ; TC310H; PARTNO ECS-35-18-10X
Y3: 4.032MHZ; SM49; PARTNO ECS-40.3-20-5PX-TR

Connections:
+2V5: R16.2, R46.2, R62.2, U10.1 (OUT), U10.2 (-IN)
+3V3: C68.+, C69.1, C70.+, C71.1, U9.18 (VCCA), U9.27 (VCCD); also elsewhere on the board
+5V: C30.2, C72.1, C73.1, C74.+, J2.8, R50.1, R69.2, R70.2, R74.2, R79.2, U6.18 (VDD), U8.24 (VDD); also elsewhere on the board
+12V: C75.1, C76.1, C77.1, J2.9, R73.2, U5.4 (V+), U7.8 (V+), U10.4 (V+); also elsewhere on the board
AGND: C38.1, C55.-, C56.-, C57.2, C60.2, C62.2, C63.1, C65.2, C66.2, C67.-, C68.-, C69.2, C75.2, C76.2, C77.2, C78.-, D10.A, J2.7, R26.1, R27.1, R33.1, R37.2, R38.2, R39.2, R40.2, R49.1, R61.1, R63.1, R66.1, R67.2, R71.1, R75.1, R77.1, R78.1, TP10.TP, U5.11 (V-), U7.4 (V-), U9.11 (VSSA), U9.12 (VSSA), U9.23 (VSSA), U10.11 (V-); also elsewhere on the board
AUX_AUDIO: C45.2, J2.3, R49.2; also elsewhere on the board
AUX_AUDIO_OUT: TP4.TP, U7.1 (NO), U8.22 (MOD1)
BEEP_PWM: R68.1, TP7.TP; also elsewhere on the board
CS_DTMF: U6.10 (TOE); also elsewhere on the board
DISC_AUDIO: R26.3, R27.3; also elsewhere on the board
DTMF_Q1: U6.11 (Q1); also elsewhere on the board
DTMF_Q2: U6.12 (Q2); also elsewhere on the board
DTMF_Q3: U6.13 (Q3); also elsewhere on the board
DTMF_Q4: U6.14 (Q4); also elsewhere on the board
EXP_IO0: J2.15; also elsewhere on the board
EXP_IO1: J2.19; also elsewhere on the board
EXP_IO2: J2.17; also elsewhere on the board
GND: C53.2, C54.2, C70.-, C71.2, C72.2, C73.2, C74.-, J2.6, U6.5 (INH), U6.6 (PD), U6.9 (VSS), U8.12 (VSS), U9.4 (VSSD), U9.26 (XCLK); also elsewhere on the board
I2C_SCL: J2.13; also elsewhere on the board
I2C_SDA: J2.11; also elsewhere on the board
INT_DTMF: U6.15 (STD); also elsewhere on the board
INT_EXP: J2.18, R79.1; also elsewhere on the board
INT_ISD: R69.1, U9.25 (!INT!); also elsewhere on the board
INT_MX828: R50.2, U8.7 (!IRQ!); also elsewhere on the board
INT_RAC: R70.1, U9.24 (RAC); also elsewhere on the board
MIX_BUSS: C51.1, R51.2, R59.2, R64.2, R72.1, R76.2
MIX_INSERT: C47.1, J2.4, R16.1
MUTE_AUX: U7.7 (IN); also elsewhere on the board
MUTE_RX: U7.3 (IN); also elsewhere on the board
unnamed: C45.1, R82.2
unnamed: C39.2, R26.2
unnamed: C58.1, R62.1, U7.6 (COM)
unnamed: R63.2, R64.1
unnamed: R65.2, R66.2
unnamed: C63.2, U9.16 (ANA_IN-)
unnamed: C56.+, U8.11 (A/D_CAP2)
unnamed: C52.1, R83.2
unnamed: JP4.1, R42.2
unnamed: C59.1, C60.1, R65.1, R67.1, TP8.TP
unnamed: U6.7 (OSC1), Y2.2
unnamed: U6.8 (OSC2), Y2.1
unnamed: U6.1 (IN+), U6.4 (VREF)
unnamed: C61.1, R68.2
unnamed: R75.2, R76.1
unnamed: C65.1, R73.1, R77.2, U10.12 (+IN)
unnamed: C64.2, R75.3
unnamed: C40.2, R41.2, R45.2, U6.2 (IN-)
unnamed: C41.2, JP4.3
unnamed: C40.1, R41.1, U6.3 (GS)
unnamed: C30.1, R32.2, U6.17 (ST/GT)
unnamed: R32.1, U6.16 (EST)
unnamed: C59.2, U9.17 (ANA_IN+)
unnamed: C44.2, R48.1
unnamed: C64.1, U9.13 (AUD_OUT)
unnamed: C43.2, R45.1
unnamed: C55.+, U8.10 (A/D_CAP1)
unnamed: C48.2, R56.1
unnamed: R30.2, R36.2, U5.6 (-IN), U5.7 (OUT)
unnamed: C31.1, R27.2
unnamed: C44.1, R46.1, U7.2 (COM)
unnamed: C61.2, C62.1, R71.3
unnamed: R71.2, R72.2
unnamed: C53.1, R55.2, U8.2 (XTAL/CLOCK), Y3.1
unnamed: C54.1, R55.1, U8.1 (XTAL), Y3.2
unnamed: C49.2, R54.2, U8.19 (SUM_OUT)
unnamed: R53.2, R56.2, R83.1, U10.7 (OUT)
unnamed: C39.1, R43.2
unnamed: C46.2, JP4.2, R43.1, R47.2, U8.14 (RX_AMP_IN)
unnamed: C57.1, U8.13 (VBIAS)
unnamed: C41.1, C46.1, R42.1, R47.1, U8.15 (RX_AMP_OUT)
unnamed: C48.1, R52.1, R60.2, U10.6 (-IN)
unnamed: C58.2, R63.3, R66.3
unnamed: C50.2, R59.1
unnamed: C32.2, C33.1, R33.2
unnamed: R29.2, R34.1, U5.8 (OUT)
unnamed: C36.2, R34.2, R39.1, U5.9 (-IN)
unnamed: R57.1, U8.17 (TX_AUD_OUT)
unnamed: C35.1, R30.1
unnamed: R58.1, U8.21 (TX_SUB_AUD_OUT)
unnamed: C34.2, R24.2, U5.5 (+IN)
unnamed: R52.2, R52.3, R53.1
unnamed: C67.+, U9.14 (AM_CAP)
unnamed: C42.1, R44.1, R48.2, U10.9 (-IN)
unnamed: C42.2, R44.2, R82.1, U10.8 (OUT)
unnamed: C33.2, C34.1, R36.1
unnamed: C49.1, R54.1, R57.2, R58.2, U8.18 (SUM_IN)
unnamed: C47.2, R51.1
unnamed: C29.2, C32.1, R25.2, U5.1 (OUT)
unnamed: C35.2, C36.1, R38.1, U5.10 (+IN)
unnamed: C37.1, C38.2, R29.1, U5.12 (+IN)
unnamed: C29.1, R25.1, R28.2, U5.2 (-IN)
unnamed: C31.2, R28.1
unnamed: C37.2, R35.2, R40.1, U5.13 (-IN)
unnamed: C51.2, R60.1
unnamed: C66.1, R74.1, R78.2, U10.3 (+IN)
unnamed: R31.2, R35.1, U5.14 (OUT)
RX_AUDIO_OUT: C43.1, J2.1, TP6.TP, U8.16 (RX_AUD_OUT), U8.20 (MOD1_IN)
RX_AUDIO_RET: J2.2, U7.5 (NO)
SPI_MISO: J2.14, U8.5 (REPLY_DATA), U9.3 (MISO); also elsewhere on the board
SPI_MOSI: J2.12, U8.4 (COMMAND_DATA), U9.2 (MOSI); also elsewhere on the board
SPI_SCK: J2.10, U8.3 (SERIAL_CLOCK), U9.28 (SCLK); also elsewhere on the board
SPI_SS: J2.16; also elsewhere on the board
SS_ISD: U9.1 (!SS!); also elsewhere on the board
SS_MX828: U8.6 (!CS!); also elsewhere on the board
TX_AUDIO: C52.2, J2.5, R61.2; also elsewhere on the board
TX_TONE_OUT: C50.1, TP5.TP, U8.23 (MOD2)
VREF: R24.1, U5.3 (+IN), U10.5 (+IN), U10.10 (+IN), U10.13 (-IN), U10.14 (OUT)
VSQL: C78.+, D10.C, R31.1, R37.1, TP3.TP, U8.9 (COMP_IN); also elsewhere on the board
XADC: J2.20; also elsewhere on the board

Notes on the sheet:
DTMF DECODE
CTCSS ENCODE/DECODE
REC-LEVEL
BEEP-LEVEL
INPUT
RX-LEVEL
FLAT
EMPH
PLAY-LEVEL
AUDIO EQ
CAL
VOICE REC/PLAY
OUTPUT LEVEL
MICRO-RC REPEATER CONTROLLER
EXPANSION I/O
ADJUST FOR FULL SCALE ADC READING WITH FULL NOISE PRESENT.
SET JUMPER FOR FLAT OR DE-EMPHASIZED RECEIVE AUDIO.
LEVEL
SQUELCH
REFERENCE VOLTAGES
AUDIO MIXER
PINS 1 & 2 MUST BE JUMPERED WITH NO OPTION BOARD INSTALLED.
HIGH-PASS FILTER
HF-LIMIT
NOISE RECTIFIER
200-300 mV
AUX/LINK AUDIO OUT
DC-AMP
NO RX/TX PL TONES OR RECORDER AUDIO PRESENT.
AUX/LINK AUDIO IS FILTERED RX AUDIO ONLY.
OUTPUT LEVEL IS PROGRAMMED BY MX828 ATTENUATOR

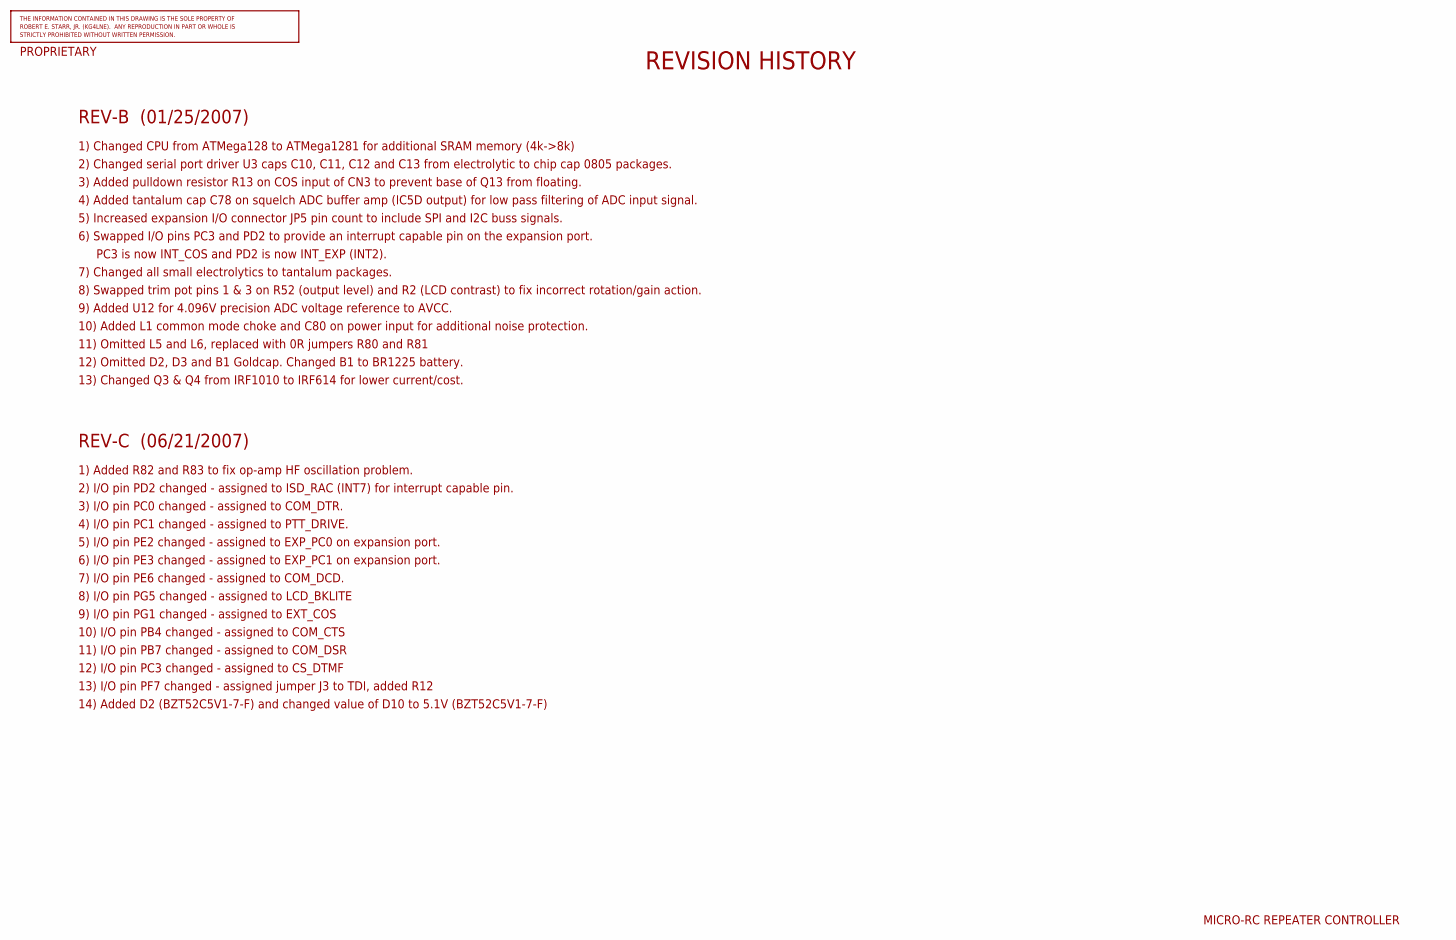
[picture p42: schematic MicroRC-C.sch, sheet 3]

Notes on the sheet:
MICRO-RC REPEATER CONTROLLER
REVISION HISTORY
REV-B (01/25/2007)
2) Changed serial port driver U3 caps C10, C11, C12 and C13 from electrolytic to chip cap 0805 packages.
4) Added tantalum cap C78 on squelch ADC buffer amp (IC5D output) for low pass filtering of ADC input signal.
5) Increased expansion I/O connector JP5 pin count to include SPI and I2C buss signals.
3) Added pulldown resistor R13 on COS input of CN3 to prevent base of Q13 from floating.
6) Swapped I/O pins PC3 and PD2 to provide an interrupt capable pin on the expansion port.
PC3 is now INT_COS and PD2 is now INT_EXP (INT2).
7) Changed all small electrolytics to tantalum packages.
8) Swapped trim pot pins 1 & 3 on R52 (output level) and R2 (LCD contrast) to fix incorrect rotation/gain action.
9) Added U12 for 4.096V precision ADC voltage reference to AVCC.
1) Changed CPU from ATMega128 to ATMega1281 for additional SRAM memory (4k->8k)
10) Added L1 common mode choke and C80 on power input for additional noise protection.
11) Omitted L5 and L6, replaced with 0R jumpers R80 and R81
12) Omitted D2, D3 and B1 Goldcap. Changed B1 to BR1225 battery.
13) Changed Q3 & Q4 from IRF1010 to IRF614 for lower current/cost.
REV-C (06/21/2007)
1) Added R82 and R83 to fix op-amp HF oscillation problem.
2) I/O pin PD2 changed - assigned to ISD_RAC (INT7) for interrupt capable pin.
5) I/O pin PE2 changed - assigned to EXP_PC0 on expansion port.
14) Added D2 (BZT52C5V1-7-F) and changed value of D10 to 5.1V (BZT52C5V1-7-F)
4) I/O pin PC1 changed - assigned to PTT_DRIVE.
6) I/O pin PE3 changed - assigned to EXP_PC1 on expansion port.
7) I/O pin PE6 changed - assigned to COM_DCD.
3) I/O pin PC0 changed - assigned to COM_DTR.
8) I/O pin PG5 changed - assigned to LCD_BKLITE
9) I/O pin PG1 changed - assigned to EXT_COS
10) I/O pin PB4 changed - assigned to COM_CTS
11) I/O pin PB7 changed - assigned to COM_DSR
13) I/O pin PF7 changed - assigned jumper J3 to TDI, added R12
12) I/O pin PC3 changed - assigned to CS_DTMF

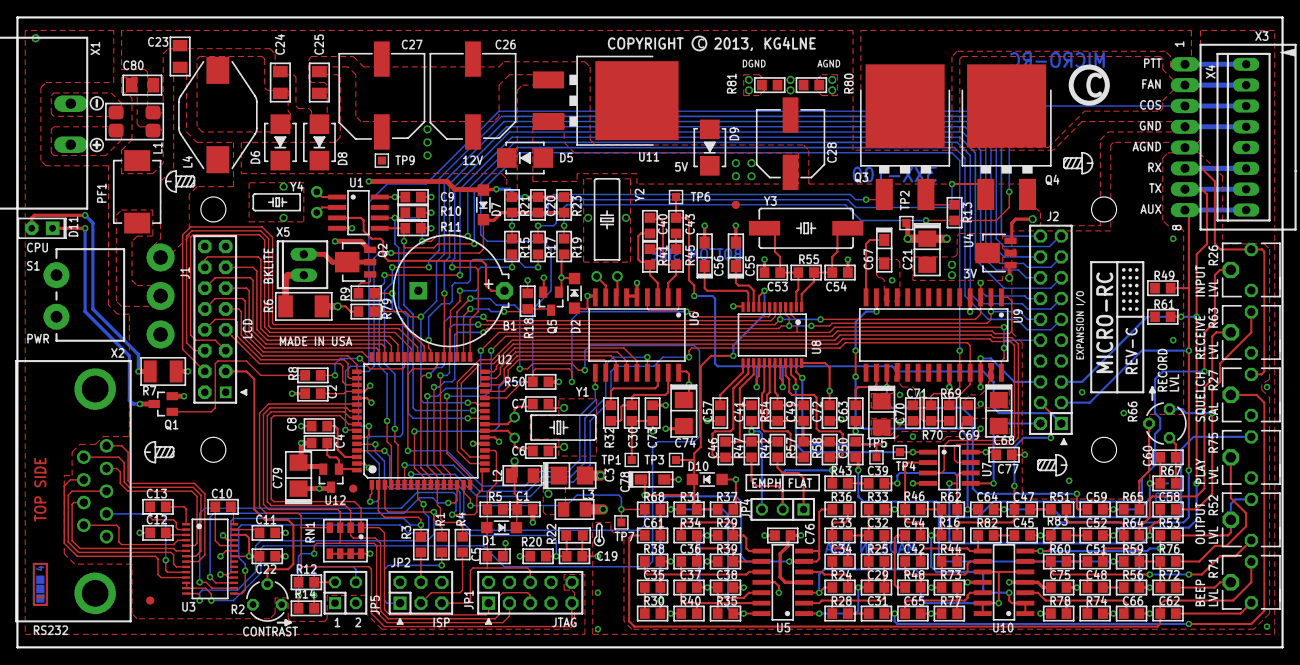
[picture p43: board MicroRC-C.brd from above]

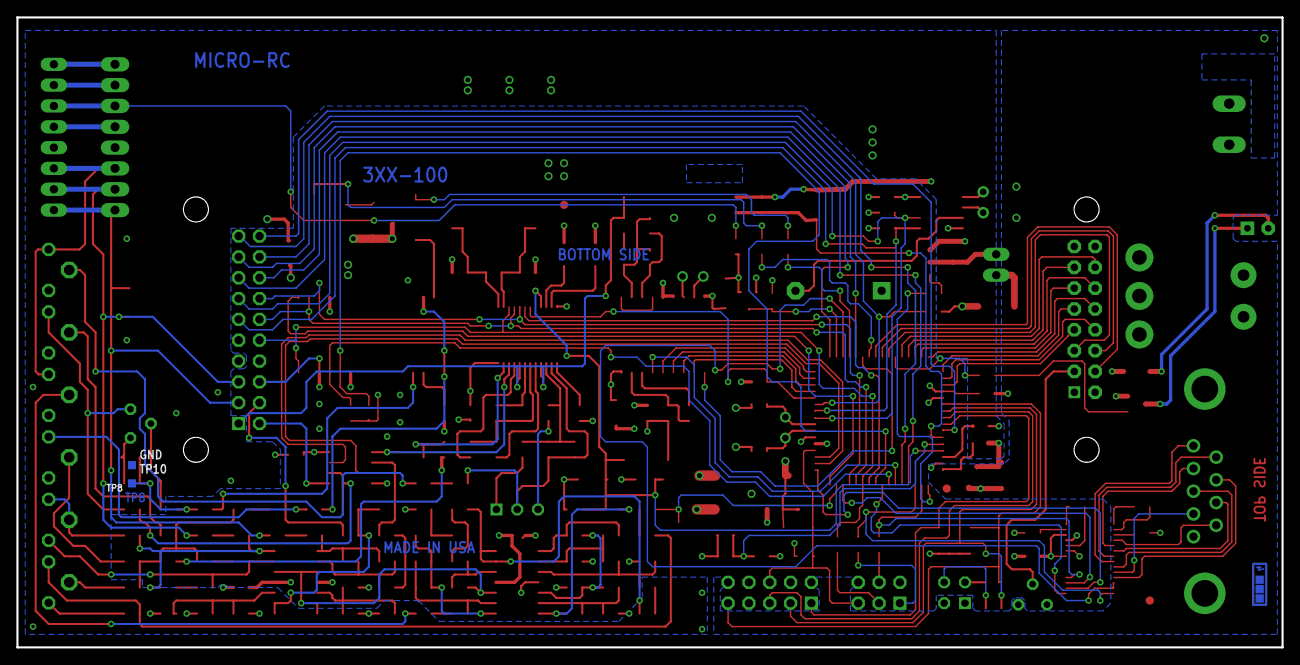
[picture p44: board MicroRC-C.brd from below]

Board: 4 copper layers, 154.3 x 76.8 mm, 254 parts (3 on the bottom side), 186 nets.

Other parts of the board:
U$6: ICON_ATTR_COPYRIGHT
U$7: LAYER_CHECK-4
U$60: FIELD_ATTR_DATECODE5_RESTRICT
U$74: ICON_SIDE_BOTTOM
U$75: ICON_SIDE_TOP
U$100: ICON_ATTR_REV-M
U$102: FAB_8X14
U$105: FAB_DOCFIELD
U$112: ICON_TEMP
U$123: ICON_MINUS
U$124: 3.0250; FAB_ARROW_LINE025
U$125: ICON_PLUS
U$128, U$136: 0,0; FAB_ARROW_LINE025
U$132: 2.7125; FAB_CONST_LINE050
U$133, U$239, U$282, U$283: ICON_MSCREW-S
U$138: 6.0750; FAB_ARROW_LINE025
U$139: 0.5750; FAB_CONST_LINE050
U$140: 1.2125; FAB_CONST_LINE050
U$141: 1.5125; FAB_CONST_LINE050
U$142: 1.8125; FAB_CONST_LINE050
U$143: 2.1125; FAB_CONST_LINE050
U$144: 2.4125; FAB_CONST_LINE050
U$145: 1.3375; FAB_CONST_LINE050
U$146: 2.2750; FAB_CONST_LINE050
U$230, U$235, U$280, U$281: ICON_PIN1_B
U$240, U$241: ICON_ARROW-T
