firepick-delta/fpd-electronics/EAGLE/ECLOCK01/ECLOCK01.brd

## EAGLE design EAGLE/ECLOCK01/ECLOCK01.brd (2015-09-08)

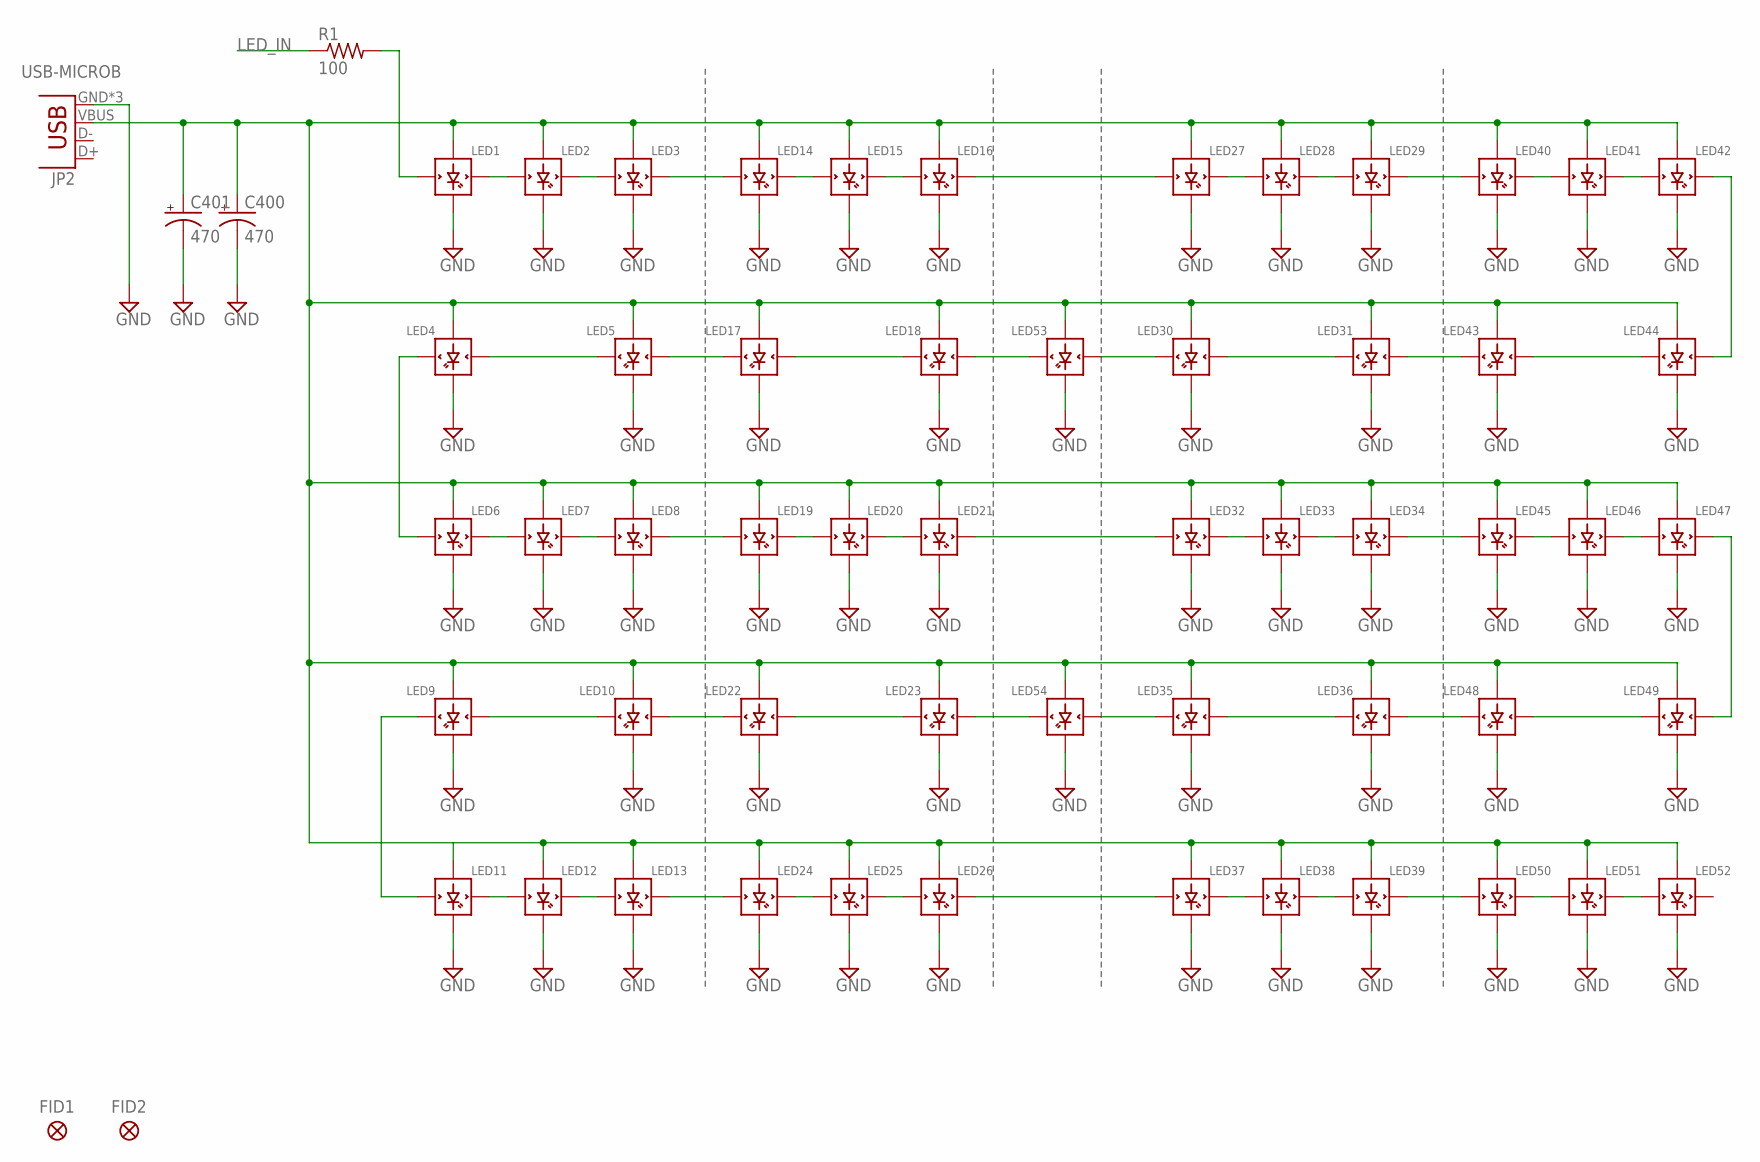
[picture p45: schematic ECLOCK01.sch, sheet 1]

Parts:
C400, C401: 470; PANASONIC_E
FID1, FID2: FIDUCIAL
JP2: USB-MICROB
LED1, LED2, LED3, LED4, LED5, LED6, LED7, LED8, LED9, LED10, LED11, LED12, LED13, LED14, LED15, LED16, LED17, LED18, LED19, LED20, LED21, LED22, LED23, LED24, LED25, LED26, LED27, LED28, LED29, LED30, LED31, LED32, LED33, LED34, LED35, LED36, LED37, LED38, LED39, LED40, LED41, LED42, LED43, LED44, LED45, LED46, LED47, LED48, LED49, LED50, LED51, LED52, LED53, LED54: WS2812B
R1: 100; 0805

Connections:
GND: C400.-, C401.-, JP2.GND, JP2.MT1 (GND), JP2.MT2 (GND), LED1.3-GND (GND), LED2.3-GND (GND), LED3.3-GND (GND), LED4.3-GND (GND), LED5.3-GND (GND), LED6.3-GND (GND), LED7.3-GND (GND), LED8.3-GND (GND), LED9.3-GND (GND), LED10.3-GND (GND), LED11.3-GND (GND), LED12.3-GND (GND), LED13.3-GND (GND), LED14.3-GND (GND), LED15.3-GND (GND), LED16.3-GND (GND), LED17.3-GND (GND), LED18.3-GND (GND), LED19.3-GND (GND), LED20.3-GND (GND), LED21.3-GND (GND), LED22.3-GND (GND), LED23.3-GND (GND), LED24.3-GND (GND), LED25.3-GND (GND), LED26.3-GND (GND), LED27.3-GND (GND), LED28.3-GND (GND), LED29.3-GND (GND), LED30.3-GND (GND), LED31.3-GND (GND), LED32.3-GND (GND), LED33.3-GND (GND), LED34.3-GND (GND), LED35.3-GND (GND), LED36.3-GND (GND), LED37.3-GND (GND), LED38.3-GND (GND), LED39.3-GND (GND), LED40.3-GND (GND), LED41.3-GND (GND), LED42.3-GND (GND), LED43.3-GND (GND), LED44.3-GND (GND), LED45.3-GND (GND), LED46.3-GND (GND), LED47.3-GND (GND), LED48.3-GND (GND), LED49.3-GND (GND), LED50.3-GND (GND), LED51.3-GND (GND), LED52.3-GND (GND), LED53.3-GND (GND), LED54.3-GND (GND); also elsewhere on the board
LED_IN: R1.1; also elsewhere on the board
unnamed: LED1.4-DIN (DIN), R1.2
unnamed: LED11.2-DOUT (DOUT), LED12.4-DIN (DIN)
unnamed: LED1.2-DOUT (DOUT), LED2.4-DIN (DIN)
unnamed: LED2.2-DOUT (DOUT), LED3.4-DIN (DIN)
unnamed: LED16.2-DOUT (DOUT), LED27.4-DIN (DIN)
unnamed: LED12.2-DOUT (DOUT), LED13.4-DIN (DIN)
unnamed: LED26.2-DOUT (DOUT), LED37.4-DIN (DIN)
unnamed: LED14.2-DOUT (DOUT), LED15.4-DIN (DIN)
unnamed: LED15.2-DOUT (DOUT), LED16.4-DIN (DIN)
unnamed: LED18.4-DIN (DIN), LED53.2-DOUT (DOUT)
unnamed: LED19.2-DOUT (DOUT), LED20.4-DIN (DIN)
unnamed: LED17.4-DIN (DIN), LED18.2-DOUT (DOUT)
unnamed: LED8.2-DOUT (DOUT), LED19.4-DIN (DIN)
unnamed: LED47.2-DOUT (DOUT), LED49.4-DIN (DIN)
unnamed: LED39.2-DOUT (DOUT), LED50.4-DIN (DIN)
unnamed: LED24.2-DOUT (DOUT), LED25.4-DIN (DIN)
unnamed: LED25.2-DOUT (DOUT), LED26.4-DIN (DIN)
unnamed: LED13.2-DOUT (DOUT), LED24.4-DIN (DIN)
unnamed: LED27.2-DOUT (DOUT), LED28.4-DIN (DIN)
unnamed: LED28.2-DOUT (DOUT), LED29.4-DIN (DIN)
unnamed: LED40.2-DOUT (DOUT), LED41.4-DIN (DIN)
unnamed: LED20.2-DOUT (DOUT), LED21.4-DIN (DIN)
unnamed: LED9.2-DOUT (DOUT), LED11.4-DIN (DIN)
unnamed: LED5.4-DIN (DIN), LED17.2-DOUT (DOUT)
unnamed: LED4.4-DIN (DIN), LED5.2-DOUT (DOUT)
unnamed: LED6.2-DOUT (DOUT), LED7.4-DIN (DIN)
unnamed: LED7.2-DOUT (DOUT), LED8.4-DIN (DIN)
unnamed: LED21.2-DOUT (DOUT), LED32.4-DIN (DIN)
unnamed: LED48.4-DIN (DIN), LED49.2-DOUT (DOUT)
unnamed: LED36.4-DIN (DIN), LED48.2-DOUT (DOUT)
unnamed: LED37.2-DOUT (DOUT), LED38.4-DIN (DIN)
unnamed: LED38.2-DOUT (DOUT), LED39.4-DIN (DIN)
unnamed: LED30.2-DOUT (DOUT), LED53.4-DIN (DIN)
unnamed: LED34.2-DOUT (DOUT), LED45.4-DIN (DIN)
unnamed: LED32.2-DOUT (DOUT), LED33.4-DIN (DIN)
unnamed: LED33.2-DOUT (DOUT), LED34.4-DIN (DIN)
unnamed: LED31.4-DIN (DIN), LED43.2-DOUT (DOUT)
unnamed: LED4.2-DOUT (DOUT), LED6.4-DIN (DIN)
unnamed: LED46.2-DOUT (DOUT), LED47.4-DIN (DIN)
unnamed: LED45.2-DOUT (DOUT), LED46.4-DIN (DIN)
unnamed: LED42.2-DOUT (DOUT), LED44.4-DIN (DIN)
unnamed: LED43.4-DIN (DIN), LED44.2-DOUT (DOUT)
unnamed: LED30.4-DIN (DIN), LED31.2-DOUT (DOUT)
unnamed: LED41.2-DOUT (DOUT), LED42.4-DIN (DIN)
unnamed: LED35.4-DIN (DIN), LED36.2-DOUT (DOUT)
unnamed: LED35.2-DOUT (DOUT), LED54.4-DIN (DIN)
unnamed: LED50.2-DOUT (DOUT), LED51.4-DIN (DIN)
unnamed: LED51.2-DOUT (DOUT), LED52.4-DIN (DIN)
unnamed: LED23.4-DIN (DIN), LED54.2-DOUT (DOUT)
unnamed: LED22.4-DIN (DIN), LED23.2-DOUT (DOUT)
unnamed: LED3.2-DOUT (DOUT), LED14.4-DIN (DIN)
unnamed: LED10.4-DIN (DIN), LED22.2-DOUT (DOUT)
unnamed: LED9.4-DIN (DIN), LED10.2-DOUT (DOUT)
unnamed: LED29.2-DOUT (DOUT), LED40.4-DIN (DIN)
VDD: C400.+, C401.+, JP2.VBUS, LED1.1-VDD (VDD), LED2.1-VDD (VDD), LED3.1-VDD (VDD), LED4.1-VDD (VDD), LED5.1-VDD (VDD), LED6.1-VDD (VDD), LED7.1-VDD (VDD), LED8.1-VDD (VDD), LED9.1-VDD (VDD), LED10.1-VDD (VDD), LED11.1-VDD (VDD), LED12.1-VDD (VDD), LED13.1-VDD (VDD), LED14.1-VDD (VDD), LED15.1-VDD (VDD), LED16.1-VDD (VDD), LED17.1-VDD (VDD), LED18.1-VDD (VDD), LED19.1-VDD (VDD), LED20.1-VDD (VDD), LED21.1-VDD (VDD), LED22.1-VDD (VDD), LED23.1-VDD (VDD), LED24.1-VDD (VDD), LED25.1-VDD (VDD), LED26.1-VDD (VDD), LED27.1-VDD (VDD), LED28.1-VDD (VDD), LED29.1-VDD (VDD), LED30.1-VDD (VDD), LED31.1-VDD (VDD), LED32.1-VDD (VDD), LED33.1-VDD (VDD), LED34.1-VDD (VDD), LED35.1-VDD (VDD), LED36.1-VDD (VDD), LED37.1-VDD (VDD), LED38.1-VDD (VDD), LED39.1-VDD (VDD), LED40.1-VDD (VDD), LED41.1-VDD (VDD), LED42.1-VDD (VDD), LED43.1-VDD (VDD), LED44.1-VDD (VDD), LED45.1-VDD (VDD), LED46.1-VDD (VDD), LED47.1-VDD (VDD), LED48.1-VDD (VDD), LED49.1-VDD (VDD), LED50.1-VDD (VDD), LED51.1-VDD (VDD), LED52.1-VDD (VDD), LED53.1-VDD (VDD), LED54.1-VDD (VDD); also elsewhere on the board

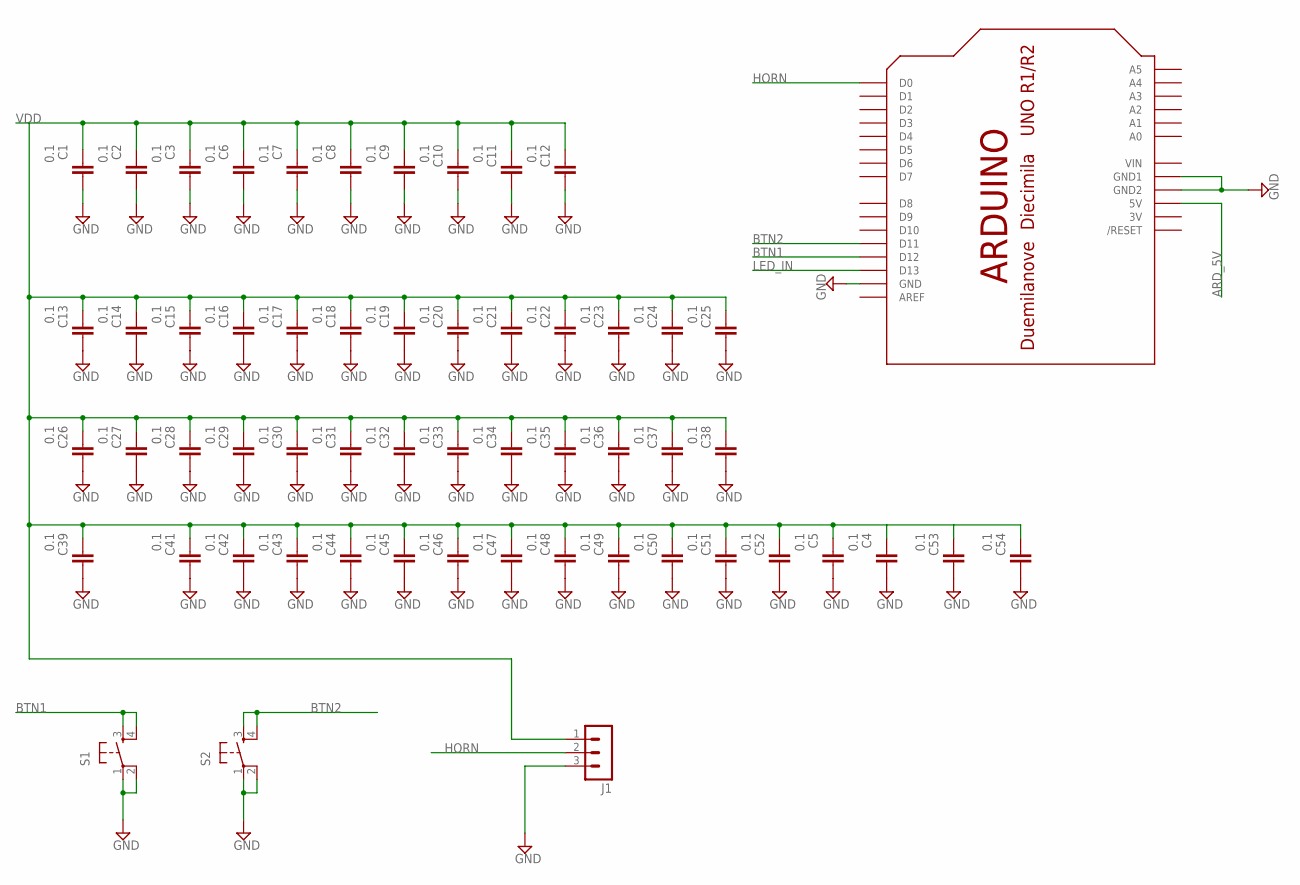
[picture p46: schematic ECLOCK01.sch, sheet 2]

Parts:
C1, C2, C3, C4, C5, C6, C7, C8, C9, C10, C11, C12, C13, C14, C15, C16, C17, C18, C19, C20, C21, C22, C23, C24, C25, C26, C27, C28, C29, C30, C31, C32, C33, C34, C35, C36, C37, C38, C39, C41, C42, C43, C44, C45, C46, C47, C48, C49, C50, C51, C52, C53, C54: 0.1; 0805
J1: MA03-1
S1, S2: TAC_SWITCHSMD; TACTILE_SWITCH_SMD
U$1: ARDUINOUNO; ARDUINO-UNO

Connections:
3V: U$1.3V
ARD_5V: U$1.5V
BTN1: S1.3, S1.4, U$1.D12
BTN2: S2.3, S2.4, U$1.D11
GND: C1.2, C2.2, C3.2, C4.2, C5.2, C6.2, C7.2, C8.2, C9.2, C10.2, C11.2, C12.2, C13.2, C14.2, C15.2, C16.2, C17.2, C18.2, C19.2, C20.2, C21.2, C22.2, C23.2, C24.2, C25.2, C26.2, C27.2, C28.2, C29.2, C30.2, C31.2, C32.2, C33.2, C34.2, C35.2, C36.2, C37.2, C38.2, C39.2, C41.2, C42.2, C43.2, C44.2, C45.2, C46.2, C47.2, C48.2, C49.2, C50.2, C51.2, C52.2, C53.2, C54.2, J1.3, S1.1, S1.2, S2.1, S2.2, U$1.GND, U$1.GND1, U$1.GND2; also elsewhere on the board
HORN: J1.2, U$1.D0
LED_IN: U$1.D13; also elsewhere on the board
VDD: C1.1, C2.1, C3.1, C4.1, C5.1, C6.1, C7.1, C8.1, C9.1, C10.1, C11.1, C12.1, C13.1, C14.1, C15.1, C16.1, C17.1, C18.1, C19.1, C20.1, C21.1, C22.1, C23.1, C24.1, C25.1, C26.1, C27.1, C28.1, C29.1, C30.1, C31.1, C32.1, C33.1, C34.1, C35.1, C36.1, C37.1, C38.1, C39.1, C41.1, C42.1, C43.1, C44.1, C45.1, C46.1, C47.1, C48.1, C49.1, C50.1, C51.1, C52.1, C53.1, C54.1, J1.1; also elsewhere on the board
VIN: U$1.VIN

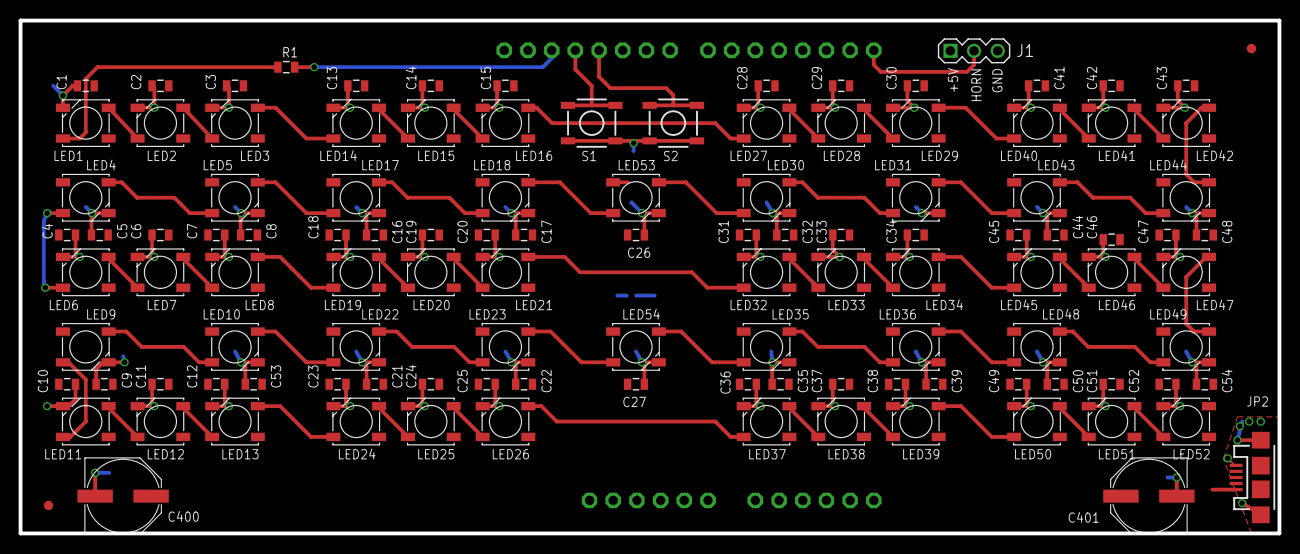
[picture p47: board ECLOCK01.brd from above]

Board: 2 copper layers, 135.0 x 55.0 mm, 117 parts (0 on the bottom side), 60 nets.
