firepick-delta/fpd-electronics/EAGLE/EMC03 - Motion Control/EMC02-Chopped.brd

## EAGLE design EAGLE/EMC03 - Motion Control/EMC02-Chopped.brd (2015-09-07)

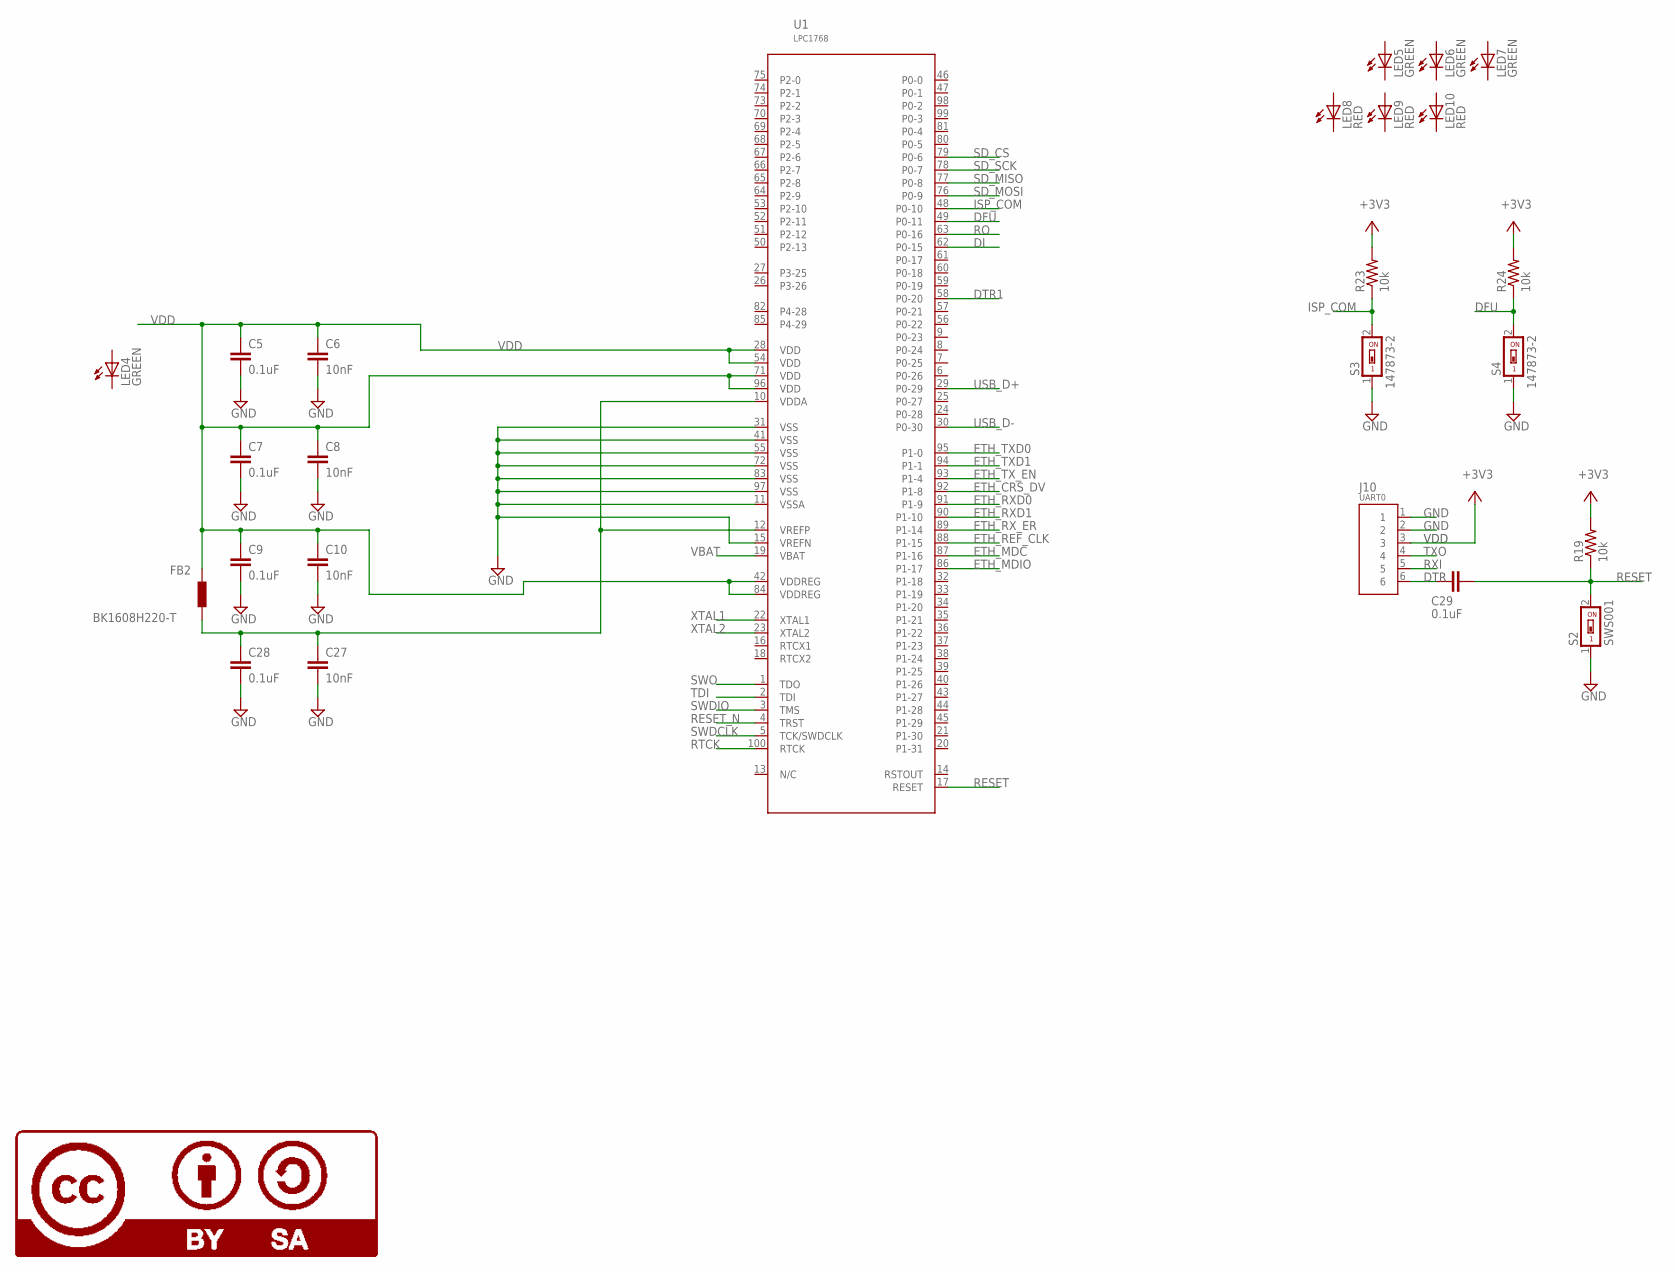
[picture p48: schematic EMC02-Chopped.sch, sheet 1, MCU]

Parts:
C5, C7, C9, C28, C29: 0.1uF; C0603
C6, C8, C10, C27: 10nF; C0603
FB2: BK1608H220-T; F0603
J10: UART0; CON-HDR-6POS-MALE
LED4, LED5, LED6, LED7: GREEN; LED0603
LED8, LED9, LED10: RED; LED0603
LOGO8: LOGO-CC-BY-SALARGE; LOGO-CC-BY-SA
R19, R23, R24: 10k; R0603
S2: SWS001; SMS-001
S3, S4: 147873-2; 0603
U1: LPC1768; LQFP-100

Connections:
+3V3: J10.3, R19.2, R23.2, R24.2; also elsewhere on the board
DFU: R24.1, S4.2, U1.49 (P0-11)
DI: U1.62 (P0-15); also elsewhere on the board
DTR: C29.1, J10.6
DTR1: U1.58 (P0-20); also elsewhere on the board
ETH_CRS_DV: U1.92 (P1-8); also elsewhere on the board
ETH_MDC: U1.87 (P1-16); also elsewhere on the board
ETH_MDIO: U1.86 (P1-17); also elsewhere on the board
ETH_REF_CLK: U1.88 (P1-15); also elsewhere on the board
ETH_RXD0: U1.91 (P1-9); also elsewhere on the board
ETH_RXD1: U1.90 (P1-10); also elsewhere on the board
ETH_RX_ER: U1.89 (P1-14); also elsewhere on the board
ETH_TXD0: U1.95 (P1-0); also elsewhere on the board
ETH_TXD1: U1.94 (P1-1); also elsewhere on the board
ETH_TX_EN: U1.93 (P1-4); also elsewhere on the board
GND: C5.1, C6.1, C7.1, C8.1, C9.1, C10.1, C28.1, J10.1, J10.2, S2.1, S3.1, S4.1, U1.11 (VSSA), U1.15 (VREFN), U1.31 (VSS), U1.41 (VSS), U1.55 (VSS), U1.72 (VSS), U1.83 (VSS), U1.97 (VSS); also elsewhere on the board
GND1: C27.1
ISP_COM: R23.1, S3.2, U1.48 (P0-10)
unnamed: C27.2, C28.2, FB2.1, U1.10 (VDDA), U1.12 (VREFP)
RESET: C29.2, R19.1, S2.2, U1.17 (RESET)
RESET_N: U1.4 (TRST); also elsewhere on the board
RO: U1.63 (P0-16); also elsewhere on the board
RTCK: U1.100 (RTCK); also elsewhere on the board
RXI: J10.5
SD_CS: U1.79 (P0-6); also elsewhere on the board
SD_MISO: U1.77 (P0-8); also elsewhere on the board
SD_MOSI: U1.76 (P0-9); also elsewhere on the board
SD_SCK: U1.78 (P0-7); also elsewhere on the board
SWDCLK: U1.5 (TCK/SWDCLK); also elsewhere on the board
SWDIO: U1.3 (TMS); also elsewhere on the board
SWO: U1.1 (TDO); also elsewhere on the board
TDI: U1.2 (TDI); also elsewhere on the board
TXO: J10.4
USB_D+: U1.29 (P0-29); also elsewhere on the board
USB_D-: U1.30 (P0-30); also elsewhere on the board
VBAT: U1.19 (VBAT)
VDD: C5.2, C6.2, C7.2, C8.2, C9.2, C10.2, FB2.2, U1.28 (VDD), U1.42 (VDDREG), U1.54 (VDD), U1.71 (VDD), U1.84 (VDDREG), U1.96 (VDD)
XTAL1: U1.22 (XTAL1); also elsewhere on the board
XTAL2: U1.23 (XTAL2); also elsewhere on the board

Notes on the sheet:
VDD

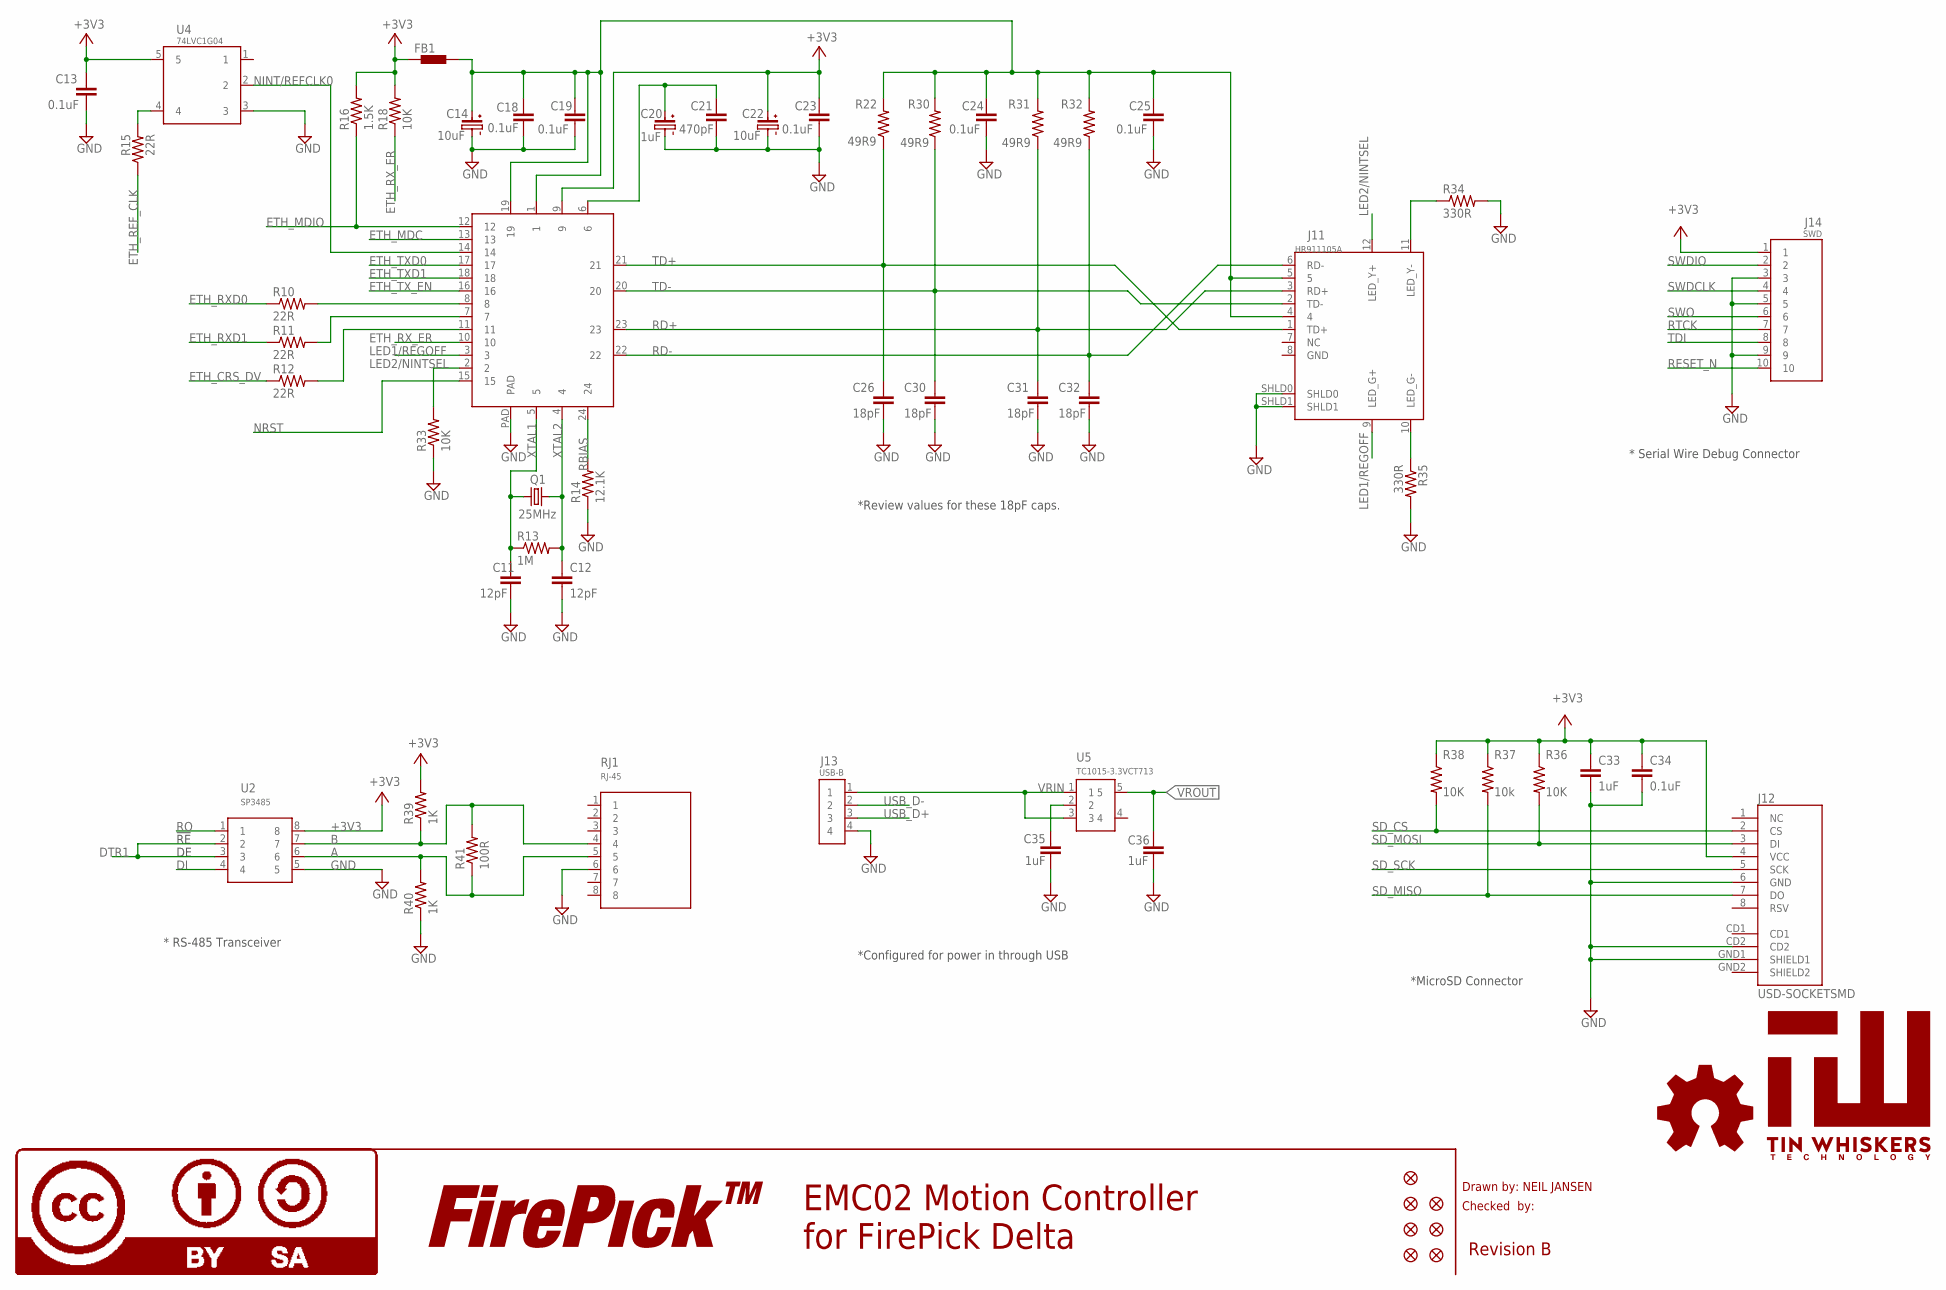
[picture p49: schematic EMC02-Chopped.sch, sheet 2, Peripherals]

Parts:
C11, C12: 12pF; C0603
C13, C18, C19, C23, C24, C25, C34: 0.1uF; C0603
C14, C22: 10uF; C-RAD-6.3MM
C20: 1uF; C-SMD-4MM
C21: 470pF; C0603
C26, C30, C31, C32: 18pF; C0603
C33, C35, C36: 1uF; C0603
FB1: BLM15HBK1608H220-T0603; F0603
FID1, FID2, FID3, FID4, FID5, FID6, FID7: FIDUCIAL
J11: HR911105A; MAGJACK(HR911105A)
J12: USD-SOCKETSMD; MICRO-SD-SOCKET-PP
J13: USB-B; USB-B(THRU)
J14: SWD; FTSH-105-01-XXX-DV-K
LOGO4: LOGO-FIREPICKLARGE; LOGO-FIREPICK
LOGO5: LOGO-OSHWMEDIUM; LOGO-OSHW-MEDIUM
LOGO6: LOGO-CC-BY-SALARGE; LOGO-CC-BY-SA
Q1: 25MHz; HC-49/U-S
R10, R11, R12, R15: 22R; R0603
R13: 1M; R0603
R14: 12.1K; R0603
R16: 1.5K; R0603
R18, R33, R36, R38: 10K; R0603
R22, R30, R31, R32: 49R9; R0603
R34, R35: 330R; R0603
R37: 10k; R0603
R39, R40: 1K; R0603
R41: 100R; R0603
RJ1: RJ-45; CON-RJ45
U2: SP3485; SOICN-8
U3: CPL-ETH-PHY-LAN8720A; QFN-24
U4: 74LVC1G04; SOT-25
U5: TC1015-3.3VCT713; SOT-23-5
U$25: TIN-WHISKERSTSTOP; TIN-WHISKERS-TSTOP

Connections:
+3V3: C13.2, C22.POS, C23.2, C33.2, C34.2, FB1.1, J12.4 (VCC), J14.1, R16.2, R18.2, R36.1, R37.1, R38.1, R39.2, U2.8, U3.9, U4.5; also elsewhere on the board
A: R40.2, R41.1, RJ1.5, U2.6
B: R39.1, R41.2, RJ1.4, U2.7
DI: U2.4; also elsewhere on the board
DTR1: U2.2, U2.3; also elsewhere on the board
ETH_CRS_DV: R12.1; also elsewhere on the board
ETH_MDC: U3.13; also elsewhere on the board
ETH_MDIO: R16.1, U3.12; also elsewhere on the board
ETH_REF_CLK: R15.1; also elsewhere on the board
ETH_RXD0: R10.1; also elsewhere on the board
ETH_RXD1: R11.1; also elsewhere on the board
ETH_RX_ER: R18.1, U3.10; also elsewhere on the board
ETH_TXD0: U3.17; also elsewhere on the board
ETH_TXD1: U3.18; also elsewhere on the board
ETH_TX_EN: U3.16; also elsewhere on the board
GND: C11.1, C12.1, C13.1, C14.NEG, C18.1, C19.1, C20.NEG, C21.1, C22.NEG, C23.1, C24.1, C25.1, C26.1, C30.1, C31.1, C32.1, C33.1, C34.1, C35.1, C36.1, J11.SHLD0, J11.SHLD1, J12.6 (GND), J12.CD2, J12.GND1 (SHIELD1), J13.4, J14.3, J14.5, J14.9, R14.1, R33.1, R34.2, R35.2, R40.1, RJ1.6, U2.5, U3.PAD, U4.3; also elsewhere on the board
LED1/REGOFF: J11.9 (LED_G+), U3.3
LED2/NINTSEL: J11.12 (LED_Y+), R33.2, U3.2
unnamed: R10.2, U3.8
unnamed: R15.2, U4.4
unnamed: C14.POS, C18.2, C19.2, C24.2, C25.2, FB1.2, J11.4, J11.5, R22.2, R30.2, R31.2, R32.2, U3.1, U3.19
unnamed: J11.11 (LED_Y-), R34.1
unnamed: J11.10 (LED_G-), R35.1
unnamed: C35.2, U5.2
unnamed: R11.2, U3.7
unnamed: R12.2, U3.11
unnamed: C20.POS, C21.2, U3.6
NINT/REFCLK0: U3.14, U4.2
NRST: U3.15
RBIAS: R14.2, U3.24
RD+: C31.2, J11.3 (RD+), R31.1, U3.23
RD-: C32.2, J11.6 (RD-), R32.1, U3.22
RESET_N: J14.10; also elsewhere on the board
RO: U2.1; also elsewhere on the board
RTCK: J14.7; also elsewhere on the board
SD_CS: J12.2 (CS), R38.2; also elsewhere on the board
SD_MISO: J12.7 (DO), R37.2; also elsewhere on the board
SD_MOSI: J12.3 (DI), R36.2; also elsewhere on the board
SD_SCK: J12.5 (SCK); also elsewhere on the board
SWDCLK: J14.4; also elsewhere on the board
SWDIO: J14.2; also elsewhere on the board
SWO: J14.6; also elsewhere on the board
TD+: C26.2, J11.1 (TD+), R22.1, U3.21
TD-: C30.2, J11.2 (TD-), R30.1, U3.20
TDI: J14.8; also elsewhere on the board
USB_D+: J13.3; also elsewhere on the board
USB_D-: J13.2; also elsewhere on the board
VRIN: J13.1, U5.1, U5.3
VROUT: C36.2, U5.5
XTAL1: C11.2, Q1.1, R13.1, U3.5; also elsewhere on the board
XTAL2: C12.2, Q1.2, R13.2, U3.4; also elsewhere on the board

Notes on the sheet:
Drawn by: NEIL JANSEN
Checked by:
Revision B
EMC02 Motion Controller for FirePick Delta
*Configured for power in through USB
*Review values for these 18pF caps.
*MicroSD Connector
!RE
* Serial Wire Debug Connector
* RS-485 Transceiver

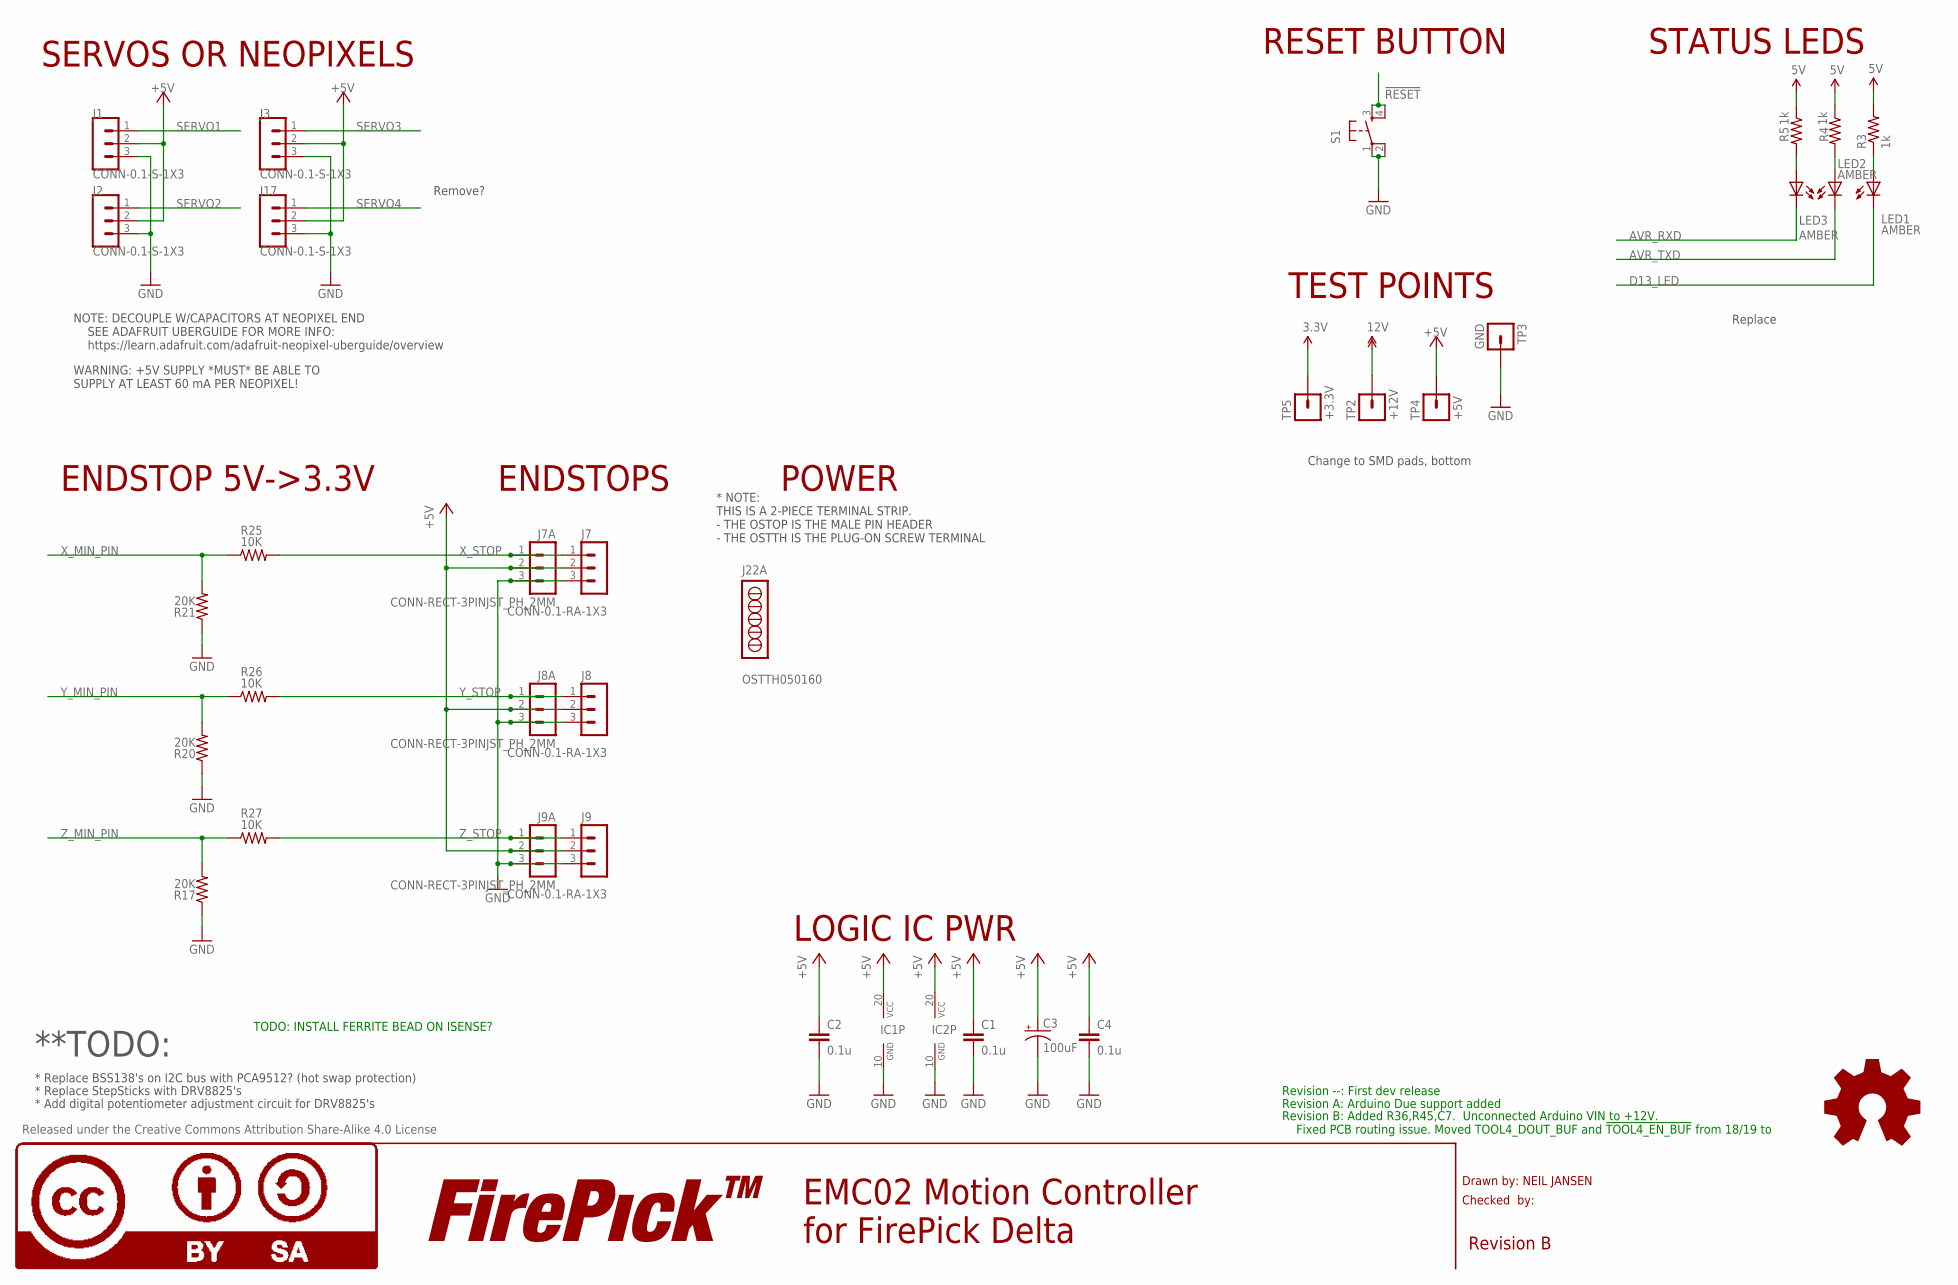
[picture p50: schematic EMC02-Chopped.sch, sheet 3]

Parts:
C1, C2, C4: 0.1u; 0805; PARTNO CC0805ZRY5V9BB104
C3: 100uF; PANASONIC_D; PARTNO 25TXV100M6.3X8
IC1, IC2: 74ACT244DW; SO20W; PARTNO 74ACT244SCX
J1, J2, J3, J17: CONN-0.1-S-1X3; MA03-1; PARTNO CONN-0.1-S-1X3
J7, J8, J9: CONN-0.1-RA-1X3; MA03-1; PARTNO CONN-0.1-RA-1X3
J7A, J8A, J9A: CONN-RECT-3PINJST_PH_2MM; CONN-JST_PH-2.0MM-3PIN-SMT-RA
J22A: OSTTH050160; CONN-OSTTH050160; PARTNO OSTTH050160
LED1, LED2, LED3: AMBER; LED-1206-NO_SILK; PARTNO LTST-C150AKT
LOGO1: LOGO-FIREPICKLARGE; LOGO-FIREPICK
LOGO2: LOGO-OSHWMEDIUM; LOGO-OSHW-MEDIUM
LOGO3: LOGO-CC-BY-SALARGE; LOGO-CC-BY-SA
R3, R4, R5: 1k; 0805; PARTNO RC0805FR-071KL
R17, R20, R21: 20K; 0805; PARTNO RC0805FR-0720KL
R25, R26, R27: 10K; 0805; PARTNO RC0805FR-0710KL
S1: TAC_SWITCHSMD; TACTILE_SWITCH_SMD; PARTNO SWITCH TACTILE SPST-NO 0.05A 12V
TP2: +12V; CON-TESTPOINT
TP3: GND; CON-TESTPOINT
TP4: +5V; CON-TESTPOINT
TP5: +3.3V; CON-TESTPOINT

Connections:
3.3V: TP5.1
12V: TP2.1; also elsewhere on the board
!RESET: S1.3, S1.4
+5V: C1.1, C2.1, C3.+, C4.1, IC1.20 (VCC), IC2.20 (VCC), J1.2, J2.2, J3.2, J7.2, J7A.2, J8.2, J8A.2, J9.2, J9A.2, J17.2, R3.2, R4.1, R5.1, TP4.1; also elsewhere on the board
AVR_RXD: LED3.C
AVR_TXD: LED2.C
D13_LED: LED1.C
GND: C1.2, C2.2, C3.-, C4.2, IC1.10 (GND), IC2.10 (GND), J1.3, J2.3, J3.3, J7.3, J7A.3, J8.3, J8A.3, J9.3, J9A.3, J17.3, R17.1, R20.1, R21.1, S1.1, S1.2, TP3.1; also elsewhere on the board
unnamed: LED1.A, R3.1
unnamed: LED2.A, R4.2
unnamed: LED3.A, R5.2
SERVO1: J1.1; also elsewhere on the board
SERVO2: J2.1; also elsewhere on the board
SERVO3: J3.1; also elsewhere on the board
SERVO4: J17.1; also elsewhere on the board
X_MIN_PIN: R21.2, R25.1
X_STOP: J7.1, J7A.1, R25.2
Y_MIN_PIN: R20.2, R26.1
Y_STOP: J8.1, J8A.1, R26.2
Z_MIN_PIN: R17.2, R27.1
Z_STOP: J9.1, J9A.1, R27.2

Notes on the sheet:
Drawn by: NEIL JANSEN
Checked by:
Revision B
EMC02 Motion Controller for FirePick Delta
Released under the Creative Commons Attribution Share-Alike 4.0 License
**TODO:
* Replace StepSticks with DRV8825's
* Add digital potentiometer adjustment circuit for DRV8825's
* Replace BSS138's on I2C bus with PCA9512? (hot swap protection)
TEST POINTS
WARNING: +5V SUPPLY *MUST* BE ABLE TO SUPPLY AT LEAST 60 mA PER NEOPIXEL!
SERVOS OR NEOPIXELS
RESET BUTTON
STATUS LEDS
ENDSTOP 5V->3.3V
ENDSTOPS
LOGIC IC PWR
POWER
Revision --: First dev release
Revision A: Arduino Due support added
NOTE: DECOUPLE W/CAPACITORS AT NEOPIXEL END SEE ADAFRUIT UBERGUIDE FOR MORE INFO: https://learn.adafruit.com/adafruit-neopixel-uberguide/overview
* NOTE: THIS IS A 2-PIECE TERMINAL STRIP. - THE OSTOP IS THE MALE PIN HEADER - THE OSTTH IS THE PLUG-ON SCREW TERMINAL
Revision B: Added R36,R45,C7. Unconnected Arduino VIN to +12V. Fixed PCB routing issue. Moved TOOL4_DOUT_BUF and !TOOL4_EN_BUF! from 18/19 to
TODO: INSTALL FERRITE BEAD ON ISENSE?
Change to SMD pads, bottom
Remove?
Replace
