firepick-delta/fpd-electronics/EAGLE/EMC03 - Motion Control/EMC02-Chopped.brd

## EAGLE design EAGLE/EMC03 - Motion Control/EMC02-Chopped.brd (continued)

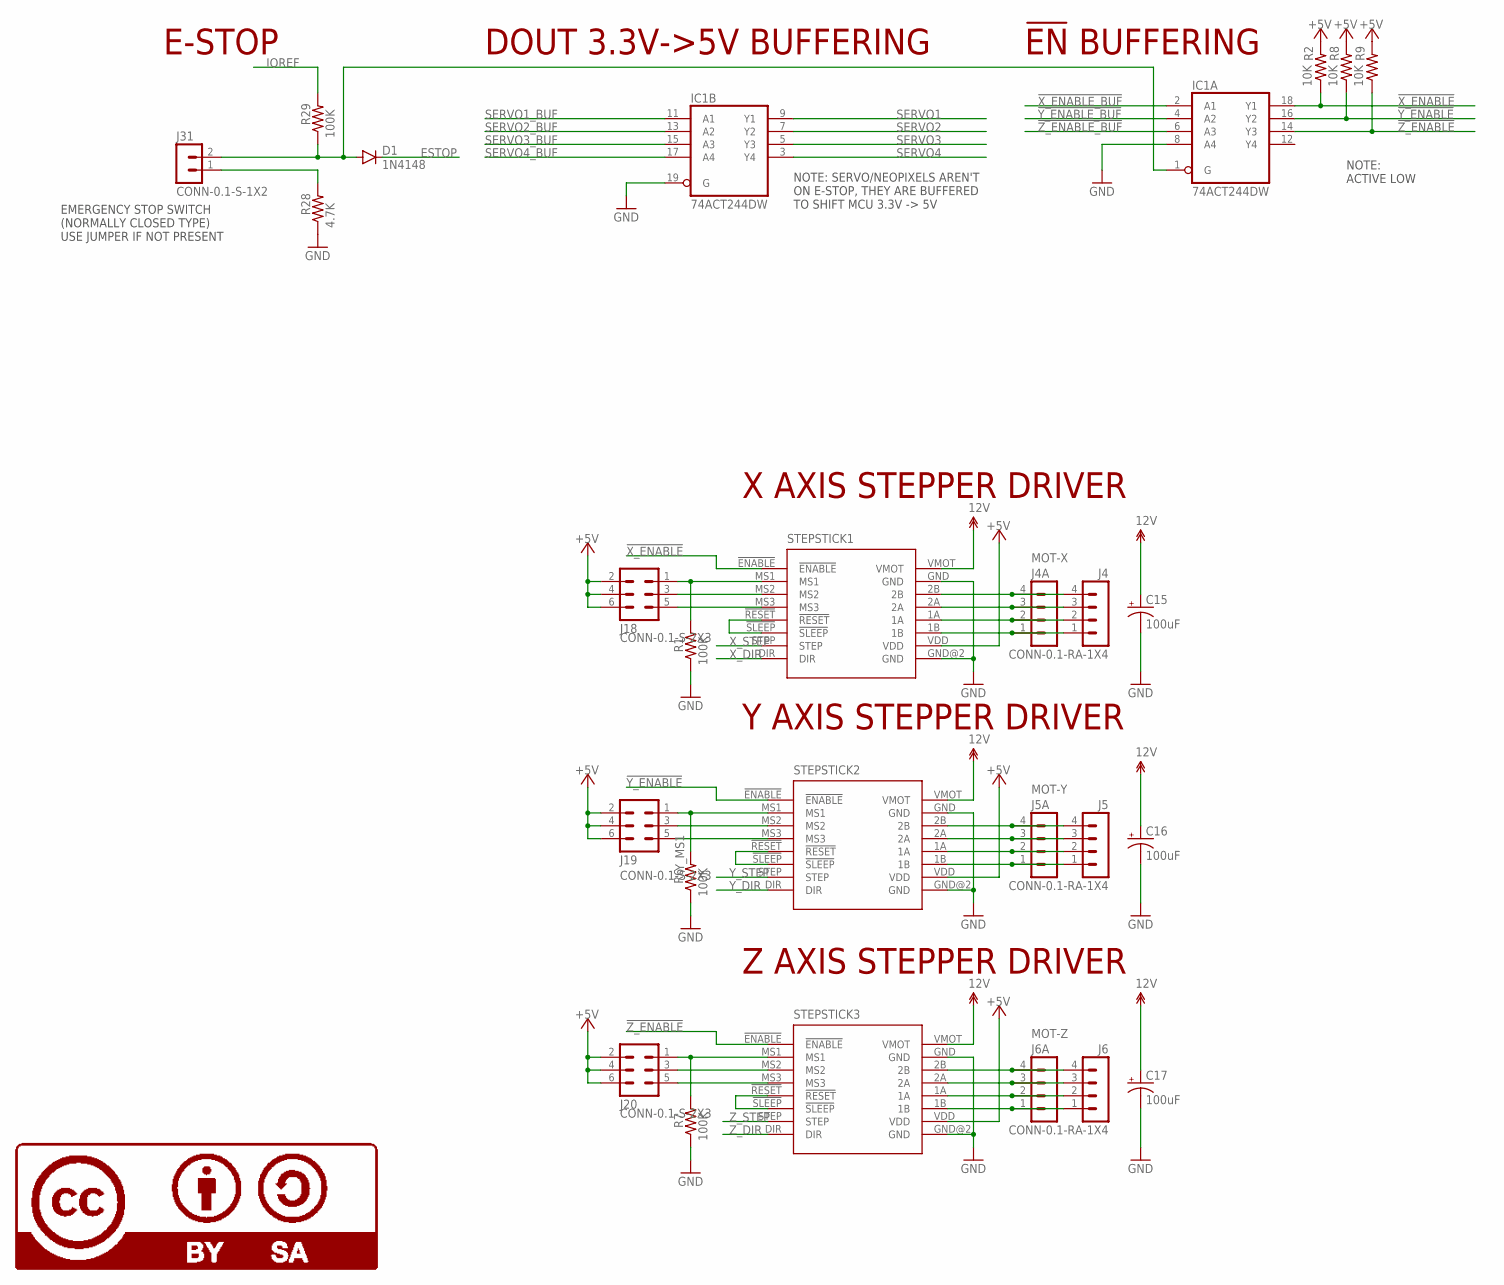
[picture p51: schematic EMC02-Chopped.sch, sheet 4, Mot/E-Stop]

Parts:
C15, C16, C17: 100uF; PANASONIC_D; PARTNO 25TXV100M6.3X8
D1: 1N4148; SOD-123; PARTNO 1N4148W-7-F
IC1: 74ACT244DW; SO20W; PARTNO 74ACT244SCX
J4, J5, J6: CONN-0.1-RA-1X4; MA04-1; PARTNO CONN-0.1-RA-1X4
J4A: MOT-X; CONN-JST-PH_2.0MM_4PIN-SMT-RA
J5A: MOT-Y; CONN-JST-PH_2.0MM_4PIN-SMT-RA
J6A: MOT-Z; CONN-JST-PH_2.0MM_4PIN-SMT-RA
J18, J19, J20: CONN-0.1-S-2X3; MA03-2; PARTNO CONN-0.1-S-2X3
J31: CONN-0.1-S-1X2; MA02-1; PARTNO CONN-0.1-S-1X2
LOGO7: LOGO-CC-BY-SALARGE; LOGO-CC-BY-SA
R1, R6, R7, R29: 100K; 0805; PARTNO RC0805FR-07100KL
R2, R8, R9: 10K; 0805; PARTNO RC0805FR-0710KL
R28: 4.7K; 0805; PARTNO RC0805FR-074K7L
STEPSTICK1, STEPSTICK2, STEPSTICK3: STEPSTICK; PARTNO PPPC081LFBN-RC

Connections:
12V: C15.+, C16.+, C17.+, STEPSTICK1.VMOT, STEPSTICK2.VMOT, STEPSTICK3.VMOT; also elsewhere on the board
!X_ENABLE: IC1.18 (Y1), R2.1, STEPSTICK1.!ENABLE!
!X_ENABLE_BUF: IC1.2 (A1)
!Y_ENABLE: IC1.16 (Y2), R8.1, STEPSTICK2.!ENABLE!
!Y_ENABLE_BUF: IC1.4 (A2)
!Z_ENABLE: IC1.14 (Y3), R9.1, STEPSTICK3.!ENABLE!
!Z_ENABLE_BUF: IC1.6 (A3)
+5V: J18.2, J18.4, J18.6, J19.2, J19.4, J19.6, J20.2, J20.4, J20.6, R2.2, R8.2, R9.2, STEPSTICK1.VDD, STEPSTICK2.VDD, STEPSTICK3.VDD; also elsewhere on the board
ESTOP: D1.C
ESTOP_OE: D1.A, IC1.1 (G), J31.2, R29.1
GND: C15.-, C16.-, C17.-, IC1.8 (A4), IC1.19 (G), R1.1, R6.1, R7.1, R28.1, STEPSTICK1.GND, STEPSTICK1.GND@2 (GND), STEPSTICK2.GND, STEPSTICK2.GND@2 (GND), STEPSTICK3.GND, STEPSTICK3.GND@2 (GND); also elsewhere on the board
IOREF: R29.2
unnamed: J31.1, R28.2
unnamed: STEPSTICK1.!RESET!, STEPSTICK1.!SLEEP!
unnamed: STEPSTICK2.!RESET!, STEPSTICK2.!SLEEP!
unnamed: STEPSTICK3.!RESET!, STEPSTICK3.!SLEEP!
SERVO1: IC1.9 (Y1); also elsewhere on the board
SERVO1_BUF: IC1.11 (A1)
SERVO2: IC1.7 (Y2); also elsewhere on the board
SERVO2_BUF: IC1.13 (A2)
SERVO3: IC1.5 (Y3); also elsewhere on the board
SERVO3_BUF: IC1.15 (A3)
SERVO4: IC1.3 (Y4); also elsewhere on the board
SERVO4_BUF: IC1.17 (A4)
X1A: J4.2, J4A.2, STEPSTICK1.1A
X1B: J4.1, J4A.1, STEPSTICK1.1B
X2A: J4.3, J4A.3, STEPSTICK1.2A
X2B: J4.4, J4A.4, STEPSTICK1.2B
X_DIR: STEPSTICK1.DIR
X_MS1: J18.1, R1.2, STEPSTICK1.MS1
X_MS2: J18.3, STEPSTICK1.MS2
X_MS3: J18.5, STEPSTICK1.MS3
X_STEP: STEPSTICK1.STEP
Y1A: J5.2, J5A.2, STEPSTICK2.1A
Y1B: J5.1, J5A.1, STEPSTICK2.1B
Y2A: J5.3, J5A.3, STEPSTICK2.2A
Y2B: J5.4, J5A.4, STEPSTICK2.2B
Y_DIR: STEPSTICK2.DIR
Y_MS1: J19.1, R6.2, STEPSTICK2.MS1
Y_MS2: J19.3, STEPSTICK2.MS2
Y_MS3: J19.5, STEPSTICK2.MS3
Y_STEP: STEPSTICK2.STEP
Z1A: J6.2, J6A.2, STEPSTICK3.1A
Z1B: J6.1, J6A.1, STEPSTICK3.1B
Z2A: J6.3, J6A.3, STEPSTICK3.2A
Z2B: J6.4, J6A.4, STEPSTICK3.2B
Z_DIR: STEPSTICK3.DIR
Z_MS1: J20.1, R7.2, STEPSTICK3.MS1
Z_MS2: J20.3, STEPSTICK3.MS2
Z_MS3: J20.5, STEPSTICK3.MS3
Z_STEP: STEPSTICK3.STEP

Notes on the sheet:
X AXIS STEPPER DRIVER
Y AXIS STEPPER DRIVER
Z AXIS STEPPER DRIVER
DOUT 3.3V->5V BUFFERING
EMERGENCY STOP SWITCH (NORMALLY CLOSED TYPE) USE JUMPER IF NOT PRESENT
E-STOP
!EN! BUFFERING
NOTE: ACTIVE LOW
NOTE: SERVO/NEOPIXELS AREN'T ON E-STOP, THEY ARE BUFFERED TO SHIFT MCU 3.3V -> 5V

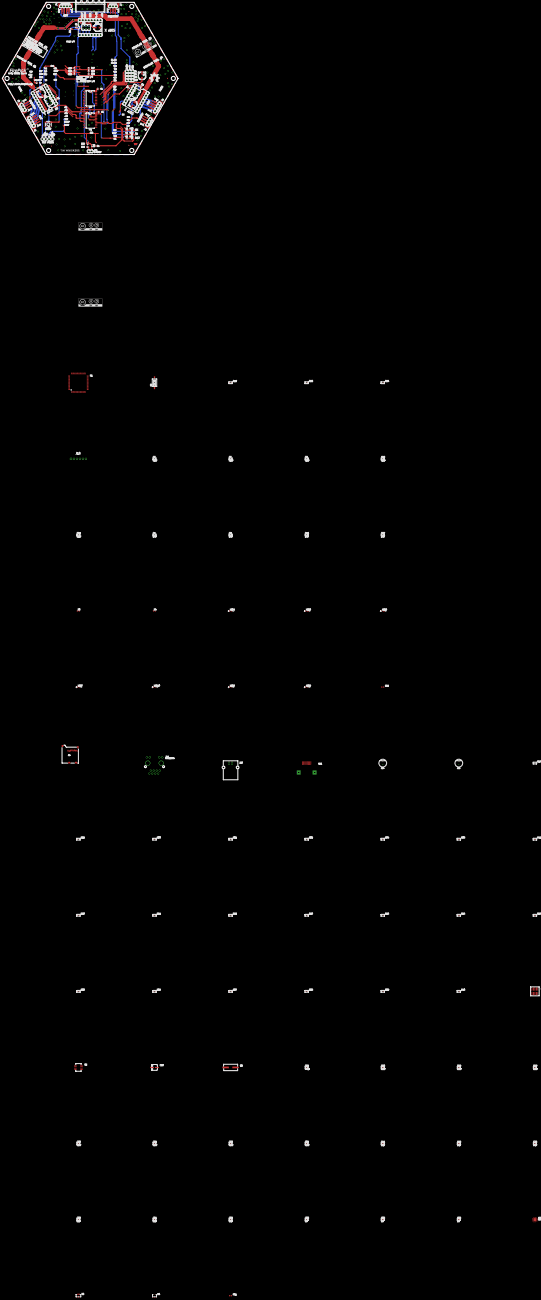
[picture p52: board EMC02-Chopped.brd from above]

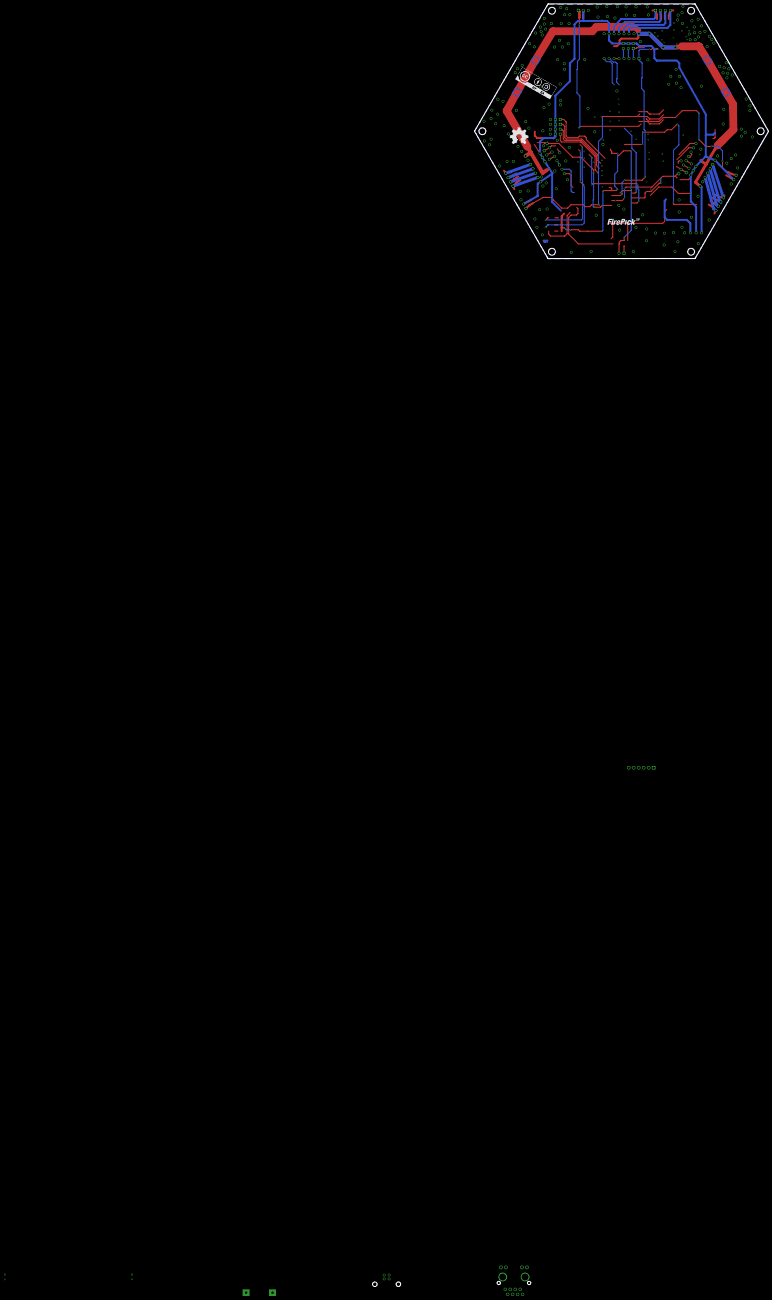
[picture p53: board EMC02-Chopped.brd from below]

Board: 4 copper layers, 150.0 x 129.9 mm, 152 parts (3 on the bottom side), 101 nets.
