firepick-delta/fpd-electronics/EAGLE/EMC03 - Motion Control/EMC03-MCU.brd

## EAGLE design EAGLE/EMC03 - Motion Control/EMC03-MCU.brd (2015-09-07)

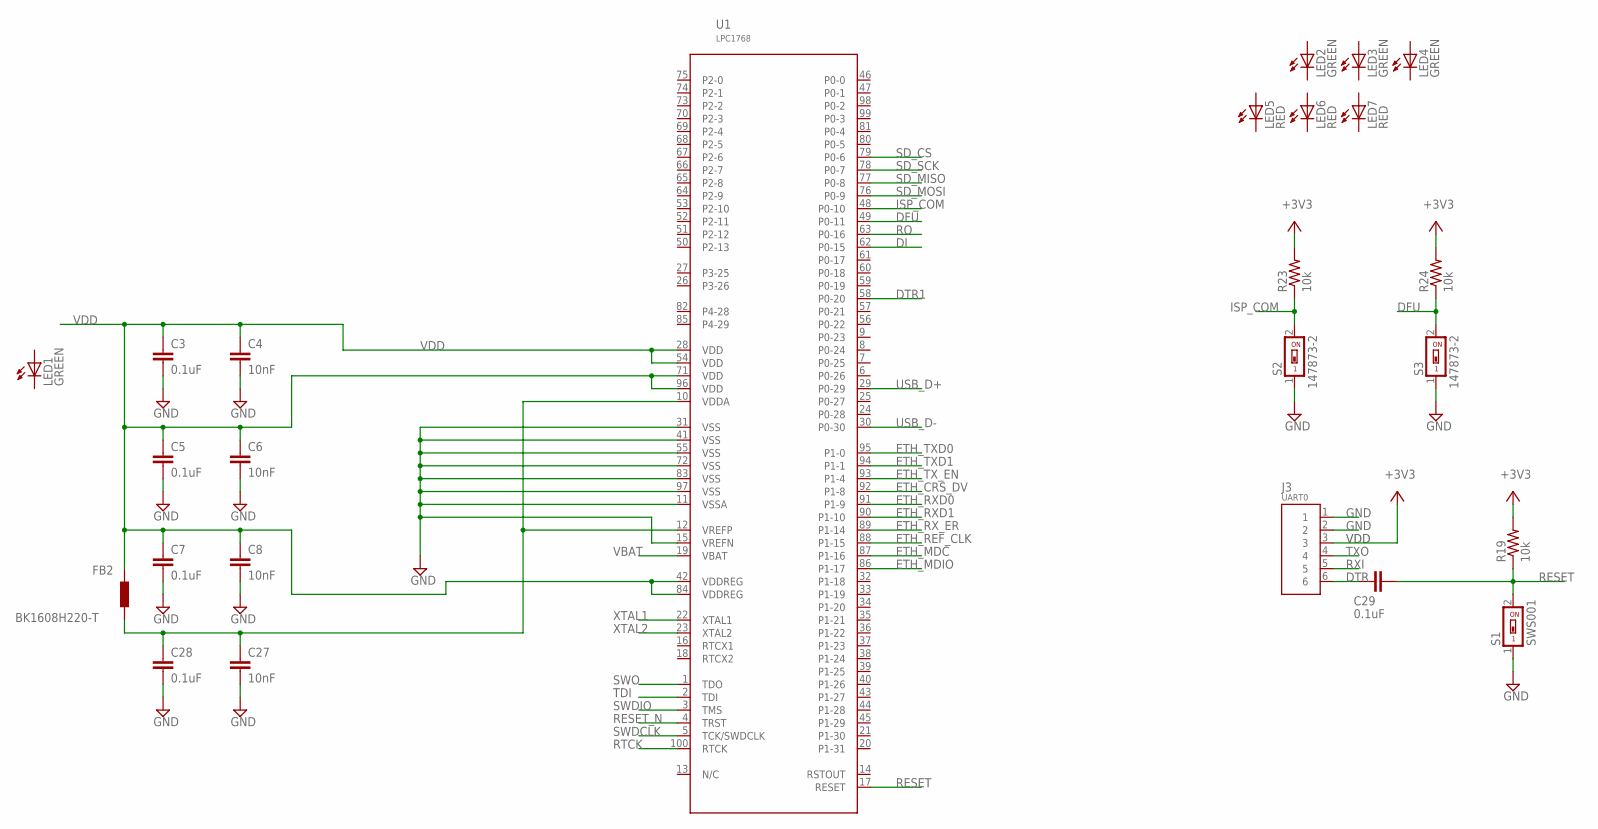
[picture p54: schematic EMC03-MCU.sch, sheet 1]

Parts:
C3, C5, C7, C28, C29: 0.1uF; C0603
C4, C6, C8, C27: 10nF; C0603
FB2: BK1608H220-T; F0603
J3: UART0; CON-HDR-6POS-MALE
LED1, LED2, LED3, LED4: GREEN; LED0603
LED5, LED6, LED7: RED; LED0603
R19, R23, R24: 10k; R0603
S1: SWS001; SMS-001
S2, S3: 147873-2; 0603
U1: LPC1768; LQFP-100

Connections:
+3V3: J3.3, R19.2, R23.2, R24.2; also elsewhere on the board
DFU: R24.1, S3.2, U1.49 (P0-11)
DI: U1.62 (P0-15); also elsewhere on the board
DTR: C29.1, J3.6
DTR1: U1.58 (P0-20); also elsewhere on the board
ETH_CRS_DV: U1.92 (P1-8); also elsewhere on the board
ETH_MDC: U1.87 (P1-16); also elsewhere on the board
ETH_MDIO: U1.86 (P1-17); also elsewhere on the board
ETH_REF_CLK: U1.88 (P1-15); also elsewhere on the board
ETH_RXD0: U1.91 (P1-9); also elsewhere on the board
ETH_RXD1: U1.90 (P1-10); also elsewhere on the board
ETH_RX_ER: U1.89 (P1-14); also elsewhere on the board
ETH_TXD0: U1.95 (P1-0); also elsewhere on the board
ETH_TXD1: U1.94 (P1-1); also elsewhere on the board
ETH_TX_EN: U1.93 (P1-4); also elsewhere on the board
GND: C3.1, C4.1, C5.1, C6.1, C7.1, C8.1, C28.1, J3.1, J3.2, S1.1, S2.1, S3.1, U1.11 (VSSA), U1.15 (VREFN), U1.31 (VSS), U1.41 (VSS), U1.55 (VSS), U1.72 (VSS), U1.83 (VSS), U1.97 (VSS); also elsewhere on the board
GND1: C27.1
ISP_COM: R23.1, S2.2, U1.48 (P0-10)
unnamed: C27.2, C28.2, FB2.1, U1.10 (VDDA), U1.12 (VREFP)
RESET: C29.2, R19.1, S1.2, U1.17 (RESET)
RESET_N: U1.4 (TRST); also elsewhere on the board
RO: U1.63 (P0-16); also elsewhere on the board
RTCK: U1.100 (RTCK); also elsewhere on the board
RXI: J3.5
SD_CS: U1.79 (P0-6); also elsewhere on the board
SD_MISO: U1.77 (P0-8); also elsewhere on the board
SD_MOSI: U1.76 (P0-9); also elsewhere on the board
SD_SCK: U1.78 (P0-7); also elsewhere on the board
SWDCLK: U1.5 (TCK/SWDCLK); also elsewhere on the board
SWDIO: U1.3 (TMS); also elsewhere on the board
SWO: U1.1 (TDO); also elsewhere on the board
TDI: U1.2 (TDI); also elsewhere on the board
TXO: J3.4
USB_D+: U1.29 (P0-29); also elsewhere on the board
USB_D-: U1.30 (P0-30); also elsewhere on the board
VBAT: U1.19 (VBAT)
VDD: C3.2, C4.2, C5.2, C6.2, C7.2, C8.2, FB2.2, U1.28 (VDD), U1.42 (VDDREG), U1.54 (VDD), U1.71 (VDD), U1.84 (VDDREG), U1.96 (VDD)
XTAL1: U1.22 (XTAL1); also elsewhere on the board
XTAL2: U1.23 (XTAL2); also elsewhere on the board

Notes on the sheet:
VDD

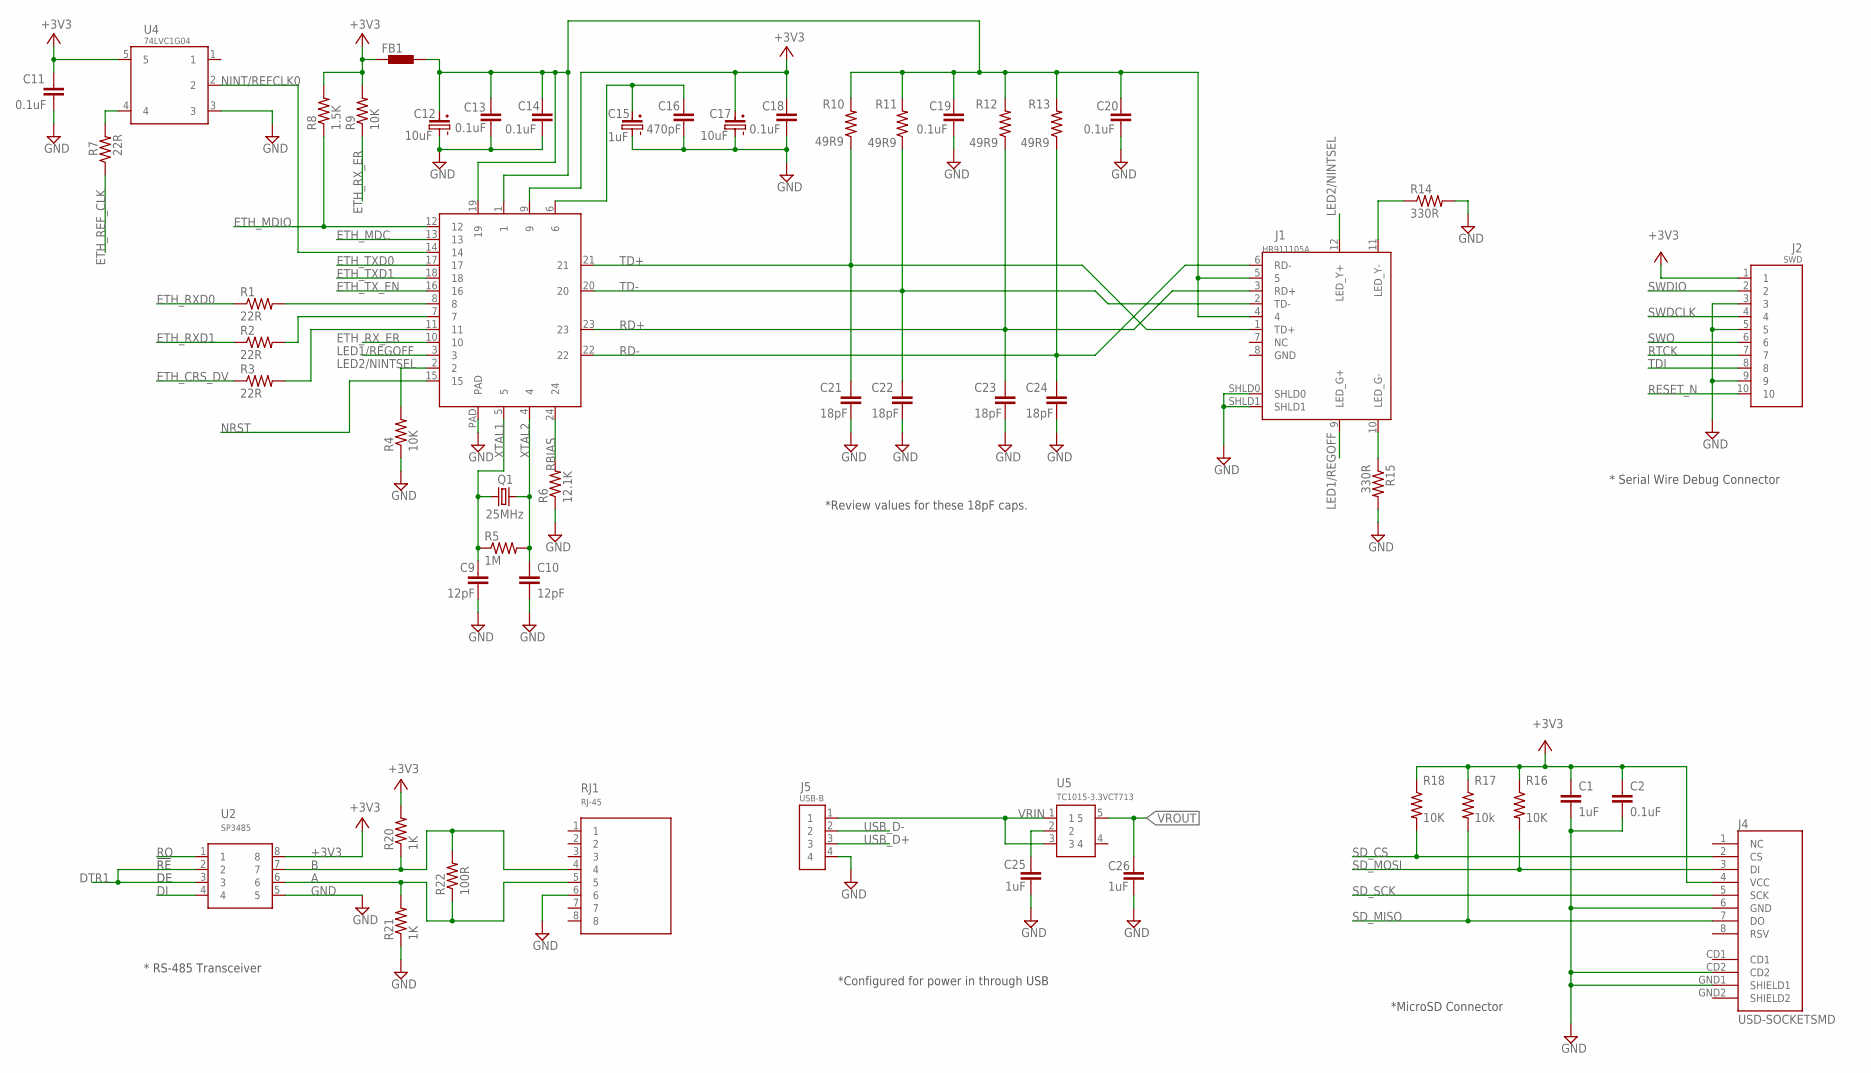
[picture p55: schematic EMC03-MCU.sch, sheet 2]

Parts:
C1, C25, C26: 1uF; C0603
C2, C11, C13, C14, C18, C19, C20: 0.1uF; C0603
C9, C10: 12pF; C0603
C12, C17: 10uF; C-RAD-6.3MM
C15: 1uF; C-SMD-4MM
C16: 470pF; C0603
C21, C22, C23, C24: 18pF; C0603
FB1: BLM15HBK1608H220-T0603; F0603
J1: HR911105A; MAGJACK(HR911105A)
J2: SWD; FTSH-105-01-XXX-DV-K
J4: USD-SOCKETSMD; MICRO-SD-SOCKET-PP
J5: USB-B; USB-B(THRU)
Q1: 25MHz; HC-49/U-S
R1, R2, R3, R7: 22R; R0603
R4, R9, R16, R18: 10K; R0603
R5: 1M; R0603
R6: 12.1K; R0603
R8: 1.5K; R0603
R10, R11, R12, R13: 49R9; R0603
R14, R15: 330R; R0603
R17: 10k; R0603
R20, R21: 1K; R0603
R22: 100R; R0603
RJ1: RJ-45; CON-RJ45
U2: SP3485; SOICN-8
U3: CPL-ETH-PHY-LAN8720A; QFN-24
U4: 74LVC1G04; SOT-25
U5: TC1015-3.3VCT713; SOT-23-5

Connections:
+3V3: C1.2, C2.2, C11.2, C17.POS, C18.2, FB1.1, J2.1, J4.4 (VCC), R8.2, R9.2, R16.1, R17.1, R18.1, R20.2, U2.8, U3.9, U4.5; also elsewhere on the board
A: R21.2, R22.1, RJ1.5, U2.6
B: R20.1, R22.2, RJ1.4, U2.7
DI: U2.4; also elsewhere on the board
DTR1: U2.2, U2.3; also elsewhere on the board
ETH_CRS_DV: R3.1; also elsewhere on the board
ETH_MDC: U3.13; also elsewhere on the board
ETH_MDIO: R8.1, U3.12; also elsewhere on the board
ETH_REF_CLK: R7.1; also elsewhere on the board
ETH_RXD0: R1.1; also elsewhere on the board
ETH_RXD1: R2.1; also elsewhere on the board
ETH_RX_ER: R9.1, U3.10; also elsewhere on the board
ETH_TXD0: U3.17; also elsewhere on the board
ETH_TXD1: U3.18; also elsewhere on the board
ETH_TX_EN: U3.16; also elsewhere on the board
GND: C1.1, C2.1, C9.1, C10.1, C11.1, C12.NEG, C13.1, C14.1, C15.NEG, C16.1, C17.NEG, C18.1, C19.1, C20.1, C21.1, C22.1, C23.1, C24.1, C25.1, C26.1, J1.SHLD0, J1.SHLD1, J2.3, J2.5, J2.9, J4.6 (GND), J4.CD2, J4.GND1 (SHIELD1), J5.4, R4.1, R6.1, R14.2, R15.2, R21.1, RJ1.6, U2.5, U3.PAD, U4.3; also elsewhere on the board
LED1/REGOFF: J1.9 (LED_G+), U3.3
LED2/NINTSEL: J1.12 (LED_Y+), R4.2, U3.2
unnamed: J1.11 (LED_Y-), R14.1
unnamed: J1.10 (LED_G-), R15.1
unnamed: R1.2, U3.8
unnamed: C25.2, U5.2
unnamed: R2.2, U3.7
unnamed: R3.2, U3.11
unnamed: R7.2, U4.4
unnamed: C12.POS, C13.2, C14.2, C19.2, C20.2, FB1.2, J1.4, J1.5, R10.2, R11.2, R12.2, R13.2, U3.1, U3.19
unnamed: C15.POS, C16.2, U3.6
NINT/REFCLK0: U3.14, U4.2
NRST: U3.15
RBIAS: R6.2, U3.24
RD+: C23.2, J1.3 (RD+), R12.1, U3.23
RD-: C24.2, J1.6 (RD-), R13.1, U3.22
RESET_N: J2.10; also elsewhere on the board
RO: U2.1; also elsewhere on the board
RTCK: J2.7; also elsewhere on the board
SD_CS: J4.2 (CS), R18.2; also elsewhere on the board
SD_MISO: J4.7 (DO), R17.2; also elsewhere on the board
SD_MOSI: J4.3 (DI), R16.2; also elsewhere on the board
SD_SCK: J4.5 (SCK); also elsewhere on the board
SWDCLK: J2.4; also elsewhere on the board
SWDIO: J2.2; also elsewhere on the board
SWO: J2.6; also elsewhere on the board
TD+: C21.2, J1.1 (TD+), R10.1, U3.21
TD-: C22.2, J1.2 (TD-), R11.1, U3.20
TDI: J2.8; also elsewhere on the board
USB_D+: J5.3; also elsewhere on the board
USB_D-: J5.2; also elsewhere on the board
VRIN: J5.1, U5.1, U5.3
VROUT: C26.2, U5.5
XTAL1: C9.2, Q1.1, R5.1, U3.5; also elsewhere on the board
XTAL2: C10.2, Q1.2, R5.2, U3.4; also elsewhere on the board

Notes on the sheet:
*Configured for power in through USB
*Review values for these 18pF caps.
*MicroSD Connector
!RE
* Serial Wire Debug Connector
* RS-485 Transceiver

Board: 4 copper layers, 77 parts (0 on the bottom side), 56 nets, no tracks yet.
