firepick-delta/fpd-electronics/EAGLE/ETEST01 - 200mm x 200mm 0805s/ETEST01.brd

## EAGLE design EAGLE/ETEST01 - 200mm x 200mm 0805s/ETEST01.brd (2015-08-24)

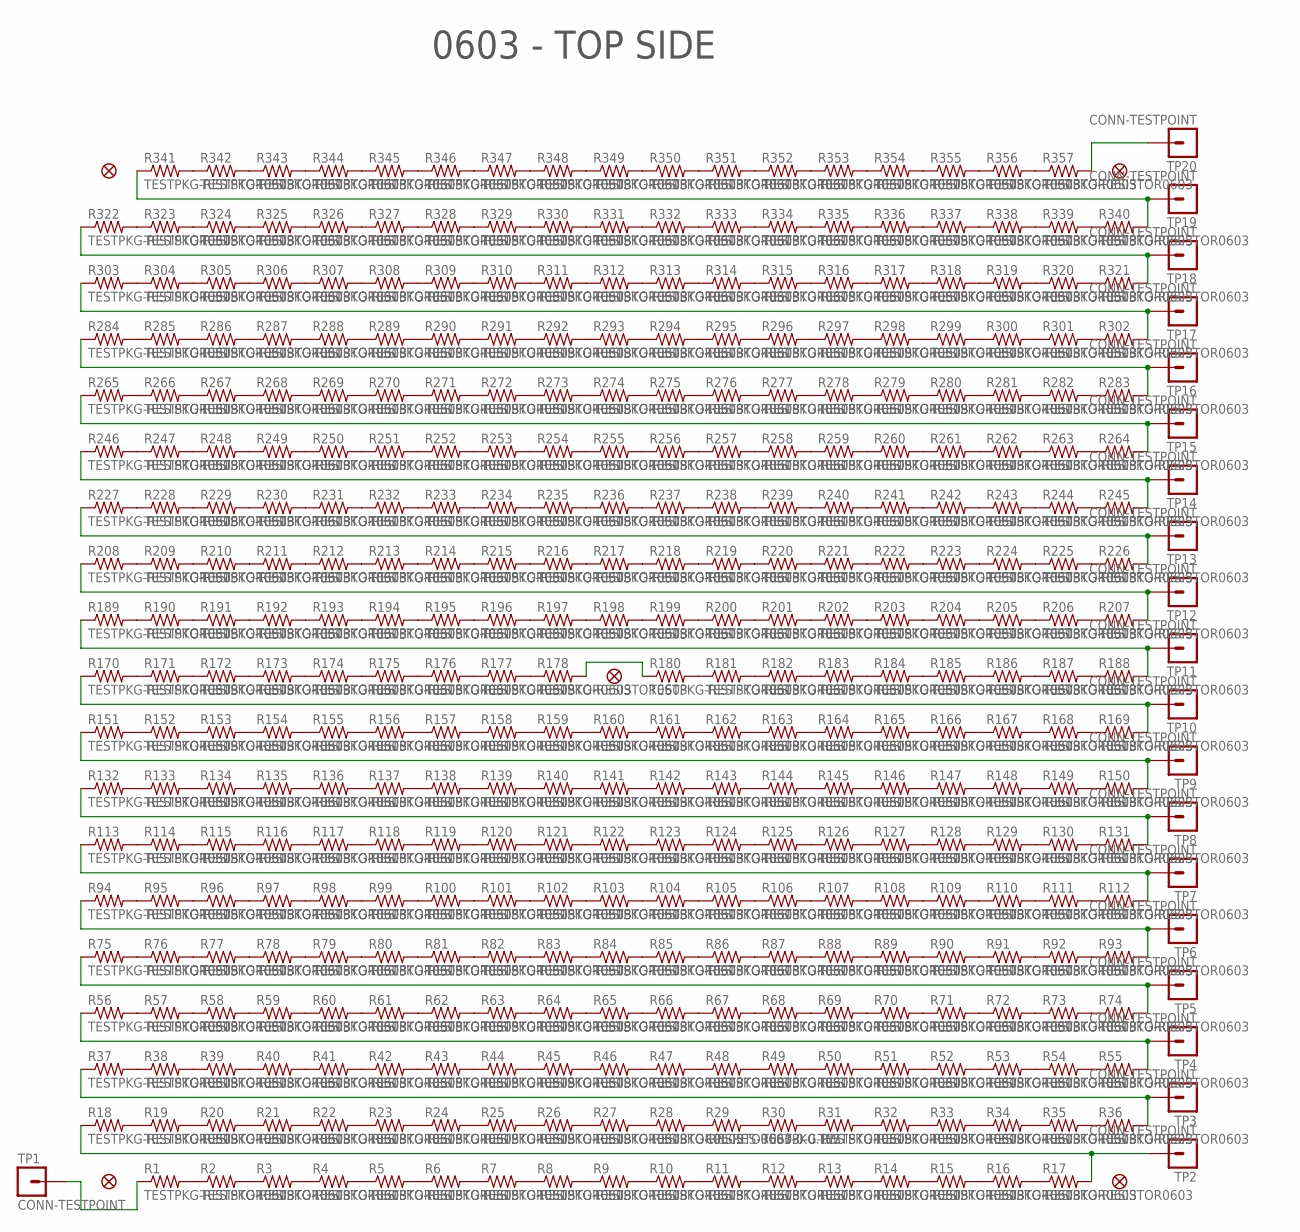
[picture p56: schematic ETEST01.sch, sheet 1]

Parts:
FID1, FID2, FID3, FID4, FID5: FIDUCIAL
R1, R2, R3, R4, R5, R6, R7, R8, R9, R10, R11, R12, R13, R14, R15, R16, R17, R18, R19, R20, R21, R22, R23, R24, R25, R26, R27, R28, R30, R31, R32, R33, R34, R35, R36, R37, R38, R39, R40, R41, R42, R43, R44, R45, R46, R47, R48, R49, R50, R51, R52, R53, R54, R55, R56, R57, R58, R59, R60, R61, R62, R63, R64, R65, R66, R67, R68, R69, R70, R71, R72, R73, R74, R75, R76, R77, R78, R79, R80, R81, R82, R83, R84, R85, R86, R87, R88, R89, R90, R91, R92, R93, R94, R95, R96, R97, R98, R99, R100, R101, R102, R103, R104, R105, R106, R107, R108, R109, R110, R111, R112, R113, R114, R115, R116, R117, R118, R119, R120, R121, R122, R123, R124, R125, R126, R127, R128, R129, R130, R131, R132, R133, R134, R135, R136, R137, R138, R139, R140, R141, R142, R143, R144, R145, R146, R147, R148, R149, R150, R151, R152, R153, R154, R155, R156, R157, R158, R159, R160, R161, R162, R163, R164, R165, R166, R167, R168, R169, R170, R171, R172, R173, R174, R175, R176, R177, R178, R180, R181, R182, R183, R184, R185, R186, R187, R188, R189, R190, R191, R192, R193, R194, R195, R196, R197, R198, R199, R200, R201, R202, R203, R204, R205, R206, R207, R208, R209, R210, R211, R212, R213, R214, R215, R216, R217, R218, R219, R220, R221, R222, R223, R224, R225, R226, R227, R228, R229, R230, R231, R232, R233, R234, R235, R236, R237, R238, R239, R240, R241, R242, R243, R244, R245, R246, R247, R248, R249, R250, R251, R252, R253, R254, R255, R256, R257, R258, R259, R260, R261, R262, R263, R264, R265, R266, R267, R268, R269, R270, R271, R272, R273, R274, R275, R276, R277, R278, R279, R280, R281, R282, R283, R284, R285, R286, R287, R288, R289, R290, R291, R292, R293, R294, R295, R296, R297, R298, R299, R300, R301, R302, R303, R304, R305, R306, R307, R308, R309, R310, R311, R312, R313, R314, R315, R316, R317, R318, R319, R320, R321, R322, R323, R324, R325, R326, R327, R328, R329, R330, R331, R332, R333, R334, R335, R336, R337, R338, R339, R340, R341, R342, R343, R344, R345, R346, R347, R348, R349, R350, R351, R352, R353, R354, R355, R356, R357: TESTPKG-RESISTOR0603; TESTPKG-R0603
R29: CPL-RES-0603-0-0.1W; R0603
TP1, TP2, TP3, TP4, TP5, TP6, TP7, TP8, TP9, TP10, TP11, TP12, TP13, TP14, TP15, TP16, TP17, TP18, TP19, TP20: CONN-TESTPOINT; CON-TESTPOINT

Connections:
unnamed: R228.2, R229.1
unnamed: R226.2, R227.1, TP13.1
unnamed: R225.2, R226.1
unnamed: R224.2, R225.1
unnamed: R223.2, R224.1
unnamed: R222.2, R223.1
unnamed: R221.2, R222.1
unnamed: R220.2, R221.1
unnamed: R219.2, R220.1
unnamed: R218.2, R219.1
unnamed: R217.2, R218.1
unnamed: R216.2, R217.1
unnamed: R215.2, R216.1
unnamed: R214.2, R215.1
unnamed: R213.2, R214.1
unnamed: R212.2, R213.1
unnamed: R342.2, R343.1
unnamed: R211.2, R212.1
unnamed: R210.2, R211.1
unnamed: R209.2, R210.1
unnamed: R207.2, R208.1, TP12.1
unnamed: R206.2, R207.1
unnamed: R205.2, R206.1
unnamed: R204.2, R205.1
unnamed: R203.2, R204.1
unnamed: R202.2, R203.1
unnamed: R201.2, R202.1
unnamed: R200.2, R201.1
unnamed: R199.2, R200.1
unnamed: R198.2, R199.1
unnamed: R197.2, R198.1
unnamed: R196.2, R197.1
unnamed: R195.2, R196.1
unnamed: R194.2, R195.1
unnamed: R193.2, R194.1
unnamed: R192.2, R193.1
unnamed: R191.2, R192.1
unnamed: R190.2, R191.1
unnamed: R188.2, R189.1, TP11.1
unnamed: R187.2, R188.1
unnamed: R186.2, R187.1
unnamed: R185.2, R186.1
unnamed: R184.2, R185.1
unnamed: R183.2, R184.1
unnamed: R182.2, R183.1
unnamed: R181.2, R182.1
unnamed: R180.2, R181.1
unnamed: R178.2, R180.1
unnamed: R357.2, TP20.1
unnamed: R177.2, R178.1
unnamed: R176.2, R177.1
unnamed: R175.2, R176.1
unnamed: R174.2, R175.1
unnamed: R173.2, R174.1
unnamed: R172.2, R173.1
unnamed: R171.2, R172.1
unnamed: R169.2, R170.1, TP10.1
unnamed: R168.2, R169.1
unnamed: R167.2, R168.1
unnamed: R166.2, R167.1
unnamed: R165.2, R166.1
unnamed: R164.2, R165.1
unnamed: R163.2, R164.1
unnamed: R162.2, R163.1
unnamed: R161.2, R162.1
unnamed: R160.2, R161.1
unnamed: R159.2, R160.1
unnamed: R158.2, R159.1
unnamed: R157.2, R158.1
unnamed: R156.2, R157.1
unnamed: R155.2, R156.1
unnamed: R154.2, R155.1
unnamed: R153.2, R154.1
unnamed: R152.2, R153.1
unnamed: R150.2, R151.1, TP9.1
unnamed: R149.2, R150.1
unnamed: R148.2, R149.1
unnamed: R147.2, R148.1
unnamed: R146.2, R147.1
unnamed: R145.2, R146.1
unnamed: R144.2, R145.1
unnamed: R143.2, R144.1
unnamed: R142.2, R143.1
unnamed: R141.2, R142.1
unnamed: R140.2, R141.1
unnamed: R139.2, R140.1
unnamed: R138.2, R139.1
unnamed: R137.2, R138.1
unnamed: R136.2, R137.1
unnamed: R135.2, R136.1
unnamed: R134.2, R135.1
unnamed: R133.2, R134.1
unnamed: R131.2, R132.1, TP8.1
unnamed: R130.2, R131.1
unnamed: R129.2, R130.1
unnamed: R128.2, R129.1
unnamed: R127.2, R128.1
unnamed: R126.2, R127.1
unnamed: R125.2, R126.1
unnamed: R124.2, R125.1
unnamed: R123.2, R124.1
unnamed: R122.2, R123.1
unnamed: R121.2, R122.1
unnamed: R120.2, R121.1
unnamed: R119.2, R120.1
unnamed: R118.2, R119.1
unnamed: R117.2, R118.1
unnamed: R116.2, R117.1
unnamed: R115.2, R116.1
unnamed: R114.2, R115.1
unnamed: R112.2, R113.1, TP7.1
unnamed: R111.2, R112.1
unnamed: R110.2, R111.1
unnamed: R109.2, R110.1
unnamed: R108.2, R109.1
unnamed: R107.2, R108.1
unnamed: R106.2, R107.1
unnamed: R105.2, R106.1
unnamed: R104.2, R105.1
unnamed: R103.2, R104.1
unnamed: R102.2, R103.1
unnamed: R101.2, R102.1
unnamed: R100.2, R101.1
unnamed: R99.2, R100.1
unnamed: R98.2, R99.1
unnamed: R97.2, R98.1
unnamed: R96.2, R97.1
unnamed: R95.2, R96.1
unnamed: R93.2, R94.1, TP6.1
unnamed: R92.2, R93.1
unnamed: R91.2, R92.1
unnamed: R90.2, R91.1
unnamed: R89.2, R90.1
unnamed: R88.2, R89.1
unnamed: R87.2, R88.1
unnamed: R86.2, R87.1
unnamed: R85.2, R86.1
unnamed: R84.2, R85.1
unnamed: R83.2, R84.1
unnamed: R82.2, R83.1
unnamed: R81.2, R82.1
unnamed: R80.2, R81.1
unnamed: R79.2, R80.1
unnamed: R78.2, R79.1
unnamed: R77.2, R78.1
unnamed: R76.2, R77.1
unnamed: R75.2, R76.1
unnamed: R73.2, R74.1
unnamed: R72.2, R73.1
unnamed: R71.2, R72.1
unnamed: R70.2, R71.1
unnamed: R69.2, R70.1
unnamed: R68.2, R69.1
unnamed: R67.2, R68.1
unnamed: R66.2, R67.1
unnamed: R65.2, R66.1
unnamed: R64.2, R65.1
unnamed: R63.2, R64.1
unnamed: R62.2, R63.1
unnamed: R61.2, R62.1
unnamed: R60.2, R61.1
unnamed: R59.2, R60.1
unnamed: R58.2, R59.1
unnamed: R57.2, R58.1
unnamed: R56.2, R57.1
unnamed: R54.2, R55.1
unnamed: R53.2, R54.1
unnamed: R52.2, R53.1
unnamed: R51.2, R52.1
unnamed: R50.2, R51.1
unnamed: R49.2, R50.1
unnamed: R48.2, R49.1
unnamed: R47.2, R48.1
unnamed: R46.2, R47.1
unnamed: R45.2, R46.1
unnamed: R44.2, R45.1
unnamed: R43.2, R44.1
unnamed: R42.2, R43.1
unnamed: R41.2, R42.1
unnamed: R40.2, R41.1
unnamed: R39.2, R40.1
unnamed: R38.2, R39.1
unnamed: R37.2, R38.1
unnamed: R35.2, R36.1
unnamed: R34.2, R35.1
unnamed: R33.2, R34.1
unnamed: R32.2, R33.1
unnamed: R31.2, R32.1
unnamed: R30.2, R31.1
unnamed: R29.2, R30.1
unnamed: R28.2, R29.1
unnamed: R27.2, R28.1
unnamed: R26.2, R27.1
unnamed: R25.2, R26.1
unnamed: R24.2, R25.1
unnamed: R23.2, R24.1
unnamed: R22.2, R23.1
unnamed: R21.2, R22.1
unnamed: R20.2, R21.1
unnamed: R19.2, R20.1
unnamed: R18.2, R19.1
unnamed: R16.2, R17.1
unnamed: R15.2, R16.1
unnamed: R14.2, R15.1
unnamed: R13.2, R14.1
unnamed: R12.2, R13.1
unnamed: R11.2, R12.1
unnamed: R10.2, R11.1
unnamed: R9.2, R10.1
unnamed: R8.2, R9.1
unnamed: R7.2, R8.1
unnamed: R6.2, R7.1
unnamed: R5.2, R6.1
unnamed: R4.2, R5.1
unnamed: R3.2, R4.1
unnamed: R2.2, R3.1
unnamed: R229.2, R230.1
unnamed: R343.2, R344.1
unnamed: R344.2, R345.1
unnamed: R345.2, R346.1
unnamed: R346.2, R347.1
unnamed: R347.2, R348.1
unnamed: R348.2, R349.1
unnamed: R349.2, R350.1
unnamed: R350.2, R351.1
unnamed: R351.2, R352.1
unnamed: R352.2, R353.1
unnamed: R353.2, R354.1
unnamed: R354.2, R355.1
unnamed: R355.2, R356.1
unnamed: R356.2, R357.1
unnamed: R74.2, R75.1, TP5.1
unnamed: R324.2, R325.1
unnamed: R325.2, R326.1
unnamed: R326.2, R327.1
unnamed: R327.2, R328.1
unnamed: R328.2, R329.1
unnamed: R329.2, R330.1
unnamed: R330.2, R331.1
unnamed: R331.2, R332.1
unnamed: R332.2, R333.1
unnamed: R333.2, R334.1
unnamed: R334.2, R335.1
unnamed: R335.2, R336.1
unnamed: R336.2, R337.1
unnamed: R337.2, R338.1
unnamed: R338.2, R339.1
unnamed: R339.2, R340.1
unnamed: R340.2, R341.1, TP19.1
unnamed: R323.2, R324.1
unnamed: R306.2, R307.1
unnamed: R305.2, R306.1
unnamed: R307.2, R308.1
unnamed: R308.2, R309.1
unnamed: R309.2, R310.1
unnamed: R310.2, R311.1
unnamed: R311.2, R312.1
unnamed: R312.2, R313.1
unnamed: R313.2, R314.1
unnamed: R314.2, R315.1
unnamed: R315.2, R316.1
unnamed: R316.2, R317.1
unnamed: R317.2, R318.1
unnamed: R318.2, R319.1
unnamed: R319.2, R320.1
unnamed: R320.2, R321.1
unnamed: R321.2, R322.1, TP18.1
unnamed: R304.2, R305.1
unnamed: R285.2, R286.1
unnamed: R280.2, R281.1
unnamed: R281.2, R282.1
unnamed: R282.2, R283.1
unnamed: R273.2, R274.1
unnamed: R274.2, R275.1
unnamed: R275.2, R276.1
unnamed: R276.2, R277.1
unnamed: R277.2, R278.1
unnamed: R278.2, R279.1
unnamed: R279.2, R280.1
unnamed: R268.2, R269.1
unnamed: R269.2, R270.1
unnamed: R270.2, R271.1
unnamed: R271.2, R272.1
unnamed: R272.2, R273.1
unnamed: R267.2, R268.1
unnamed: R283.2, R284.1, TP16.1
unnamed: R286.2, R287.1
unnamed: R287.2, R288.1
unnamed: R288.2, R289.1
unnamed: R289.2, R290.1
unnamed: R290.2, R291.1
unnamed: R291.2, R292.1
unnamed: R292.2, R293.1
unnamed: R293.2, R294.1
unnamed: R294.2, R295.1
unnamed: R295.2, R296.1
unnamed: R296.2, R297.1
unnamed: R297.2, R298.1
unnamed: R298.2, R299.1
unnamed: R299.2, R300.1
unnamed: R300.2, R301.1
unnamed: R301.2, R302.1
unnamed: R302.2, R303.1, TP17.1
unnamed: R266.2, R267.1
unnamed: R264.2, R265.1, TP15.1
unnamed: R263.2, R264.1
unnamed: R262.2, R263.1
unnamed: R261.2, R262.1
unnamed: R260.2, R261.1
unnamed: R259.2, R260.1
unnamed: R258.2, R259.1
unnamed: R257.2, R258.1
unnamed: R256.2, R257.1
unnamed: R255.2, R256.1
unnamed: R254.2, R255.1
unnamed: R253.2, R254.1
unnamed: R252.2, R253.1
unnamed: R251.2, R252.1
unnamed: R250.2, R251.1
unnamed: R249.2, R250.1
unnamed: R248.2, R249.1
unnamed: R247.2, R248.1
unnamed: R245.2, R246.1, TP14.1
unnamed: R244.2, R245.1
unnamed: R243.2, R244.1
unnamed: R242.2, R243.1
unnamed: R241.2, R242.1
unnamed: R240.2, R241.1
unnamed: R239.2, R240.1
unnamed: R238.2, R239.1
unnamed: R237.2, R238.1
unnamed: R236.2, R237.1
unnamed: R235.2, R236.1
unnamed: R234.2, R235.1
unnamed: R233.2, R234.1
unnamed: R232.2, R233.1
unnamed: R231.2, R232.1
unnamed: R230.2, R231.1
unnamed: R1.2, R2.1
unnamed: R94.2, R95.1
unnamed: R113.2, R114.1
unnamed: R132.2, R133.1
unnamed: R151.2, R152.1
unnamed: R170.2, R171.1
unnamed: R189.2, R190.1
unnamed: R208.2, R209.1
unnamed: R227.2, R228.1
unnamed: R246.2, R247.1
unnamed: R265.2, R266.1
unnamed: R284.2, R285.1
unnamed: R303.2, R304.1
unnamed: R322.2, R323.1
unnamed: R341.2, R342.1
unnamed: R55.2, R56.1, TP4.1
unnamed: R36.2, R37.1, TP3.1
unnamed: R17.2, R18.1, TP2.1
unnamed: R1.1, TP1.1

Notes on the sheet:
0603 - TOP SIDE
