firepick-delta/fpd-electronics/EAGLE/ETEST01 - 200mm x 200mm 0805s/ETEST01.brd

## EAGLE design EAGLE/ETEST01 - 200mm x 200mm 0805s/ETEST01.brd (continued)

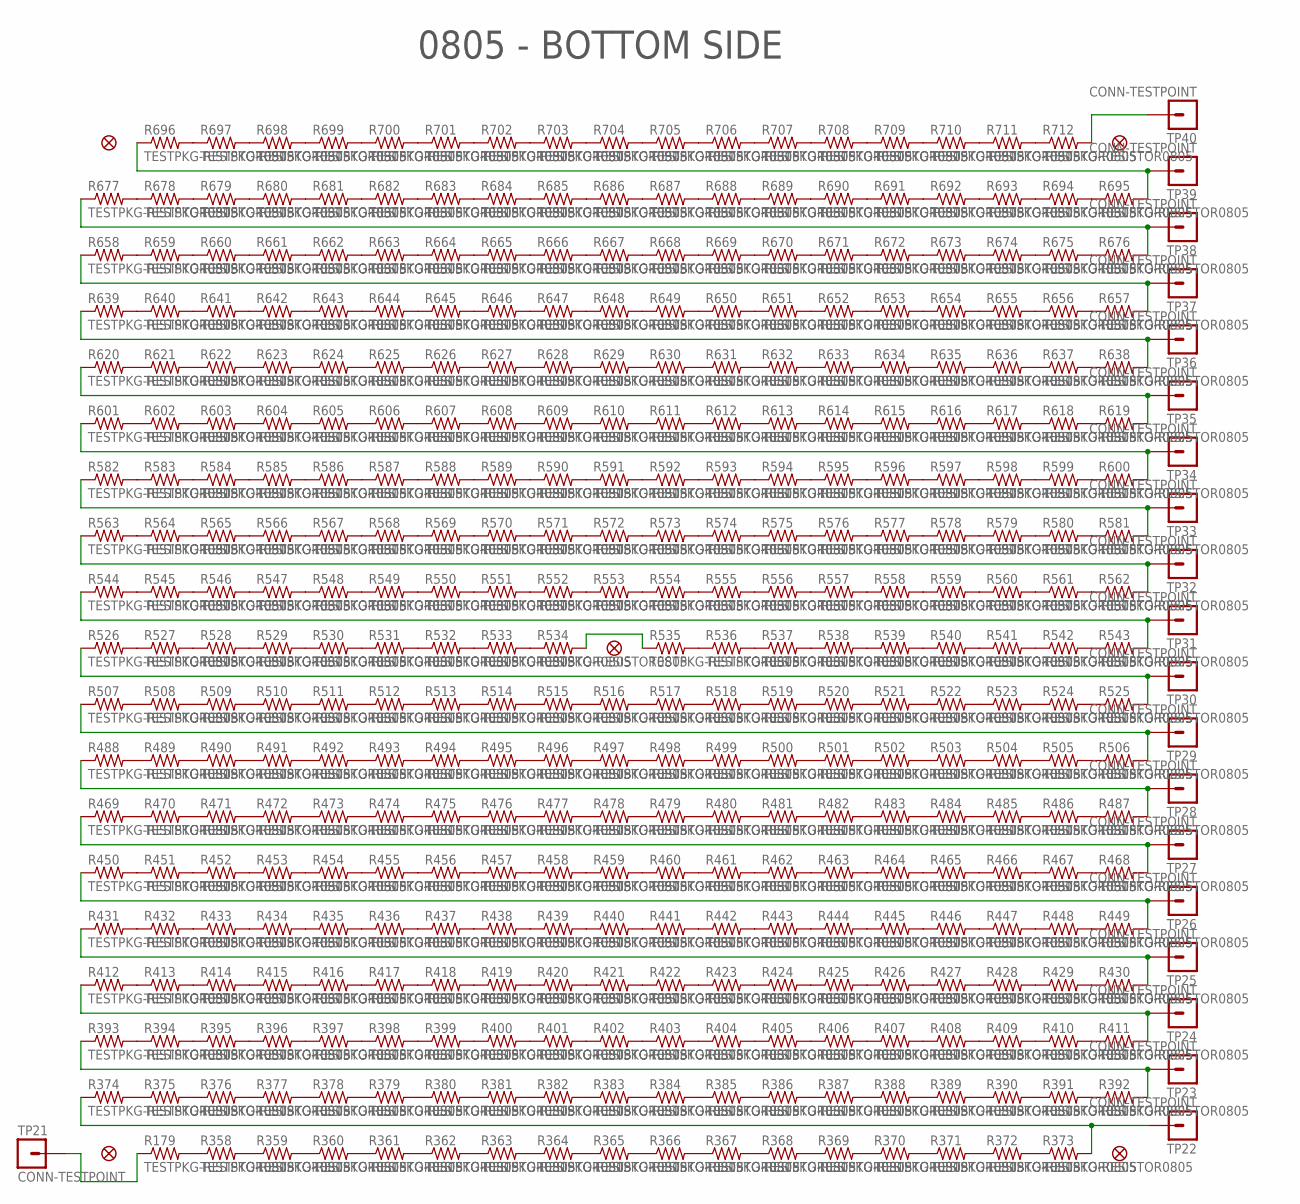
[picture p57: schematic ETEST01.sch, sheet 2]

Parts:
FID6, FID7, FID8, FID9, FID10: FIDUCIAL
R179, R358, R359, R360, R361, R362, R363, R364, R365, R366, R367, R368, R369, R370, R371, R372, R373, R374, R375, R376, R377, R378, R379, R380, R381, R382, R383, R384, R385, R386, R387, R388, R389, R390, R391, R392, R393, R394, R395, R396, R397, R398, R399, R400, R401, R402, R403, R404, R405, R406, R407, R408, R409, R410, R411, R412, R413, R414, R415, R416, R417, R418, R419, R420, R421, R422, R423, R424, R425, R426, R427, R428, R429, R430, R431, R432, R433, R434, R435, R436, R437, R438, R439, R440, R441, R442, R443, R444, R445, R446, R447, R448, R449, R450, R451, R452, R453, R454, R455, R456, R457, R458, R459, R460, R461, R462, R463, R464, R465, R466, R467, R468, R469, R470, R471, R472, R473, R474, R475, R476, R477, R478, R479, R480, R481, R482, R483, R484, R485, R486, R487, R488, R489, R490, R491, R492, R493, R494, R495, R496, R497, R498, R499, R500, R501, R502, R503, R504, R505, R506, R507, R508, R509, R510, R511, R512, R513, R514, R515, R516, R517, R518, R519, R520, R521, R522, R523, R524, R525, R526, R527, R528, R529, R530, R531, R532, R533, R534, R535, R536, R537, R538, R539, R540, R541, R542, R543, R544, R545, R546, R547, R548, R549, R550, R551, R552, R553, R554, R555, R556, R557, R558, R559, R560, R561, R562, R563, R564, R565, R566, R567, R568, R569, R570, R571, R572, R573, R574, R575, R576, R577, R578, R579, R580, R581, R582, R583, R584, R585, R586, R587, R588, R589, R590, R591, R592, R593, R594, R595, R596, R597, R598, R599, R600, R601, R602, R603, R604, R605, R606, R607, R608, R609, R610, R611, R612, R613, R614, R615, R616, R617, R618, R619, R620, R621, R622, R623, R624, R625, R626, R627, R628, R629, R630, R631, R632, R633, R634, R635, R636, R637, R638, R639, R640, R641, R642, R643, R644, R645, R646, R647, R648, R649, R650, R651, R652, R653, R654, R655, R656, R657, R658, R659, R660, R661, R662, R663, R664, R665, R666, R667, R668, R669, R670, R671, R672, R673, R674, R675, R676, R677, R678, R679, R680, R681, R682, R683, R684, R685, R686, R687, R688, R689, R690, R691, R692, R693, R694, R695, R696, R697, R698, R699, R700, R701, R702, R703, R704, R705, R706, R707, R708, R709, R710, R711, R712: TESTPKG-RESISTOR0805; TESTPKG-R0805
TP21, TP22, TP23, TP24, TP25, TP26, TP27, TP28, TP29, TP30, TP31, TP32, TP33, TP34, TP35, TP36, TP37, TP38, TP39, TP40: CONN-TESTPOINT; CON-TESTPOINT

Connections:
unnamed: R584.2, R585.1
unnamed: R698.2, R699.1
unnamed: R699.2, R700.1
unnamed: R700.2, R701.1
unnamed: R701.2, R702.1
unnamed: R702.2, R703.1
unnamed: R703.2, R704.1
unnamed: R704.2, R705.1
unnamed: R705.2, R706.1
unnamed: R706.2, R707.1
unnamed: R707.2, R708.1
unnamed: R708.2, R709.1
unnamed: R709.2, R710.1
unnamed: R710.2, R711.1
unnamed: R711.2, R712.1
unnamed: R679.2, R680.1
unnamed: R680.2, R681.1
unnamed: R681.2, R682.1
unnamed: R682.2, R683.1
unnamed: R683.2, R684.1
unnamed: R684.2, R685.1
unnamed: R685.2, R686.1
unnamed: R686.2, R687.1
unnamed: R687.2, R688.1
unnamed: R688.2, R689.1
unnamed: R689.2, R690.1
unnamed: R690.2, R691.1
unnamed: R691.2, R692.1
unnamed: R692.2, R693.1
unnamed: R693.2, R694.1
unnamed: R694.2, R695.1
unnamed: R695.2, R696.1, TP39.1
unnamed: R697.2, R698.1
unnamed: R678.2, R679.1
unnamed: R661.2, R662.1
unnamed: R660.2, R661.1
unnamed: R662.2, R663.1
unnamed: R663.2, R664.1
unnamed: R664.2, R665.1
unnamed: R665.2, R666.1
unnamed: R666.2, R667.1
unnamed: R667.2, R668.1
unnamed: R668.2, R669.1
unnamed: R669.2, R670.1
unnamed: R670.2, R671.1
unnamed: R671.2, R672.1
unnamed: R672.2, R673.1
unnamed: R673.2, R674.1
unnamed: R674.2, R675.1
unnamed: R675.2, R676.1
unnamed: R676.2, R677.1, TP38.1
unnamed: R659.2, R660.1
unnamed: R640.2, R641.1
unnamed: R641.2, R642.1
unnamed: R642.2, R643.1
unnamed: R643.2, R644.1
unnamed: R644.2, R645.1
unnamed: R645.2, R646.1
unnamed: R646.2, R647.1
unnamed: R647.2, R648.1
unnamed: R648.2, R649.1
unnamed: R649.2, R650.1
unnamed: R650.2, R651.1
unnamed: R651.2, R652.1
unnamed: R652.2, R653.1
unnamed: R653.2, R654.1
unnamed: R654.2, R655.1
unnamed: R655.2, R656.1
unnamed: R656.2, R657.1
unnamed: R657.2, R658.1, TP37.1
unnamed: R622.2, R623.1
unnamed: R623.2, R624.1
unnamed: R624.2, R625.1
unnamed: R625.2, R626.1
unnamed: R626.2, R627.1
unnamed: R627.2, R628.1
unnamed: R628.2, R629.1
unnamed: R629.2, R630.1
unnamed: R630.2, R631.1
unnamed: R631.2, R632.1
unnamed: R632.2, R633.1
unnamed: R633.2, R634.1
unnamed: R634.2, R635.1
unnamed: R635.2, R636.1
unnamed: R636.2, R637.1
unnamed: R637.2, R638.1
unnamed: R638.2, R639.1, TP36.1
unnamed: R621.2, R622.1
unnamed: R619.2, R620.1, TP35.1
unnamed: R618.2, R619.1
unnamed: R617.2, R618.1
unnamed: R616.2, R617.1
unnamed: R615.2, R616.1
unnamed: R614.2, R615.1
unnamed: R613.2, R614.1
unnamed: R612.2, R613.1
unnamed: R611.2, R612.1
unnamed: R610.2, R611.1
unnamed: R609.2, R610.1
unnamed: R608.2, R609.1
unnamed: R607.2, R608.1
unnamed: R606.2, R607.1
unnamed: R605.2, R606.1
unnamed: R604.2, R605.1
unnamed: R603.2, R604.1
unnamed: R602.2, R603.1
unnamed: R600.2, R601.1, TP34.1
unnamed: R599.2, R600.1
unnamed: R598.2, R599.1
unnamed: R597.2, R598.1
unnamed: R596.2, R597.1
unnamed: R595.2, R596.1
unnamed: R594.2, R595.1
unnamed: R593.2, R594.1
unnamed: R592.2, R593.1
unnamed: R591.2, R592.1
unnamed: R590.2, R591.1
unnamed: R589.2, R590.1
unnamed: R588.2, R589.1
unnamed: R587.2, R588.1
unnamed: R586.2, R587.1
unnamed: R585.2, R586.1
unnamed: R583.2, R584.1
unnamed: R581.2, R582.1, TP33.1
unnamed: R580.2, R581.1
unnamed: R579.2, R580.1
unnamed: R578.2, R579.1
unnamed: R577.2, R578.1
unnamed: R576.2, R577.1
unnamed: R575.2, R576.1
unnamed: R574.2, R575.1
unnamed: R573.2, R574.1
unnamed: R572.2, R573.1
unnamed: R571.2, R572.1
unnamed: R570.2, R571.1
unnamed: R569.2, R570.1
unnamed: R568.2, R569.1
unnamed: R567.2, R568.1
unnamed: R566.2, R567.1
unnamed: R565.2, R566.1
unnamed: R564.2, R565.1
unnamed: R562.2, R563.1, TP32.1
unnamed: R561.2, R562.1
unnamed: R560.2, R561.1
unnamed: R559.2, R560.1
unnamed: R558.2, R559.1
unnamed: R557.2, R558.1
unnamed: R556.2, R557.1
unnamed: R555.2, R556.1
unnamed: R554.2, R555.1
unnamed: R553.2, R554.1
unnamed: R552.2, R553.1
unnamed: R551.2, R552.1
unnamed: R550.2, R551.1
unnamed: R549.2, R550.1
unnamed: R548.2, R549.1
unnamed: R547.2, R548.1
unnamed: R546.2, R547.1
unnamed: R545.2, R546.1
unnamed: R543.2, R544.1, TP31.1
unnamed: R542.2, R543.1
unnamed: R541.2, R542.1
unnamed: R540.2, R541.1
unnamed: R539.2, R540.1
unnamed: R538.2, R539.1
unnamed: R537.2, R538.1
unnamed: R536.2, R537.1
unnamed: R535.2, R536.1
unnamed: R533.2, R534.1
unnamed: R532.2, R533.1
unnamed: R531.2, R532.1
unnamed: R530.2, R531.1
unnamed: R529.2, R530.1
unnamed: R528.2, R529.1
unnamed: R527.2, R528.1
unnamed: R525.2, R526.1, TP30.1
unnamed: R524.2, R525.1
unnamed: R523.2, R524.1
unnamed: R522.2, R523.1
unnamed: R521.2, R522.1
unnamed: R520.2, R521.1
unnamed: R519.2, R520.1
unnamed: R518.2, R519.1
unnamed: R517.2, R518.1
unnamed: R516.2, R517.1
unnamed: R515.2, R516.1
unnamed: R514.2, R515.1
unnamed: R513.2, R514.1
unnamed: R512.2, R513.1
unnamed: R511.2, R512.1
unnamed: R510.2, R511.1
unnamed: R509.2, R510.1
unnamed: R508.2, R509.1
unnamed: R506.2, R507.1, TP29.1
unnamed: R505.2, R506.1
unnamed: R504.2, R505.1
unnamed: R503.2, R504.1
unnamed: R502.2, R503.1
unnamed: R501.2, R502.1
unnamed: R500.2, R501.1
unnamed: R499.2, R500.1
unnamed: R498.2, R499.1
unnamed: R497.2, R498.1
unnamed: R496.2, R497.1
unnamed: R495.2, R496.1
unnamed: R494.2, R495.1
unnamed: R493.2, R494.1
unnamed: R492.2, R493.1
unnamed: R491.2, R492.1
unnamed: R490.2, R491.1
unnamed: R489.2, R490.1
unnamed: R487.2, R488.1, TP28.1
unnamed: R486.2, R487.1
unnamed: R485.2, R486.1
unnamed: R484.2, R485.1
unnamed: R483.2, R484.1
unnamed: R482.2, R483.1
unnamed: R481.2, R482.1
unnamed: R480.2, R481.1
unnamed: R479.2, R480.1
unnamed: R478.2, R479.1
unnamed: R477.2, R478.1
unnamed: R476.2, R477.1
unnamed: R475.2, R476.1
unnamed: R474.2, R475.1
unnamed: R473.2, R474.1
unnamed: R472.2, R473.1
unnamed: R471.2, R472.1
unnamed: R470.2, R471.1
unnamed: R468.2, R469.1, TP27.1
unnamed: R467.2, R468.1
unnamed: R466.2, R467.1
unnamed: R465.2, R466.1
unnamed: R464.2, R465.1
unnamed: R463.2, R464.1
unnamed: R462.2, R463.1
unnamed: R461.2, R462.1
unnamed: R460.2, R461.1
unnamed: R459.2, R460.1
unnamed: R458.2, R459.1
unnamed: R457.2, R458.1
unnamed: R456.2, R457.1
unnamed: R455.2, R456.1
unnamed: R454.2, R455.1
unnamed: R453.2, R454.1
unnamed: R452.2, R453.1
unnamed: R451.2, R452.1
unnamed: R449.2, R450.1, TP26.1
unnamed: R448.2, R449.1
unnamed: R447.2, R448.1
unnamed: R446.2, R447.1
unnamed: R445.2, R446.1
unnamed: R444.2, R445.1
unnamed: R443.2, R444.1
unnamed: R442.2, R443.1
unnamed: R441.2, R442.1
unnamed: R440.2, R441.1
unnamed: R439.2, R440.1
unnamed: R438.2, R439.1
unnamed: R437.2, R438.1
unnamed: R436.2, R437.1
unnamed: R435.2, R436.1
unnamed: R434.2, R435.1
unnamed: R433.2, R434.1
unnamed: R432.2, R433.1
unnamed: R429.2, R430.1
unnamed: R428.2, R429.1
unnamed: R427.2, R428.1
unnamed: R426.2, R427.1
unnamed: R425.2, R426.1
unnamed: R424.2, R425.1
unnamed: R423.2, R424.1
unnamed: R422.2, R423.1
unnamed: R421.2, R422.1
unnamed: R420.2, R421.1
unnamed: R419.2, R420.1
unnamed: R418.2, R419.1
unnamed: R417.2, R418.1
unnamed: R416.2, R417.1
unnamed: R415.2, R416.1
unnamed: R414.2, R415.1
unnamed: R413.2, R414.1
unnamed: R410.2, R411.1
unnamed: R409.2, R410.1
unnamed: R408.2, R409.1
unnamed: R407.2, R408.1
unnamed: R406.2, R407.1
unnamed: R405.2, R406.1
unnamed: R404.2, R405.1
unnamed: R403.2, R404.1
unnamed: R402.2, R403.1
unnamed: R401.2, R402.1
unnamed: R400.2, R401.1
unnamed: R399.2, R400.1
unnamed: R398.2, R399.1
unnamed: R397.2, R398.1
unnamed: R396.2, R397.1
unnamed: R395.2, R396.1
unnamed: R394.2, R395.1
unnamed: R391.2, R392.1
unnamed: R390.2, R391.1
unnamed: R389.2, R390.1
unnamed: R388.2, R389.1
unnamed: R387.2, R388.1
unnamed: R386.2, R387.1
unnamed: R385.2, R386.1
unnamed: R384.2, R385.1
unnamed: R383.2, R384.1
unnamed: R382.2, R383.1
unnamed: R381.2, R382.1
unnamed: R380.2, R381.1
unnamed: R379.2, R380.1
unnamed: R378.2, R379.1
unnamed: R377.2, R378.1
unnamed: R376.2, R377.1
unnamed: R375.2, R376.1
unnamed: R372.2, R373.1
unnamed: R371.2, R372.1
unnamed: R370.2, R371.1
unnamed: R369.2, R370.1
unnamed: R368.2, R369.1
unnamed: R367.2, R368.1
unnamed: R366.2, R367.1
unnamed: R365.2, R366.1
unnamed: R364.2, R365.1
unnamed: R363.2, R364.1
unnamed: R362.2, R363.1
unnamed: R361.2, R362.1
unnamed: R360.2, R361.1
unnamed: R359.2, R360.1
unnamed: R358.2, R359.1
unnamed: R179.2, R358.1
unnamed: R374.2, R375.1
unnamed: R393.2, R394.1
unnamed: R412.2, R413.1
unnamed: R431.2, R432.1
unnamed: R450.2, R451.1
unnamed: R469.2, R470.1
unnamed: R488.2, R489.1
unnamed: R507.2, R508.1
unnamed: R526.2, R527.1
unnamed: R544.2, R545.1
unnamed: R563.2, R564.1
unnamed: R582.2, R583.1
unnamed: R601.2, R602.1
unnamed: R620.2, R621.1
unnamed: R639.2, R640.1
unnamed: R658.2, R659.1
unnamed: R677.2, R678.1
unnamed: R696.2, R697.1
unnamed: R430.2, R431.1, TP25.1
unnamed: R411.2, R412.1, TP24.1
unnamed: R392.2, R393.1, TP23.1
unnamed: R373.2, R374.1, TP22.1
unnamed: R534.2, R535.1
unnamed: R712.2, TP40.1
unnamed: R179.1, TP21.1

Notes on the sheet:
0805 - BOTTOM SIDE

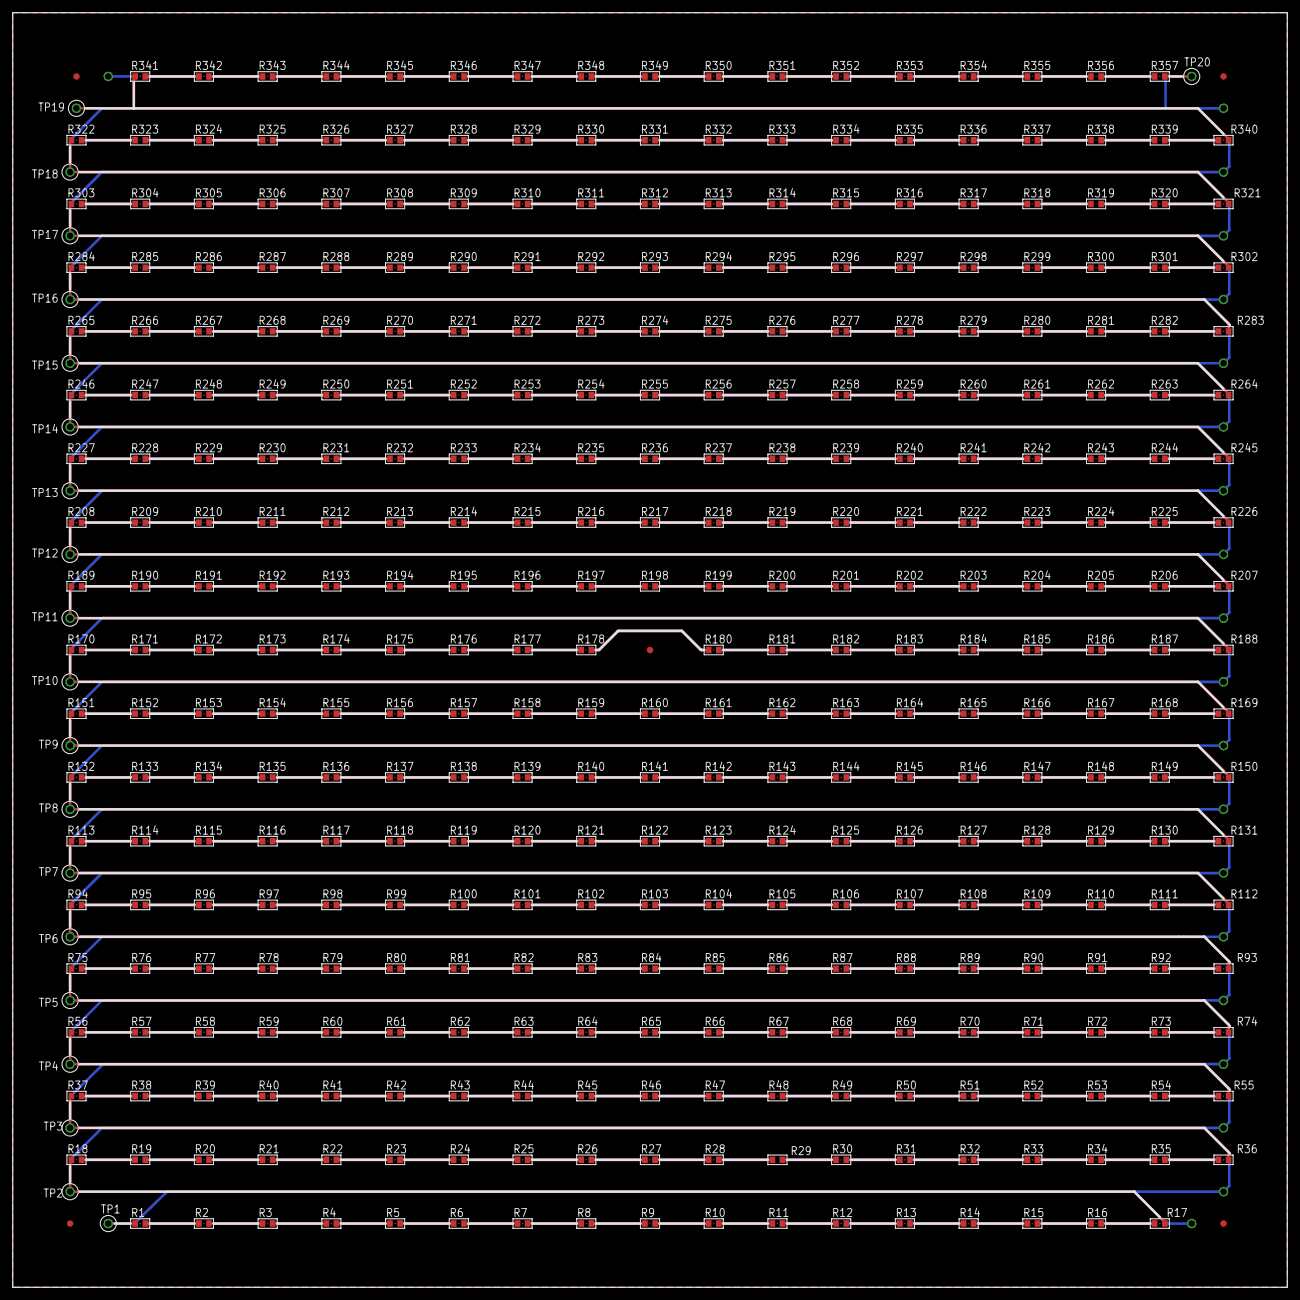
[picture p58: board ETEST01.brd from above]

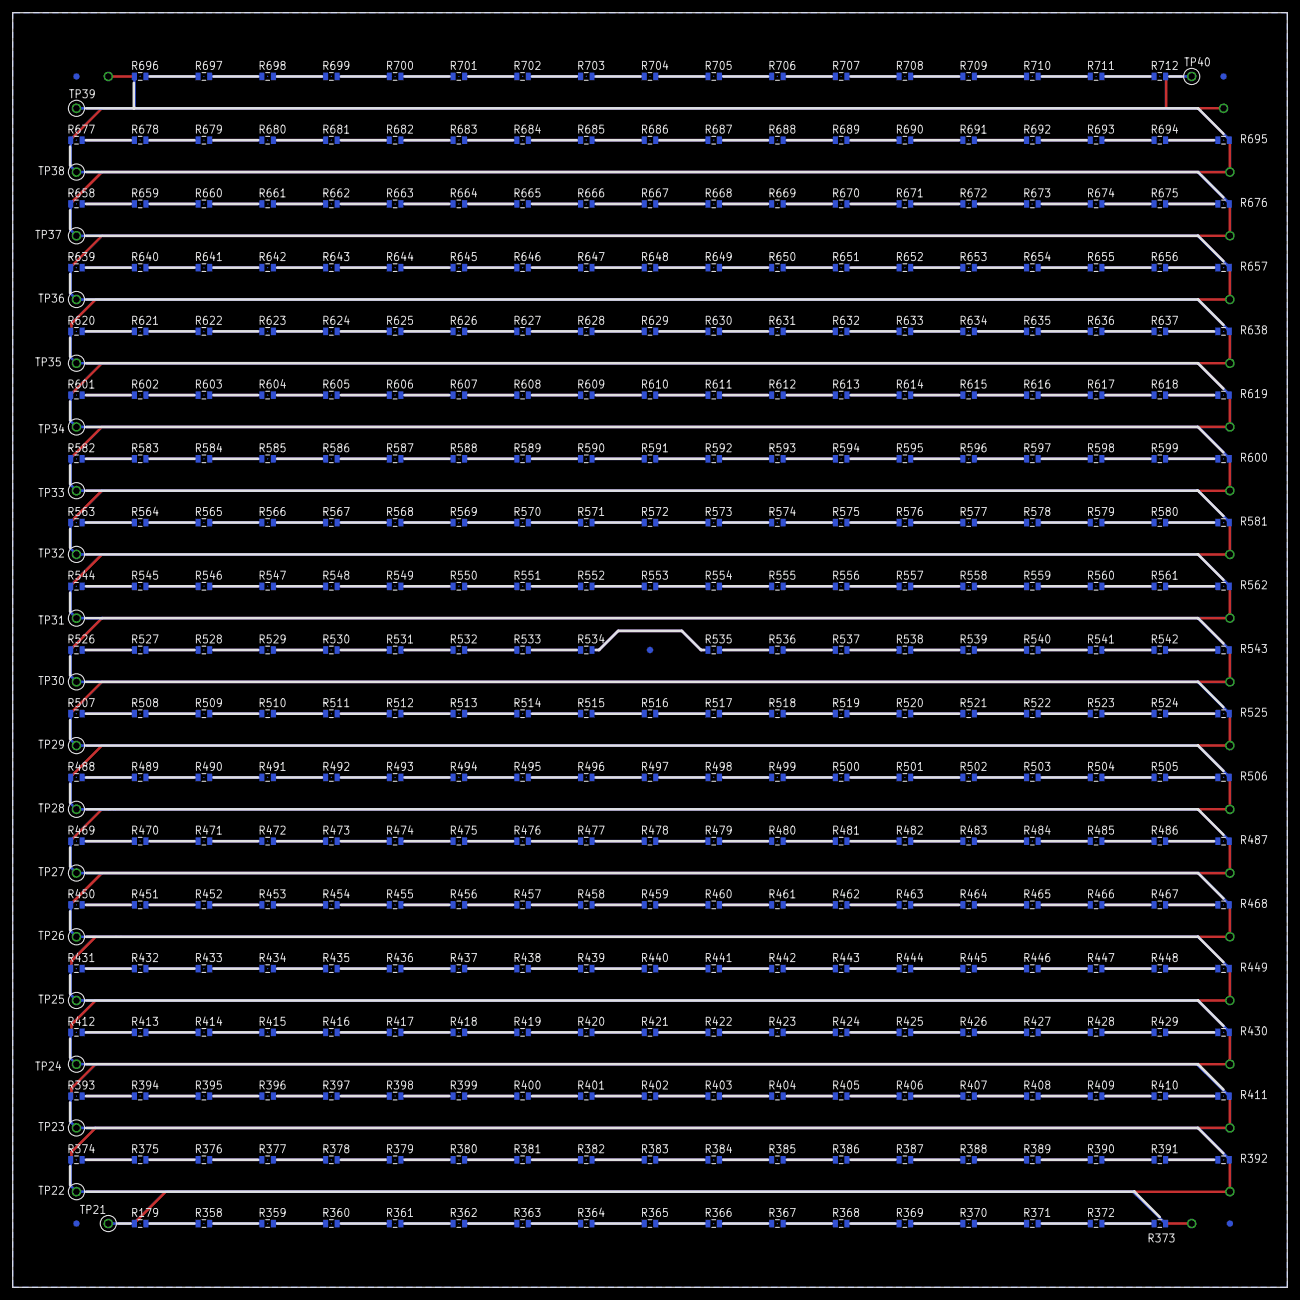
[picture p59: board ETEST01.brd from below]

Board: 2 copper layers, 200.0 x 200.0 mm, 762 parts (381 on the bottom side), 714 nets.
