firepick-delta/fpd-electronics/(commit log)

2015-08-06 Connected device CPL-MDR-2PHSTEPPER (Trinamic TMC2130), and Introduced SMT footprint 0603
2015-08-06 Copied over symbols and devices from other repos
2015-08-07 Created Device for SDRAM and imported all packages from FPD-temp library
2015-08-07 Created devices for the STM429 microchip and the L3GD20 gyroscope
2015-08-10 Added devices needed to TMC2130 stepper motor board (C5, C6, C9)
2015-08-10 Completed all devices for various capacitors on Trinamics motion board.
2015-08-10 Completed more devices for Trinamic driver PCB. Polar capacitors and voltage suppressor diode included.
2015-08-12 Initial schematic capture of EBR01
    [EBR01.brd, EBR01.sch]
2015-08-12 Completed current-sense resistors, made some corrections to pvs packages.
2015-08-12 Completed 10 new resistors for the TMC2130, a 3-pin header, and an SOT-23 diode.
2015-08-14 Have begun replacing placeholder components with TWT Library components. Cleaning up schematic in preparation for layout.
    [EBR01.brd, EBR01.sch]
2015-08-14 Updated footprints, cleaned up some of the dimensions which were on the wrong layer (tPlace). They're now on tDocu so they don't show up on the board.
2015-08-16 Updated library to include the last several parts needed for EBR01 breakout board.
2015-08-16 Updated all components to reflect accurate devices. Smashed most of the parts that required it. The only remaining issues with the schematic are the external voltage regulator and a couple unconnecte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
    [EBR01.brd, EBR01.sch]
2015-08-18 Schematic tentative finalized.
    [EBR01_1.brd, EBR01_1.sch]
2015-08-18 Camera module connector for ECAM01 Schematic/Layout
2015-08-18 Added parts necessary for ECAM01 board
2015-08-18 New test board for FPD accuracy testing
    [ETEST01.brd, ETEST01.sch]
2015-08-18 Added incomplete schematic capture for ECAM01 board
    [ECAM01.sch]
2015-08-19 Corrected connections on the RAM and the DCMI connectors, as well as the oscillator and the J1 Connector. Added TP1-TP2, and added a bus for the RAM connections to decrease clutter.
    [ECAM01.sch]
2015-08-19 Acquired some necessary devices for completing ECAM01 board
2015-08-22 Breakout board layout
    [EBR01_1.brd, EBR01_1.sch]
2015-08-23 Version 1 of ETEST01, these were the production files sent to fab, received 8/23/2015
    [ETEST01.GBL, ETEST01.GBO, ETEST01.GBP, ETEST01.GBS, ETEST01.GTL, ETEST01.GTO, ETEST01.GTP, ETEST01.GTS]
2015-08-24 Routing done.
    [EBR01_1.brd]
2015-08-24 Added rev with bus for RAM, simplifies schematic.
    [ECAM01_1.sch]
2015-08-24 Adding library parts for EBR01, updating schematic
    [ECAM01_1.sch]
2015-08-24 Schematic updates, added parts to library for EBR01
    [ECAM01_1.sch]
2015-08-25 Added all necessary library parts for Ethernet circuit, USART1, USART2. Finished schematic capture of Ethernet circuit, USART1, USART2.
    [ECAM01_1.sch]
2015-08-26 DXF's of ECAM schematics
    [ECAM01_1_P2.dxf]
2015-08-26 Trace widths for motor lines increased to handle 2A current. Eliminated/approved all DRC errors except those for Q1, which remain for review by Neil. Refined DRC check to reflect manufacturing specs 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
    [EBR01_1.brd, ECAM01_1.sch]
2015-08-26 I think I just got the fiducial high-score
    [ETEST02.brd, ETEST02.sch]
2015-08-27 Attempted to remove air wires. Flipped R2 to eliminate vias on sense line. Re-routed wires on ground plane and power plane.
    [EBR01_1.brd, EBR01_1.sch]
2015-08-27 Added parts to library for USB_OTG connection.
    [ECAM01_1.sch]
2015-08-27 Added USB connection to ECAM01 board, relevant devices.
    [ECAM01_1.sch]
2015-08-27 Corrected all (118) DRC errors for EBR01 board. Thickened traces for R2 GND connection, added extra vias to improve grounding, rerouted N$3 trace running directly under GND pad so more vias could be 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
    [EBR01_1.brd, EBR01_1.sch]
2015-08-27 Added vias to R1 GND connection, made all traces to GND wider. Moved board up so that Y=0 lines up with the bottom of the board and fixed Y dimension to reflect true height. Overall cleanup of vias a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
    [EBR01_1.brd, EBR01_1.sch]
2015-08-28 Fixed error: line 13607: invalid value '' for attribute 'name' in tag <net>
    [ECAM01_1.sch]
2015-08-28 Created parts for EMC03, began schematic for EMC03. Symbol for NXP microchip in preliminary format.
    [ECAM01_1.sch, EMC03-Motion Control.sch]
2015-08-31 Added parts for USB, MicroSD, and SWD connections, imported all into schematic for EMC03 board, named and labeled all relevant connections.
    [EMC03-Motion Control.sch]
2015-09-01 Tweaked routing and placement on board. This is the version that will be submitted to the board house. Exported GERBERs and checked them in.
    [EBR01_1.GBL, EBR01_1.GBO, EBR01_1.GBP, EBR01_1.GBS, EBR01_1.GTL, EBR01_1.GTO, EBR01_1.GTP, EBR01_1.GTS]
2015-09-01 just kidding, this is the final version. Added a chamfer to one of the corners that might interfere on the Y axis
    [EBR01_1.GBL, EBR01_1.GBO, EBR01_1.GBP, EBR01_1.GBS, EBR01_1.GTL, EBR01_1.GTO, EBR01_1.GTP, EBR01_1.GTS]
2015-09-01 Added RS-485 chip, connected ethernet, SD, USB to processor. Connected power net to processor.
    [EMC03-Motion Control.sch]
2015-09-02 Updated schematic to include UART0, UART1, MicroSD, SWD, RS-485.
    [EBR01_1.sch, EMC03-Motion Control.sch]
2015-09-03 Fixed connections for RS-485, added resistors for fail-safe mode and termination. Created RJ-45 device for RS-485 connection. Added LED device and placed on schematic 7 LEDs (4 green, 3 red). Created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
    [EMC03-Motion Control.sch]
2015-09-03 Schematic has been updated to assist with sourcing, cleaned up Refdes'.
    [EMC03-Motion Control.sch]
2015-09-07 Began integration into EMC02 legacy schematic. Unnecessary components removed from EMC02. MCU, peripherals added to the EMC02 schematic. Schematic renamed EMC03-Motion Control. LEDs added, switching 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
    [EMC02-Chopped.brd, EMC02-Chopped.sch, EMC03-MCU.brd, EMC03-MCU.sch, EMC03-Motion Control.brd]
2015-09-07 Clock for +60 Demo
    [ECLOCK01.GBL, ECLOCK01.GBO, ECLOCK01.GBP, ECLOCK01.GBS, ECLOCK01.GTL, ECLOCK01.GTO, ECLOCK01.GTP, ECLOCK01.GTS]
2015-09-08 FInal version of clock PCB before sending to board house
    [ECLOCK01.GBL, ECLOCK01.GBO, ECLOCK01.GBP, ECLOCK01.GBS, ECLOCK01.GTL, ECLOCK01.GTO, ECLOCK01.GTP, ECLOCK01.GTS]
2015-09-08 Generating gerbers with pos. offset enabled for board house. Leaving solder mask layers with pos. offset disabled for openpnp compatibility
    [ECLOCK01.GBL, ECLOCK01.GBO, ECLOCK01.GBP, ECLOCK01.GTL, ECLOCK01.GTO, ECLOCK01.GTP]
2015-09-08 fixing, checked into wrong dir
    [ECLOCK01.GBL, ECLOCK01.GBO, ECLOCK01.GBP, ECLOCK01.GTL, ECLOCK01.GTO, ECLOCK01.GTP]
2015-09-08 ZIP as sent to board house
2015-09-08 Added two pushbuttons and a connector for the horn
    [ECLOCK01.brd, ECLOCK01.sch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]
2015-09-08 Got call from board house, forgot solder mask in GERBER ZIP. Updating ZIP with aforementioned soldermask layers.
2015-09-08 Updated corners a bit, in order to squeeze in a few more fiducials. Exported to GERBER. Sent to board house.
    [ETEST02.GBL, ETEST02.GBO, ETEST02.GBP, ETEST02.GBS, ETEST02.GTL, ETEST02.GTO, ETEST02.GTP, ETEST02.GTS]
2015-09-09 Integrated motor drivers into the EMC03 schematic, E-checked the EBR01 board with the netlist. Began similarifying things cromulently.
    [EBR01_1.sch, EMC03-Motion Control.brd, EMC03-Motion Control.sch]
2015-09-11 Integrated the MCU into the EMC02 schematic. The EMC03 schematic is accompanied by a BOM and pinout for the LPC1768. The pinout does not yet reflect the changes of 9/11/15, but all the major connecti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
    [EMC03-BOMEAGLE (C-Sorted).xls, EMC03-BOMEAGLE.csv, EMC03-Motion Control.brd, EMC03-Motion Control.sch]
2015-09-14 Adding BOM generation script (bom-ex.ulp) and partsdb.txt that was used for the boards using in the beta test production run.
    [MicroRC-C.brd, MicroRC-C.sch, MicroRC-C_BOM.csv, MicroRC-C_ListByParts.csv, MicroRC-C_ListByValues.csv, MicroRC-C_OrderUploadDigiKey.csv, MicroRC-ImportPartNumbers.xls, MicroRC-PARTSDB.xls]
2015-09-14 Added a BOM for EMC03, created a checklist for PCB mfr, finalized schematic (rearranged refdes', fixed missing values, etc.)
    [EMC03-BOM.xls, EMC03-BOMEAGLE (C-Sorted).xls, EMC03-Motion Control.brd, EMC03-Motion Control.sch]
2015-09-14 Modified the BOM to reflect connector, resonator changes. All component parts for EBR01 and their equivalents on EMC03 were ordered and the BOMs were updated to reflect this. The database for the new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
    [EBR01 PCB Bill of Materials.xls, EBR01_1.sch, EMC03-BOM.xls, EMC03-BOMEAGLE.csv, EMC03-Motion Control.brd, EMC03-Motion Control.sch, EMC03-Motion Control_OrderUploadDigiKey.csv, bom-ex.cfg]
2015-09-15 Updated BOM, Database, Schematic for final parts
    [EMC03-BOM.xls, EMC03-Motion Control.brd, EMC03-Motion Control.sch, bom-ex.cfg]
2015-09-15 Fixing whitespace issues in partsdb.txt so that BOM generator doesn't freak out
    [bom-ex.cfg]
2015-09-15 EMC03: Updated schematic, BOM, database, and parts library to include all revisions. This includes schematic capture for interfaces (endstops, motors, encoders, RS-485 interface, modular tools 1 and 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
    [EMC03-BOM.xls, EMC03-Motion Control.brd, EMC03-Motion Control.sch, bom-ex.cfg]
2015-09-16 Resized EMC03 board, 50mm per side. All connector 3D models have been imported for design in Cubify. Database has been updated to include E-stop connector (corrected). Connectors have been added to b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
    [EMC03-BOM.xls, EMC03-Motion Control - PACKD2GILLS.brd, EMC03-Motion Control.sch]
2015-09-18 Arranged EMC03 board as much as possible. Updated PCB Checklist with testpoint data. Updated test points to pads, as per schematic instructions.
    [EFD01 - C. Feeder.sch, EMC03-Motion Control.brd, EMC03-Motion Control.sch]
2015-09-28 Updated schematic to integrate Intel Edison into EMC03 (USB chip for serial console, USB hub for all peripherals and associated EEPROM, second RS-485 transceiver for Edison). USB-B connection has bee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
    [EFD01 - C. Feeder.sch, EMC03-Motion Control.brd, EMC03-Motion Control.sch]
2015-09-30 Updated schematic to incorporate tweaks proposed by Neil. Generated new and complete BOM, updated parts database.
    [EMC03-BOM.xls, EMC03-BOM_1.xls, EMC03-Motion Control.brd, EMC03-Motion Control.sch]
2015-10-03 Preliminary final draft for EMC03, ECAM02, and EFD01 boards.
    [ECAM02-EE2.0.sch, EFD01 - C. Feeder.brd, EFD01 - C. Feeder_BOM.xls, EMC03-BOM.xls, EMC03-Motion Control.brd, EMC03-Motion Control.sch]
2015-10-03 Created preliminary final schematic for ECA03
    [ECAM02-EE2.0.brd, ECAM03.sch, EFD01 - C. Feeder.sch]
2015-10-04 Component placement begun
    [ECAM02-EE2.0.sch, ECAM03.brd, ECAM03.sch, EMC03-Motion Control.brd, EMC03-Motion Control.sch]
2015-10-04 Preliminary placement and routing done for EFD01. Preliminary placement done for EMC03. All schematics are ready for review (A0 for ECAM03 needs to be defined, also SS for EFD01, ECAM03, etc.)
    [EFD01 - C. Feeder.brd, EFD01 - C. Feeder.sch, EMC03-Motion Control.brd, EMC03-Motion Control.sch]
2015-10-05 Split the EMC03 into EMC03 and EFP01 (front panel board) to make routing 10000000x easier
    [EFP01 - Front Panel Board.brd, EFP01 - Front Panel Board.sch, EMC03-Motion Control.brd, EMC03-Motion Control.sch]
2015-10-05 Finalized schematics (minus potential LDO regulator) for all boards. Layout partially done for EFD01
    [ECAM02-EE2.0.brd, ECAM02-EE2.0.sch, ECAM03.brd, ECAM03.sch, EFD01 - C. Feeder.brd, EFD01 - C. Feeder.sch, EFP01 - Front Panel Board.brd, EFP01 - Front Panel Board.sch]
2015-10-05 Replaced switching regulator with a smaller LDO, with smaller accompanying components. Preliminary component placement for EMC03. Partial routing of power nets.
    [EMC03-Motion Control.brd, EMC03-Motion Control.sch]
2015-10-06 All parts placed for EMC03, X Axis routed.
    [EBR01_1.brd, EMC03-Motion Control.brd, EMC03-Motion Control.sch]
2015-10-06 Routed EFD01, ECAM03 boards. Modification needs to be made for hole/keepout in ECAM03. EMC03 X and Y sides routed. Will need to increase some trace widths.
    [ECAM02-EE2.0.brd, ECAM03.brd, ECAM03.sch, EFD01 - C. Feeder.brd, EFD01 - C. Feeder.sch, EMC03-Motion Control.brd]
2015-10-06 Routing completed for EMC03, need to clean DRC, format. Routing completed for ECAM03.
    [EMC03-Motion Control.brd, EMC03-Motion Control.sch]
2015-10-07 Routed all boards. EFP01 has a serious problem with spacing. Even on minimum allowable there are 300 DRC errors.
    [ECAM02-EE2.0.brd, ECAM02-EE2.0.sch, EFP01 - Front Panel Board.brd, EFP01 - Front Panel Board.sch]
2015-10-09 Completed boards. Please look at airwires connecting thermal pads to GND vias. They shouldn't be present due to the vias.
    [ECAM02-EE2.0.brd, ECAM02-EE2.0.sch, ECAM03.brd, EFD01 - C. Feeder.brd, EFP01 - Front Panel Board.brd, EFP01 - Front Panel Board.sch, EMC03-Motion Control.brd, EMC03-Motion Control.sch]
2015-10-11 Updated all boards to include changes for production
    [ECAM02-EE2.0.brd, ECAM02-EE2.0.sch, ECAM03.brd, ECAM03.sch, EFD01 - C. Feeder.brd, EFD01 - C. Feeder.sch, EFP01 - Front Panel Board.brd, EFP01 - Front Panel Board.sch]
2015-10-11 Added +3V3 line for LCD, DXF for Will
    [ECAM02-EE2.0.dxf, EFP01 - Front Panel Board.brd, EFP01 - Front Panel Board.sch]
2015-10-11 Updated motor hole size to 7mm Dia. Rerouted around.
    [ECAM02-EE2.0.brd, EMC03-Motion Control.brd]
2015-10-11 Updated DXF for 7mm motor hole
2015-10-11 Made an LED board for the end effector 2.0. It is intended to be mounted above the 5MP ELP USB camera, and driven by the AP3032 LED controller that is on the ECAM02 board.
    [ELED03.brd, ELED03.sch]
2015-10-12 Added a ring light for the up-looking camera board
    [ELED04.brd, ELED04.sch]
2015-10-12 Partially-routed diff pairs
    [ECAM02-EE2.0.brd, ECAM02-EE2.0.sch, ECAM03.brd, ECAM03.sch, EFP01 - Front Panel Board.brd, EFP01 - Front Panel Board.sch]
2015-10-12 On the two ring light boards, I changed the LEDs from 1206 package to 1210 in order to accomodate a brighter LED.
    [ELED03.brd, ELED03.sch, ELED04.brd, ELED04.sch]
2015-10-12 Added frames, logos, part numbers, and fiducials
    [ELED03.brd, ELED03.sch, ELED04.brd, ELED04.sch]
2015-10-12 Replaced fiducials with newer fiducials that have keepouts / restrict layers
    [ELED04.brd, ELED04.sch]
2015-10-12 Final(??) Versions of FPD boards.
    [ECAM02-EE2.0.brd, ECAM03.brd, ECAM03.sch, EFD01 - C. Feeder.brd, EFD01 - C. Feeder.sch, EFP01 - Front Panel Board.brd, EFP01 - Front Panel Board.sch, EMC03-Motion Control.brd]
2015-10-12 Created BOM for EMC03
    [EMC03-BOM.xls, EMC03-Motion Control.brd, EMC03-Motion Control.sch]
2015-10-12 Created BOM for EFP01
    [EFP01 - Front Panel Board.brd, EFP01 - Front Panel Board.sch, EFP01 - Front Panel Board_BOM.xls]
2015-10-12 Re-jiggered switching power supply for LED controller. Re-routed and whatnot. Generated GERBERs for REV--
    [ECAM02-EE2.0.brd, ECAM02-EE2.0.sch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]
2015-10-12 Re-jiggered switching power for LED controller, rerouted and whatnot. Added trace for WS2812B. Swapped DAC wire (A0 was going to the LED driver instead of analog out). Generated GERBERs for Rev--.
    [ECAM03.GBL, ECAM03.GBO, ECAM03.GBP, ECAM03.GBS, ECAM03.GTL, ECAM03.GTO, ECAM03.GTP, ECAM03.GTS]
2015-10-12 Added a 1206 10 ohm resistor (1/4W)
2015-10-12 Beefed up a few trace widths (~0.1524mm to 0.5mm) in key areas that will have high amounts of current passing through them. This will generate a merge conflict with Dan's last push, I will attempt a 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
    [EMC03-Motion Control.brd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]
2015-10-12 Made some simple adjustments (moved traces, increased width on current carrying components). Added P/N and TW logo. Generated gerbers for Rev--.
    [EFD01 - C. Feeder.GBL, EFD01 - C. Feeder.GBO, EFD01 - C. Feeder.GBP, EFD01 - C. Feeder.GBS, EFD01 - C. Feeder.GTL, EFD01 - C. Feeder.GTO, EFD01 - C. Feeder.GTP, EFD01 - C. Feeder.GTS]
2015-10-12 Minor changes to EFP01. One show-stopper DRC error (overlapping traces). Added logo and P/N. Other misc. tweaks. Generated Gerbers for Rev--.
    [EFP01 - Front Panel Board.GBL, EFP01 - Front Panel Board.GBO, EFP01 - Front Panel Board.GBP, EFP01 - Front Panel Board.GBS, EFP01 - Front Panel Board.GTL, EFP01 - Front Panel Board.GTO, EFP01 - Front Panel Board.GTP, EFP01 - Front Panel Board.GTS]
2015-10-12 Generated GERBERs for Rev--
    [ELED03.GBL, ELED03.GBO, ELED03.GBP, ELED03.GBS, ELED03.GTL, ELED03.GTO, ELED03.GTP, ELED03.GTS]
2015-10-12 Added gerbers for Rev--
    [ELED04.GBL, ELED04.GBO, ELED04.GBP, ELED04.GBS, ELED04.GTL, ELED04.GTO, ELED04.GTP, ELED04.GTS]
2015-10-13 BOMs complete for all FPD boards
    [ECAM02-EE2.0.brd, ECAM02-EE2.0.sch, ECAM02-EE2.0_BOM.xls, ECAM03.brd, ECAM03.sch, ECAM03_BOM.xls, EFD01 - C. Feeder.brd, EFD01 - C. Feeder.sch]
2015-10-15 BOMs finished, inventory sheet created.
    [ECAM02-EE2.0.brd, ECAM02-EE2.0.sch, ECAM03.brd, ECAM03.sch, EFD01 - C. Feeder.brd, EFD01 - C. Feeder.sch, EFP01 - Front Panel Board.brd, EFP01 - Front Panel Board.sch]
2015-10-16 Updated some of the attributes on schematics which contained incorrect part numbers. Similarly adjusted BOMs and inventory/PO form to reflect these changes.
    [ECAM02-EE2.0.brd, ECAM02-EE2.0.sch, ECAM02-EE2.0_BOM.xls, ECAM03_BOM.xls, EFD01 - C. Feeder.brd, EFD01 - C. Feeder.sch, EFD01 - C. Feeder_BOM.xls, EFP01 - Front Panel Board.brd]
2015-10-16 Added 7-Pin Connectors, highlighted changes in blue
    [Inventory(Electronics).xls]
2015-10-16 Sorted BOMs by ref des. Changed qty on PHR-7
    [ECAM02-EE2.0_BOM.xls, ECAM03_BOM.xls, EFD01 - C. Feeder_BOM.xls, EFP01 - Front Panel Board_BOM.xls, EMC03-BOM.xls, Inventory(Electronics).xls]
2015-10-16 Added qty 2 B7B-PH-SM4-TB(LF)(SN)
    [Inventory(Electronics).xls]
2015-10-16 Created Cable Assembly BOM.
    [Cable Assembly BOM.xls, ELED04.brd, Inventory(Electronics).xls]
2015-10-16 Created ESOL01 Schematic and Board. Added parts to DB, added parts to inventory.
    [ELED03.brd, ELED03.sch, ELED04.brd, ELED04.sch, ESOL01 - Sol + Pump.brd, ESOL01 - Sol + Pump.sch, Inventory(Electronics).xls]
2015-10-17 Changing resistor tolerances to 1%
    [EFP01 - Front Panel Board.brd, EFP01 - Front Panel Board.sch]
2015-10-17 Tweaks to boards, mostly moving silkscreen reference designators and TDOCU/BDOCU stuff. In a few cases, the reference designators for bottom parts were on the TDOCU layer instead of the BDOCU layer. 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
    [ECAM02-EE2.0.brd, ECAM03.brd, EFD01 - C. Feeder.brd, EFP01 - Front Panel Board.brd, ELED03_BOM.xls, ELED04_BOM.xls]
2015-10-17 Added trestrict layers on three mounting holes
    [ECAM02-EE2.0.brd, ECAM02-EE2.0.sch]
2015-10-18 Routed ESOL01, created MTHOLE(M3) part for future use
    [ESOL01 - Sol + Pump.brd, ESOL01 - Sol + Pump.sch]
2015-10-18 Fixed ESOL01 for mechanical restrictions
    [ESOL01 - Sol + Pump.brd]
2015-10-19 DXF'ed ESOL01, Updated Inventory/Order Form, Cable Assy BOM completed
    [Cable Assembly BOM.xls, ESOL01 - Sol + Pump.dxf, Inventory(Electronics).xls]
2015-10-19 Fixed BOM, began adding DFM changes
    [ECAM02-EE2.0.brd, ECAM02-EE2.0.sch, ECAM02-EE2.0_BOM.xls, ECAM03.brd, EFD01 - C. Feeder.brd, EFD01 - C. Feeder.dxf, EFP01 - Front Panel Board.brd, EFP01 - Front Panel Board.sch]
2015-10-19 Added decoupling caps to EFD01, ECAM02, rearranged parts for better fit, increased power trace width, updated BOM and database.
    [ECAM02-EE2.0_BOM.xls, ECAM03.brd, ECAM03.sch, EFD01 - C. Feeder.brd, EFD01 - C. Feeder.sch, EFD01 - C. Feeder_BOM.xls]
2015-10-20 Made REV 2 modifications, including increasing width of power traces, adding vias to power traces, and addition of LEDs to all modular tools. Catch diodes added to ESOL01 board to prevent coils from 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
    [ECAM02-EE2.0.brd, ECAM02-EE2.0.sch, ECAM02-EE2.0_BOM.xls, ECAM03.brd, ECAM03.sch, ECAM03_BOM.xls, EFD01 - C. Feeder.brd, EFD01 - C. Feeder.sch]
2015-10-21 Routing for differential pairs included in EFP01. Minor changes to BOM, inventory list.
    [EFP01 - Front Panel Board.brd, EFP01 - Front Panel Board.sch, EFP01 - Front Panel Board_BOM.xls, Inventory(Electronics).xls]
2015-10-21 Resistance check, minor changes to EFP01 BOM (100 Ohm changed to 120 Ohm)
    [ECAM02-EE2.0_BOM.xls, ECAM03.brd, ECAM03_BOM.xls, EFD01 - C. Feeder_BOM.xls, EFP01 - Front Panel Board.brd, EFP01 - Front Panel Board_BOM.xls, EMC03-BOM.xls]
2015-10-22 No changes except re-DXF'd ESOL01
    [ESOL01 - Sol + Pump.dxf]
2015-10-23 Fixed electrolytic cap reversals on ECAM02
    [ECAM02-EE2.0.brd, ECAM02-EE2.0.sch]
