firepick-delta/fpd-electronics/(notices)

Notices in the files:
EAGLE/EMC03 - Motion Control/EMC03-Motion Control - PACKD2GILLS.brd:
CC-BY-SA 4.0 license
parts and their libraries:
dicons: Copyright Field
Set copyright by text with global attribute >COMPANY
SparkFun-DiscreteSemi: Licensing: Creative Commons ShareAlike 4.0 International - https://creativecommons.org/licenses/by-sa/4.0
